lecejeff/RPI_CMx_Carrier/README.md

## SPONSOR
[NextPCB](https://www.nextpcb.com)

This project is proudly sponsored by [NextPCB](https://www.nextpcb.com). They have provided, free of charge, 2x assembled PCBA.

If you’re planning to build your own PCB, [NextPCB](https://www.nextpcb.com) offers reliable PCB fabrication and assembly services with fast turnaround times and competitive pricing, making it easier to bring your electronics projects from idea to reality.
