lecejeff/RPI_CMx_Carrier/hardware/DVT/RPI_CMx_Carrier_2.00-0A - DVT.odt

RPI_CM[x]_Carrier – Rev 2.00-0A – DVT report

BY

Jean-François Bilodeau

203-1690 rue des Quatre-saisons, Sherbrooke, CANADA, J1E 0N2

jeanfrancois.bilodeau@hotmail.fr

418-999-8845

APPLICABLE TO

RPI_CM[x]_Carrier – Rev 2.00-0A

Project release date: 2026-03

Setup date for qualification report: 9th of March 2026

Report release date: WIP

Table of Figures

Figure 1: 1V8_CB schematic implementation 4

Figure 2: 1V8_CB - Vout 6

Figure 3: 1V8_CB - Ripple 6

Figure 4: 1V8_CB - Soft start (10-90% output voltage) 6

Figure 5: 1V8_CB - Operating frequency 6

Figure 6: 1V8_CB EN input voltage threshold 8

Figure 7: 1V8_CB EN enable to output ramp-up delay 8

Figure 8: 3V3_CB schematic implementation 11

Figure 9: 3V3_CB - Vout 13

Figure 10: 3V3_CB - Ripple 13

Figure 11: 3V3_CB - Soft start (10-90% output voltage) 13

Figure 12: 3V3_CB - Operating frequency 13

Figure 13: 3V3_CB EN input voltage threshold 15

Figure 14: 3V3_CB EN enable to output ramp-up delay 15

Figure 15: 5V0_CB schematic implementation 18

Figure 16: 5V0_CB - Vout 19

Figure 17: 5V0_CB - Ripple 19

Figure 18: 5V0_CB - Soft start (10-90% output voltage) 20

Figure 19: 5V0_CB - Operating frequency 20

Figure 20: 5V0_CB EN input voltage threshold 22

Figure 21: 5V0_CB EN enable to output ramp-up delay 22

Figure 22: Power Supply sequencing schematic implementation 25

Figure 23: Reset sequence schematic implementation 25

Figure 24: Power-up sequence timing diagram 26

Figure 25: RPI Compute Module power-up requirements 27

Figure 26: 12V0_CB ↑ to 5V0_CB ↑ 29

Figure 27: 5V0_CB ↑ to RPI_PWGn ↓ 29

Figure 28: RPI_PWGn ↓ to CB_LOG_EN ↑ 29

Figure 29: CB_LOG_EN ↑ to 3V3_CB & 1V8_CB ↑ 29

Figure 30: 1V8_CB ↑ to 1V05_CB ↑ 29

Figure 31: 1V05_CB ↑ to PWG ↑ 29

Figure 32: CB_LOG_EN ↑ to EXT_RSTn ↑ 30

Figure 33: Power kill schematic implementation 33

# Power supplies

## 1V8_CB

### Buck qualification TPS54527DDAR

Figure 1: 1V8_CB schematic implementation

#### Reference

HW qualification | Reference | RPI_CM[x]_Carrier design notes
| Applicable for | RPI_CM[x]_Carrier Rev 2.00-0A
Description | | Detailed qualification of TPS54527 buck regulator for 1V8_CB rail
Test type | | Internal | External | Site : Sherbrooke
Test status | | DONE
Final test result | | PASS

General Info
Date begin Date end | 2026-03-09 2026-04-19 | Temperature Humidity | 25°C 50%RH
Realized by | Jean-François Bilodeau, P. Eng #6022173

#### System Information

Hardware | Serial Number | # Version | Mod (#WI) | Comments
Carrier Board | RPI_CM[x]_01 CM4 build variant | 0A | | All applicable work items applied prior to test
SOM | CM4 4GB RAM 8GB eMMC WIFI
Accessory #1 | RVT70HSLFWCA0
Accessory #2 | None

#### Assumptions

Based on design notes for a typical use-case:

- Typical Vout ~= 1.8V ±5%
- Typical Iout <= 0.8A
- Typical ripple ~= 20mVpp
- Typical soft start ~= 1.4025ms ±15%
- Typical transient response ~= 300us ± 20%
- Typical switching frequency ~= 712.5kHz

#### Measurement point

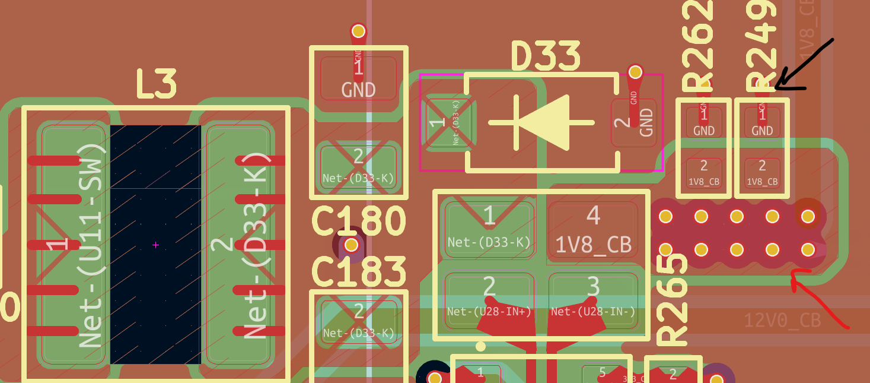
[picture p1: figure]

Measurement location for 1V8_CB Vout / Transient response qualification | Measurement location for 1V8_CB ripple qualification

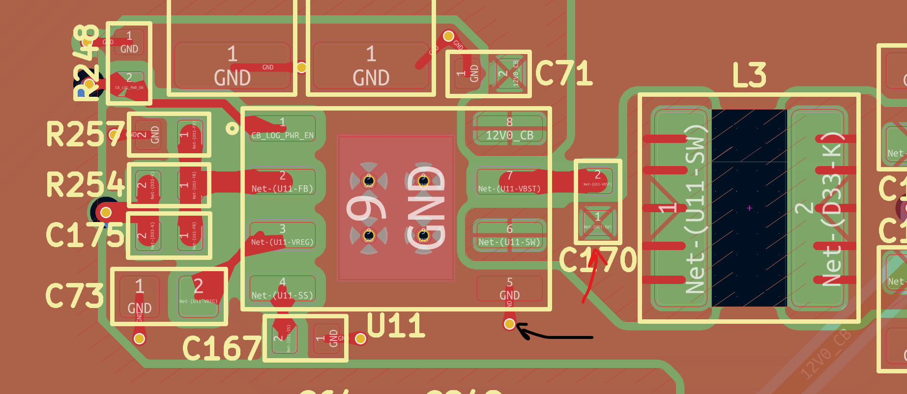
[picture p2: figure]

Measurement location for 1V8_CB soft start qualification | Measurement location for 1V8_CB FSW qualification

#### Test

1V8_CB Buck qualification | Test parameters
| Target | Measurement | Result | Comments
Vout | 1.71V <= 1.8V <= 1.89V | Min 1.767V Nominal 1.802V Max 1.833V | PASS
Ripple | <= 20mVpp | 21mVpp | PASS | Test realized with BW <= 20MHz
Soft start | 1.192 <= 1.4025 <= 1.612ms | 1.321ms | PASS
Operating frequency | ~ 712.5kHz | ~717.96kHz | PASS | Test realized with BW <= 20MHz
Temperature increase vs ambient | <= 35DegC | TO DO | TO DO

1V8_CB buck qualification

#### Figures

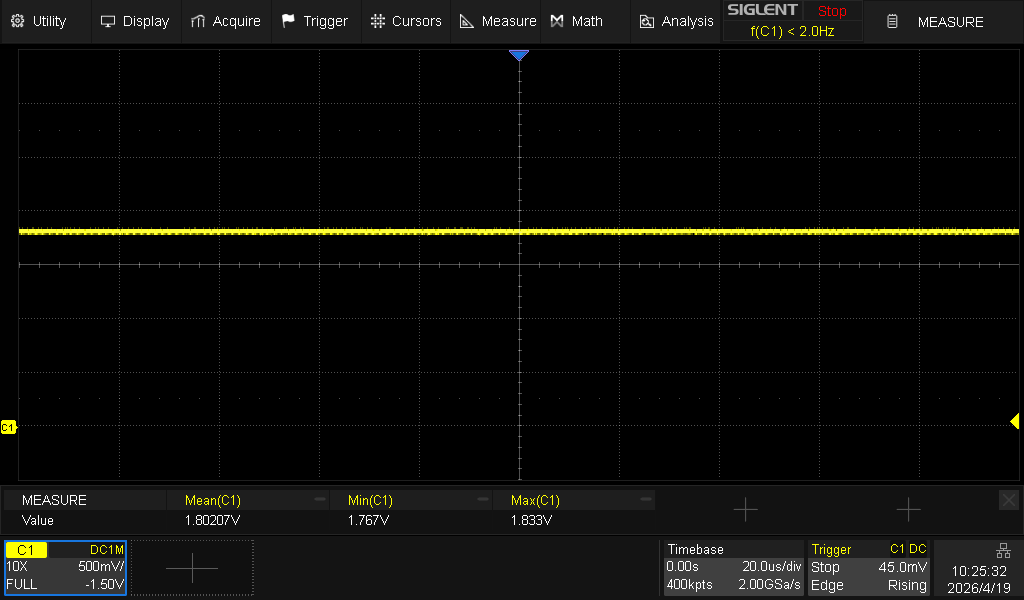
[picture p3: figure]
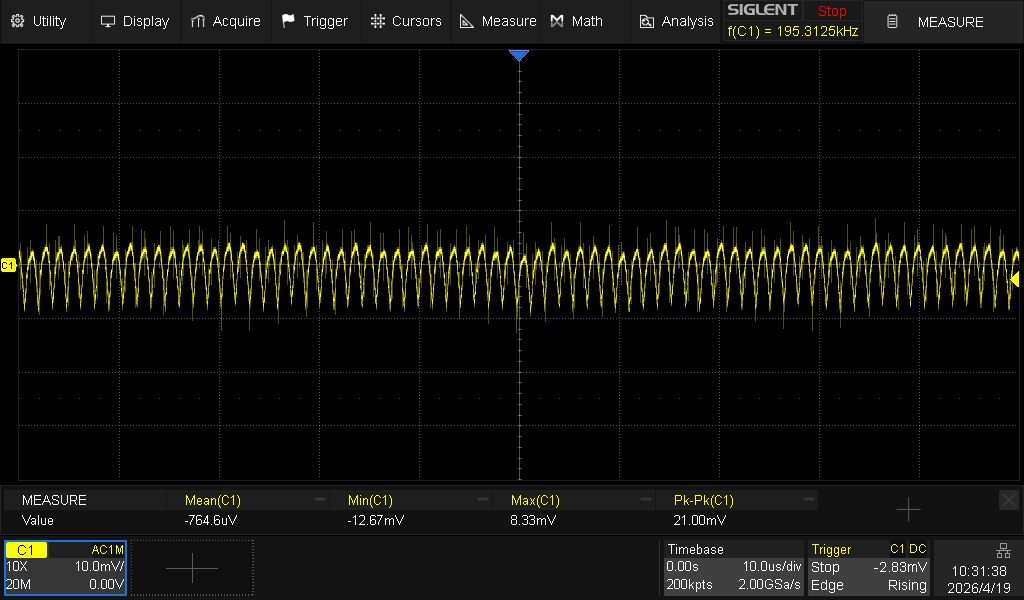
[picture p4: figure]

Figure 2: 1V8_CB - Vout | Figure 3: 1V8_CB - Ripple

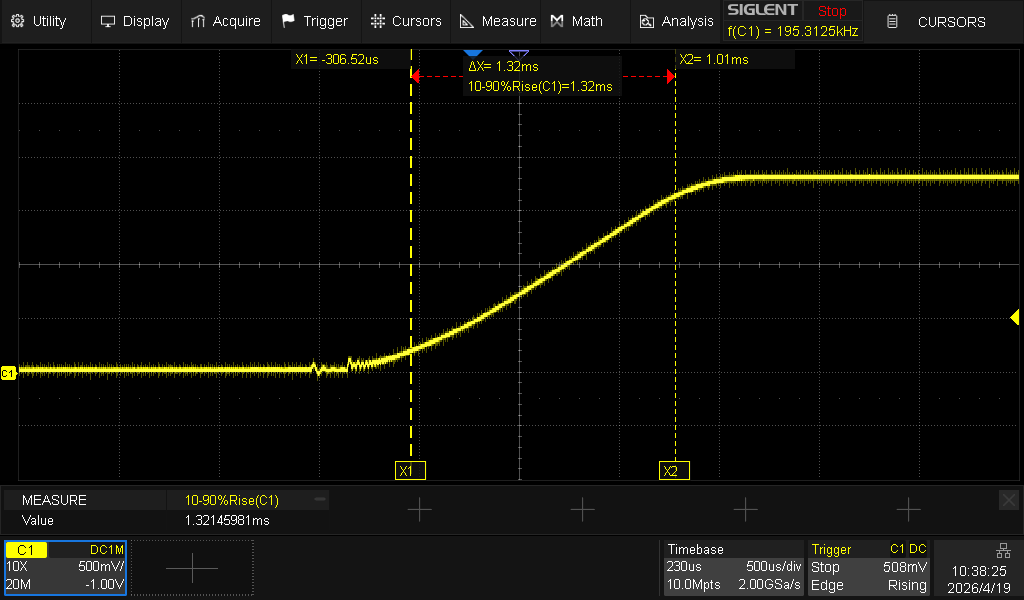
[picture p5: figure]
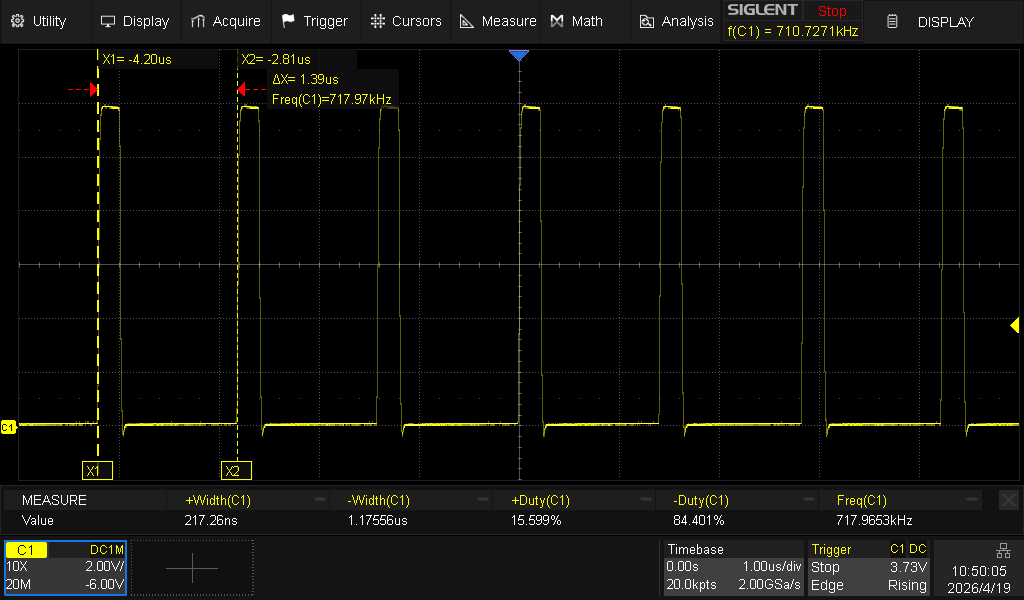
[picture p6: figure]

Figure 4: 1V8_CB - Soft start (10-90% output voltage) | Figure 5: 1V8_CB - Operating frequency
1V8_CB – Temperature increase

#### Conclusion

### Brown-out

#### Reference

HW qualification | Reference | RPI_CM[x]_Carrier design notes
| Applicable for | RPI_CM[x]_Carrier Rev 2.00-0A
Description | | Detailed qualification of TPS54527 brown-out behavior for 1V8_CB rail
Test type | | Internal | External | Site : Sherbrooke
Test status | | In progress
Final test result | | In progress

General Info
Date | 2026-06-14 | Temperature Humidity | 25°C 50%RH
Realized by | Jean-François Bilodeau, P. Eng #6022173

#### System Information

Hardware | Serial Number | # Version | Mod (#WI) | Comments
Carrier Board | RPI_CM[x]_01 CM4 build variant | 0A | | All applicable work items applied prior to test
SOM | CM4 4GB RAM 8GB eMMC WIFI
Accessory #1 | RVT70HSLFWCA0
Accessory #2 | None

#### Assumptions

Must measure minimum input voltage, output voltage ramp-up (Soft start) and inrush current

#### Measurement point

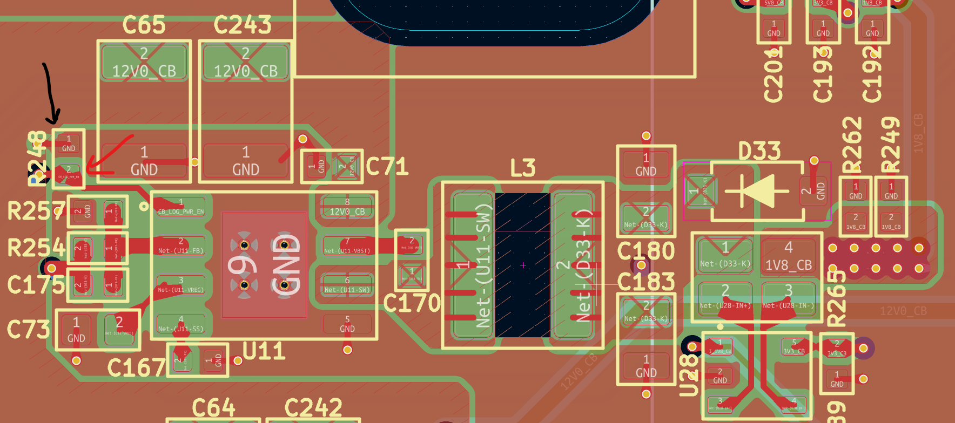
[picture p7: figure]
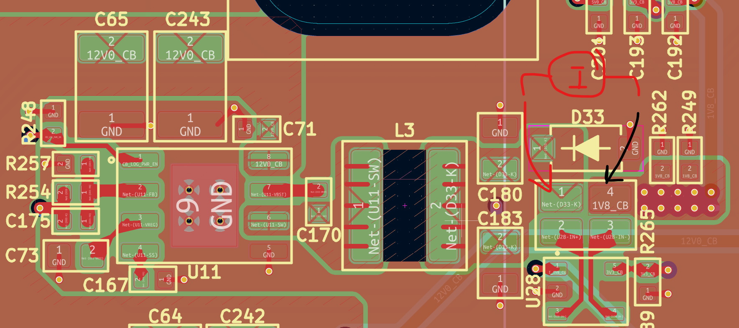
[picture p8: figure]

Measurement location for 1V8_CB EN input validation | Measurement location for 1V8_CB inrush current

#### Test

1V8_CB Brown-out behavior | Test parameters
| Target | Measurement | Result | Comments
EN input voltage “on” threshold | >= 1.6V | 1.77V | PASS
EN input to output ramp-up delay | < 1ms | 0.27ms | PASS
Inrush current | INFO

1V8_CB brown-out behavior

#### Figures

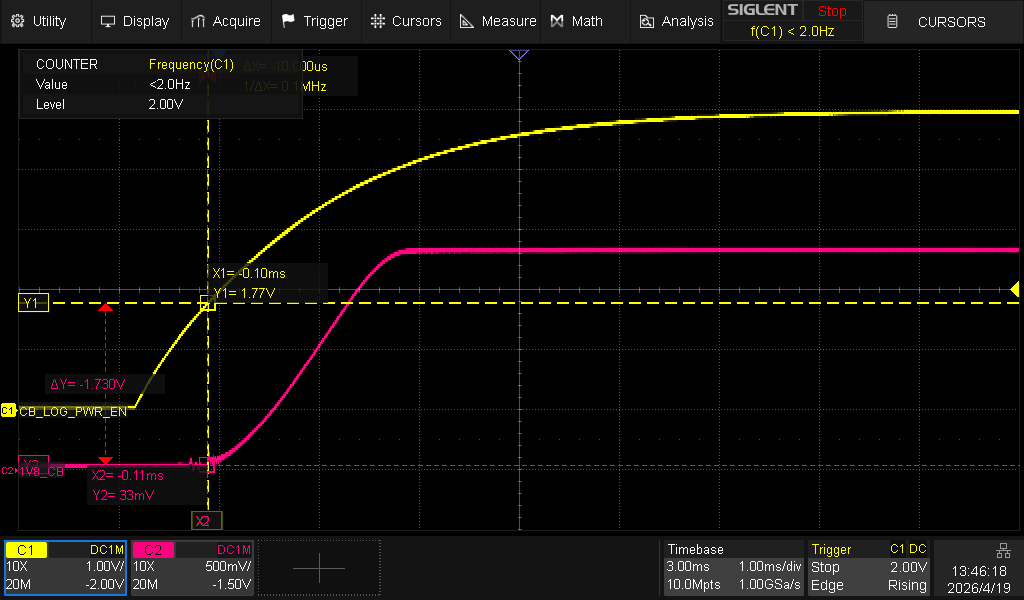
[picture p9: figure]
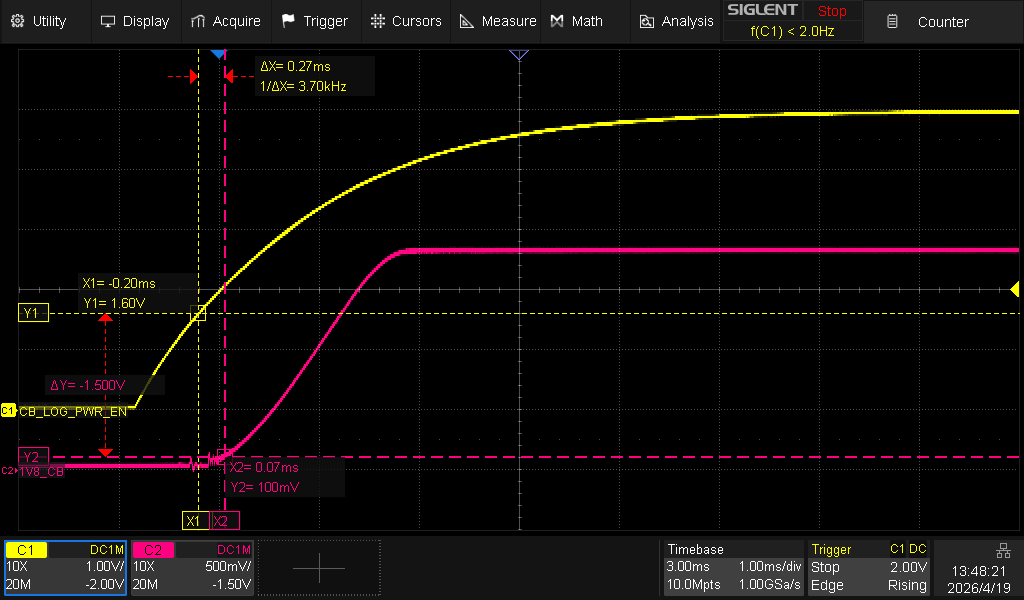
[picture p10: figure]

Figure 6: 1V8_CB EN input voltage threshold | Figure 7: 1V8_CB EN enable to output ramp-up delay
1V8_CB Inrush current

#### Conclusion

### Brown-in

#### Reference

HW qualification | Reference | RPI_CM[x]_Carrier design notes
| Applicable for | RPI_CM[x]_Carrier Rev 2.00-0A
Description | | Detailed qualification of TPS54527 brown-in behavior for 1V8_CB rail
Test type | | Internal | External | Site : Sherbrooke
Test status | | To Do
Final test result | | To Do

General Info
Date | 2026-03-09 | Temperature Humidity | 25°C 50%RH
Realized by | Jean-François Bilodeau, P. Eng #6022173

#### System Information

Hardware | Serial Number | # Version | Mod (#WI) | Comments
Carrier Board | RPI_CM[x]_01 CM4 build variant | 0A | | All applicable work items applied prior to test
SOM | CM4 4GB RAM 8GB eMMC WIFI
Accessory #1 | RVT70HSLFWCA0
Accessory #2 | None

#### Assumption

Must measure input voltage ramp-down, output voltage ramp-down and power good assert

#### Measurement point

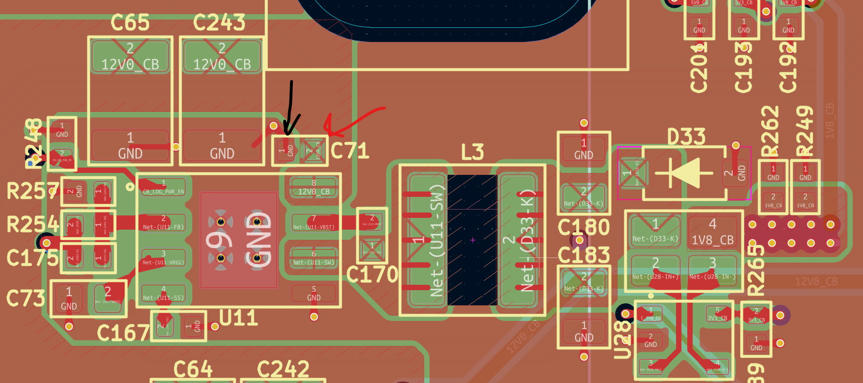
[picture p11: figure]
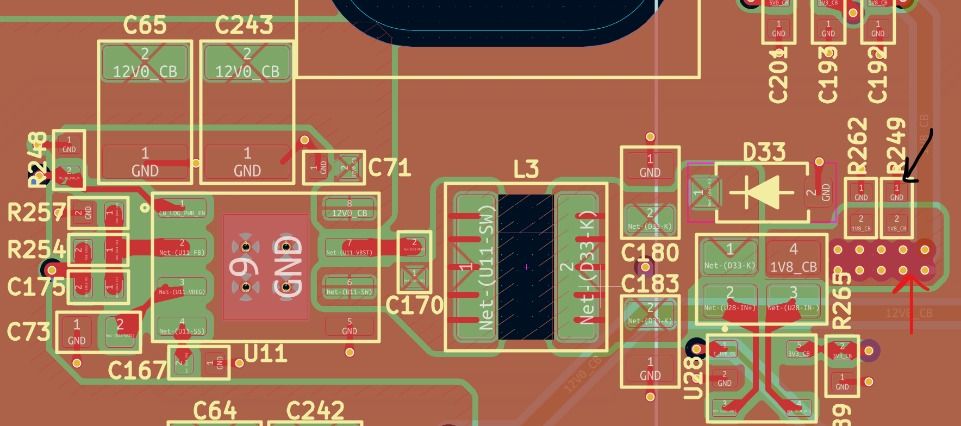
[picture p12: figure]

Measurement location for input voltage ramp-down | Measurement location for output voltage ramp-down

#### Test

1V8_CB Brown-in behavior | Test parameters
| Target | Measurement | Result | Comments
Input voltage brown-in | < 4.5V
Output voltage brown-in discharge | < 10ms

1V8_CB brown-in behavior

#### Figures

1V8_CB Input voltage brown-in threshold | 1V8_CB Output voltage brown-in discharge (100-10%)

#### Conclusion

## 3V3_CB

### Buck qualification TPS54527DDAR

Figure 8: 3V3_CB schematic implementation

#### Reference

HW qualification | Reference | RPI_CM[x]_Carrier design notes
| Applicable for | RPI_CM[x]_Carrier Rev 2.00-0A
Description | | Detailed qualification of TPS54527 buck regulator for 3V3_CB rail
Test type | | Internal | External | Site : Sherbrooke
Test status | | DONE
Final test result | | PASS

General Info
Date | 2026-06-14 | Temperature Humidity | 25°C 50%RH
Realized by | Jean-François Bilodeau, P. Eng #6022173

#### System Information

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

#### Assumptions

Based on design notes for a typical use-case:

- Typical Vout ~= 3.3V ±5%
- Typical Iout <= 3.3A
- Typical ripple ~= 20mVpp
- Typical soft start ~= 1.4025ms ±15%
- Typical switching frequency ~= 740kHz

#### Measurement point

Measurement location for 3V3_CB Vout / Transient response qualification | Measurement location for 3V3_CB ripple qualification

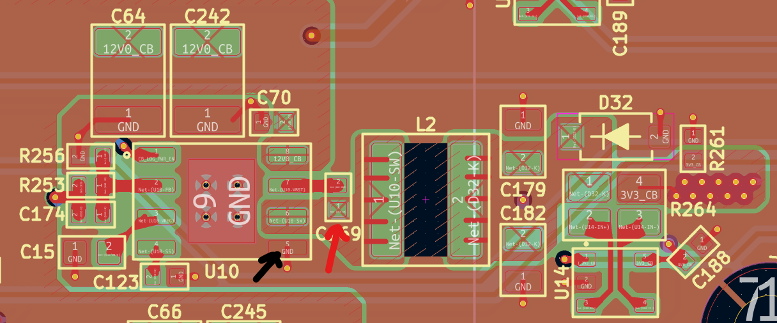
[picture p13: figure]

Measurement location for 3V3_CB soft start qualification | Measurement location for 3V3_CB FSW qualification

#### Test

3V3_CB Buck qualification | Test parameters
| Target | Measurement | Result | Comments
Vout | 3.135V <= 3.3V <= 3.465V | Min 3.250V Nominal 3.290V Max 3.317V | PASS
Ripple | <= 20mVpp | 26.67mVpp | PASS
Soft start | 1.192ms <= 1.4025ms <= 1.612ms | 1.252ms | PASS
Operating frequency | ~ 740kHz | 721.2kHz | PASS
Temperature increase vs ambient | <= 35DegC | TO DO | TO DO

3V3_CB buck qualification

#### Figures

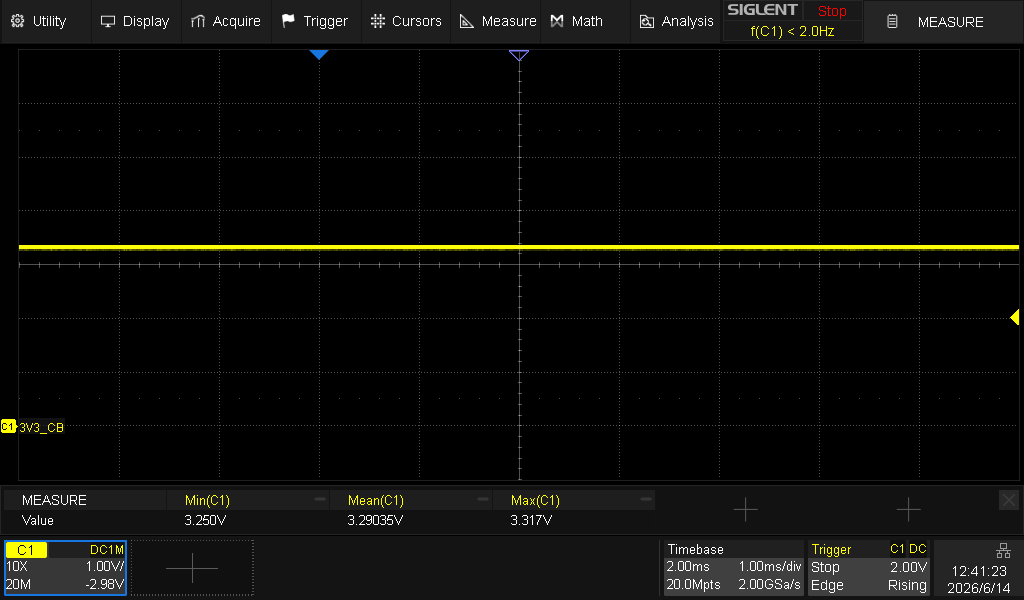
[picture p14: figure]
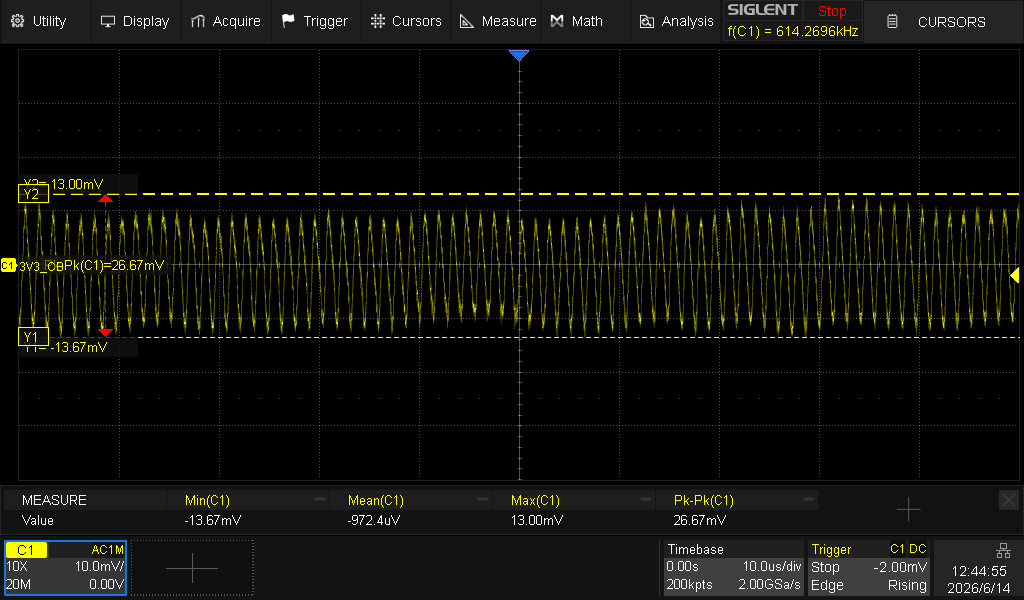
[picture p15: figure]

Figure 9: 3V3_CB - Vout | Figure 10: 3V3_CB - Ripple

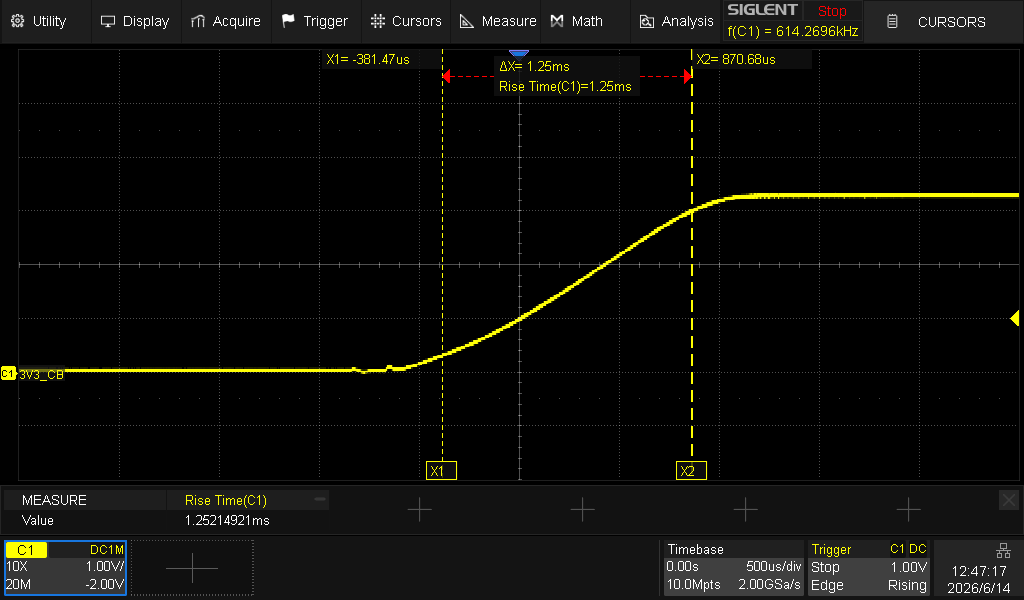
[picture p16: figure]
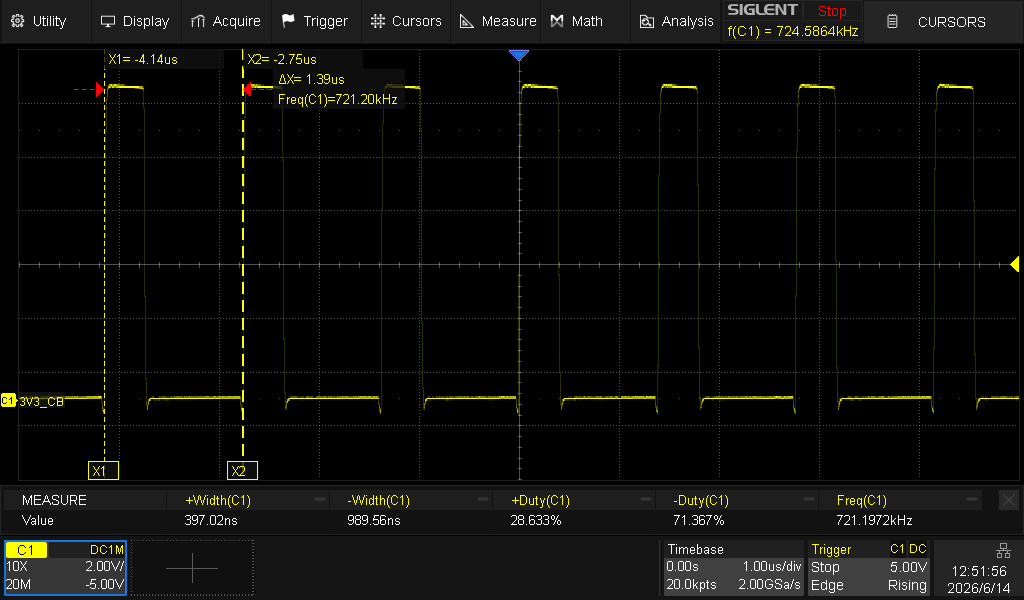
[picture p17: figure]

Figure 11: 3V3_CB - Soft start (10-90% output voltage) | Figure 12: 3V3_CB - Operating frequency
3V3_CB – Temperature increase

#### Conclusion

### Brown-out

#### Reference

HW qualification | Reference | RPI_CM[x]_Carrier design notes
| Applicable for | RPI_CM[x]_Carrier Rev 2.00-0A
Description | | Detailed qualification of TPS54527 brown-out behavior for 3V3_CB rail
Test type | | Internal | External | Site : Sherbrooke
Test status | | To Do
Final test result | | To Do

General Info
Date | 2026-06-14 | Temperature Humidity | 25°C 50%RH
Realized by | Jean-François Bilodeau, P. Eng #6022173

#### System Information

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

#### Assumptions

Must measure minimum input voltage, output voltage ramp-up (Soft start) and inrush current

#### Measurement point

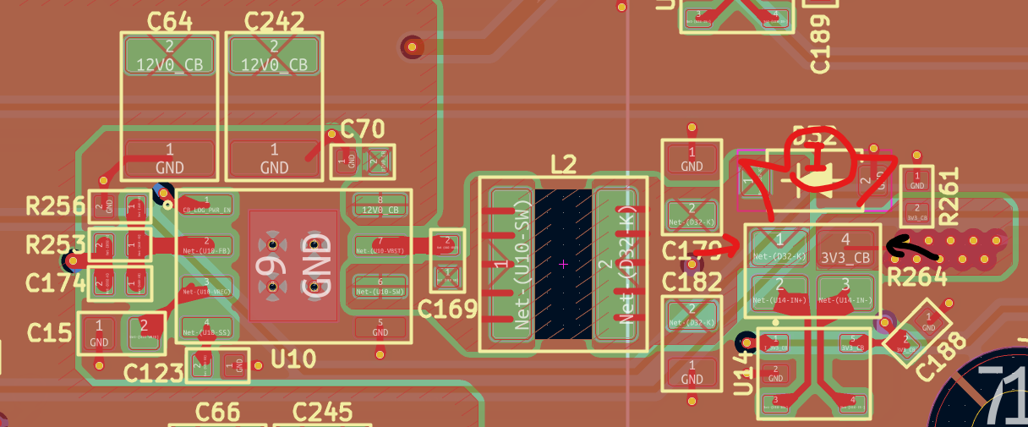
[picture p18: figure]

Measurement location for 3V3_CB EN input voltage threshold | Measurement location for 3V3_CB inrush current

#### Test

3V3_CB Brown-out behavior | Test parameters
| Target | Measurement | Result | Comments
EN input voltage “on” threshold | >= 1.6V | 1.830V | PASS
EN input to output ramp-up delay | < 1ms | 0.13ms | PASS
Inrush current | INFO

3V3_CB brown-out behavior

#### Figures

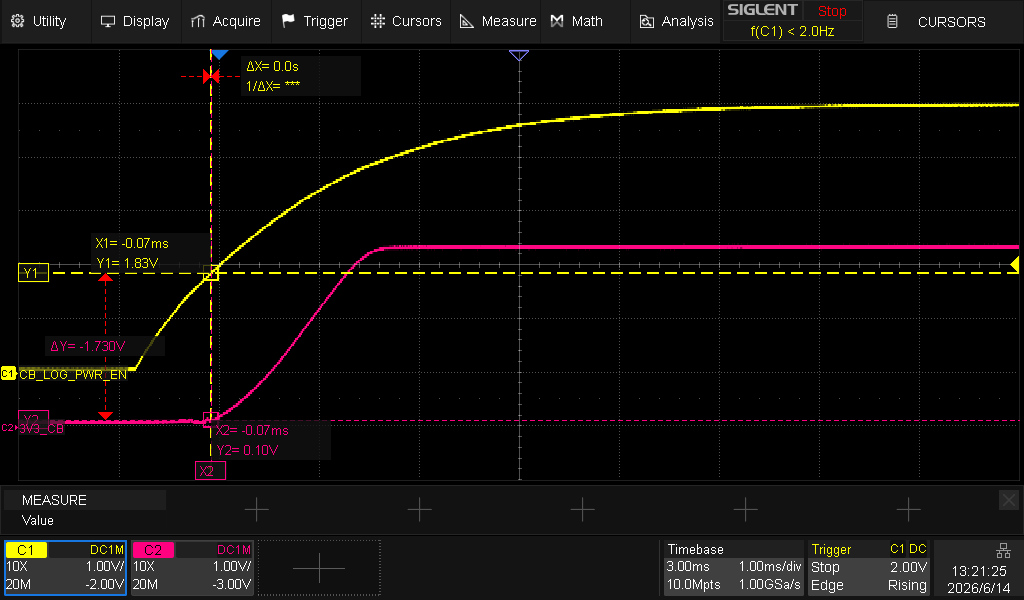
[picture p19: figure]
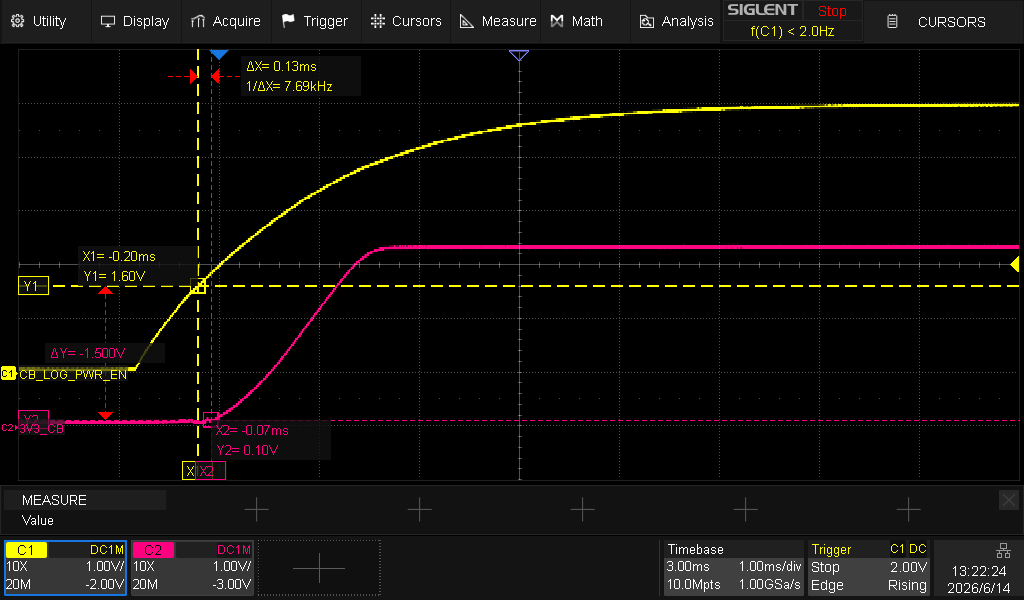
[picture p20: figure]

Figure 13: 3V3_CB EN input voltage threshold | Figure 14: 3V3_CB EN enable to output ramp-up delay
3V3_CB Inrush current

#### Conclusion

### Brown-in

#### Reference

HW qualification | Reference | RPI_CM[x]_Carrier design notes
| Applicable for | RPI_CM[x]_Carrier Rev 2.00-0A
Description | | Detailed qualification of TPS54527 brown-in behavior for 3V3_CB rail
Test type | | Internal | External | Site : Sherbrooke
Test status | | To Do
Final test result | | To Do

General Info
Date | 2026-03-09 | Temperature Humidity | 25°C 50%RH
Realized by | Jean-François Bilodeau, P. Eng #6022173

#### System Information

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

#### Assumption

Must measure input voltage ramp-down, output voltage ramp-down and power good assert

#### Measurement point

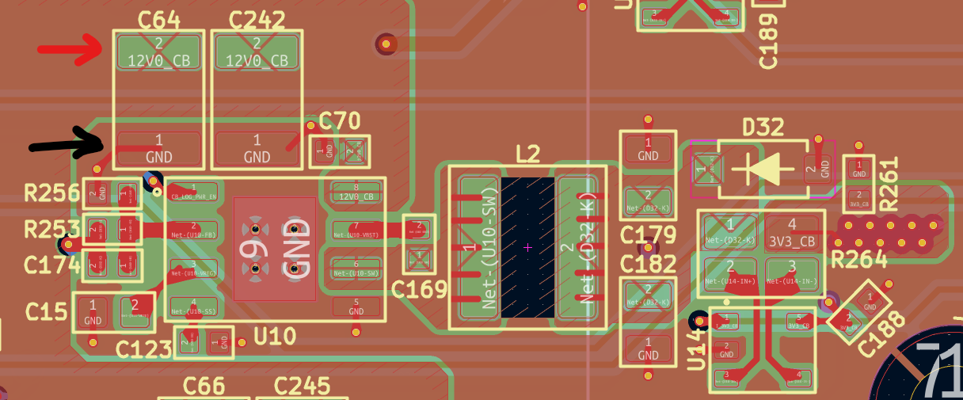
[picture p21: figure]

Measurement location for 3V3_CB input voltage ramp-down | Measurement location for 3V3_CB output voltage ramp-down

#### Test

3V3_CB Brown-in behavior | Test parameters
| Target | Measurement | Result | Comments
Input voltage brown-in | < 4.5V
Output voltage brown-in discharge | < 10ms

3V3_CB brown-in behavior

#### Figures

3V3_CB Input voltage brown-in threshold | 3V3_CB Output voltage brown-in discharge (100-10%)

#### Conclusion

## 5V0_CB

### Buck qualification TPS54527DDAR

Figure 15: 5V0_CB schematic implementation

#### Reference

HW qualification | Reference | RPI_CM[x]_Carrier design notes
| Applicable for | RPI_CM[x]_Carrier Rev 2.00-0A
Description | | Detailed qualification of TPS54527 buck regulator for 5V0_CB rail
Test type | | Internal | External | Site : Sherbrooke
Test status | | DONE
Final test result | | PASS

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

#### System Information

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

#### Assumptions

Based on design notes for a typical use-case:

- Typical Vout ~= 5.0V ±5%
- Typical Iout <= 3.0A
- Typical ripple ~= 20mVpp
- Typical soft start ~= 1.4025ms ±15%
- Typical switching frequency ~= 740kHz

#### Measurement point

Measurement location for 5V0_CB Vout / Transient response qualification | Measurement location for 5V0_CB ripple qualification
Measurement location for 5V0_CB soft start qualification | Measurement location for 5V0_CB FSW qualification

#### Test

5V0_CB Buck qualification | Test parameters
| Target | Measurement | Result | Comments
Vout | 4.75V <= 5.0V <= 5.25V | Min 4.967V Nominal 5.031V Max 5.100V | PASS
Ripple | <= 30mVpp | 29.67mVpp | PASS
Soft start | 1.192ms <= 1.4025ms <= 1.612ms | 1.28ms | PASS
Operating frequency | ~ 740kHz | 727.2kHz | PASS
Temperature increase vs ambient | <= 35DegC

5V0_CB buck qualification

#### Figures

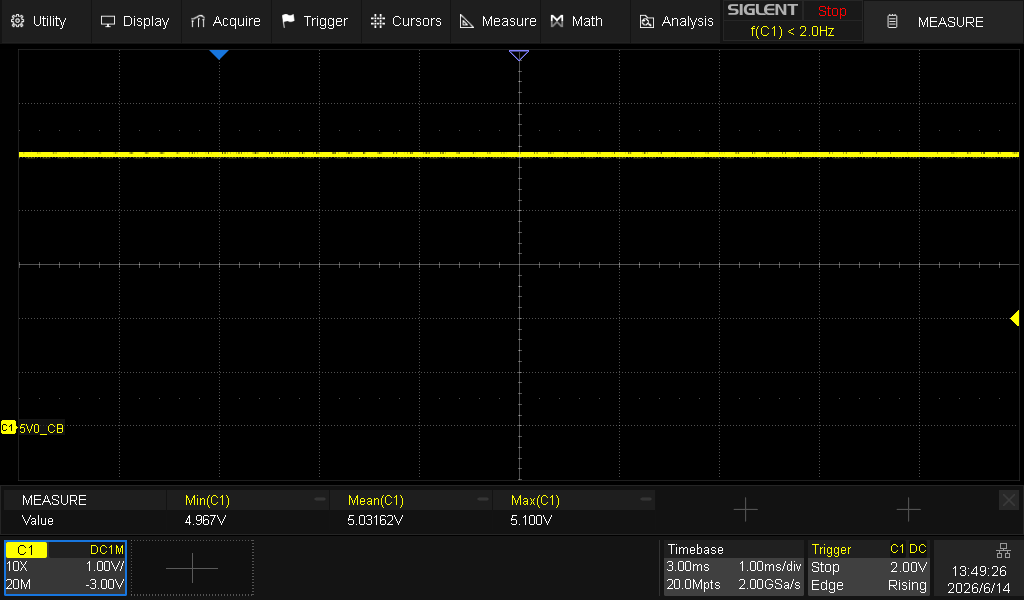
[picture p22: figure]
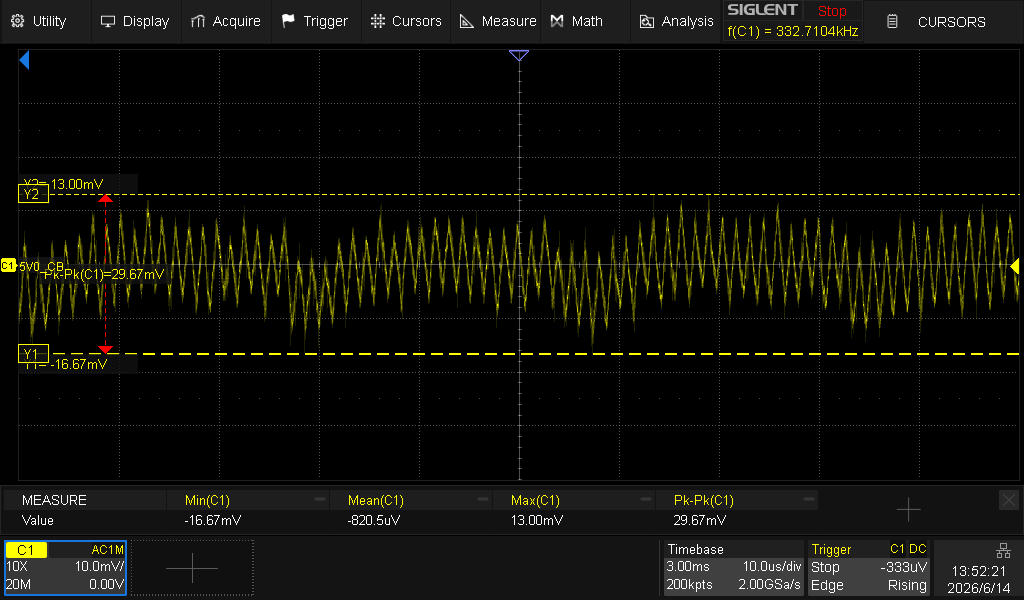
[picture p23: figure]

Figure 16: 5V0_CB - Vout | Figure 17: 5V0_CB - Ripple

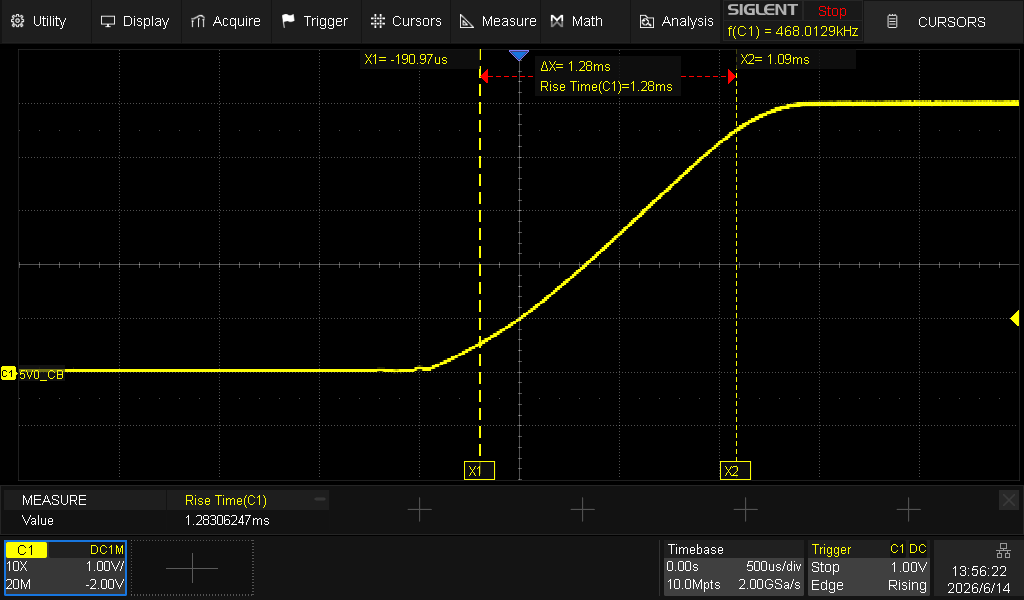
[picture p24: figure]
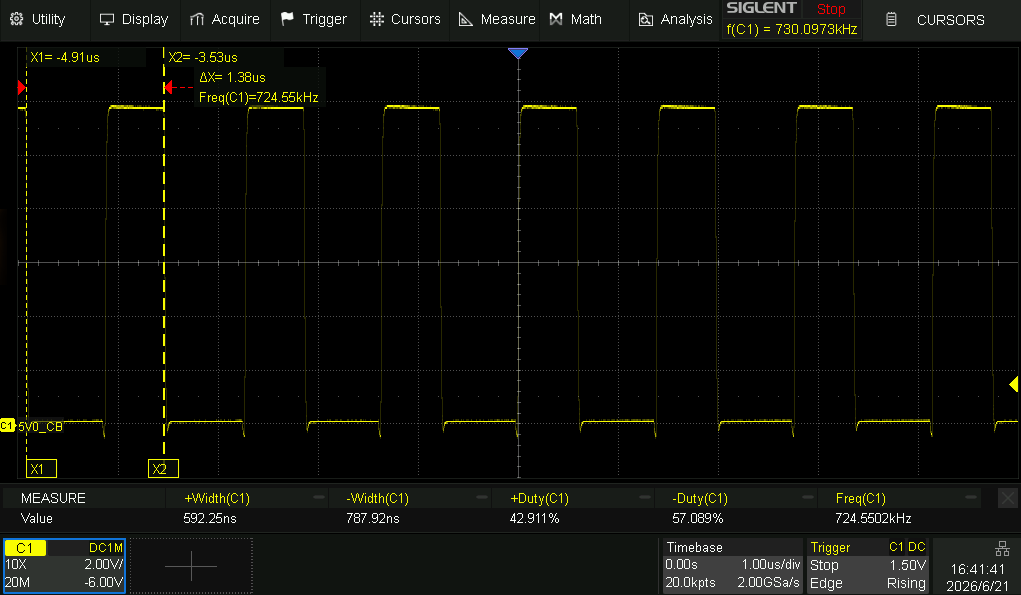
[picture p25: figure]

Figure 18: 5V0_CB - Soft start (10-90% output voltage) | Figure 19: 5V0_CB - Operating frequency
5V0_CB – Temperature increase

#### Conclusion

### Brown-out

#### Reference

HW qualification | Reference | RPI_CM[x]_Carrier design notes
| Applicable for | RPI_CM[x]_Carrier Rev 2.00-0A
Description | | Detailed qualification of TPS54527 brown-out behavior for 5V0_CB rail
Test type | | Internal | External | Site : Sherbrooke
Test status | | To Do
Final test result | | To Do

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

#### System Information

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

#### Assumptions

Must measure minimum input voltage, output voltage ramp-up (Soft start) and inrush current

#### Measurement point

Measurement location for 5V0_CB minimum input voltage | Measurement location for 5V0_CB soft-start validation
Measurement location for 5V0_CB EN input validation | Measurement location for 5V0_CB inrush current

#### Test

5V0_CB Brown-out behavior | Test parameters
| Target | Measurement | Result | Comments
EN input voltage “on” threshold | >= 1.6V | 11.13V | PASS
EN input to output ramp-up delay | < 1ms | 0.38ms | PASS
Inrush current | INFO

5V0_CB brown-out behavior

#### Figures

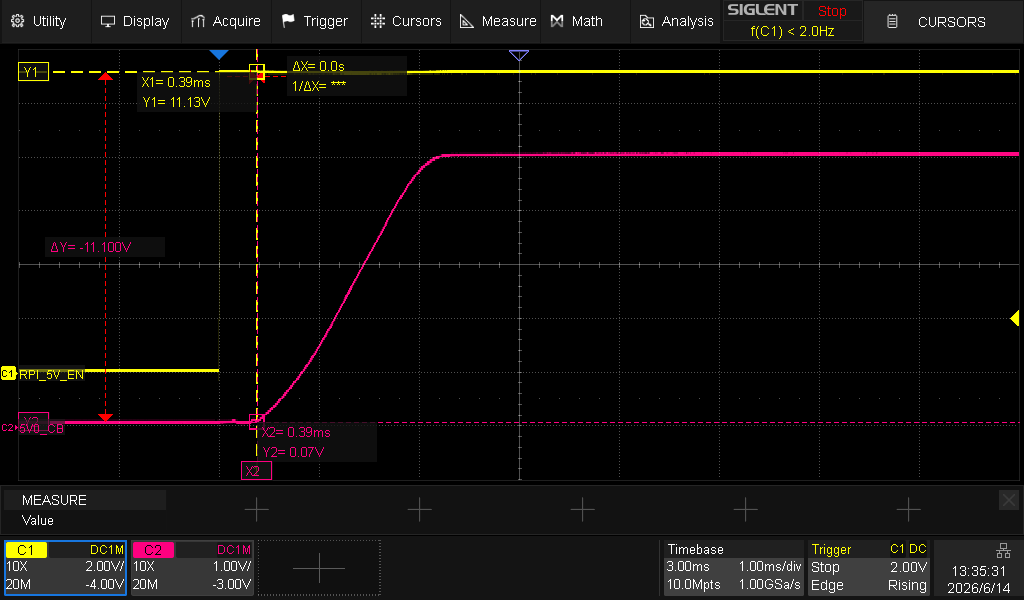
[picture p26: figure]
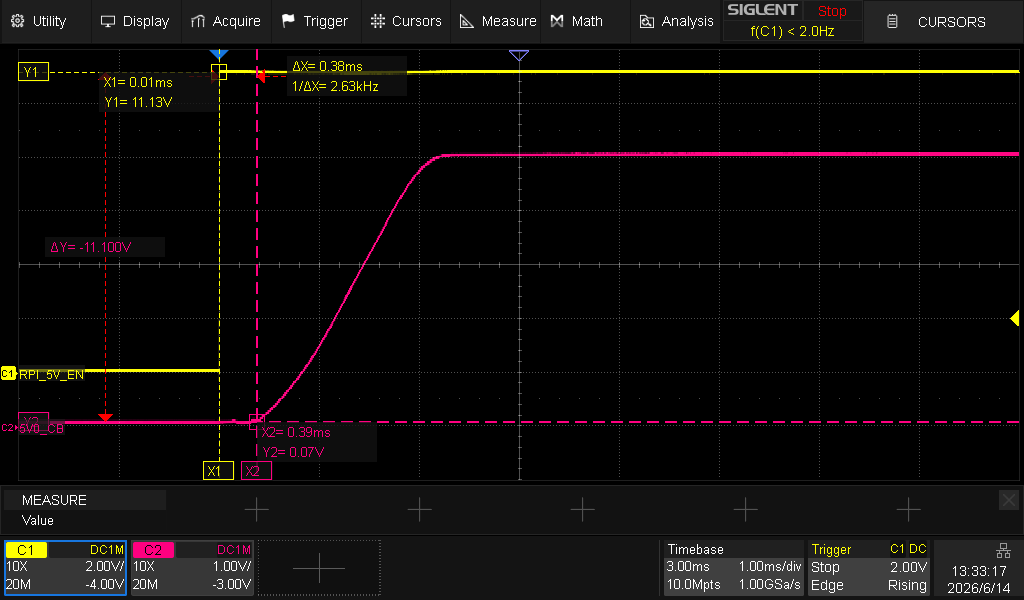
[picture p27: figure]

Figure 20: 5V0_CB EN input voltage threshold | Figure 21: 5V0_CB EN enable to output ramp-up delay
5V0_CB Inrush current

#### Conclusion

### Brown-in

#### Reference

HW qualification | Reference | RPI_CM[x]_Carrier design notes
| Applicable for | RPI_CM[x]_Carrier Rev 2.00-0A
Description | | Detailed qualification of TPS54527 brown-in behavior for 5V0_CB rail
Test type | | Internal | External | Site : Sherbrooke
Test status | | To Do
Final test result | | To Do

General Info
Date | 2026-03-09 | Temperature Humidity | 25°C 50%RH
Realized by | Jean-François Bilodeau, P. Eng #6022173

#### System Information

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

#### Assumption

Must measure input voltage ramp-down, output voltage ramp-down and power good assert

#### Measurement point

Measurement location for input voltage ramp-down | Measurement location for output voltage ramp-down

#### Test

5V0_CB Brown-in behavior | Test parameters
| Target | Measurement | Result | Comments
Input voltage brown-in | < 4.5V
Output voltage brown-in discharge | < 10ms

5V0_CB brown-in behavior

#### Figures

5V0_CB Input voltage brown-in threshold | 5V0_CB Output voltage brown-in discharge (100-10%)

#### Conclusion

# RESET

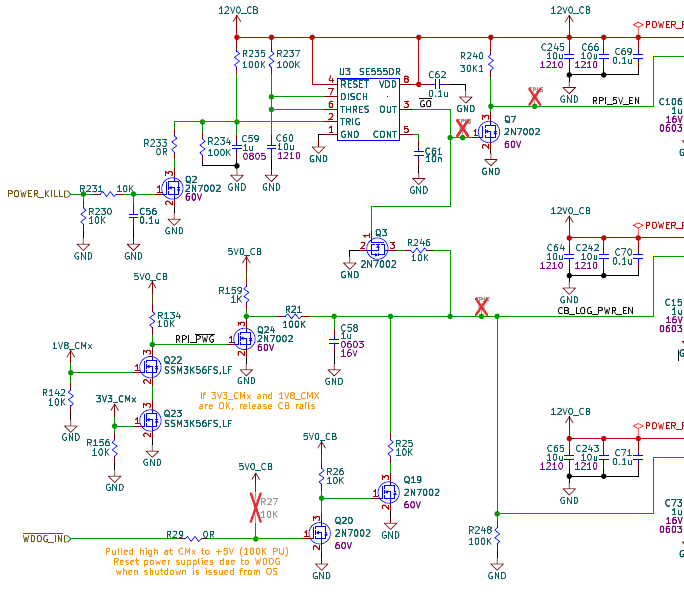
[picture p28: figure]

Figure 22: Power Supply sequencing schematic implementation

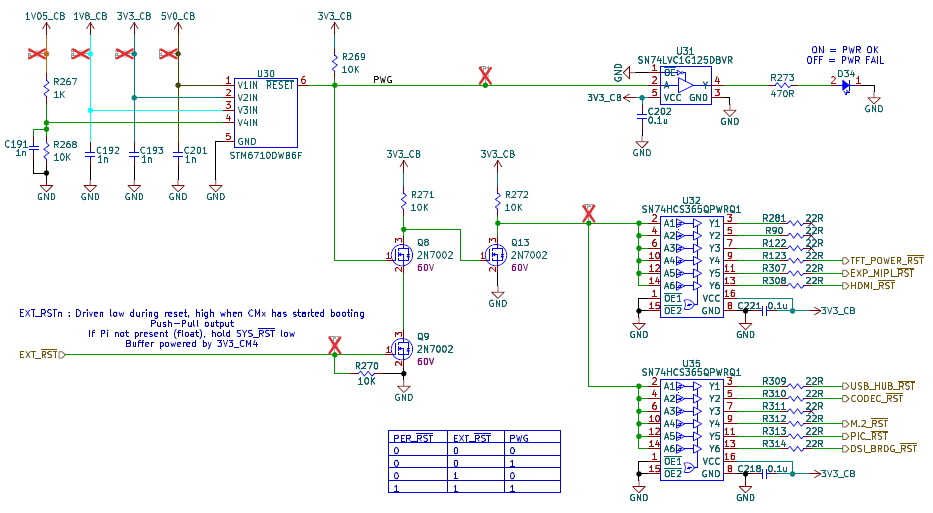
[picture p29: figure]

Figure 23: Reset sequence schematic implementation

## POWER-UP SEQUENCE

### Reference

HW qualification | Reference | RPI_CM[x]_Carrier design notes
| Applicable for | RPI_CM[x]_Carrier Rev 2.00-0A
Description | | Detailed qualification of Power-up reset sequence
Test type | | Internal | External | Site : Sherbrooke
Test status | | DONE
Final test result | | PASS

General Info
Date | 2026-06-21 | Temperature Humidity | 25°C 50%RH
Realized by | Jean-François Bilodeau, P. Eng #6022173

### System Information

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

### Assumption

The power-up sequence is designed to meet the timings shown below:

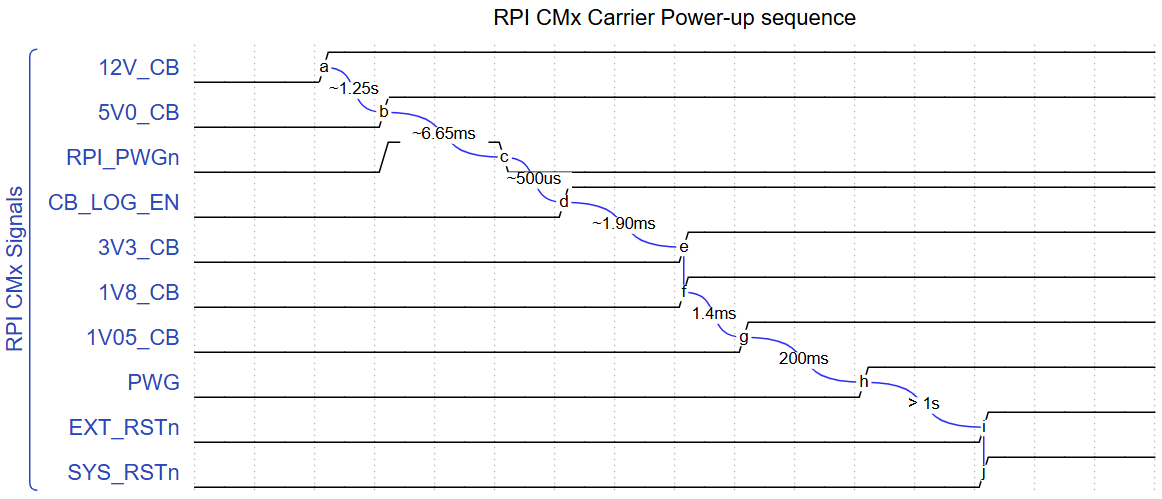
[picture p30: figure]

Figure 24: Power-up sequence timing diagram

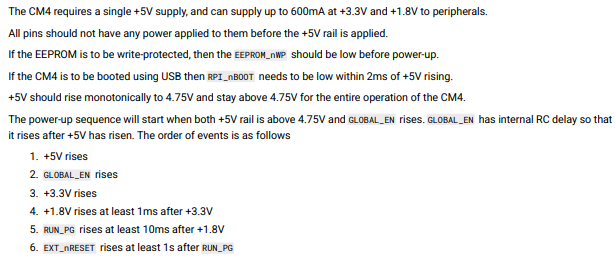
[picture p31: figure]

Figure 25: RPI Compute Module power-up requirements

### Measurement point

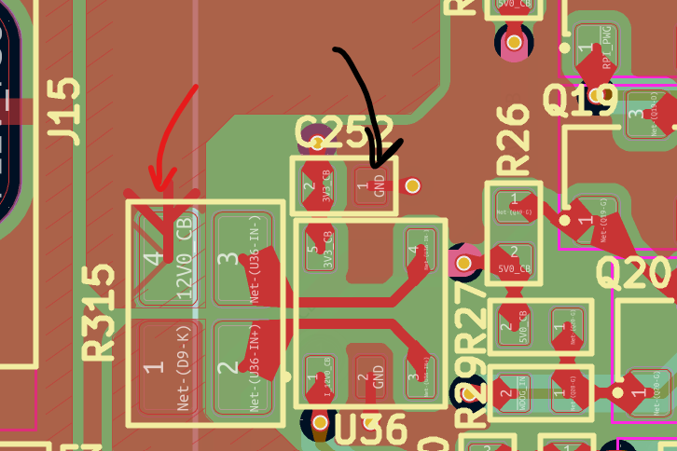
[picture p32: figure]
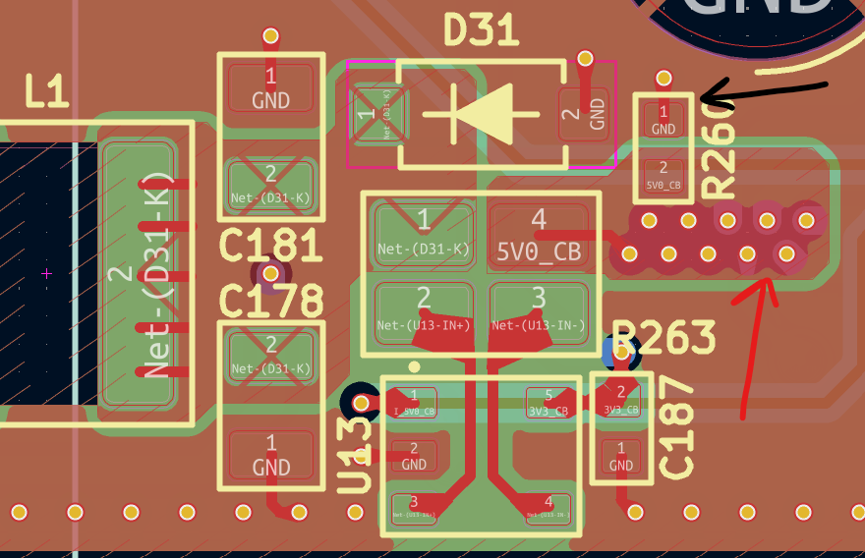
[picture p33: figure]

Measurement location for 12V0_CB | Measurement location for 5V0_CB

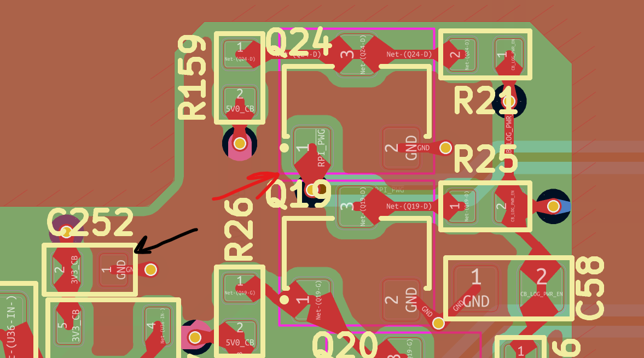
[picture p34: figure]
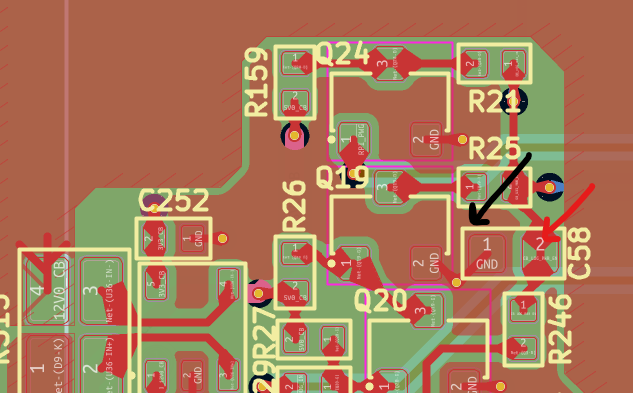
[picture p35: figure]

Measurement location for RPI_PWGn | Measurement location for CB_LOG_EN

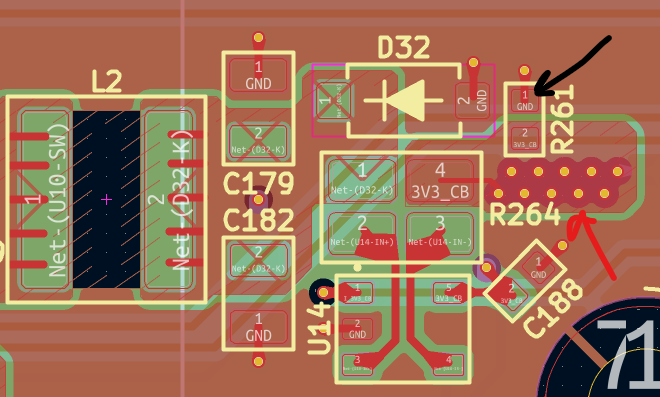
[picture p36: figure]
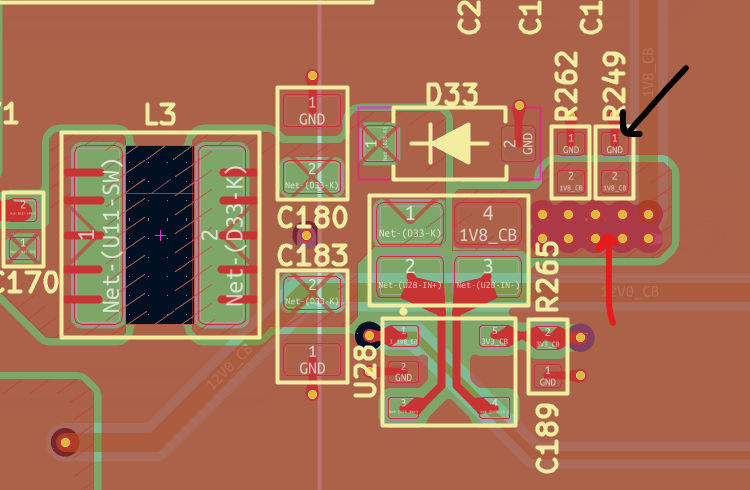
[picture p37: figure]

Measurement location for 3V3_CB | Measurement location for 1V8_CB

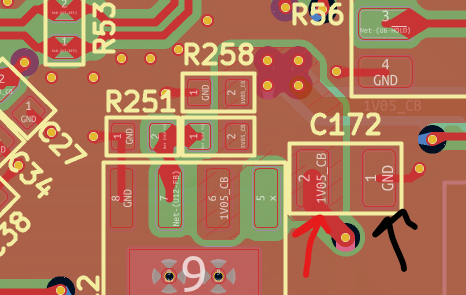
[picture p38: figure]
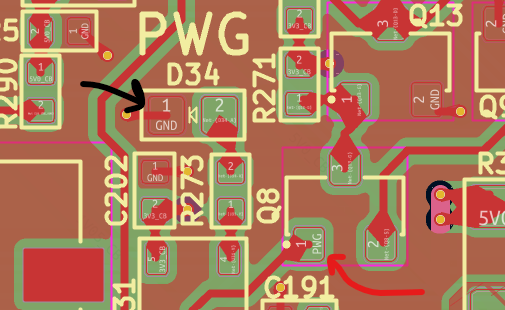
[picture p39: figure]

Measurement location for 1V05_CB | Measurement location for PWG

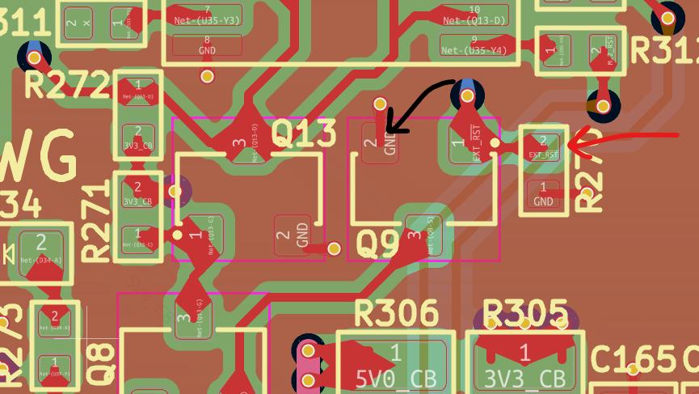
[picture p40: figure]
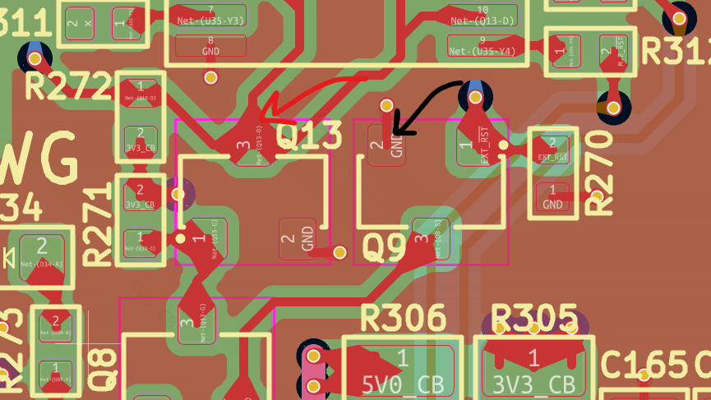
[picture p41: figure]

Measurement location for EXT_RSTn | Measurement location for SYS_RSTn

### Test

Power-on reset sequence | Test parameters
| Target | Measurement | Result | Comments
12V0_CB ↑ to 5V0_CB ↑ | 1.25sec ± 10% | 1.253s | PASS | 1.125s <= 1.25s <= 1.375s
5V0_CB ↑ to RPI_PWGn ↓ | 6.65ms ± 12% | 6.877ms | PASS | 5.852ms <= 6.65ms <= 7.448ms
RPI_PWGn ↑ to CB_LOG_EN ↑ | ~ 500us | 600us | PASS | Controlled by CM RC filter Using TPS54527 V(ih) threshold for CB_LOG_EN ↑ meas
CB_LOG_EN ↑ to 3V3_CB & 1V8_CB ↑ | 1.9ms ± 12% | 1.900ms | PASS | 1.672ms <= 1.9ms <= 2.128ms Using TPS54527 V(ih) threshold for CB_LOG_EN ↑ meas
1V8_CB ↑ to 1V05_CB ↑ | ~ 1.4ms | 800us | PASS | Using TPS7A7001 EN threshold to 90% of 1V05
1V05_CB ↑ to PWG ↑ | 200ms ± 30% | 215.8ms | PASS | 140ms <= 200ms <= 280ms
CB_LOG_EN ↑ to EXT_RSTn ↑ | > 1s | 1.781s | PASS | Controlled by compute module 1.05s <= 1.5s <= 1.95s

Power-on reset sequence

### Figures

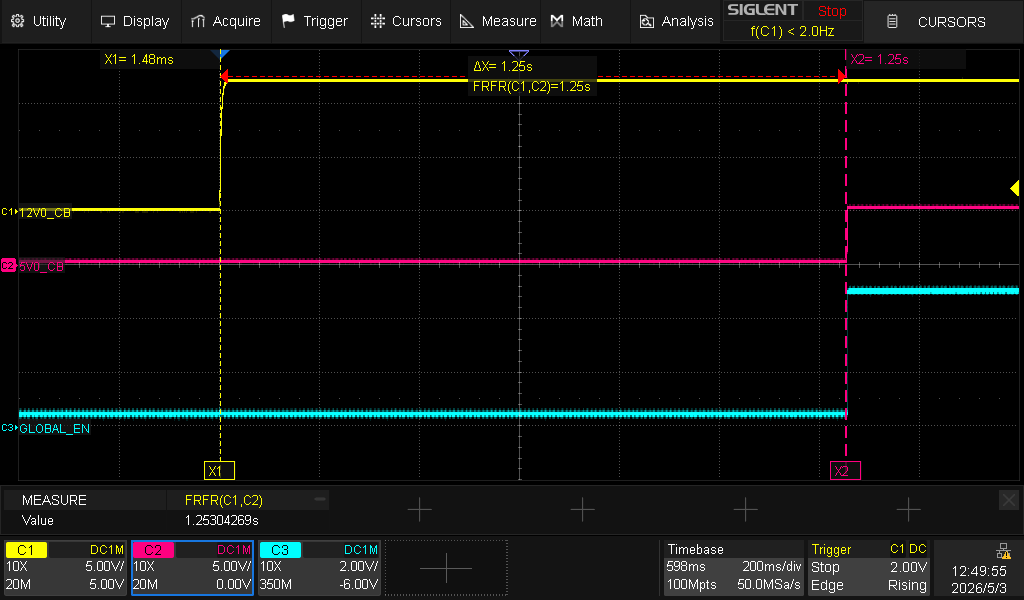
[picture p42: figure]
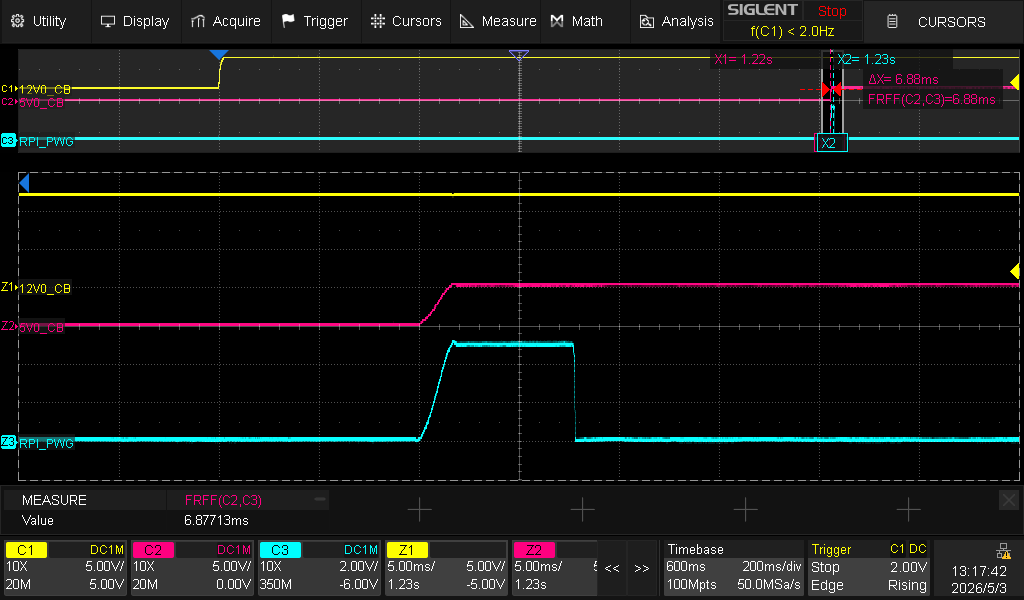
[picture p43: figure]

Figure 26: 12V0_CB ↑ to 5V0_CB ↑ | Figure 27: 5V0_CB ↑ to RPI_PWGn ↓

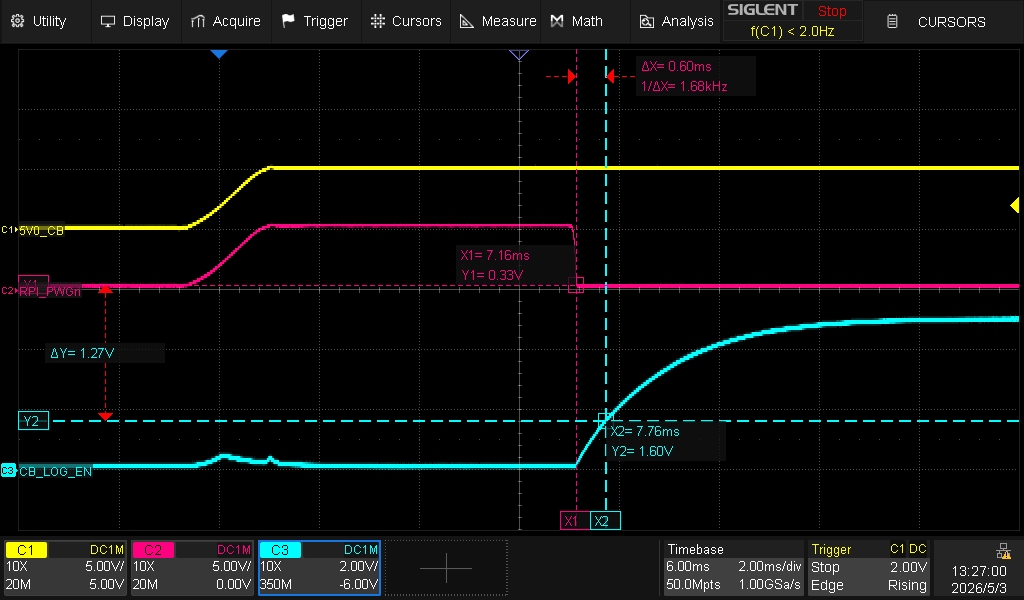
[picture p44: figure]
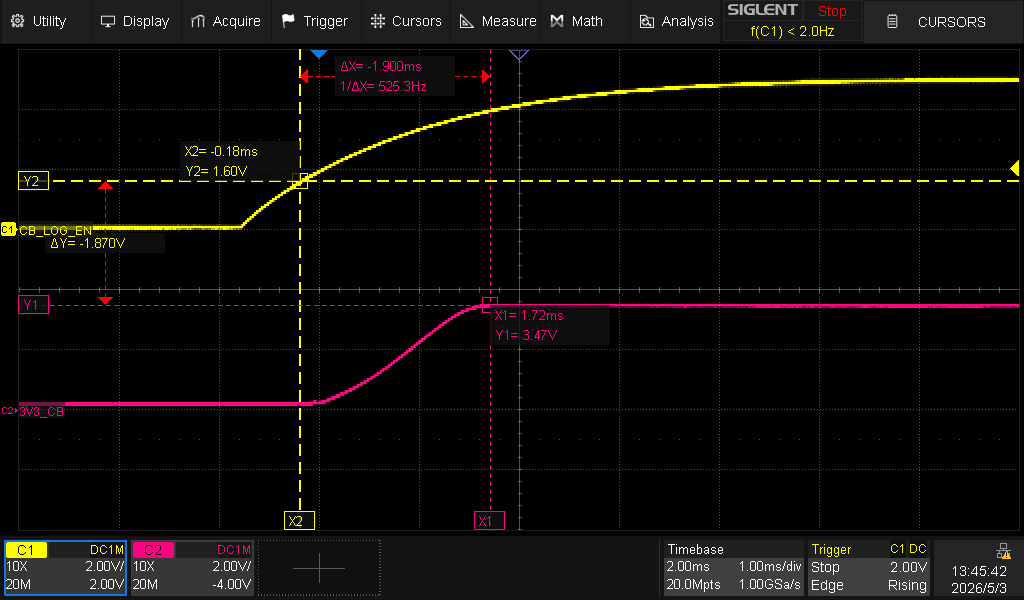
[picture p45: figure]

Figure 28: RPI_PWGn ↓ to CB_LOG_EN ↑ | Figure 29: CB_LOG_EN ↑ to 3V3_CB & 1V8_CB ↑

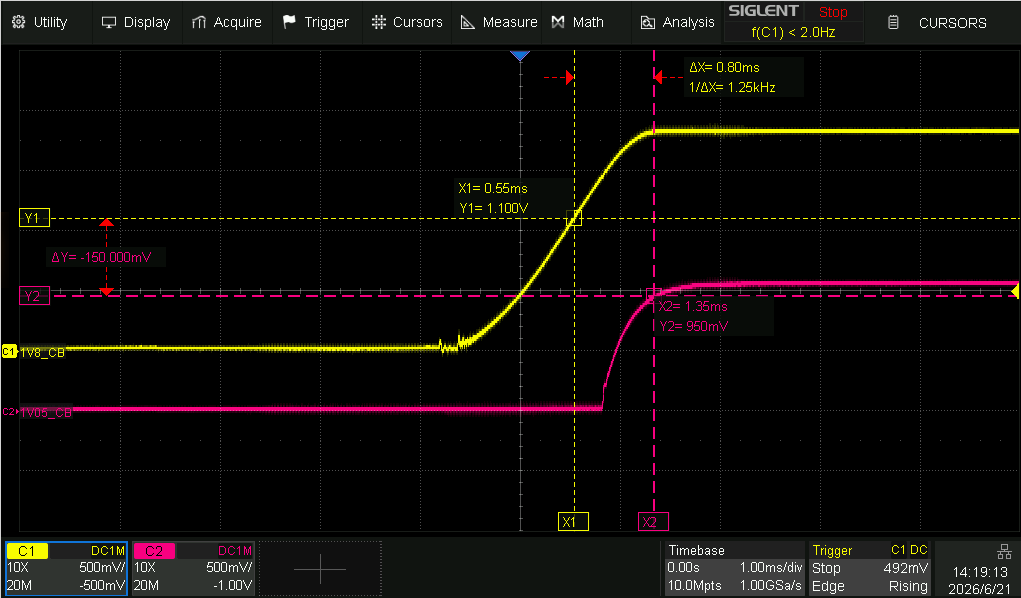
[picture p46: figure]
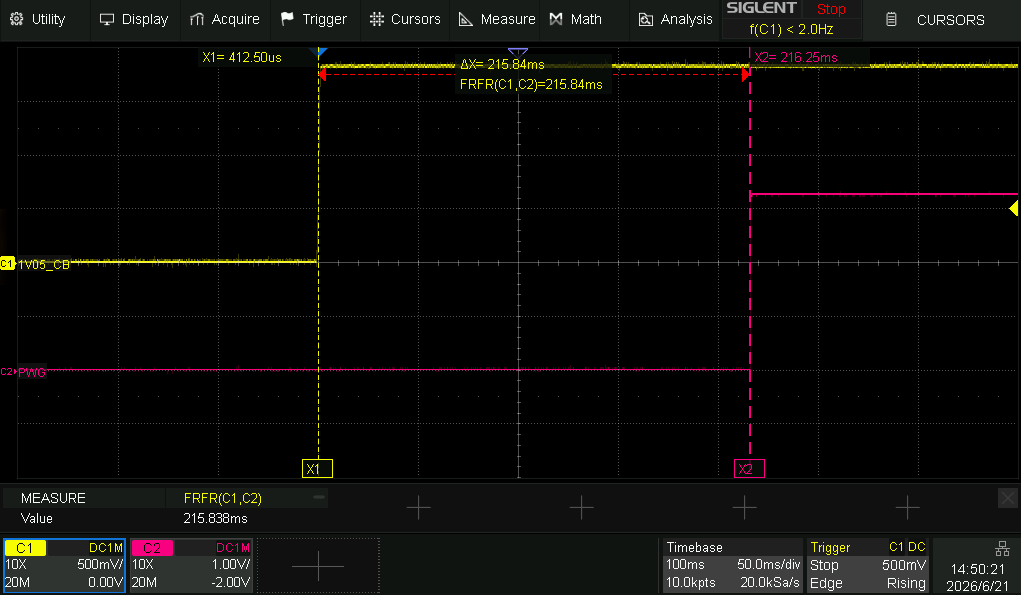
[picture p47: figure]

Figure 30: 1V8_CB ↑ to 1V05_CB ↑ | Figure 31: 1V05_CB ↑ to PWG ↑

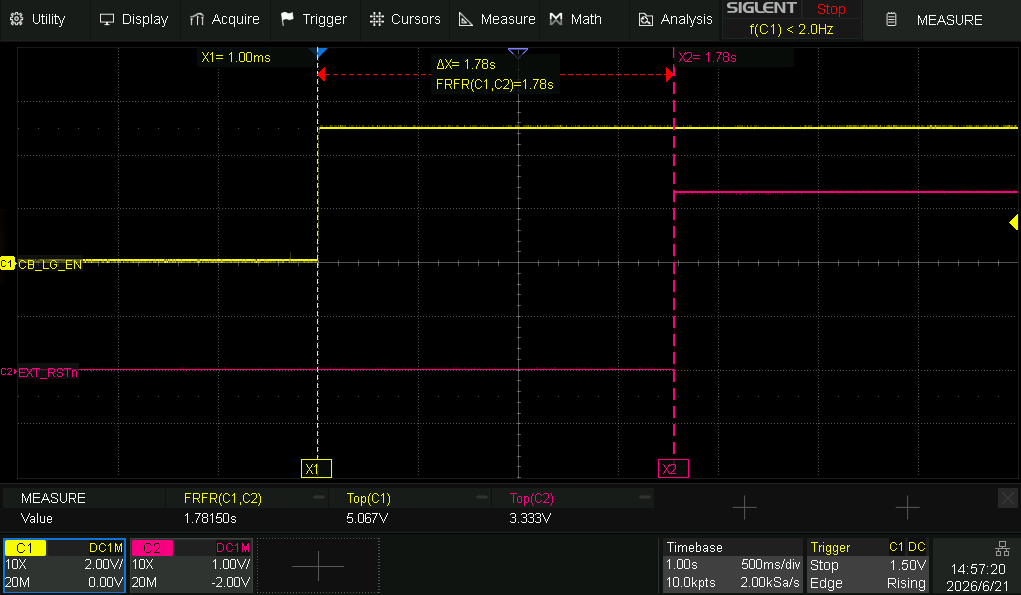
[picture p48: figure]

Figure 32: CB_LOG_EN ↑ to EXT_RSTn ↑

### Conclusion

## WARM RESET

## HARDWARE WATCHDOG

## POWER KILL

### Reference

HW qualification | Reference | RPI_CM[x]_Carrier design notes
| Applicable for | RPI_CM[x]_Carrier Rev 2.00-0A
Description | | Detailed qualification of power kill sequence
Test type | | Internal | External | Site : Sherbrooke
Test status | | In Progress
Final test result | | In Progress

General Info
Date | 2026-06-22 | Temperature Humidity | 25°C 50%RH
Realized by | Jean-François Bilodeau, P. Eng #6022173

### System Information

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

### Assumption

The power kill sequence is designed to meet the timings shown below:

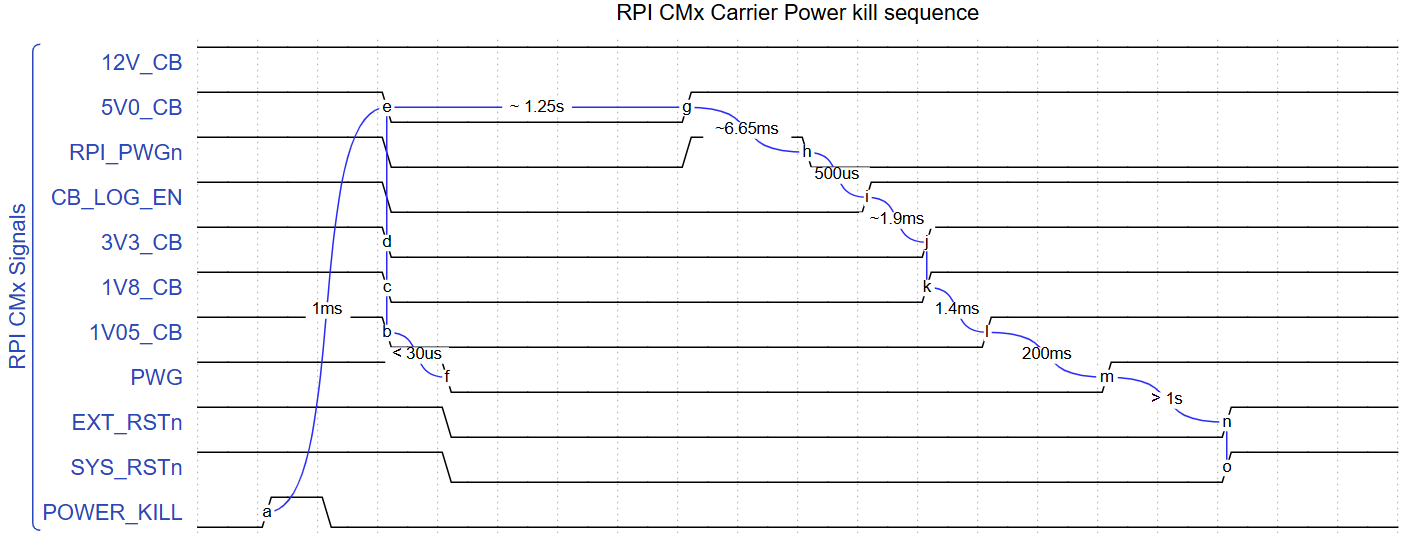
[picture p49: figure]

Figure 33: Power kill schematic implementation

### Measurement point

Measurement location for 12V0_CB | Measurement location for 5V0_CB
Measurement location for RPI_PWG | Measurement location for CB_LOG_EN
Measurement location for 3V3_CB | Measurement location for 1V8_CB
Measurement location for 1V05_CB | Measurement location for PWG
Measurement location for EXT_RSTn | Measurement location for SYS_RSTn

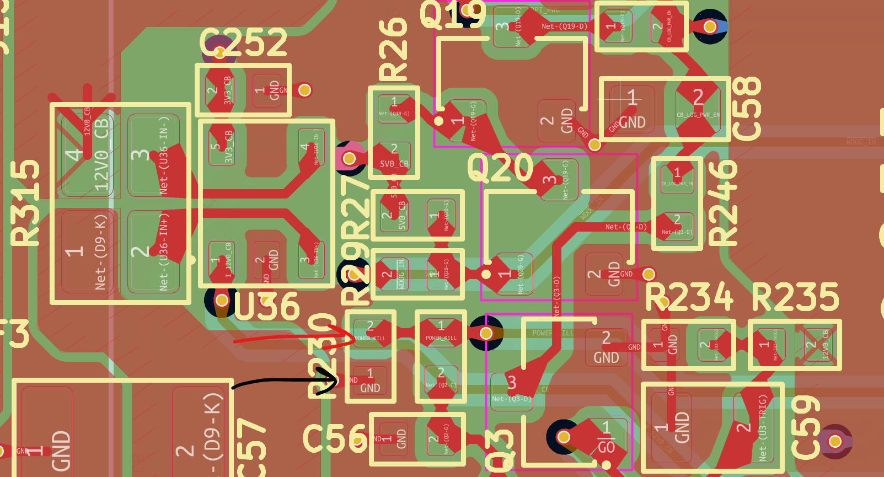
[picture p50: figure]

Measurement location for POWER_KILL

### Test

Power kill sequence | Test parameters
| Target | Measurement | Result | Comments
POWER_KILL ↑ to 5V0_CB ↓ | ~ 1ms | 1.305ms | PASS | Controlled by RC filter and Vgs(th)
5V0_CB ↓ to PWG ↓ | ~30us typ | 50us | PASS | Controlled by power supervisor T(rpd)
5V0_CB ↓ to 5V0_CB ↑ | ~ 1.25s | 1.212s | PARTIAL | Controlled by 555 power-up timer
5V0_CB ↑ to RPI_PWGn ↓ | 6.65ms ± 12% | 131.69ms | PARTIAL | 6.795ms <= 7.65ms <= 8.503ms
RPI_PWGn ↓ to CB_LOG_EN ↑ | ~ 500us | | | Controlled by RC filter
CB_LOG_EN ↑ to 3V3_CB & 1V8_CB ↑ | 1.9ms ± 12% | | | 6.795ms <= 7.65ms <= 8.503ms
1V8_CB ↑ to 1V05_CB ↑ | ~ 1.4ms
1V05_CB ↑ to PWG ↑ | 200ms ± 30% | | | 140ms <= 200ms <= 280ms
CB_LOG_EN ↑ to EXT_RSTn ↑ | > 1sec | | | Controlled by compute module

Power kill sequence

### Figures

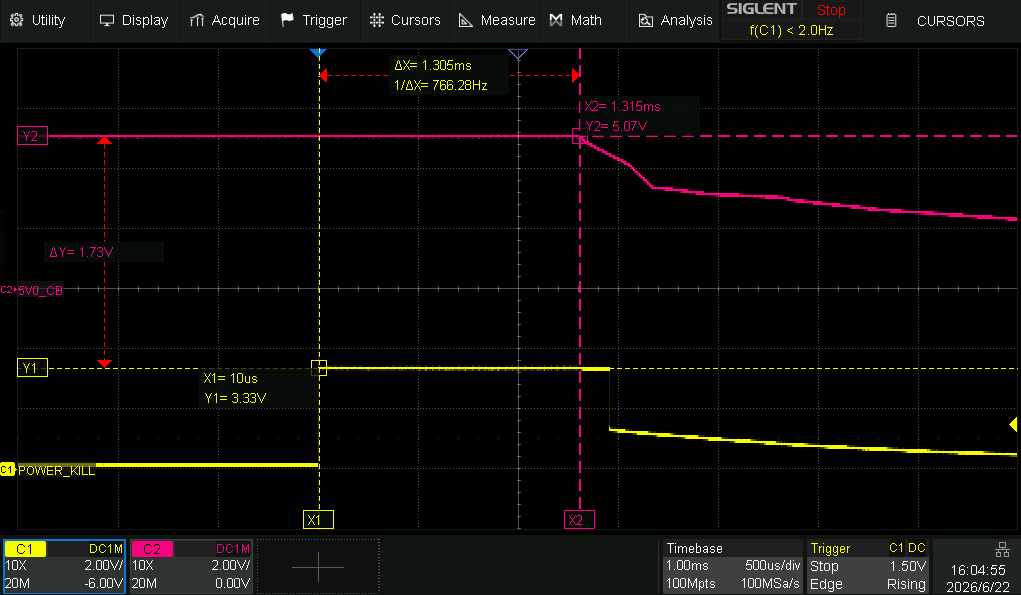
[picture p51: figure]
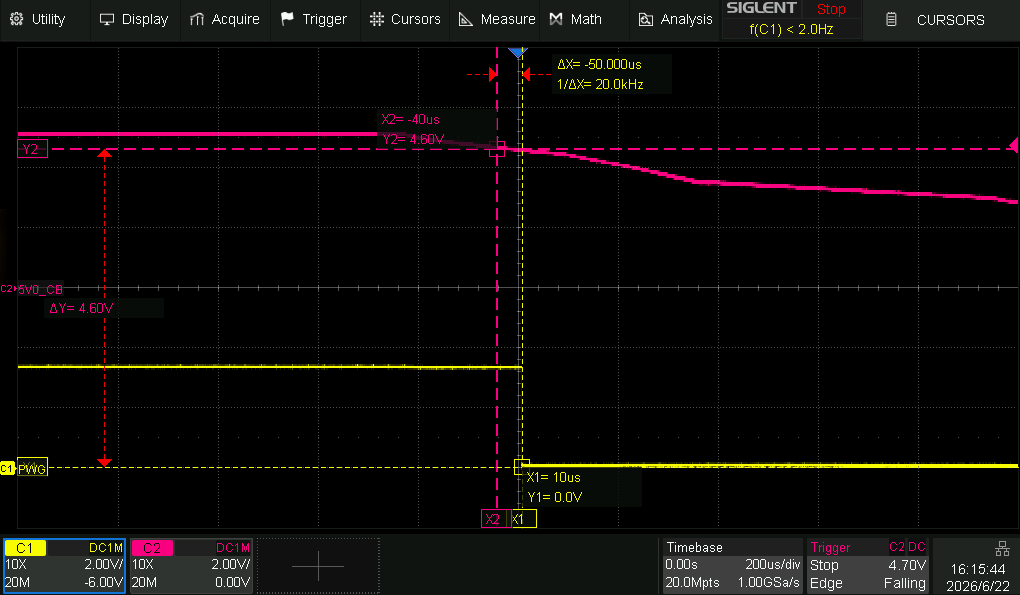
[picture p52: figure]

Figure 34: POWER_KILL ↑ to 5V0_CB ↓ | Figure 35: 5V0_CB ↓ to PWG ↓

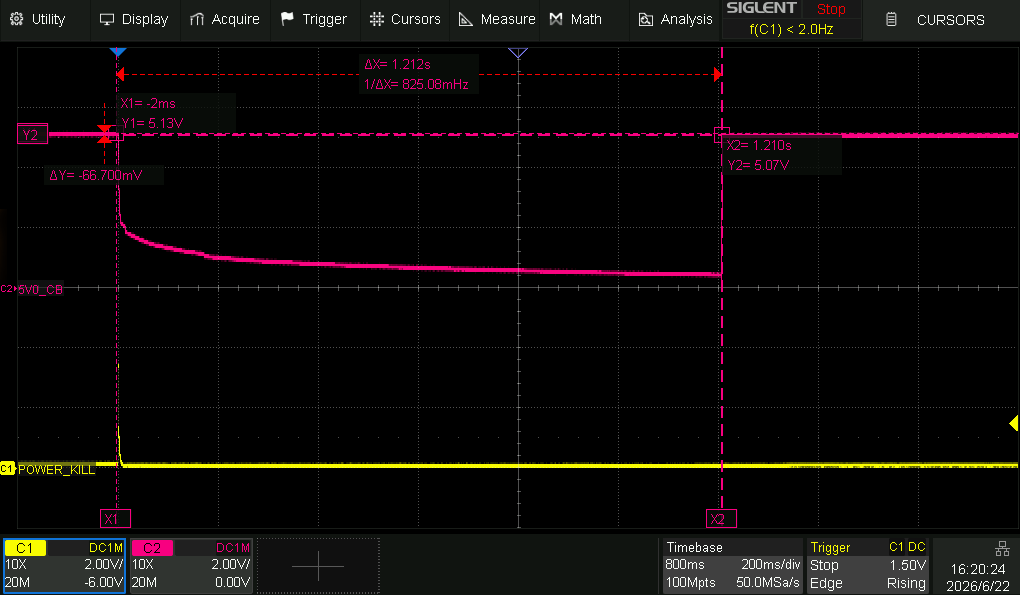
[picture p53: figure]
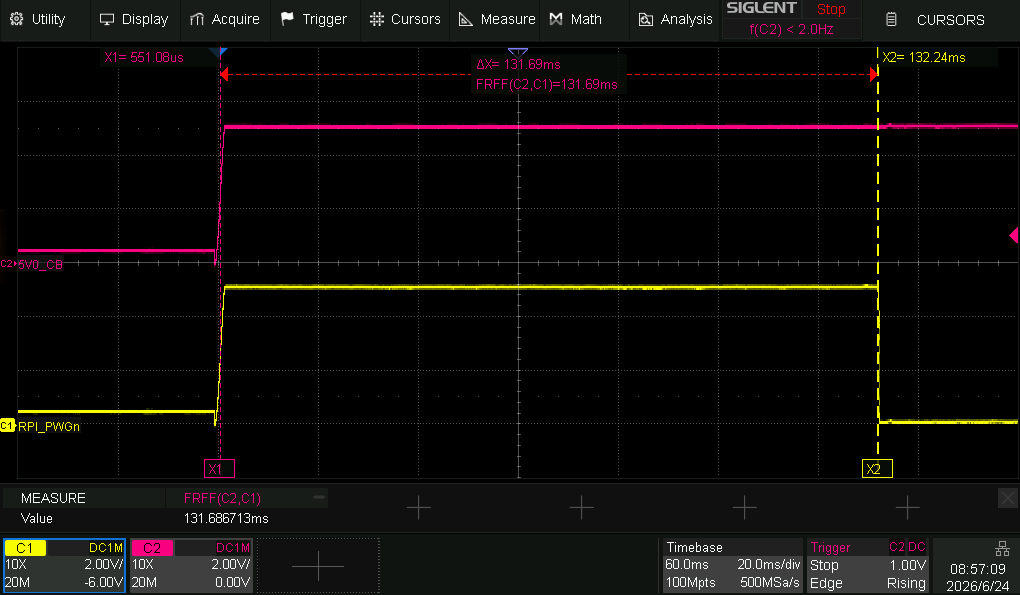
[picture p54: figure]

Figure 36: 5V0_CB ↓ to 5V0_CB ↑ | Figure 37: 5V0_CB ↑ to RPI_PWGn ↓
RPI_PWGn ↓ to CB_LOG_EN ↑ | CB_LOG_EN ↑ to 3V3_CB & 1V8_CB ↑
1V8_CB ↑ to 1V05_CB ↑ | 1V05_CB ↑ to PWG ↑
CB_LOG_EN ↑ to EXT_RSTn ↑

### Conclusion

# DSI to LVDS

## Power rails

## Brown-out

## I2C setup

# PCIe USB HUB

## Power rails

## Brown-out

## Crystal oscillator

## Power switch

# HDMI0

## Power rails

## I2C setup

## Hot plug detect

# Ethernet

## 10Base-T

## 100Base-T

## 1000Base-T

## LED behavior

# Test equipment

Description | List of available test equipment
Date | Equipment available as of 2026-03-09
Owner | Jean-François Bilodeau, P.Eng, #6022173
Equipment type | Serial Number | Description
Oscilloscope | SDS2PDDX5R1312 | Siglent SDS2154X Plus 500MHz 4ch
Multi-meter | SDM35GBX5R0999 | Siglent SDM3055
Power supply | SPD1305 | Siglent single 30V 5A PSU
Logic analyzer | Saleae logic pro 8 | A / D logic analyzer
Current probe | CP-05+ | Current probe 0-400A range

RPI_CM[x]_Carrier – Rev 2.00-0A – DVT report
