lecejeff/RPI_CMx_Carrier/hardware/Rev1_00-0a/output files/WORKING GERBERS/37666-3475236_17761374_RPI_CMx_Carrier_2.00-0A_GERBERS/zk/zk.pdf

## 叠层阻抗信息 HQDFM dfm.elecfans.com

# 叠层阻抗报表

层数:8

# 叠构设计图:

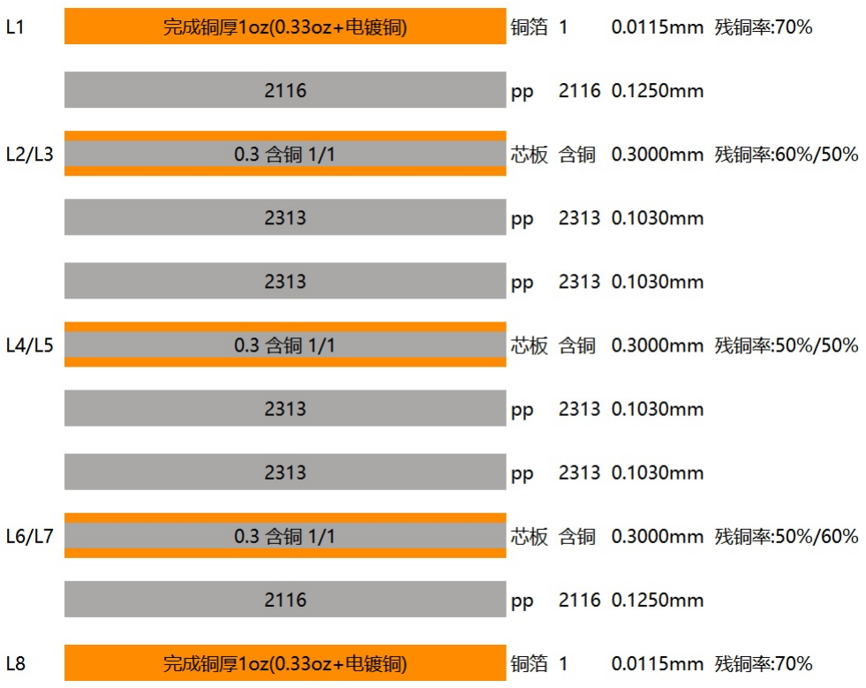
[picture p55: figure]

# 板厚信息表

原始完成板厚: | 1.6000mm +/-10%
压合厚度： | 1.4954 mm

阻抗列表(线宽,线距,到铜距离单位:mil)

序号 | 阻抗模式 | 阻抗层 | 原始线宽 | 原始线距 | 原到铜距 离 | 上参考层 | 下参考层 | 线宽 | 线距 | 到铜距离 | 需求阻抗 (ohm) | 公差 | 计算结果
1 | 外层差分 | L1 | 5.44 | 5.00 | / | / | L2 | 5.80 | 4.64 | / | 90.00 | (+/-10%) | 89.60
2 | 内层差分 | L3 | 6.69 | 6.30 | / | L2 | L4 | 5.80 | 7.19 | / | 90.00 | (+/-10%) | 90.02
3 | 内层差分 | L6 | 6.69 | 6.30 | / | L5 | L7 | 5.80 | 7.19 | / | 90.00 | (+/-10%) | 90.02
4 | 外层差分 | L1 | 5.01 | 7.09 | / | / | L2 | 5.30 | 6.80 | / | 100.00 | (+/-10%) | 100.45
5 | 外层差分 | L8 | 5.01 | 7.09 | / | L7 | / | 5.30 | 6.80 | / | 100.00 | (+/-10%) | 100.45
6 | 内层差分 | L3 | 5.00 | 10.24 | / | L2 | L4 | 5.20 | 10.04 | / | 100.00 | (+/-10%) | 99.68
7 | 内层差分 | L6 | 5.00 | 10.24 | / | L5 | L7 | 5.20 | 10.04 | / | 100.00 | (+/-10%) | 99.68
8 | 外层差分 | L8 | 5.44 | 5.00 | / | L7 | / | 5.80 | 4.64 | / | 90.00 | (+/-10%) | 89.60

阻抗设计示意图
计算模型 | 计算参数 | 计算信息
| W1 : 5.80 W2 : 5.00 S1 : 4.64 H1 : 4.4173 Er1 : 4.2000 T1 : 1.3780 C1 : 1.1969 C2 : 0.5000 C3 : 1.1969 CEr : 3.5000 | 外层差分 控制层: L1 参考层: &L2 设计线宽:5.80mil 走线间距:4.64mil 需求阻抗: 90.00 (+/-10%) ohm 计算阻抗: 89.60 ohm

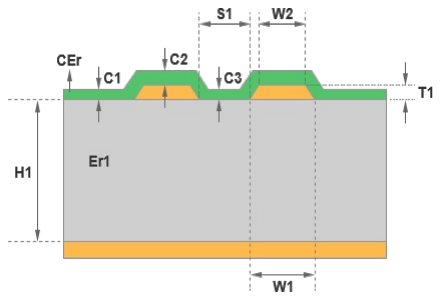
[picture p56: figure]

阻抗设计示意图
计算模型 | 计算参数 | 计算信息

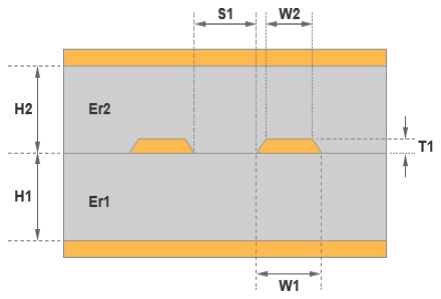
[picture p57: figure]

| W1 : 5.80 W2 : 5.11 S1 : 7.19 H1 : 9.2913 H2 : 8.1102 Er1 : 4.2000 Er2 : 4.2000 T1 : 1.2598 | 内层差分 控制层: L3 参考层: L2&L4 设计线宽:5.80mil 走线间距:7.19mil 需求阻抗: 90.00 (+/-10%) ohm 计算阻抗: 90.02 ohm
| W1 : 5.80 W2 : 5.11 S1 : 7.19 H1 : 9.2913 H2 : 8.1102 Er1 : 4.2000 Er2 : 4.2000 T1 : 1.2598 | 内层差分 控制层: L6 参考层: L5&L7 设计线宽:5.80mil 走线间距:7.19mil 需求阻抗: 90.00 (+/-10%) ohm 计算阻抗: 90.02 ohm
| W1 : 5.30 W2 : 4.50 S1 : 6.80 H1 : 4.4173 Er1 : 4.2000 T1 : 1.3780 C1 : 1.1969 C2 : 0.5000 C3 : 1.1969 CEr : 3.5000 | 外层差分 控制层: L1 参考层: &L2 设计线宽:5.30mil 走线间距:6.80mil 需求阻抗: 100.00 (+/-10%) ohm 计算阻抗: 100.45 ohm
| W1 : 5.30 W2 : 4.50 S1 : 6.80 H1 : 4.4173 Er1 : 4.2000 T1 : 1.3780 C1 : 1.1969 C2 : 0.5000 C3 : 1.1969 CEr : 3.5000 | 外层差分 控制层: L8 参考层: L7& 设计线宽:5.30mil 走线间距:6.80mil 需求阻抗: 100.00 (+/-10%) ohm 计算阻抗: 100.45 ohm

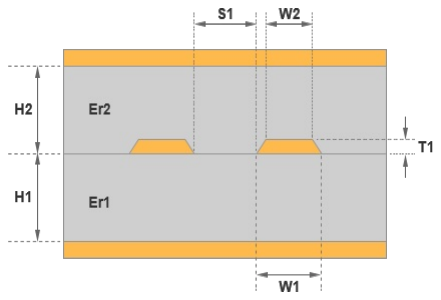
[picture p58: figure]

| W1 : 5.20 W2 : 4.51 S1 : 10.04 H1 : 9.2913 H2 : 8.1102 Er1 : 4.2000 Er2 : 4.2000 T1 : 1.2598 | 内层差分 控制层: L3 参考层: L2&L4 设计线宽:5.20mil 走线间距:10.04mil 需求阻抗: 100.00 (+/-10%) ohm 计算阻抗: 99.68 ohm

阻抗设计示意图
计算模型 | 计算参数 | 计算信息
| W1 : 5.20 W2 : 4.51 S1 : 10.04 H1 : 9.2913 H2 : 8.1102 Er1 : 4.2000 Er2 : 4.2000 T1 : 1.2598 | 内层差分 控制层: L6 参考层: L5&L7 设计线宽:5.20mil 走线间距:10.04mil 需求阻抗: 100.00 (+/-10%) ohm 计算阻抗: 99.68 ohm
| W1 : 5.80 W2 : 5.00 S1 : 4.64 H1 : 4.4173 Er1 : 4.2000 T1 : 1.3780 C1 : 1.1969 C2 : 0.5000 C3 : 1.1969 CEr : 3.5000 | 外层差分 控制层: L8 参考层: L7& 设计线宽:5.80mil 走线间距:4.64mil 需求阻抗: 90.00 (+/-10%) ohm 计算阻抗: 89.60 ohm
