lecejeff/RPI_CMx_Carrier/hardware/design notes/RPI_CMx_Carrier - Design Notes - Power Table.ods

Sheet: Purpose
Purpose | Engineering documentation to assess power supplies voltage compliance, current draw, power draw, efficiency and estimate margin for RPI CM[x] Carrier
Revision | Initial revision 2025-12-13 Author: Jean-Francois Bilodeau, P.Eng #6022173
Project | RPI CM[x] Carrier

Sheet: Dependencies
RPI CM[x] Carrier | Supply name : 12V0_CB |  |  | RPI CM[x] Carrier | Supply name : 5V0_CB
12V0_CB | Min | Nom | Max | 5V0_CB | Min | Nom | Max
Input voltage (V) | 11.6 | 12 | 12.4 | Input voltage (V) | 11.600 | 12.000 | 12.400
Input current (mA) |  |  |  | Input current (mA) | 49.928 | 311.180 | 1440.760
Quiescent current (mA) |  |  |  | Quiescent current (mA) | 0.8 | 0.9 | 1.4
Input power (W) |  |  |  | Input power (W) | 0.579 | 3.734 | 17.865
Efficiency |  |  |  | Efficiency | 92.00% | 90.00% | 88.00%
Output voltage (V) | 11.600 | 12.000 | 12.400 | Output voltage (V) | 4.750 | 5.000 | 5.250
Output current (mA) | 189.53 | 884.31 | 2616.64 | Output current (mA) | 110.378 | 670.205 | 2991.675
Output power (W) | 2.199 | 10.612 | 32.446 | Output power (W) | 0.524 | 3.351 | 15.706
Available current (mA) |  |  |  | Available current (mA) | 5000 | 5000 | 5000
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
