lecejeff/RPI_CMx_Carrier/hardware/design notes/RPI_CM4_CM5_CarrierBoard_PinMux.ods

Sheet: CM4 - CM5 MUX
Compute module 4
PIN | Pull? | ALT0 | ALT1 | ALT2 | ALT3 | ALT4 | ALT5 | NA | NA | NA | SELECTED | Generic info | Implemented?
GPIO0 | HIGH | SDA0 | SA5 | DPI_PCLK | SPI3_CSn_0 | TXD2 | SDA6 |  |  |  | SDA0 | Normally used for HAT and CSI0 / DSI0. | Yes
GPIO1 | HIGH | SCL0 | SA4 | DPI_DE | SPI3_MISO | RXD2 | SCL6 |  |  |  | SCL0 | Normally used for HAT and CSI0 / DSI0. | Yes
GPIO2 | HIGH | SDA1 | SA3 | DPI_VSYNC | SPI3_MOSI | CTS2 | SDA3 |  |  |  | GPIO2 | 1.8V internal pull-up resistors to GPIO_VREF | Yes
GPIO3 | HIGH | SCL1 | SA2 | DPI_HSYNC | SPI3_CLK | RTS2 | SCL3 |  |  |  | GPIO3 | 1.8V internal pull-up resistors to GPIO_VREF | Yes
GPIO4 | HIGH | GPCLK0 | SA1 | DPI_D0 | SPI4_CSn_0 | TXD3 | SDA3 |  |  |  | SDA3 | System I2C bus | Yes
GPIO5 | HIGH | GPCLK1 | SA0 | DPI_D1 | SPI4_MISO | RXD3 | SCL3 |  |  |  | SCL3 | System I2C bus | Yes
GPIO6 | HIGH | GPCLK2 | SOEn / SE | DPI_D2 | SPI4_MOSI | CTS3 | SDA4 |  |  |  | GPIO6 | CMx interrupt output to PIC | Yes
GPIO7 | HIGH | SPI0_CSn_1 | SWEn / SRWn | DPI_D3 | SPI4_CLK | RTS3 | SCL4 |  |  |  | GPIO7 | PIC interrupt input to CMx | Yes
GPIO8 | HIGH | SPI0_CSn_0 | SD0 | DPI_D4 | BSCSL / CEn | TXD4 | SDA4 |  |  |  | SPI0_CSn_0 | PIC spi communication bus, output from CMx | Yes
GPIO9 | LOW | SPI0_MISO | SD1 | DPI_D5 | BSCSL / MISO | RXD4 | SCL4 |  |  |  | SPI0_MISO | PIC spi communication bus, input to CMx | Yes
GPIO10 | LOW | SPI0_MOSI | SD2 | DPI_D6 | BSCSL SDA / MOSI | CTS4 | SDA5 |  |  |  | SPI0_MOSI | PIC spi communication bus, output from CMx | Yes
GPIO11 | LOW | SPI0_CLK | SD3 | DPI_D7 | BSCSL SCL / SCLK | RTS4 | SCL5 |  |  |  | SPI0_CLK | PIC spi communication bus, output from CMx | Yes
GPIO12 | LOW | PWM0_0 | SD4 | DPI_D8 | SPI5_CSn_0 | TXD5 | SDA5 |  |  |  | PWM0_0 | MIPI-DSI PWM backlight | Yes
GPIO13 | LOW | PWM0_1 | SD5 | DPI_D9 | SPI5_MISO | RXD5 | SCL5 |  |  |  | GPIO13 | Unused | Yes
GPIO14 | LOW | TXD0 | SD6 | DPI_D10 | SPI5_MOSI | CTS5 | TXD1 |  |  |  | TXD0 | UART debug console (native in linux) | Yes
GPIO15 | LOW | RXD0 | SD7 | DPI_D11 | SPI5_CLK | RTS5 | RXD1 |  |  |  | RXD0 | UART debug console (native in linux) | Yes
GPIO16 | LOW | RSVD | SD8 | DPI_D12 | CTS0 | SPI1_CSn_2 | CTS1 |  |  |  | GPIO16 | Distinguish between CM4 and CM5 Carrier | Yes
GPIO17 | LOW | RSVD | SD9 | DPI_D13 | RTS0 | SPI1_CSn_1 | RTS1 |  |  |  | GPIO17 | RTC PPS OUT to CM | Yes
GPIO18 | LOW | PCM_CLK | SD10 | DPI_D14 | SPI6_CSn_0 | SPI1_CSn_0 | PWM0_0 |  |  |  | PCM_CLK | I2S | Yes
GPIO19 | LOW | PCM_FS | SD11 | DPI_D15 | SPI6_MISO | SPI1_MISO | PWM0_1 |  |  |  | PCM_FS | I2S | Yes
GPIO20 | LOW | PCM_DIN | SD12 | DPI_D16 | SPI6_MOSI | SPI1_MOSI | GPCLK0 |  |  |  | PCM_DIN | I2S | Yes
GPIO21 | LOW | PCM_DOUT | SD13 | DPI_D17 | SPI6_CLK | SPI1_CLK | GPCLK1 |  |  |  | PCM_DOUT | I2S | Yes
GPIO22 | LOW | SD0_CLK | SD14 | DPI_D18 | SD1_CLK | ARM_TRST | SDA6 |  |  |  | SDA6 | QWIIC I2C bus or Cmx I2C slave | Yes
GPIO23 | LOW | SD0_CMD | SD15 | DPI_D19 | SD1_CMD | ARM_RTCK | SCL6 |  |  |  | SCL6 | QWIIC I2C bus or Cmx I2C slave | Yes
GPIO24 | LOW | SD0_DAT0 | SD16 | DPI_D20 | SD1_DAT0 | ARM_TDO | SPI3_CSn_1 |  |  |  | GPIO24 | Unused | Yes
GPIO25 | LOW | SD0_DAT1 | SD17 | DPI_D21 | SD1_DAT1 | ARM_TCK | SPI4_CSn_1 |  |  |  | GPIO25 | Unused | Yes
GPIO26 | LOW | SD0_DAT2 | RSVD | DPI_D22 | SD1_DAT2 | ARM_TDI | SPI5_CSn_1 |  |  |  | GPIO26 | Unused | Yes
GPIO27 | LOW | SD0_DAT3 | RSVD | DPI_D23 | SD1_DAT3 | ARM_TMS | SPI6_CSn_1 |  |  |  | GPIO27 | Unused | Yes
Compute module 5
PIN | Pull? | ALT0 | ALT1 | ALT2 | ALT3 | ALT4 | ALT5 | ALT6 | ALT7 | ALT8
GPIO0 | HIGH | SPI0_SIO[3] | DPI_PCLK | UART1_TX | I2C0_SDA |  | SYS_RIO[0] | PROC_RIO[0] | PIO[0] | SPI2_CSn[0] | SDA0 | Normally used for HAT and CSI0 / DSI0. | Yes
GPIO1 | HIGH | SPI0_SIO[2] | DPI_DE | UART1_RX | I2C0_SCL |  | SYS_RIO[1] | PROC_RIO[1] | PIO[1] | SPI2_SIO[1] | SCL0 | Normally used for HAT and CSI0 / DSI0. | Yes
GPIO2 | HIGH | SPI0_CSn[3] | DPI_VSYNC | UART1_CTS | I2C1_SDA | UART0_IR_RX | SYS_RIO[2] | PROC_RIO[2] | PIO[2] | SPI2_SIO[0] | GPIO2 | 1.8V internal pull-up resistors to GPIO_VREF | Yes
GPIO3 | HIGH | SPI0_CSn[2] | DPI_HSYNC | UART1_RTS | I2C1_SCL | UART0_IR_TX | SYS_RIO[3] | PROC_RIO[3] | PIO[3] | SPI2_SCLK | GPIO3 | 1.8V internal pull-up resistors to GPIO_VREF | Yes
GPIO4 | HIGH | GPCLK[0] | DPI_D0 | UART2_TX | I2C2_SDA | UART0_RI | SYS_RIO[4] | PROC_RIO[4] | PIO[4] | SPI3_CSn[0 | SDA3 | System I2C bus | Yes
GPIO5 | HIGH | GPCLK[1] | DPI_D1 | UART2_RX | I2C2_SCL | UART0_DTR | SYS_RIO[5] | PROC_RIO[5] | PIO[5] | SPI3_SIO[1] | SCL3 | System I2C bus | Yes
GPIO6 | HIGH | GPCLK[2] | DPI_D2 | UART2_CTS | I2C3_SDA | UART0_DCD | SYS_RIO[6] | PROC_RIO[6] | PIO[6] | SPI3_SIO[0] | GPIO6 | CMx interrupt output to PIC | Yes
GPIO7 | HIGH | SPI0_CSn[1] | DPI_D3 | UART2_RTS | I2C3_SCL | UART0_DSR | SYS_RIO[7] | PROC_RIO[7] | PIO[7] | SPI3_SCLK | GPIO7 | PIC interrupt input to CMx | Yes
GPIO8 | HIGH | SPI0_CSn[0] | DPI_D4 | UART3_TX | I2C0_SDA |  | SYS_RIO[8] | PROC_RIO[8] | PIO[8] | SPI4_CSn[0] | SPI0_CSn_0 | PIC spi communication bus, output from CMx | Yes
GPIO9 | LOW | SPI0_SIO[1] | DPI_D5 | UART3_RX | I2C0_SCL |  | SYS_RIO[9] | PROC_RIO[9] | PIO[9] | SPI4_MISO | SPI0_MISO | PIC spi communication bus, input to CMx | Yes
GPIO10 | LOW | SPI0_SIO[0] | DPI_D6 | UART3_CTS | I2C1_SDA |  | SYS_RIO[10] | PROC_RIO[10] | PIO[10] | SPI4_MOSI | SPI0_MOSI | PIC spi communication bus, output from CMx | Yes
GPIO11 | LOW | SPI0_SCLK | DPI_D7 | UART3_RTS | I2C1_SCL |  | SYS_RIO[11] | PROC_RIO[11] | PIO[11] | SPI4_SCLK | SPI0_CLK | PIC spi communication bus, output from CMx | Yes
GPIO12 | LOW | PMW0[0] | DPI_D8 | UART4_TX | I2C2_SDA | AUDIO_OUT_L | SYS_RIO[12] | PROC_RIO[12] | PIO[12] | SPI5_CSn[0] | PWM0_0 | MIPI-DSI PWM backlight | Yes
GPIO13 | LOW | PMW0[1] | DPI_D9 | UART4_RX | I2C2_SCL | AUDIO_OUT_R | SYS_RIO[13] | PROC_RIO[13] | PIO[13] | SPI5_SIO[1] | GPIO13 | Unused | Yes
GPIO14 | LOW | PMW0[2] | DPI_D10 | UART4_CTS | I2C3_SDA | UART0_TX | SYS_RIO[14] | PROC_RIO[14] | PIO[14] | SPI5_SIO[0] | TXD0 | UART debug console (native in linux) | Yes
GPIO15 | LOW | PMW0[3] | DPI_D11 | UART4_RTS | I2C3_SCL | UART0_RX | SYS_RIO[15] | PROC_RIO[15] | PIO[15] | SPI5_SCLK | RXD0 | UART debug console (native in linux) | Yes
GPIO16 | LOW | SPI1_CSn[2] | DPI_D12 |  |  | UART0_CTS | SYS_RIO[16] | PROC_RIO[16] | PIO[16] |  | GPIO16 | Distinguish between CM4 and CM5 Carrier | Yes
GPIO17 | LOW | SPI1_CSn[1] | DPI_D13 |  |  | UART0_RTS | SYS_RIO[17] | PROC_RIO[17] | PIO[17] |  | GPIO17 | RTC PPS OUT to CM | Yes
GPIO18 | LOW | SPI1_CSn[0] | DPI_D14 | I2S0_SCLK | PWM0[2] | I2S1_SCLK | SYS_RIO[18] | PROC_RIO[18] | PIO[18] | GPCLK[1] | PCM_CLK | I2S | Yes
GPIO19 | LOW | SPI1_SIO[1] | DPI_D15 | I2S0_WS | PWM0[3] | I2S1_WS | SYS_RIO[19] | PROC_RIO[19] | PIO[19] |  | PCM_FS | I2S | Yes
GPIO20 | LOW | SPI1_SIO[0] | DPI_D16 | I2S0_SDI[0] | GPCLK[0] | I2S1_SDI[0] | SYS_RIO[20] | PROC_RIO[20] | PIO[20] |  | PCM_DIN | I2S | Yes
GPIO21 | LOW | SPI1_SCLK | DPI_D17 | I2S0_SDO[0] | GPCLK[1] | I2S1_SDO[0] | SYS_RIO[21] | PROC_RIO[21] | PIO[21] |  | PCM_DOUT | I2S | Yes
GPIO22 | LOW | SDIO0_CLK | DPI_D18 | I2S0_SDI[1] | I2C3_SDA | I2S1_SDI[1] | SYS_RIO[22] | PROC_RIO[22] | PIO[22] |  | SDA3 | QWIIC I2C bus or Cmx I2C slave | Yes
GPIO23 | LOW | SDIO0_CMD | DPI_D19 | I2S0_SDO[1] | I2C3_SCL | I2S1_SDO[1] | SYS_RIO[23] | PROC_RIO[23] | PIO[23] |  | SCL3 | QWIIC I2C bus or Cmx I2C slave | Yes
GPIO24 | LOW | SDIO0_DAT0 | DPI_D20 | I2S0_SDI[2] |  | I2S1_SDI[2] | SYS_RIO[24] | PROC_RIO[24] | PIO[24] | SPI2_CSn[1] | GPIO24 | Unused | Yes
GPIO25 | LOW | SDIO0_DAT1 | DPI_D21 | I2S0_SDO[2] | AUDIO_IN_CLK | I2S1_SDO[2] | SYS_RIO[25] | PROC_RIO[25] | PIO[25] | SPI3_CSn[1] | GPIO25 | Unused | Yes
GPIO26 | LOW | SDIO0_DAT2 | DPI_D22 | I2S0_SDI[3] | AUDIO_IN_DAT0 | I2S1_SDI[3] | SYS_RIO[26] | PROC_RIO[26] | PIO[26] | SPI5_CSn[1] | GPIO26 | Unused | Yes
GPIO27 | LOW | SDIO0_DAT3 | DPI_D23 | I2S0_SDO[3] | AUDIO_IN_DAT1 | I2S1_SDO[3] | SYS_RIO[27] | PROC_RIO[27] | PIO[27] | SPI1_CSn[1] | GPIO27 | Unused | Yes

Sheet: PIC32AK 64p
PIN # | PIC32AK1216GC41064 | RP IN/OUT | 5V TOL | Used | POWER / OSC | Volt mon (5x) | Curr mon (5x) | ICSP | SPI Cmx | POWER KILL | WDOG | INTn <-> CM4 | UART (Debug) | MikroBus (1) | IO expand | DEBUG LED
1 | PGD2/AD2AN6/CMP3C/ISRC2/IBIAS2/RP1/SDA2/ IOMF2/RA0 | IN/OUT | NO | YES |  |  |  |  |  |  |  |  |  |  |  | LED2
2 | AD1AN6/RP8/IOMF1/RA7 | IN/OUT | NO | YES |  | 12V0_CB
3 | PGC2/DACOUT1/AD1AN7/AD2AN3/CMP1D/CMP2D/ CMP3D/RP2/SCL2/RA1 | IN/OUT | NO | YES |  |  | I_5V0_CB
4 | VSS | NO | NO | YES | VSS
5 | VDD | NO | NO | YES | VDD
6 | AD1AN10/RP12/RA11 | IN/OUT | NO | YES |  |  |  |  |  |  |  |  |  | MKB1_AN
7 | AD2AN9/ISRC3/IBIAS3/RP9/RA8 | IN/OUT | NO | YES |  |  |  |  |  |  |  |  |  |  | Spare
8 | AD1ANN3/AD1AN9/RP10/RA9 | IN/OUT | NO | YES |  |  |  |  |  |  |  |  |  |  | Spare
9 | AD2ANN3/AD2AN7/RP11/RA10 | IN/OUT | NO | YES |  |  |  |  |  |  |  |  |  |  | KILL
10 | AVSS | NO | NO | YES | AVSS
11 | AVDD | NO | NO | YES | AVDD
12 | OA1OUT/AD1AN0/CMP1A/RP3/RA2 | IN/OUT | NO | YES |  | 1V05_CB
13 | OA1IN-/AD1ANN1/AD2AN0/RP4/RA3 | IN/OUT | NO | YES |  |  |  |  |  |  |  |  |  |  | Spare
14 | OA1IN+/AD1AN1/CMP1B/RP5/RA4 | IN/OUT | NO | YES |  | 1V8_CB
15 | OA3OUT/AD1AN3/CMP3A/RP6/RA5 | IN/OUT | NO | YES |  | 5V0_CB
16 | OA3IN-/AD1AN2/RP7/RA6 | IN/OUT | NO | YES |  | 3V3_CB
17 | OA3IN+/AD2AN2/CMP3B/RP22/RB5 | IN/OUT | NO | YES |  |  | I_3V3_CB
18 | VSS | NO | NO | YES | VSS
19 | VDD | NO | NO | YES | VDD
20 | OA2OUT/AD2AN1/CMP2A/RP17/INT0/RB0 | IN/OUT | NO | YES |  |  | I_1V8_CB
21 | TMS/OA2IN-/AD1AN4/AD2ANN1/RP18/RB1(4) | IN/OUT | NO | YES |  |  |  |  |  |  |  |  |  |  | Spare
22 | OA2IN+/AD2AN4/CMP2B/RP19/RB2 | IN/OUT | NO | YES |  |  |  |  |  |  |  |  |  |  |  | BTN1
23 | AD1AN11/RP25/RB8 | IN/OUT | NO | YES |  |  |  |  |  |  | WDOG_OUT
24 | AD2AN10/RP26/RB9 | IN/OUT | NO | YES |  |  | I_12V0_CB
25 | VSS | NO | NO | YES | VSS
26 | VDD | NO | NO | YES | VDD
27 | PGD1/AD1AN5/CMP1C/ISRC0/IBIAS0/RP20/SDA1/RB3 | IN/OUT | NO | YES |  |  |  | ICSPDAT
28 | PGC1/AD2AN5/CMP2C/ISRC1/IBIAS1/RP21/SCL1/RB4 | IN/OUT | NO | YES |  |  |  | ICSPCLK
29 | AD1ANN2/AD1AN8/RP23/RB6 | IN/OUT | NO | YES |  |  |  |  |  |  |  |  |  | MKB1_RST
30 | AD2ANN2/AD2AN8/RP24/IOMF0/RB7 | IN/OUT | NO | YES |  |  |  |  |  |  |  |  |  |  |  | LED1
31 | RP27/SCK2/RB10(2) | IN/OUT | YES | YES |  |  |  |  | SCLK2
32 | RP28/SDI2/RB11 | IN/OUT | YES | YES |  |  |  |  | SDI2
33 | RP41/IOMD11/IOMF11/PCI20/RC8(2) | IN/OUT | YES | YES |  |  |  |  | CS2
34 | RP42/IOMD10/SDO2/IOMF10/PCI19/RC9(2) | IN/OUT | YES | YES |  |  |  |  | SDO2
35 | RP39/RC6 | IN/OUT | YES | YES |  |  |  |  |  |  |  |  |  | MKB_MOSI
36 | RP40/RC7 | IN/OUT | YES | YES |  |  |  |  |  |  |  |  |  | MKB_MISO
37 | OSCO/CLKO/RP33/IOMF5/RC0(2) | IN/OUT | YES | YES | OSCO
38 | OSCI/CLKI/RP34/IOMF6/RC1 | IN/OUT | YES | YES | OSCI
39 | VSS | NO | NO | YES | VSS
40 | VDD | NO | NO | YES | VDD
41 | PGC3/RP35/PWM4H/RC2 | IN/OUT | YES | YES |  |  |  |  |  |  |  |  |  | MKB_SCK
42 | RP38/PWM4L/RC5 | IN/OUT | YES | YES |  |  |  |  |  |  |  |  |  | MKB1_Csn
43 | PGD3/RP36/PWM3H/IOMD0/RC3 | IN/OUT | YES | YES |  |  |  |  |  |  |  |  |  | MKB1_TX
44 | RP37/PWM3L/IOMD1/RC4 | IN/OUT | YES | YES |  |  |  |  |  |  |  |  |  | MKB1_RX
45 | RP43/IOMD9/IOMF9/RC10 | IN/OUT | YES | YES |  |  |  |  |  |  |  |  | RXD0
46 | RP44/IOMD8/IOMF8/RC11 | IN/OUT | YES | YES |  |  |  |  |  |  |  |  | TXD0
47 | VSS | NO | NO | YES | VSS
48 | VDD | NO | NO | YES | VDD
49 | RP58/IOMF7/RD9 | IN/OUT | YES | YES |  |  |  |  |  |  |  |  |  |  | PPS IN
50 | RP59/RD10 | IN/OUT | YES | YES | CMx -> PIC32 INT
51 | RP49/PWM2H/IOMD2/RD0 | IN/OUT | YES | YES |  |  |  |  |  |  |  |  |  | MKB1_INT
52 | TCK/RP50/PWM2L/IOMD3/RD1 | IN/OUT | YES | YES |  |  |  |  |  |  |  | CM4/CM5n
53 | TDO/RP51/PWM1H/IOMD4/RD2 | IN/OUT | YES | YES |  |  |  |  |  |  |  | PIC32 -> CMx INT
54 | TDI/RP52/PWM1L/IOMD5/RD3 | IN/OUT | YES | YES |  |  |  |  |  |  |  |  |  | MKB1_PWM
55 | RP54/ASCL1/RD5 | IN/OUT | YES | YES |  |  |  |  |  |  |  |  |  | MKB1_SCL
56 | RP55/ASDA1/RD6 | IN/OUT | YES | YES |  |  |  |  |  |  |  |  |  | MKB1_SDA
57 | RP56/ASCL2/IOMD7/IOMF4/RD7 | IN/OUT | YES | YES |  |  |  |  |  |  |  |  |  |  | RPI I2C SLAVE
58 | RP57/ASDA2/IOMD6/IOMF3/RD8 | IN/OUT | YES | YES |  |  |  |  |  |  |  |  |  |  | RPI I2C SLAVE
59 | VSS | NO | NO | YES | VSS
60 | VDD | NO | NO | YES | VDD
61 | RP53/PCI22/RD4 | IN/OUT | YES | YES |  |  |  |  |  |  |  |  |  |  | Spare
62 | P60/RD11 | IN/OUT | YES | YES |  |  |  |  |  |  |  |  |  |  | Spare
63 | RP61/PCI21/RD12 | IN/OUT | YES | YES |  |  |  |  |  |  |  |  |  |  | Spare
64 | MCLRn | NO | YES | YES |  |  |  | MCLRn
 |  |  |  | 0 |  |  |  |  |  |  |  |  |  |  | 11
