lecejeff/RPI_CMx_Carrier/hardware/Rev1_00-0a/output files/WORKING GERBERS/37666-3475236_17761374_RPI_CMx_Carrier_2.00-0A_GERBERS/QQ截图20260305171754.png

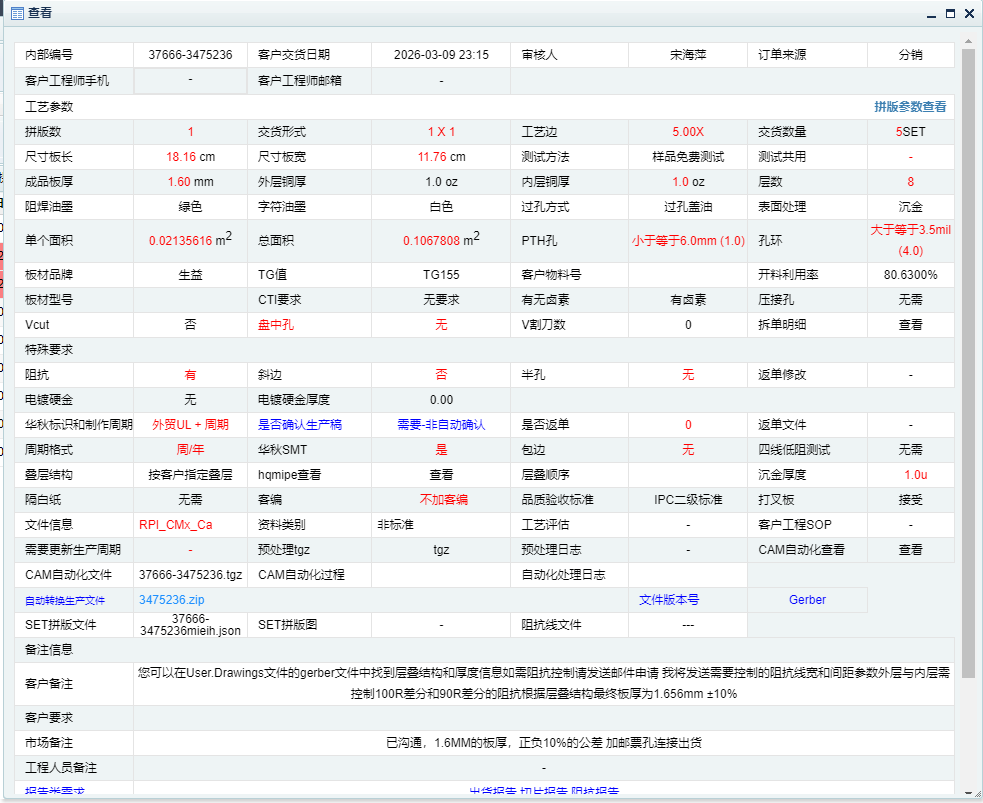
hardware/Rev1_00-0a/output files/WORKING GERBERS/37666-3475236_17761374_RPI_CMx_Carrier_2.00-0A_GERBERS/QQ截图20260305171754.png
