lecejeff/RPI_CMx_Carrier/hardware/DVT/Prototype Tracker.ods

Sheet: Tracker
Work item number | WI-00001 | WI-00002 | WI-00003 | WI-00004 | WI-00005 | WI-00006 | WI-00007 | WI-00008 | WI-00009 | WI-00010 | WI-00011
Work item description | CB_LOG_PWR_EN release threshold voltage | WATCHDOG timer enabling at first boot | PIC32 WATCHDOG output park to GND | 0R 0402 fuckup in component database + BOM | Schematic comment adjustments | PCIe reserved signals CM4 | Wrong SD card switch signal on footprint | Current and Voltage sense on 12V0_CB and 5V0_CB causing backfeed on 3V3_CB | Blip on SYS_RSTn | SPI FLASH uPD720202 can be depopulated | 5V0_CB discharge time on power_kill event
Date of work item addition to tracker | 2026-04-05 | 2026-04-05 | 2026-04-05 | 2026-04-05 | 2026-04-05 | 2026-04-05 | 2026-04-10 | 2026-04-10 | 2026-04-10 | 2026-05-10 | 2026-06-22
NX2604010001 (CM4 variant) | DONE 2026-04-02 |  |  | DONE 2026-04-10 | NOT REQUIRED | DONE 2026-04-10 | DONE 2026-04-10 | DONE 2026-04-10 |  | DONE 2026-05-10
NX2604010002 (CM5 variant) | DONE 2026-04-02 |  |  | DONE 2026-04-10 | NOT REQUIRED | NOT REQUIRED | DONE 2026-04-10 | DONE 2026-04-10 |  | NOT REQUIRED

Sheet: Backlog
Work Item # | Work Item name | Description | Screenshot | Correction (current) | Correction (next revision)
WI-00001 | CB_LOG_PWR_EN release threshold voltage | Dual 100K resistors used (one for RC delay to enable CB_LOG_PWR_EN, one for weak pulling down when not ready). If CB_LOG_PWR_EN is not ready to be deasserted, Q24 will keep the line held to GND until both 3V3_Cmx and 1V8_Cmx are ready. Furthermore, TPS54527 EN input draws ~ 15uA of current, which restrains the EN voltage amplitude. |  | Depopulate R248 Change R21 to 1K | Set R248 as DNP in all production variants Change BOM value of R21 to 1K 1% 1/16W 0402
WI-00002 | WATCHDOG timer enabling at first boot | At first boot, the delay prior to enabling STWD100NYWY3F is set through the 1Meg resistor and 1uF capacitor ~= 450ms which is insufficient to 1st program the PIC32 to assert the WD |  | Adjust R30 to 47Meg Adjust C103 to 22uF | Add another series resistor between R30 and Q21 gate Add another parallel capacitor next to C103
WI-00003 | PIC32 WATCHDOG output park to GND | There are no PD keeping the signal held at a fixed voltage until the part is programmed. Next revision should include this pull-down for immunity |  | Add 10K PD between Q25 G and S (PIC32 WDOG output signal and GND) | Add 10K PD to GND on PIC32 WDOG output signal
WI-00004 | 0R 0402 fuckup in component database + BOM | All 0R 0402 on-board (target assembly) are in reality 1K (actual assembly) due to BOM mixup |  | Change all 0R 0402 RefDes (52x per board according to BOM) to actual 0R resistor R13,R24,R29,R32,R33,R34,R35,R36,R37,R38,R39,R40,R41,R42,R43,R44,R45,R67,R70,R88,R117,R120,R135,R136,R144,R145,R150,R152,R157,R160,R161,R162,R163,R164,R165,R166,R167,R168,R169,R170,R171,R172,R173,R174,R175,R176,R180,R183,R191,R211,R233,R290 | Correct component database RES_SMT_00001 (manufacturer part number) and update component from library in KiCad
WI-00005 | Schematic comment adjustments | Adjust notes on schematic for clarity |  | Not applicable | Swap notes on USB 2.0 MUX related to HOST vs OTG port
WI-00006 | PCIe reserved signals | Ensure DNP on PCIe signals on CM4 (reserved) that have been implemented for CM5 |  | Depopulate R161 (USB_HUB.WAKEn) | Depopulate R161 (USB_HUB.WAKEn)
WI-00007 | Wrong SD card switch signal on footprint | Move SD card switch CD_A connector to +3.3Vcc (not using the appropriate pad on the footprint) |  | Solder wire wrap between both pads | Correct footprint in database
WI-00008 | Current and Voltage sense on 12V0_CB and 5V0_CB causing backfeed on 3V3_CB | 12V0_CB and 5V0_CB are up and alive for > 500ms prior to 3V3_CB ramp-up. The Current sense amplifier, and voltage sense resistive divider, both backfeed in 3V3_CB, causing spurious latchup and preventing CM4 from booting reliably on occurence of > 40%. |  | Remove 12V0_CB Vsense PU resistor (R7) Remove 5V0_CB Vsense PU resistor (R65) Remove 12V0_CB current sense amplifier (U36) Remove 5V0_CB current sense amplifier (U13) | Add gating to those circuits bases on SYS_RSTn net status, which is released when RPI is cleared to boot (EXT_RSTn high) and all power rails are good (PWG high)
WI-00009 | Blip on SYS_RSTn | The MOSFET is “floating” until 3V3_CB rises. As long as VGS(th) of Q8 isn’t met, the drain of Q13 follows 3V3_CB. |  | Change MOSFET to low VGS(th) to minimize voltage blip Candidate DMN2005K-7 (https://www.digikey.ca/en/products/detail/diodes-incorporated/DMN2005K-7/1778818) | Change MOSFET to low VGS(th) to minimize voltage blip Candidate DMN2005K-7 (https://www.digikey.ca/en/products/detail/diodes-incorporated/DMN2005K-7/1778818)
WI-00010 | SPI FLASH uPD720202 can be depopulated | Recent linux kernels now uploads the firmware to uPD720202 automatically; The SPI FLASH is thus not needed anymore, but PU / PD may still be required for proper operations of uPD720202 |  | Leave as-is on current hardware | Depopulate U6, C23, R52 Confirm with Renesas application notes what to do with R54, R55, R56, R57 for memory-less operation
WI-00011 | 5V0_CB discharge time on power_kill event | The 555 timer “OFF” duration is not sufficiently long to fully discharge the 5V0 rail to 0V during a power kill event. |  | Decrease bleed resistor (R260) to 5k Ohm (2x 10K in //) Double 555 OFF time by replacing R237 from 100K to 200K | OFF time must be >= 3.1sec to fully discharge 5V0_CB rail Adjust bleed resistor and 555 OFF time accordingly

Sheet: Configurator
Name | RPCM | 1 | 2 | 3 | 4
Raspberry PI Compute Module Carrier
Basic | RPCMB
Lite | RPCML
Compute Module
Compute Module 4 |  | 4
Compute Module 5 |  | 5
WiFi + BT
 | No Wifi / BT |  | 0
 | With Wifi / BT |  | 1
eMMC
No eMMC |  |  |  | 0
8GB eMMC |  |  |  | 1
16GB eMMC |  |  |  | 2
32GB eMMC |  |  |  | 3
64GB eMMC (Compute Module 5 only) |  |  |  | 4
128GB eMMC (Compute Module 5 only) |  |  |  | 5
RAM
1GB RAM LPDDR4 |  |  |  |  | 1
2GB RAM LPDDR4 |  |  |  |  | 2
4GB RAM LPDDR4 |  |  |  |  | 3
8GB RAM LPDDR4 |  |  |  |  | 4
16GB RAM LPDDR4 (Compute Module 5 only) |  |  |  |  | 5
 |  |  |  |  |  | RPCMB5124
 |  |  |  |  |  | RPCMB4112
 |  |  |  |  |  | RPCMB4002
