lecejeff/RPI_CMx_Carrier/hardware/Rev1_00-0a/rpi_cm4_cm5_CarrierBoard/RPI_CMx_outline.dxf

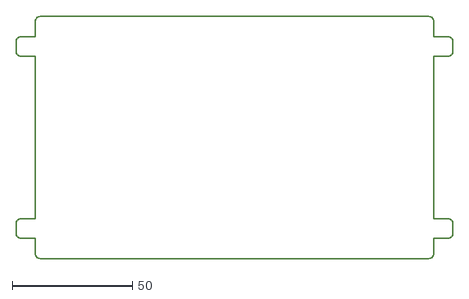
[picture p61: CAD file, 2026-01-01]
hardware/Rev1_00-0a/rpi_cm4_cm5_CarrierBoard/RPI_CMx_outline.dxf
181.6 x 100.6
