lecejeff/RPI_CMx_Carrier/hardware/Rev1_00-0a/output files/PCB_PDF/RPI_CMx_Carrier_2.00-0A_PCB_PDF.pdf

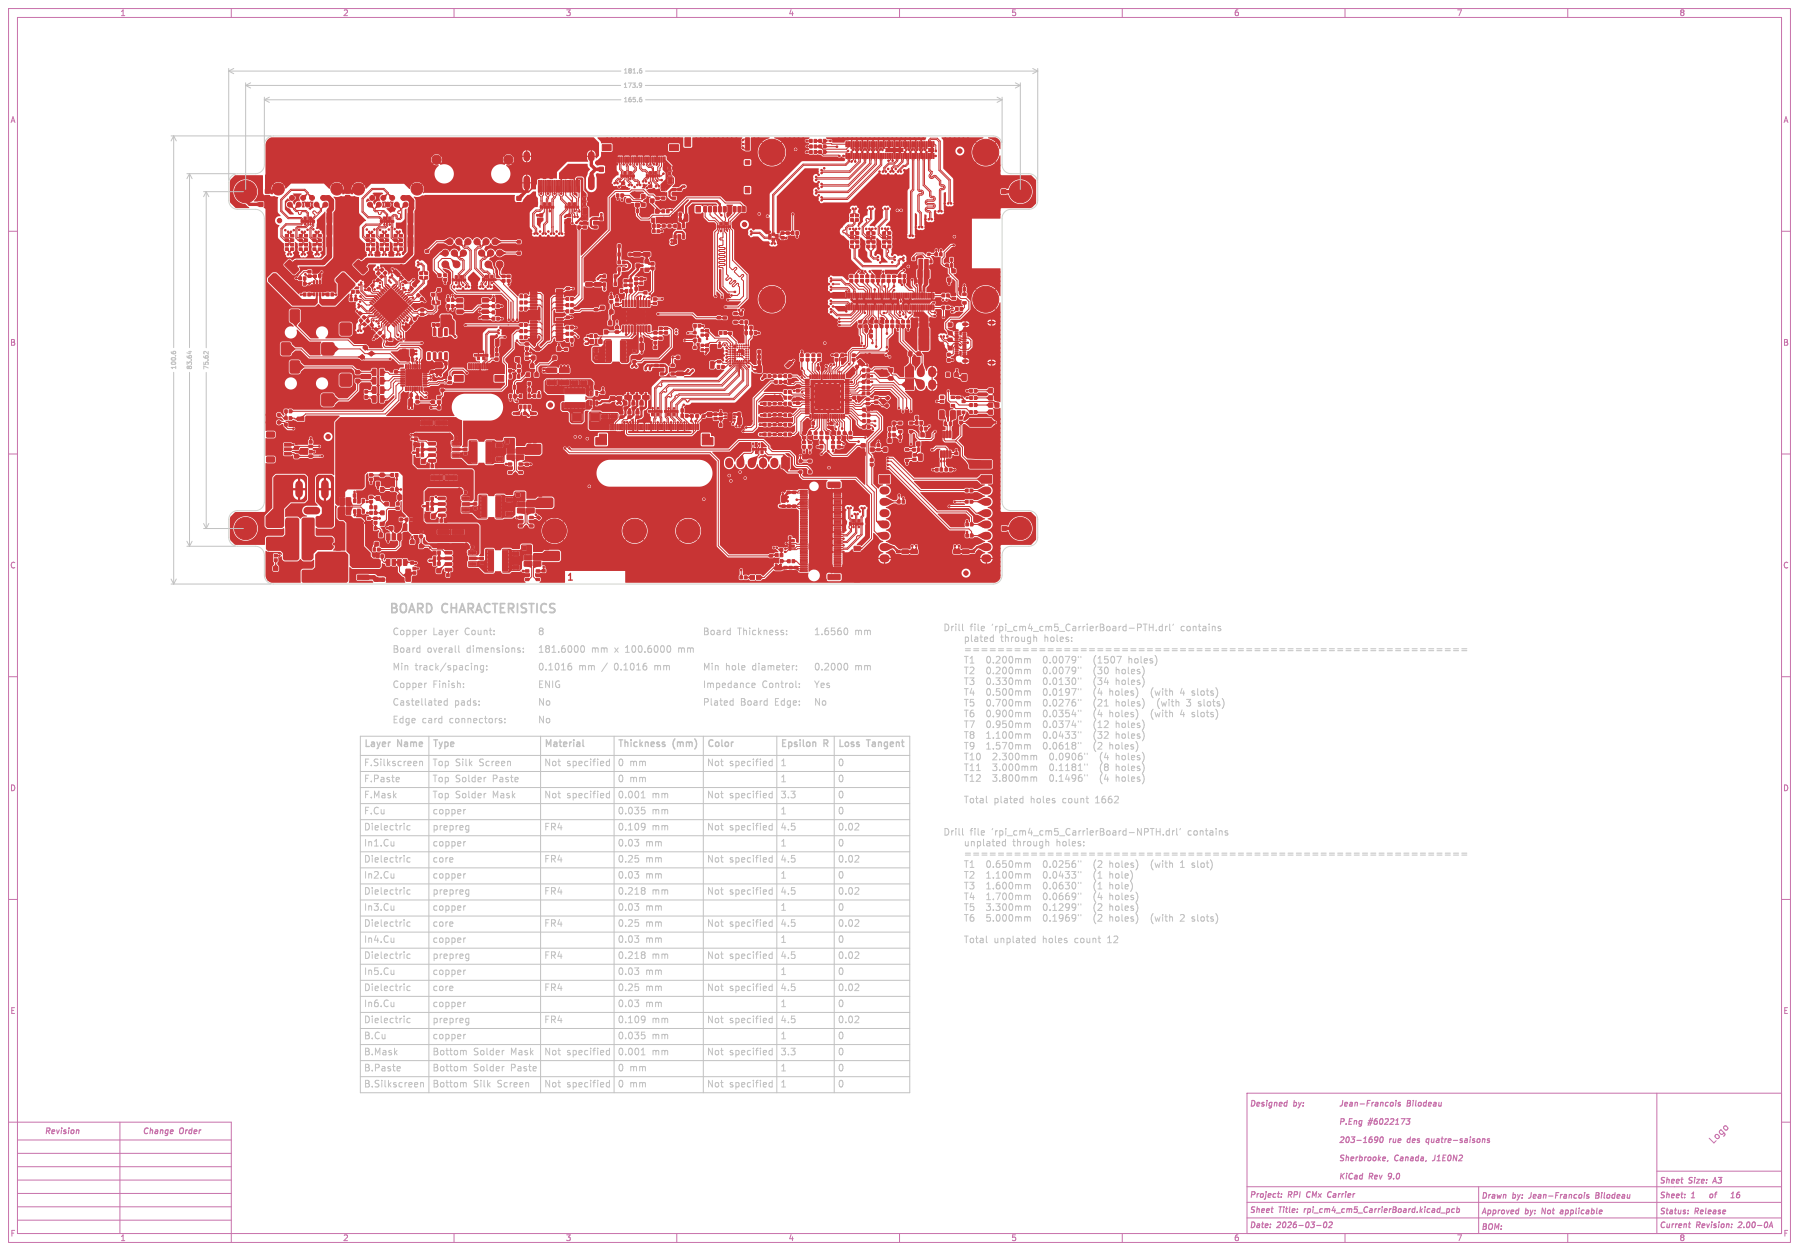
[picture p62: page 1]

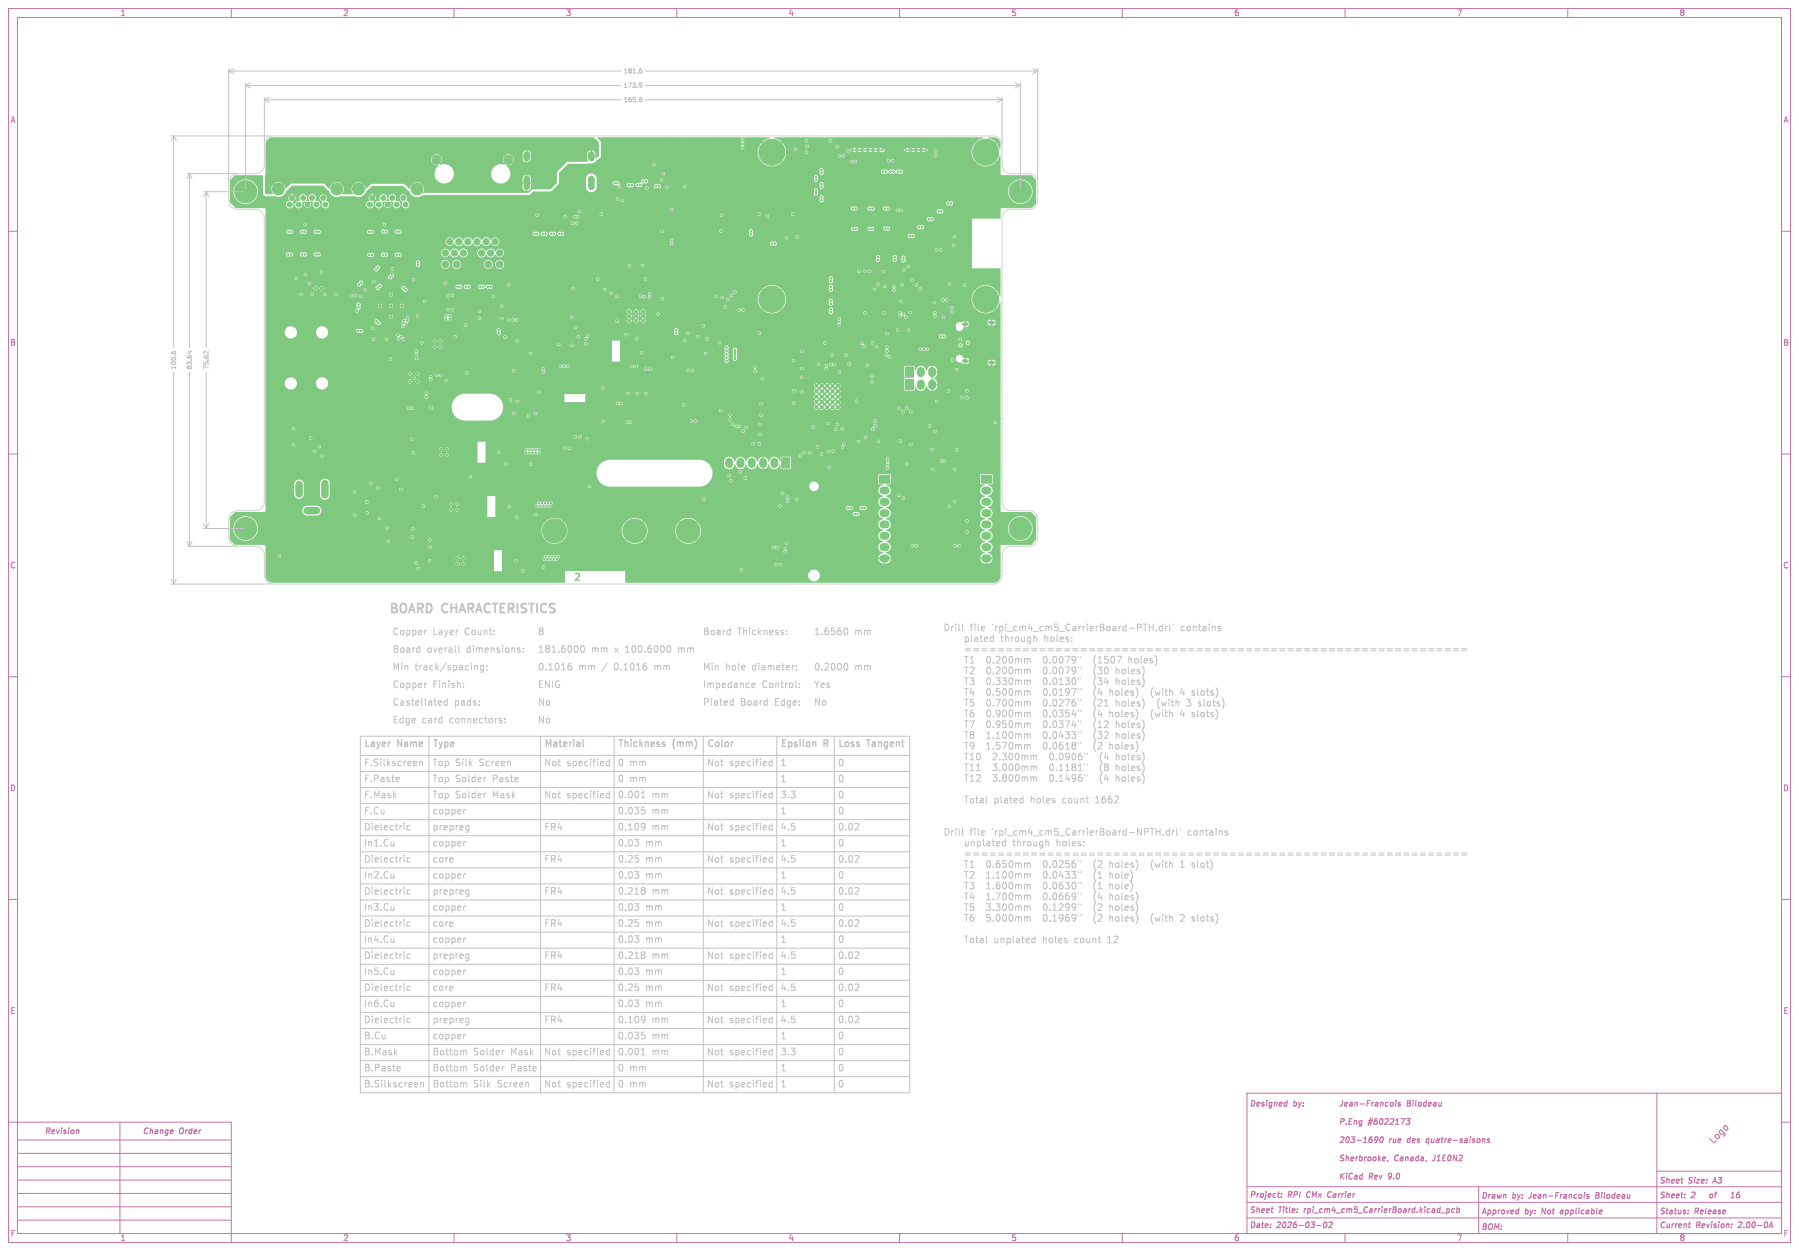
[picture p63: page 2]

Copper Layer Count: F.Paste | copper dimensions: core 0.1016 mm / 0.1016 mm prepreg No | Material copper | (mm) 0 mm | Plated Board Edge: B.Paste Board Thickness: Not specified Not specified Color B.Mask Dielectric Min hole diameter: Top Solder Mask Not specified | 4.5 B.Silkscreen 1 FR4 4.5 Board overall 3.3 Thickness 1 | 0.02 Not specified 0

Not specified | | Impedance Control: 3.3 ENIG | Yes 0.218 mm 1

copper Castellated pads: | | 0.001 mm | Not specified
Edge card Layer Name | connectors: | | | | Epsilon R | 0.02

prepreg | | 0.109 mm | | | Loss Tangent 1
Top Silk Screen | | 0 mm | | 1 | 0

Type | FR4 | 0.03 mm | Not specified FR4 | 1 | 0 Not specified

In2.Cu | | | copper prepreg copper | FR4 | 0.03 mm | Not specified Dielectric F.Cu | 1 Not specified 4.5 1 | 0 0

In1.Cu | | | prepreg Bottom Silk Screen | Not specified FR4 | 0.218 mm | | 4.5 | 0.02

copper core | | 0.25 mm | | 4.5 | 0 0.02

In3.Cu | | | | | 0.03 mm | | | 0 Dielectric Dielectric 0

In4.Cu | | | copper | | 0.03 mm | Not specified | 4.5 Not specified 1

Dielectric | | | | | 0.25 mm | | | 0.02

In5.Cu Dielectric | | | | | | 4.5 | 0.02
core | | | 0.25 mm | | 1 Dielectric | 0 FR4
In6.Cu | copper | | | 0.03 mm | Not specified

0.109 mm | | | 0 Bottom Solder Mask 0.02

0.035 mm | | | 0
0.001 mm | | | 0

Bottom Solder Paste | | | 0 mm | | 1 | 0

P.Eng #6022173

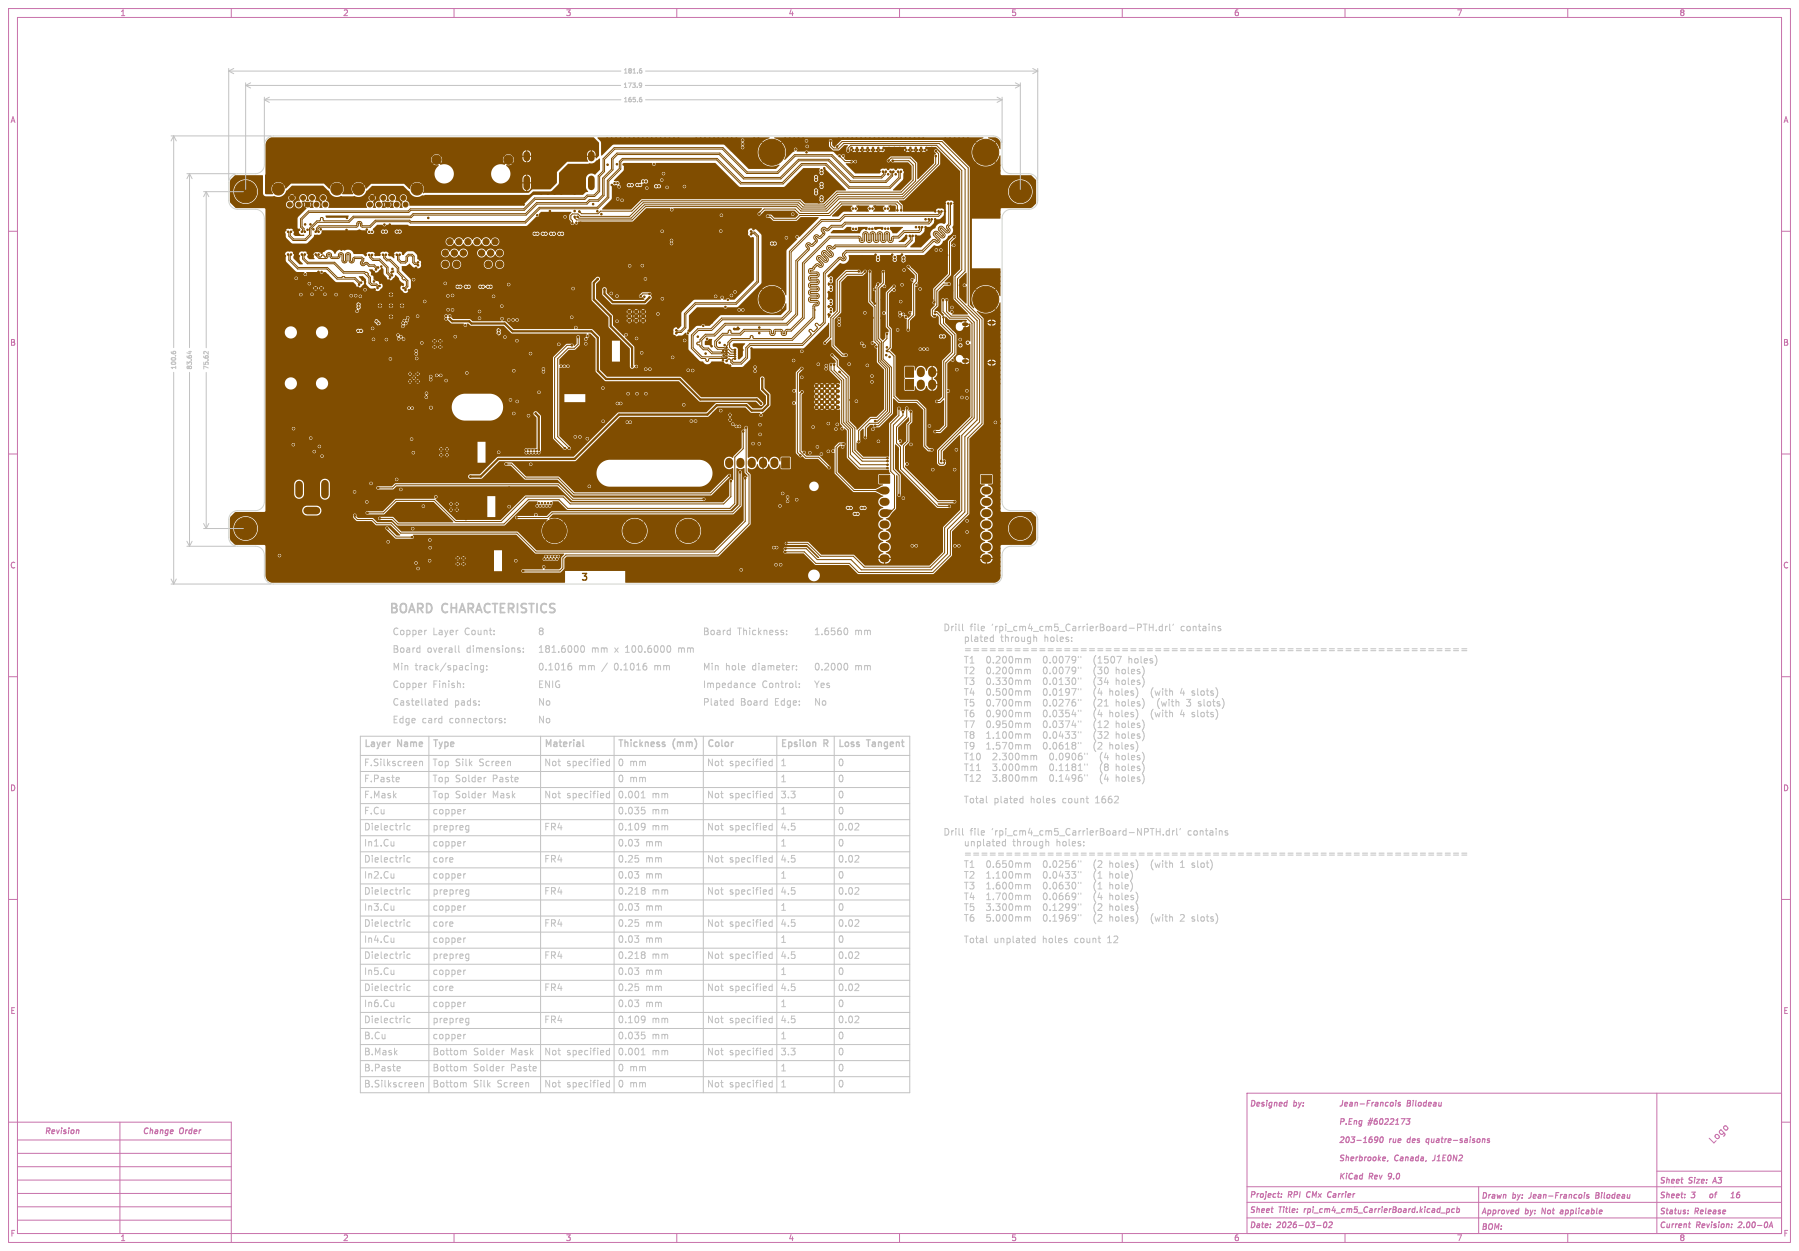
[picture p64: page 3]

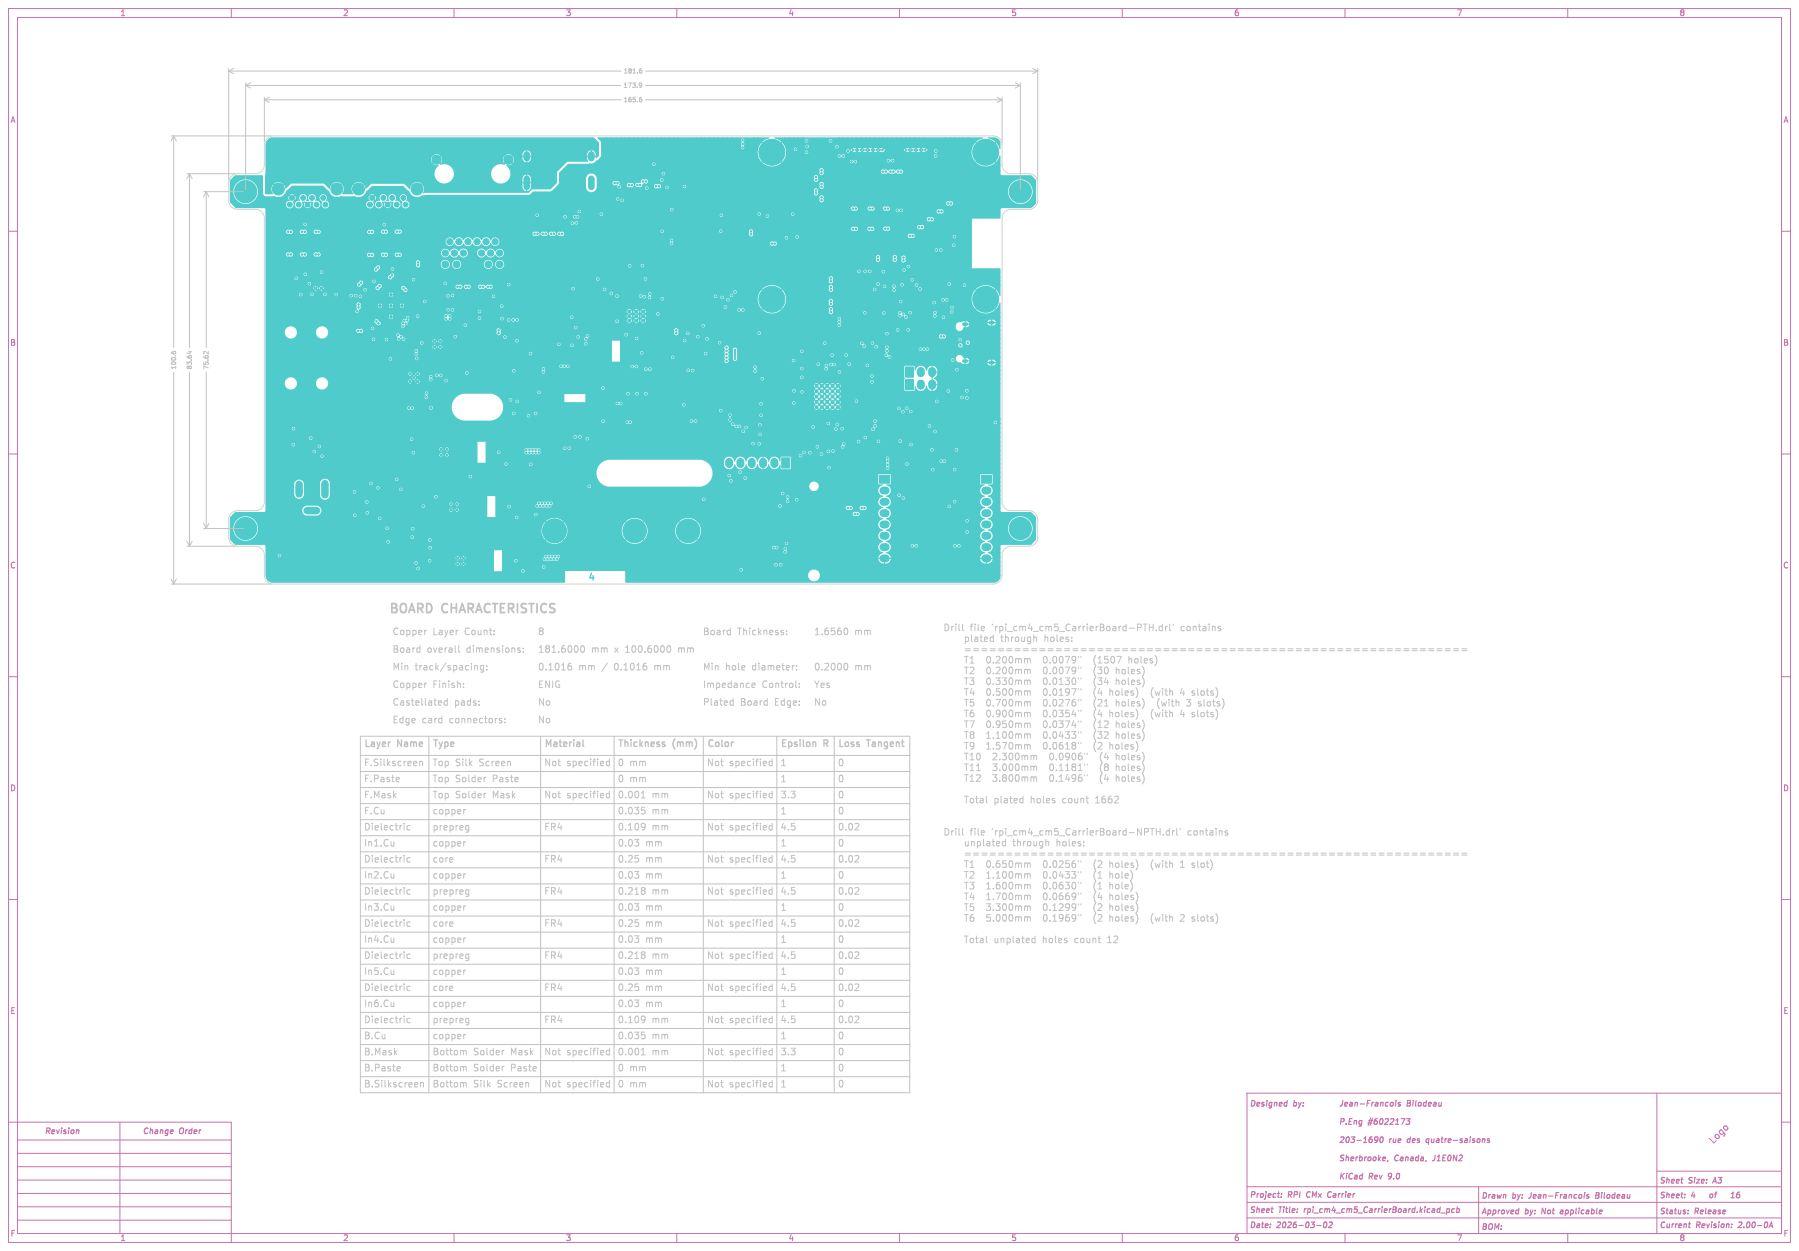
[picture p65: page 4]
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

Not specified | | Impedance Control: 3.3 ENIG | Yes 0.218 mm 1

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

prepreg | | 0.109 mm | | | Loss Tangent 1
Top Silk Screen | | 0 mm | | 1 | 0

Type | FR4 | 0.03 mm | Not specified FR4 | 1 | 0 Not specified

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

In1.Cu | | | prepreg Bottom Silk Screen | Not specified FR4 | 0.218 mm | | 4.5 | 0.02

copper core | | 0.25 mm | | 4.5 | 0 0.02

In3.Cu | | | | | 0.03 mm | | | 0 Dielectric Dielectric 0

In4.Cu | | | copper | | 0.03 mm | Not specified | 4.5 Not specified 1

Dielectric | | | | | 0.25 mm | | | 0.02

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

0.109 mm | | | 0 Bottom Solder Mask 0.02

0.035 mm | | | 0
0.001 mm | | | 0

Bottom Solder Paste | | | 0 mm | | 1 | 0

P.Eng #6022173

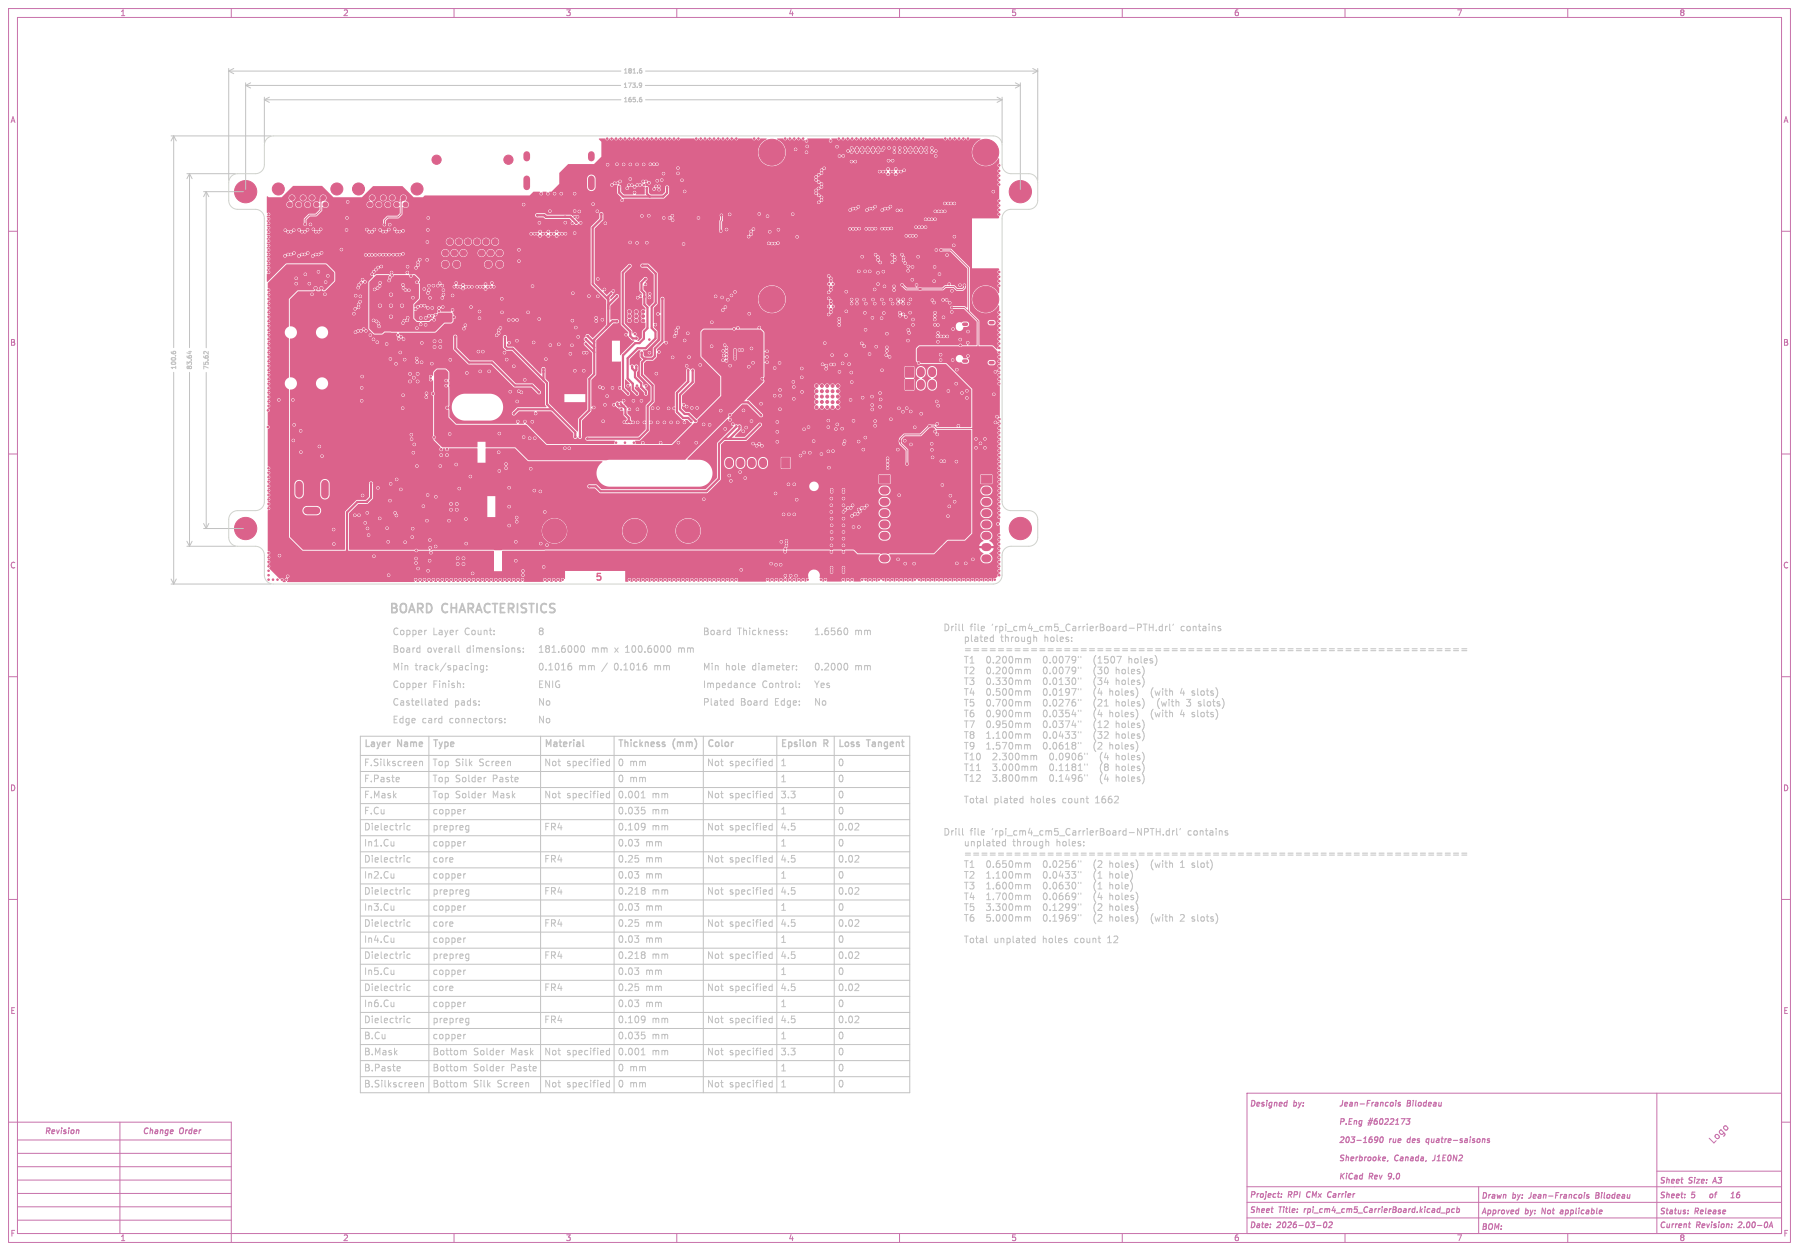
[picture p66: page 5]
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

Not specified | | Impedance Control: 3.3 ENIG | Yes 0.218 mm 1

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

prepreg | | 0.109 mm | | | Loss Tangent 1
Top Silk Screen | | 0 mm | | 1 | 0

Type | FR4 | 0.03 mm | Not specified FR4 | 1 | 0 Not specified

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

In1.Cu | | | prepreg Bottom Silk Screen | Not specified FR4 | 0.218 mm | | 4.5 | 0.02

copper core | | 0.25 mm | | 4.5 | 0 0.02

In3.Cu | | | | | 0.03 mm | | | 0 Dielectric Dielectric 0

In4.Cu | | | copper | | 0.03 mm | Not specified | 4.5 Not specified 1

Dielectric | | | | | 0.25 mm | | | 0.02

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

0.109 mm | | | 0 Bottom Solder Mask 0.02

0.035 mm | | | 0
0.001 mm | | | 0

Bottom Solder Paste | | 0 mm | | 1 | 0

P.Eng #6022173

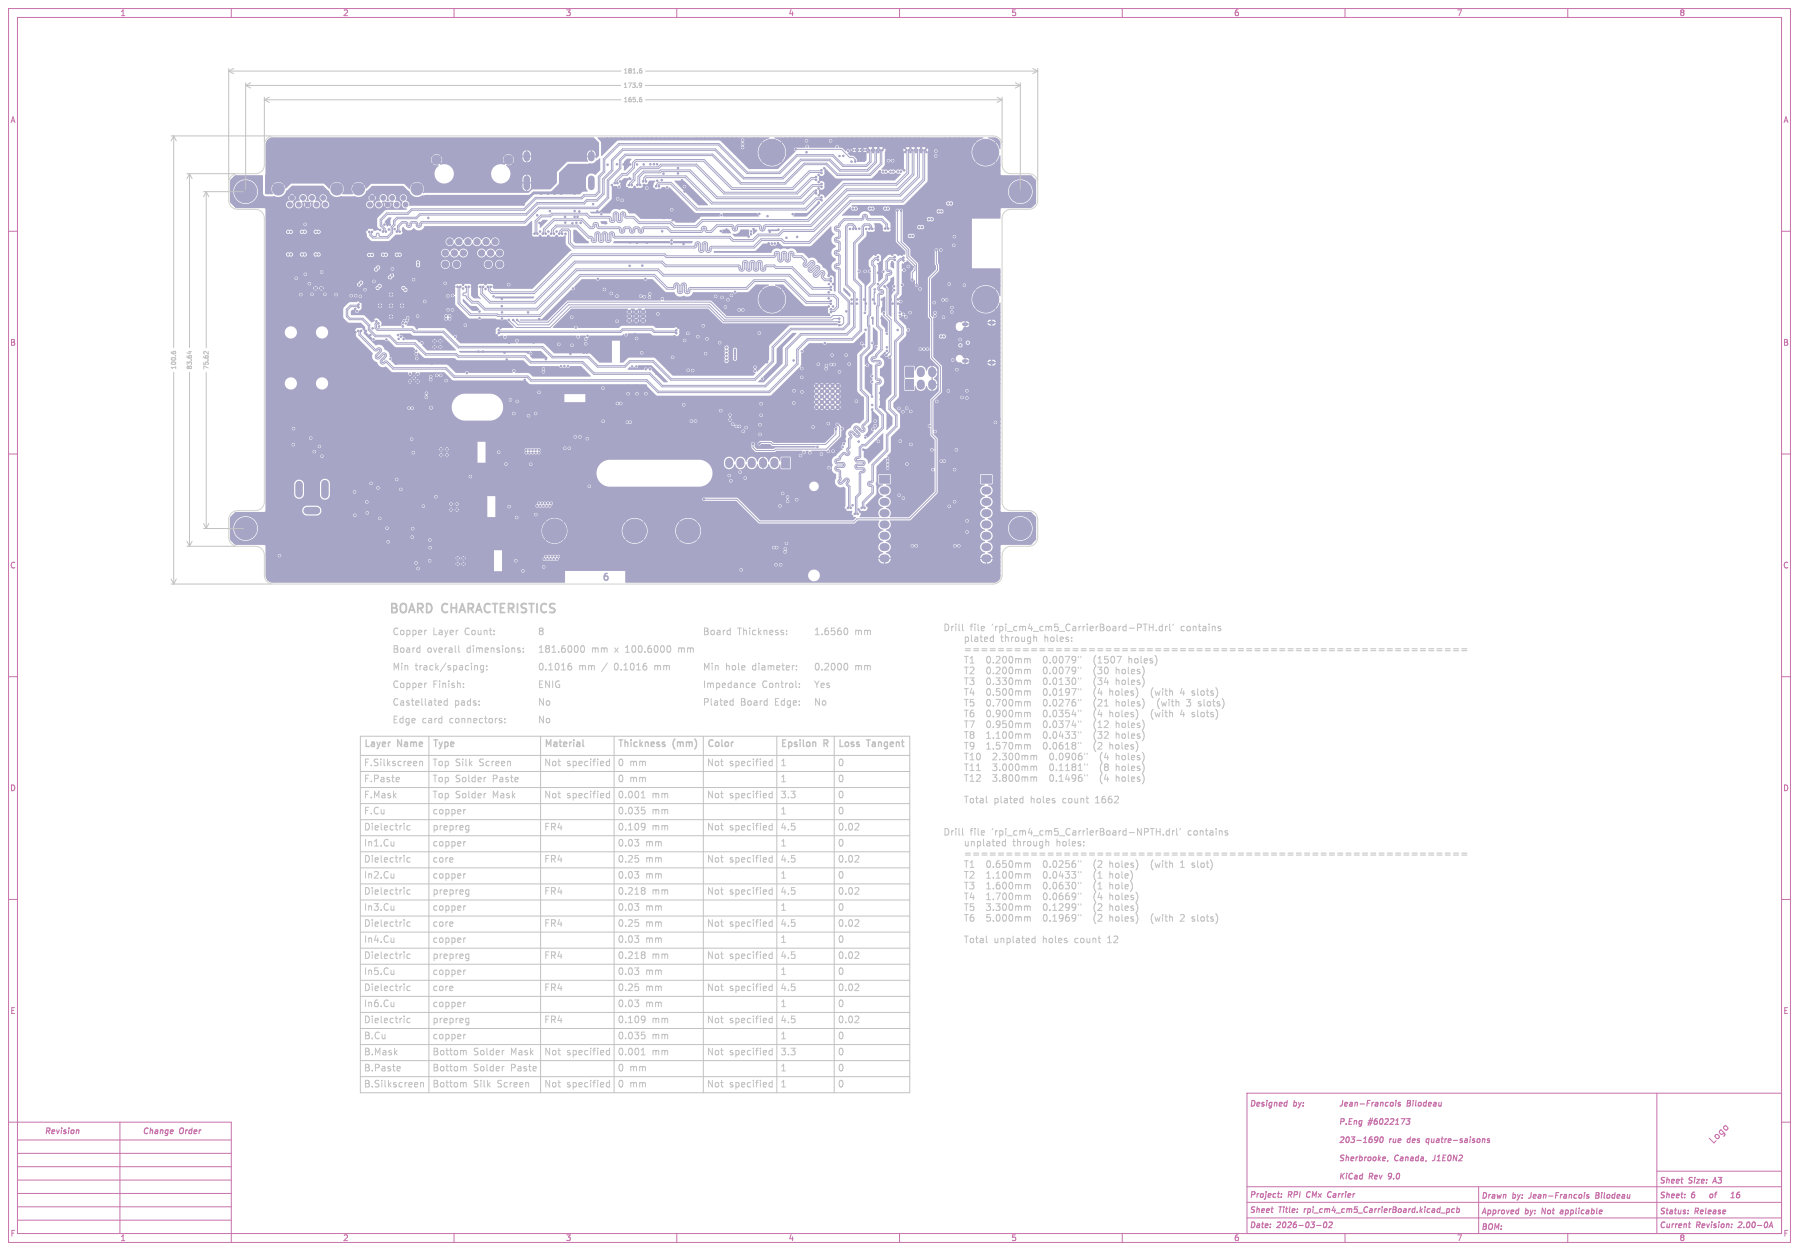
[picture p67: page 6]

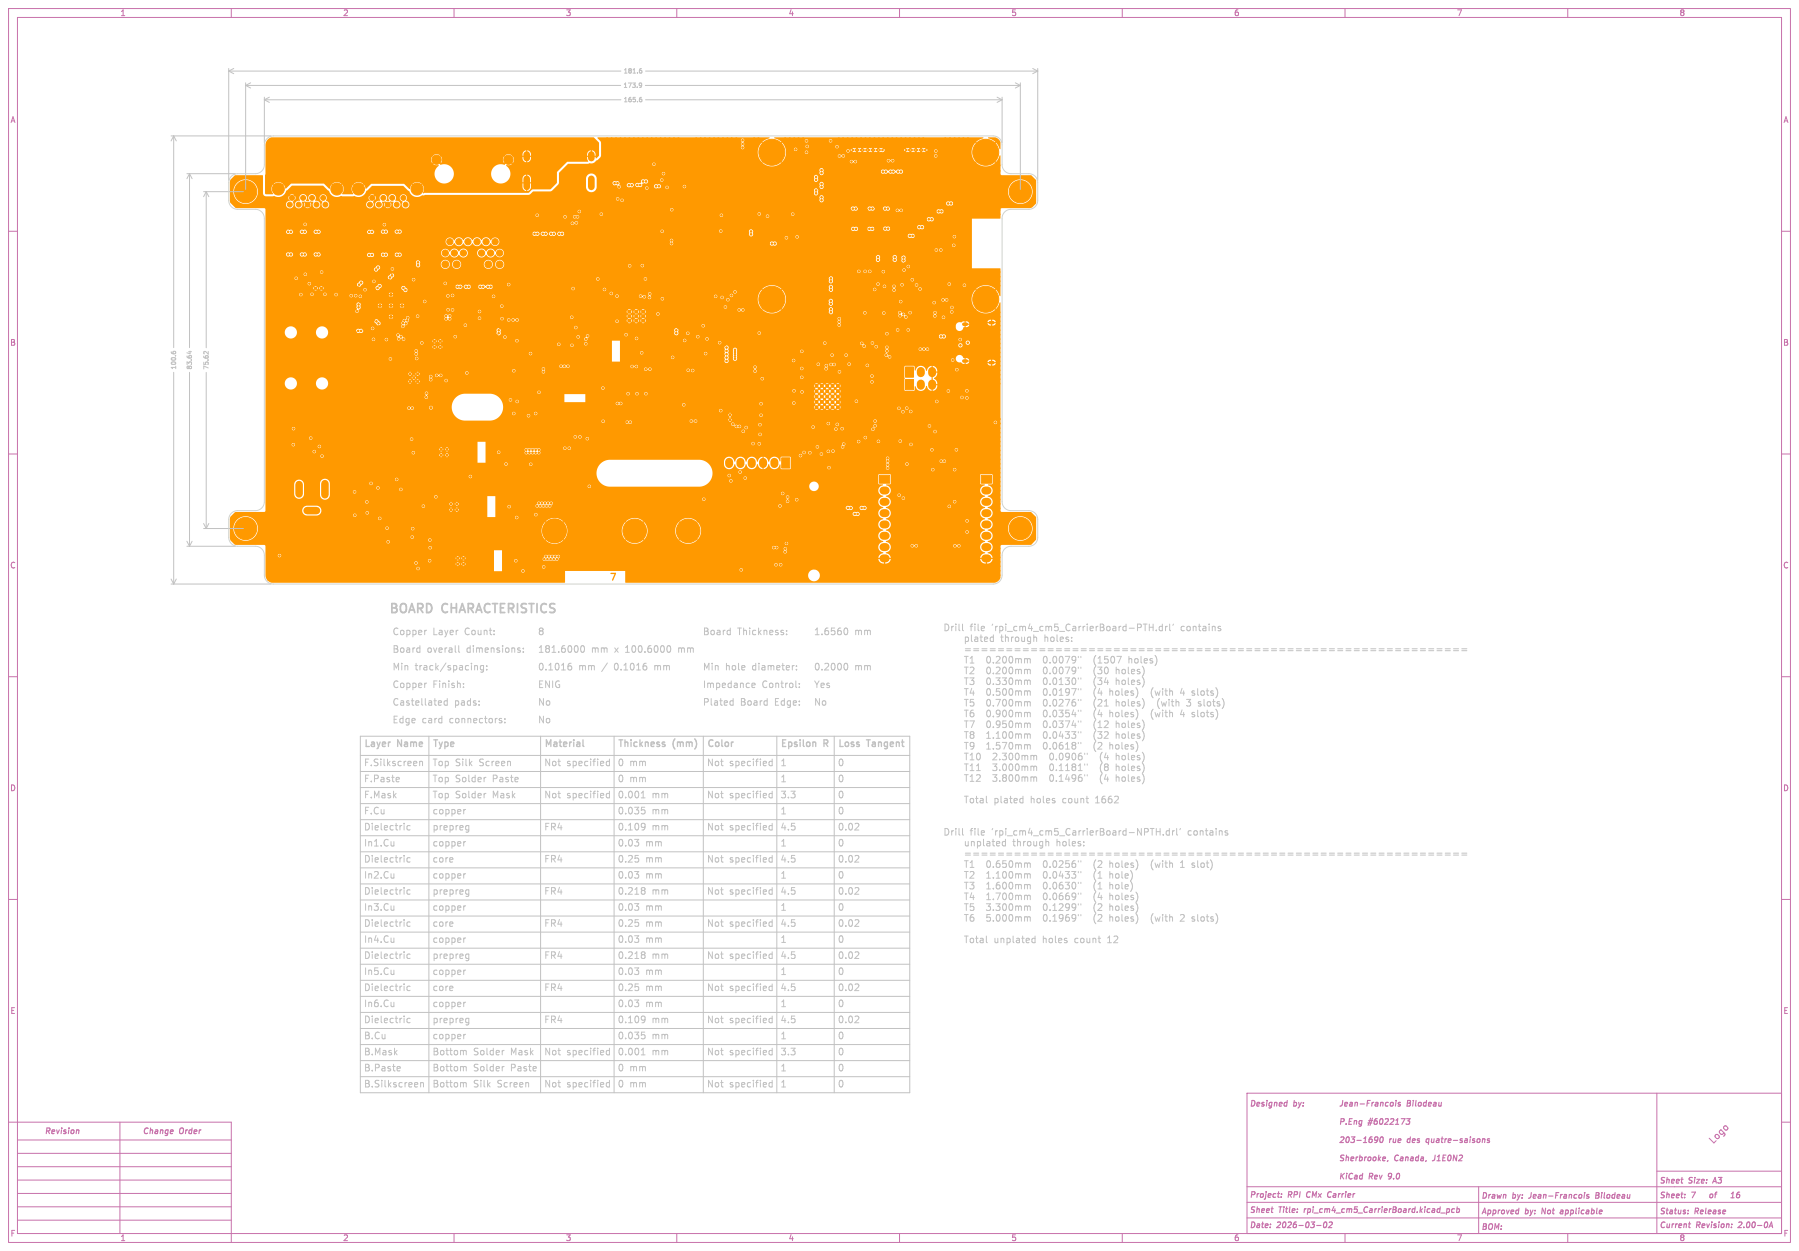
[picture p68: page 7]
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

Not specified | | Impedance Control: 3.3 ENIG | Yes 0.218 mm 1

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

prepreg | | 0.109 mm | | | Loss Tangent 1
Top Silk Screen | | 0 mm | | 1 | 0

Type | FR4 | 0.03 mm | Not specified FR4 | 1 | 0 Not specified

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

In1.Cu | | | prepreg Bottom Silk Screen | Not specified FR4 | 0.218 mm | | 4.5 | 0.02

copper core | | 0.25 mm | | 4.5 | 0 0.02

In3.Cu | | | | | 0.03 mm | | | 0 Dielectric Dielectric 0

In4.Cu | | | copper | | 0.03 mm | Not specified | 4.5 Not specified 1

Dielectric | | | | | 0.25 mm | | | 0.02

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

0.109 mm | | | 0 Bottom Solder Mask 0.02

0.035 mm | | | 0
0.001 mm | | | 0

Bottom Solder Paste | | | 0 mm | | 1 | 0

P.Eng #6022173

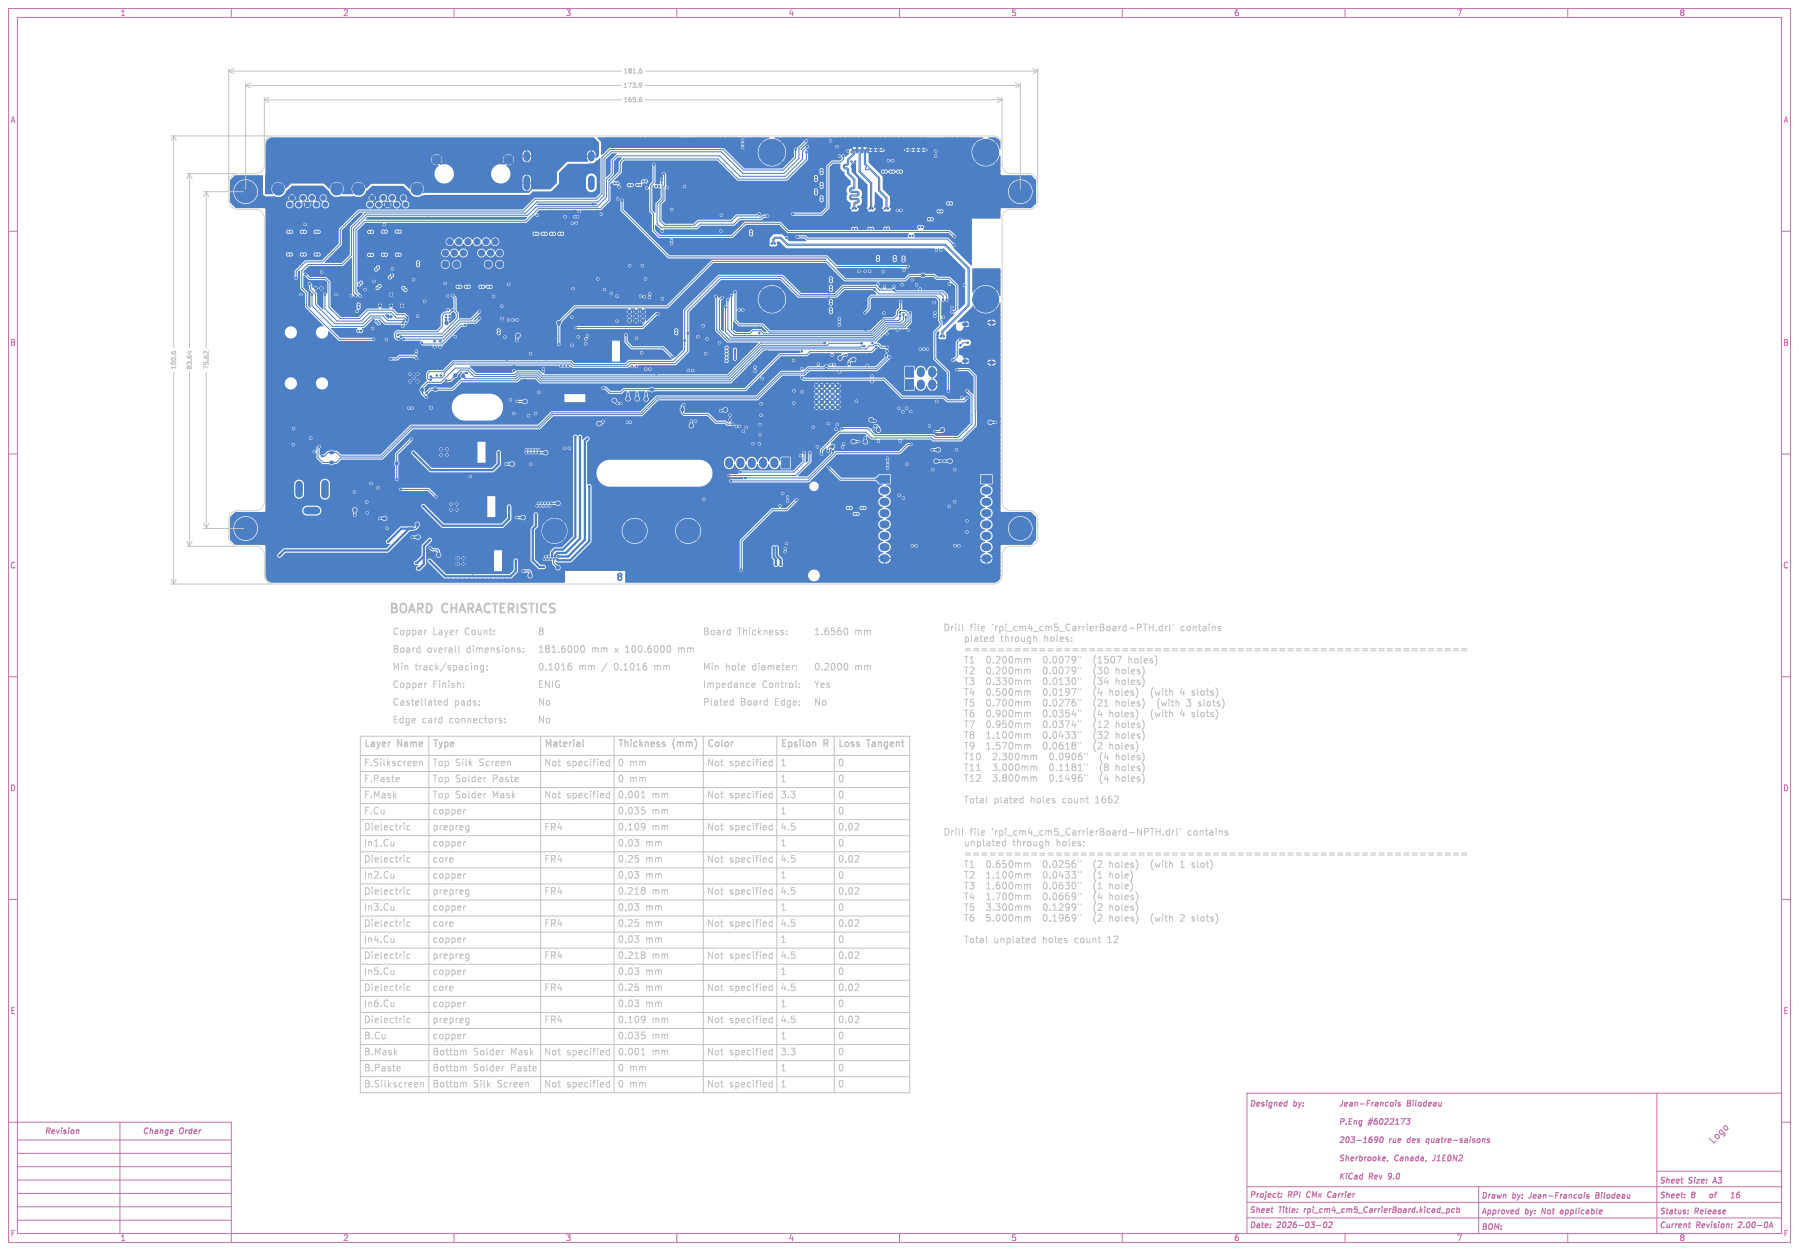
[picture p69: page 8]

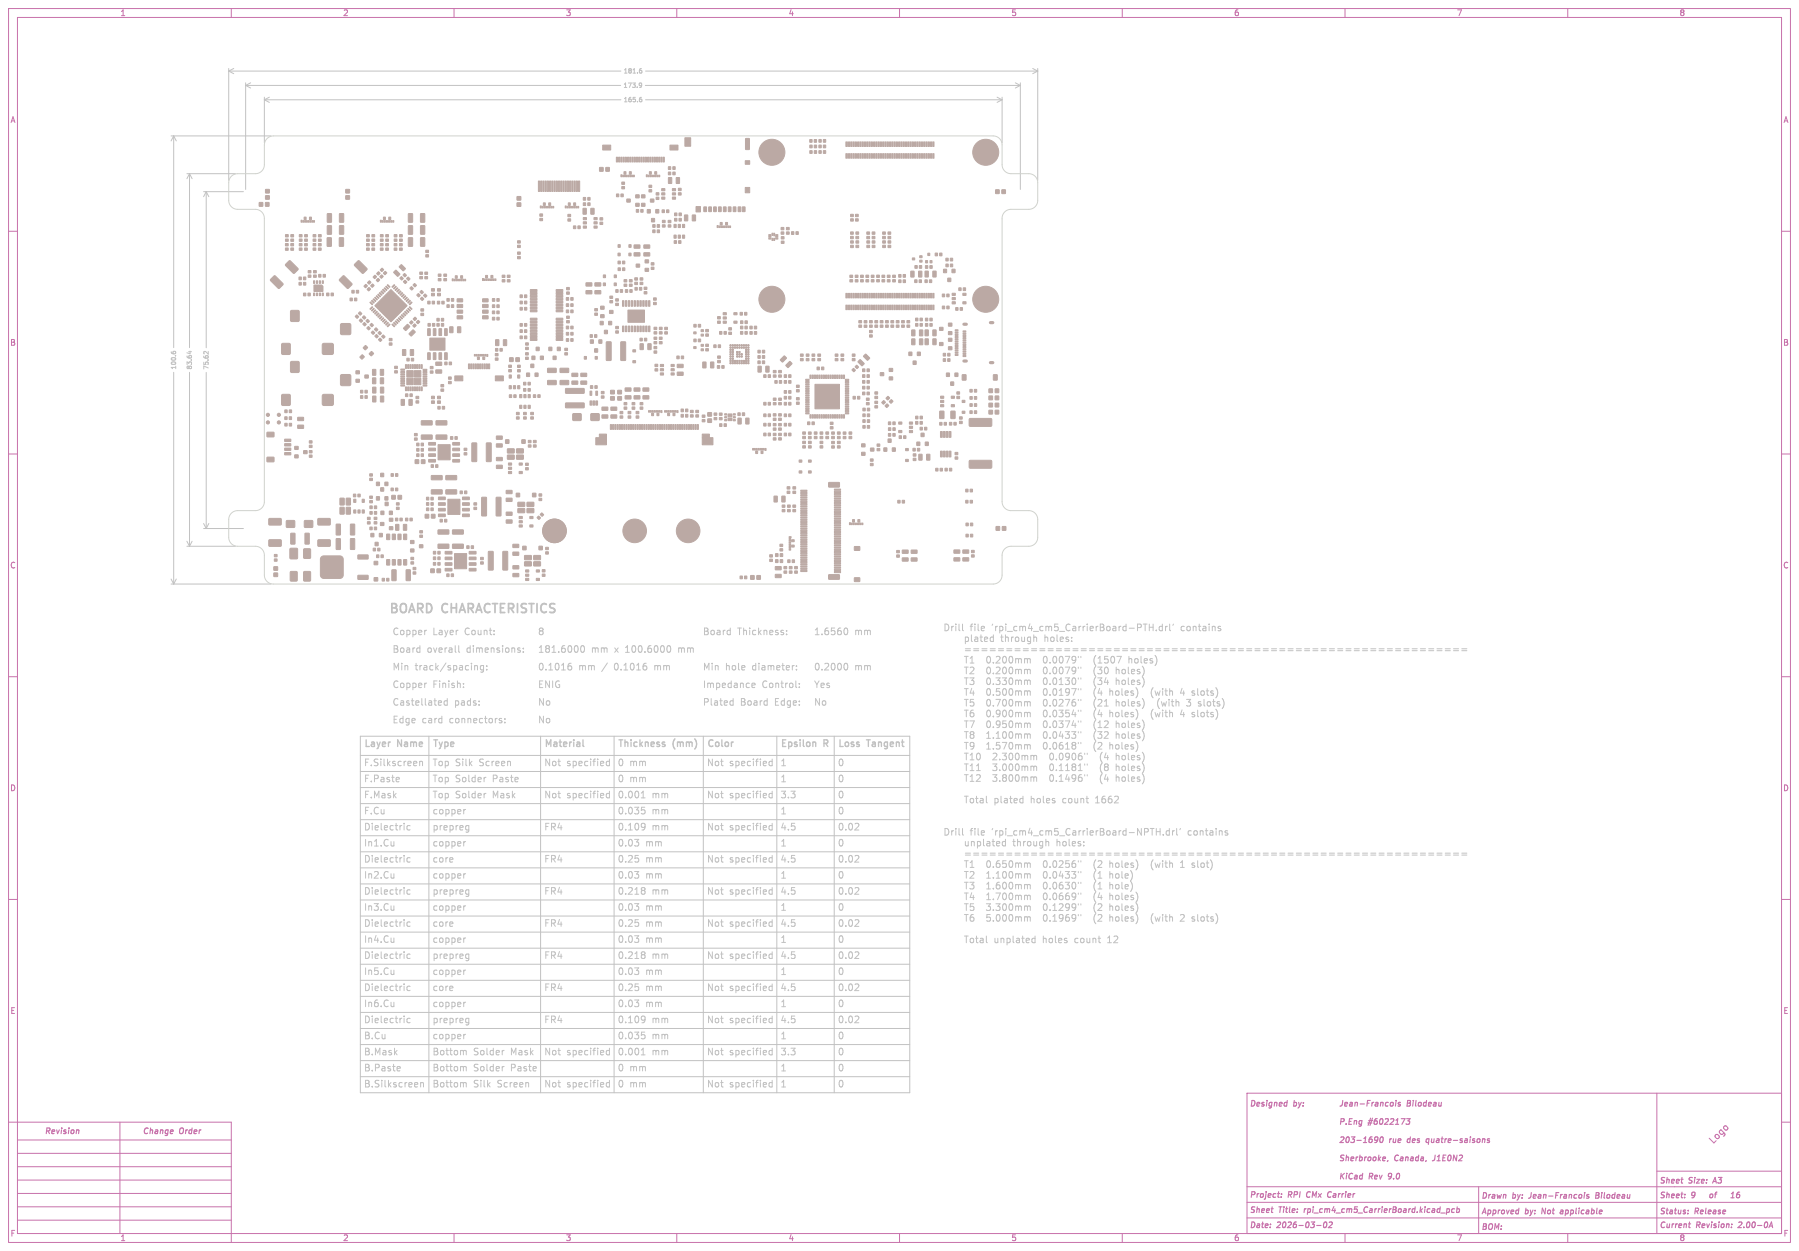
[picture p70: page 9]
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

F.MaskCopper Finish: Edge card connectors: Layer Name | | FR4 | | | Epsilon R | 0.02
copper Castellated pads: | | 0.001 mm | Not specified

Not specified | | Impedance Control: 3.3 ENIG | Yes 0.218 mm 1

prepreg | | 0.109 mm | | | Loss Tangent 1
Top Silk Screen | | 0 mm | | 1 | 0

Type | FR4 | 0.03 mm | Not specified FR4 | 1 | 0 Not specified

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

In1.Cu | prepreg Bottom Silk Screen | Not specified FR4 | 0.218 mm | | 4.5 | 0.02

copper core | | 0.25 mm | | 4.5 | 0 0.02

In3.Cu | | | 0.03 mm | | | 0 Dielectric Dielectric 0

In4.Cu | copper | | 0.03 mm | Not specified | 4.5 Not specified 1

Dielectric | | | 0.25 mm | | | 0.02

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

0.109 mm | | | 0 Bottom Solder Mask 0.02

0.035 mm | | | 0
0.001 mm | | | 0

Bottom Solder Paste | | 0 mm | | 1 | 0

P.Eng #6022173

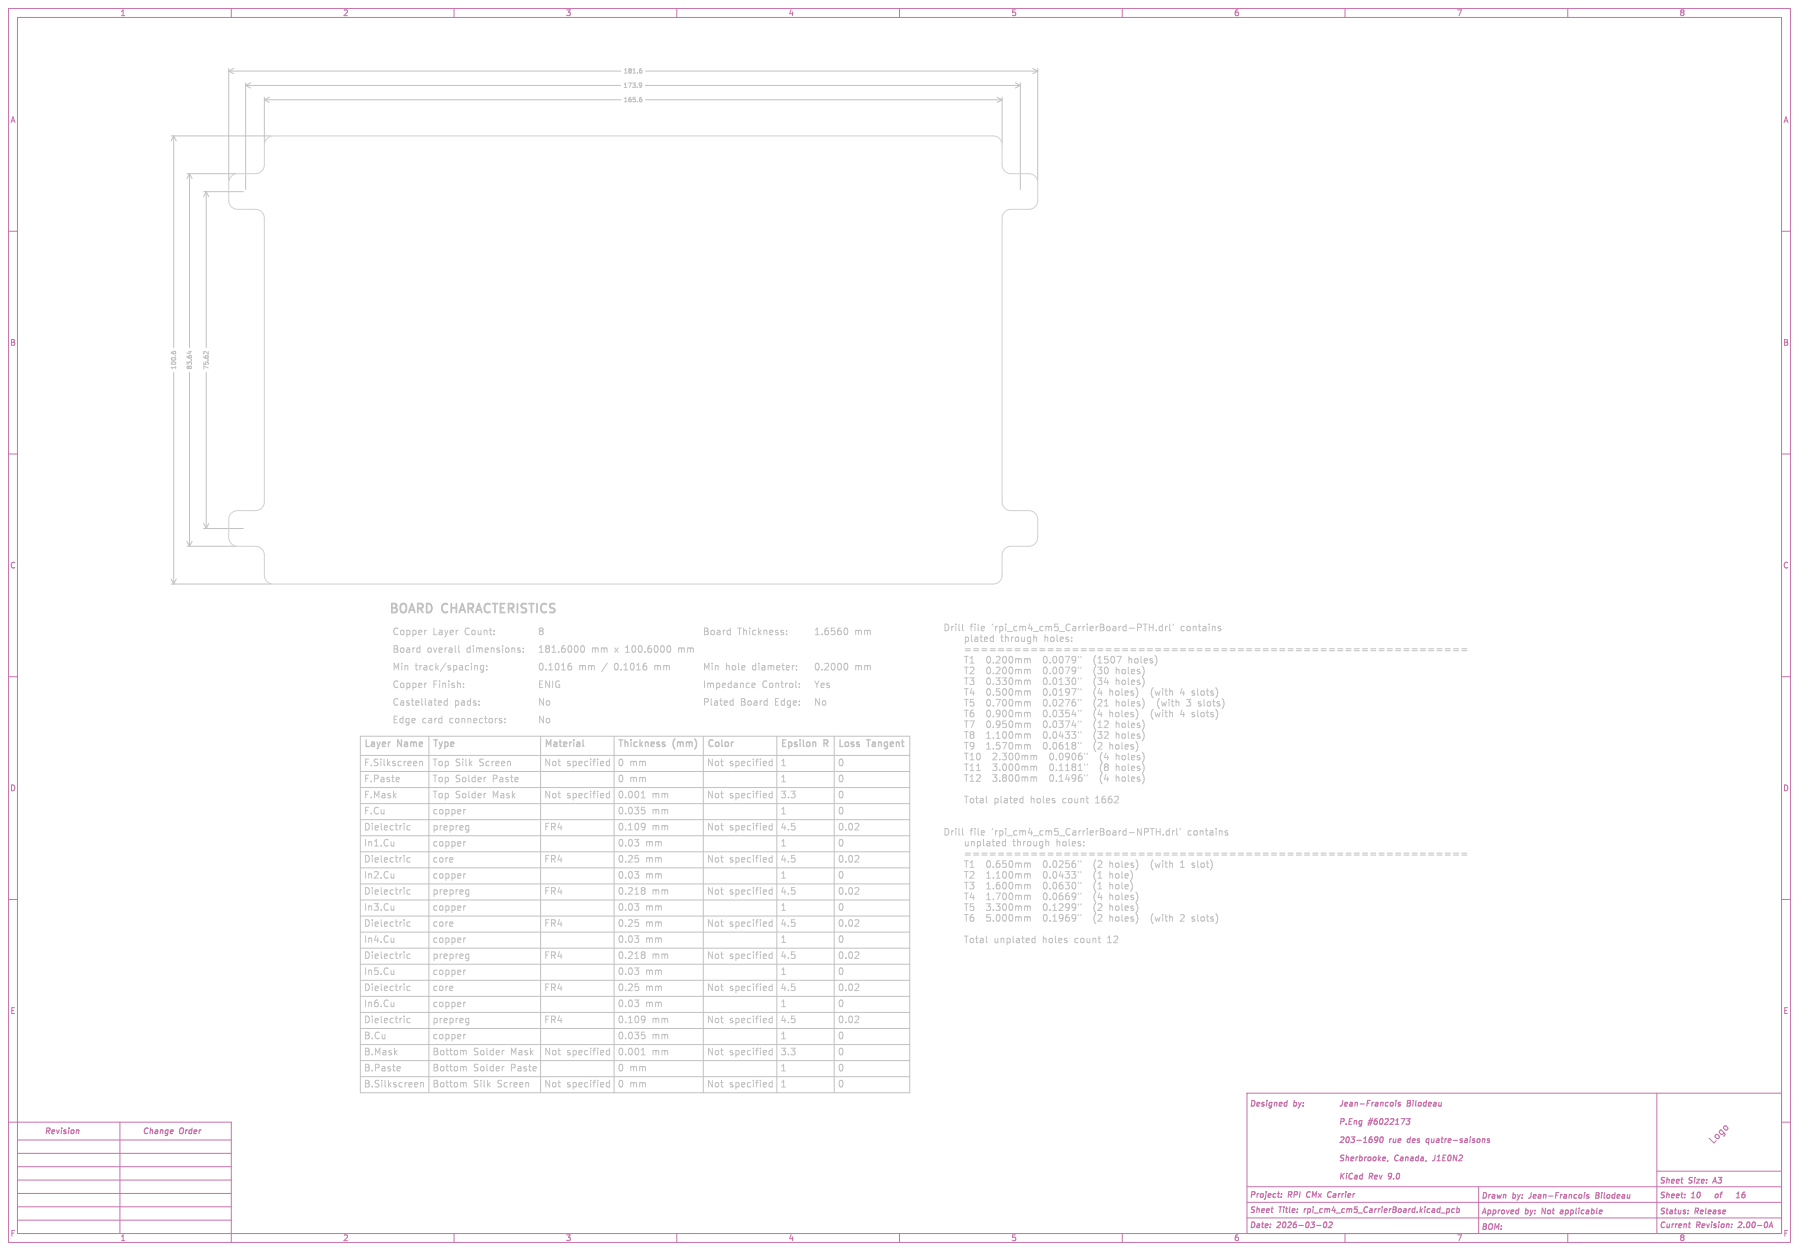
[picture p71: page 10]
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

F.MaskCopper Edge card Layer Name | Finish: connectors: | FR4 | | | Epsilon R | 0.02
copper Castellated pads: | | | 0.001 mm | Not specified

Not specified | | Impedance Control: 3.3 ENIG | Yes 0.218 mm 1

prepreg | | 0.109 mm | | | Loss Tangent 1
Top Silk Screen | | 0 mm | | 1 | 0

Type | FR4 | 0.03 mm | Not specified FR4 | 1 | 0 Not specified

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

In1.Cu | prepreg Bottom Silk Screen | Not specified FR4 | 0.218 mm | | 4.5 | 0.02

copper core | | 0.25 mm | | 4.5 | 0 0.02

In3.Cu | | | 0.03 mm | | | | 0 Dielectric Dielectric 0

In4.Cu | copper | | 0.03 mm | Not specified | 4.5 Not specified 1

Dielectric | | | 0.25 mm | | | | 0.02

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

0.109 mm | | | 0 Bottom Solder Mask 0.02

0.035 mm | | | 0
0.001 mm | | | 0

Bottom Solder Paste | | | 0 mm | | 1 | 0

P.Eng #6022173

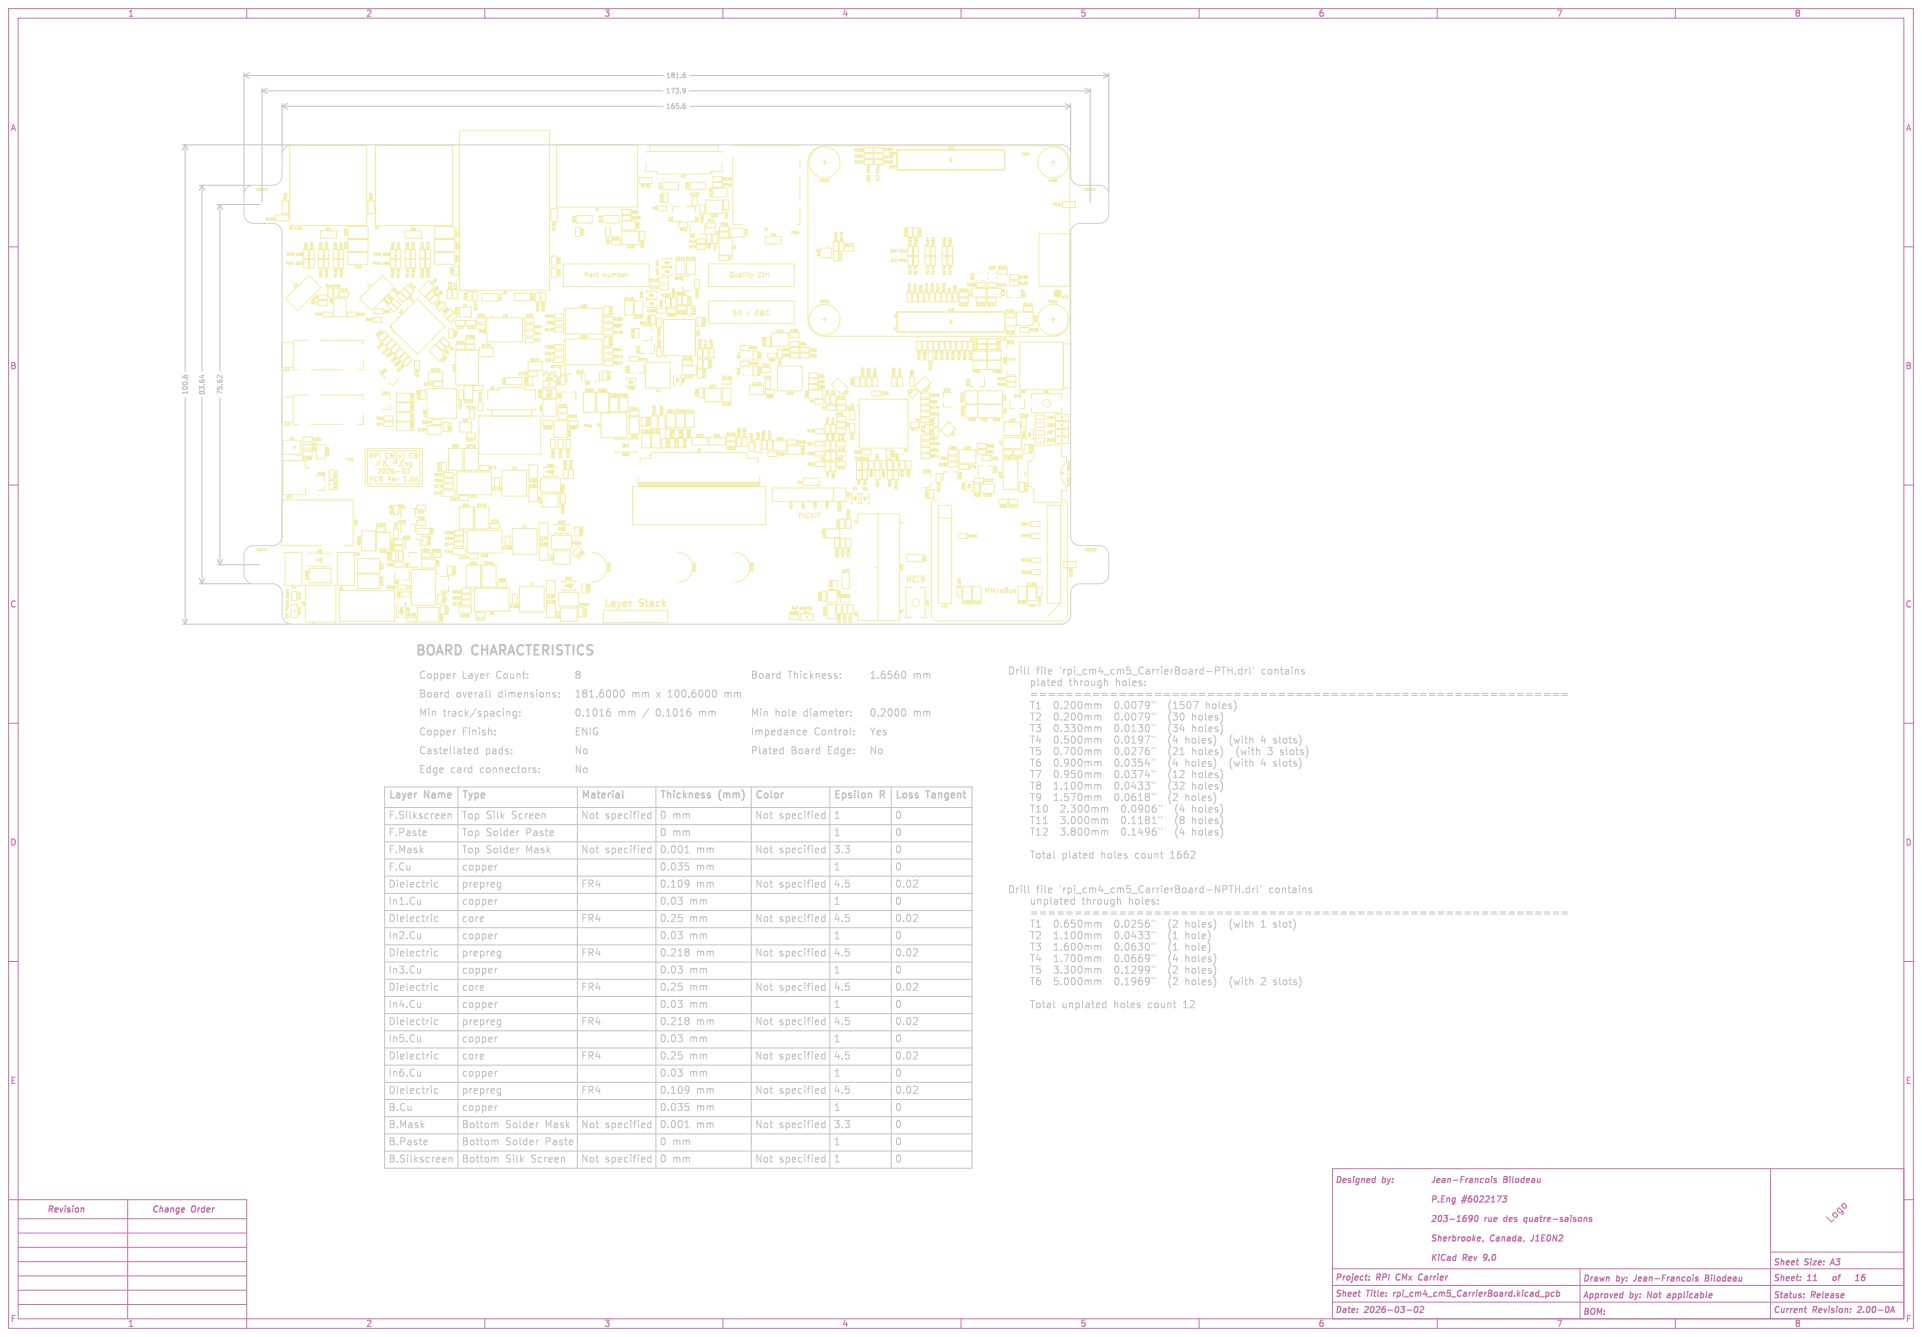
[picture p72: page 11]

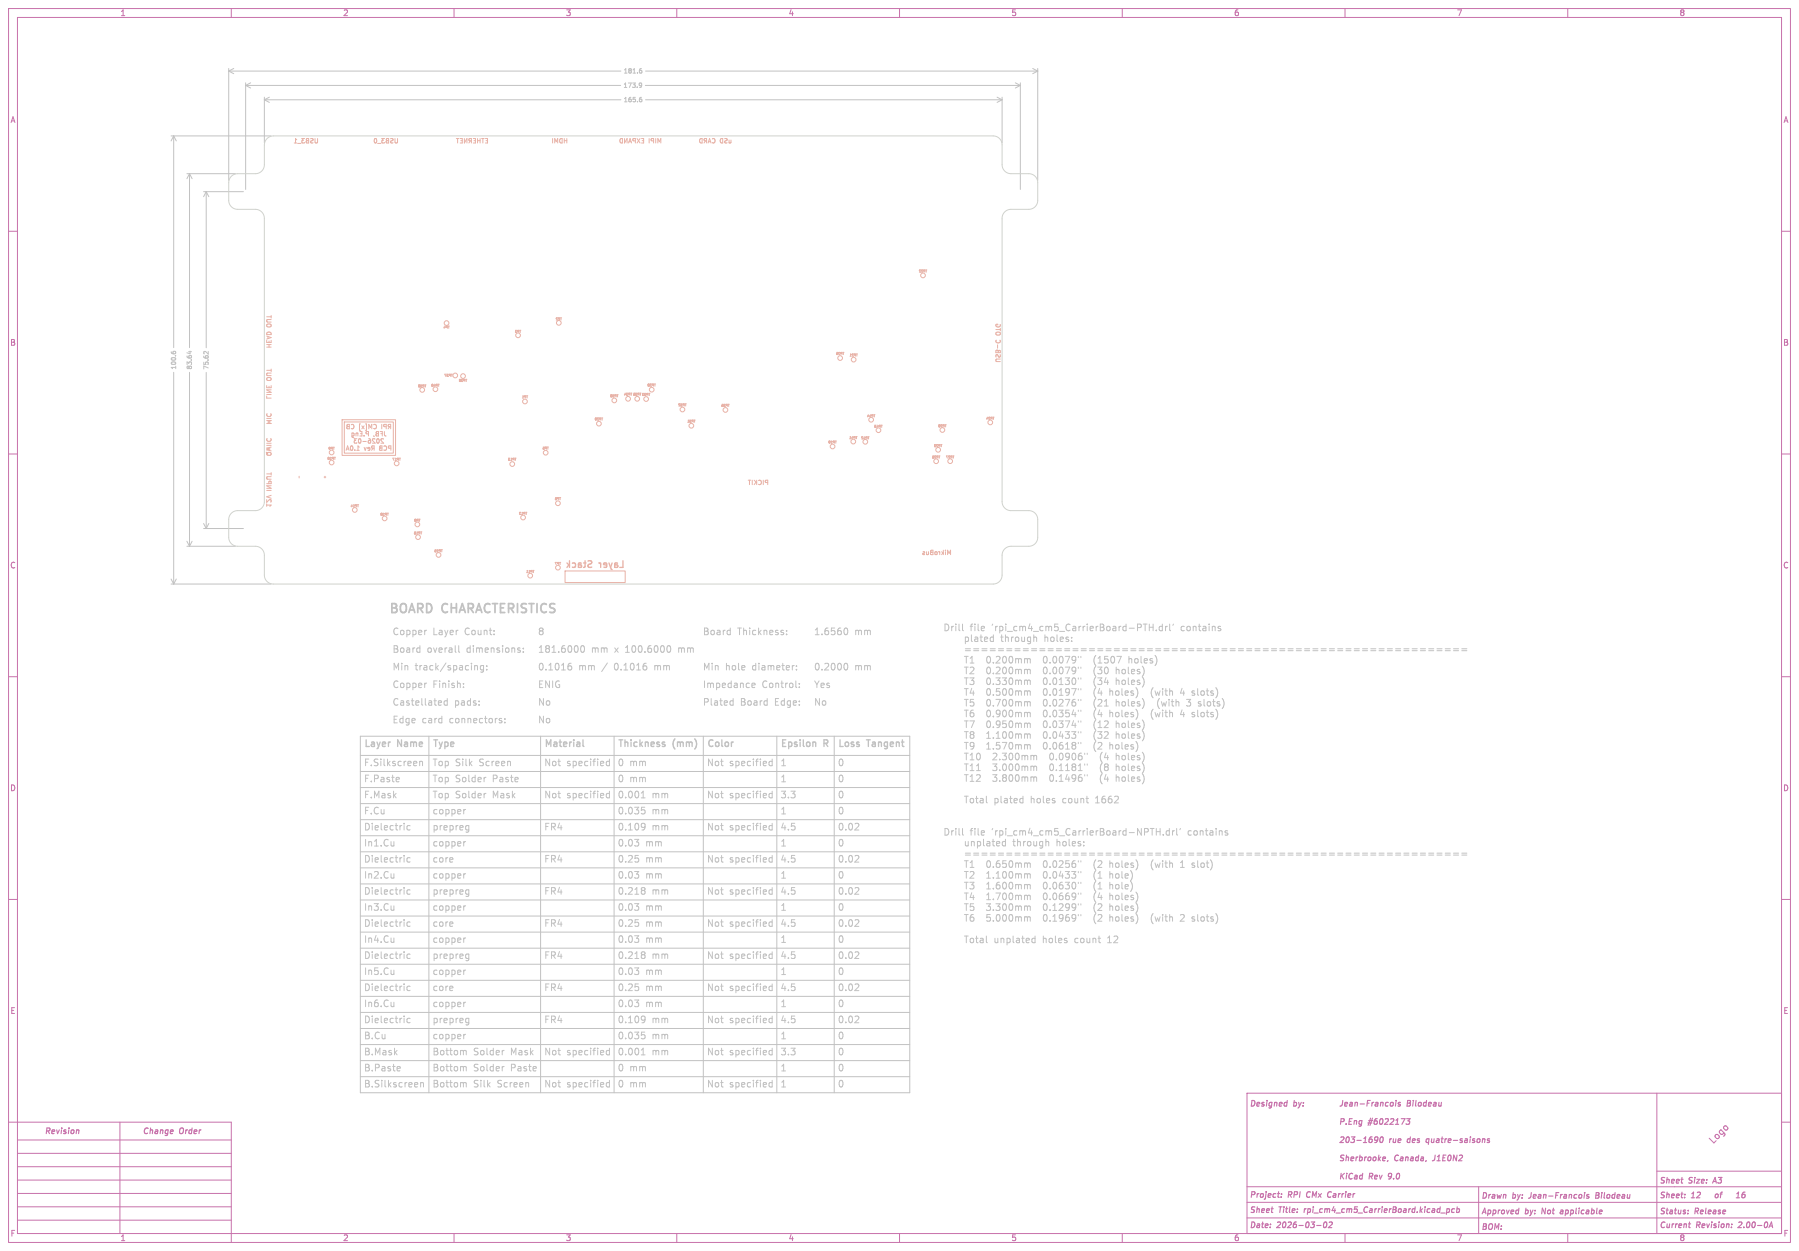
[picture p73: page 12]

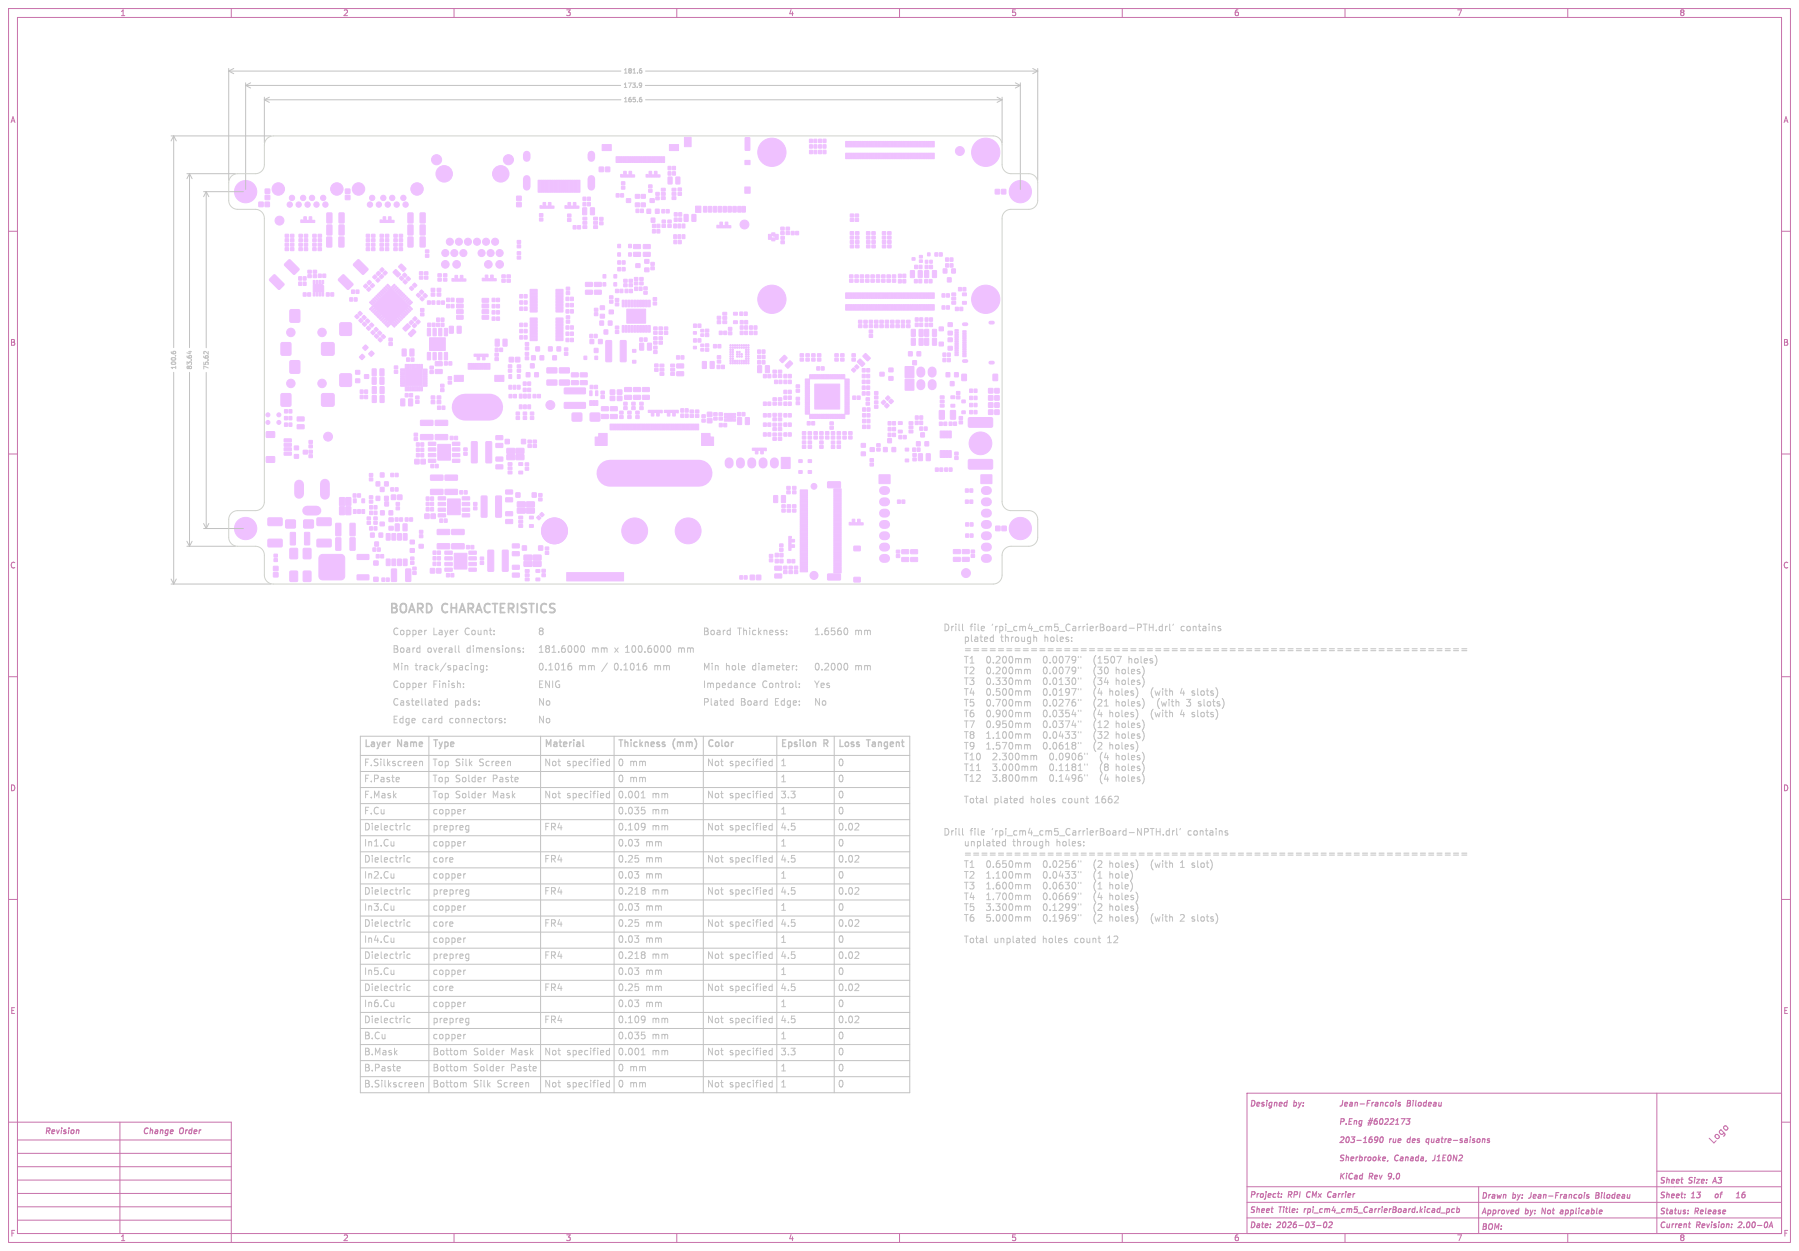
[picture p74: page 13]

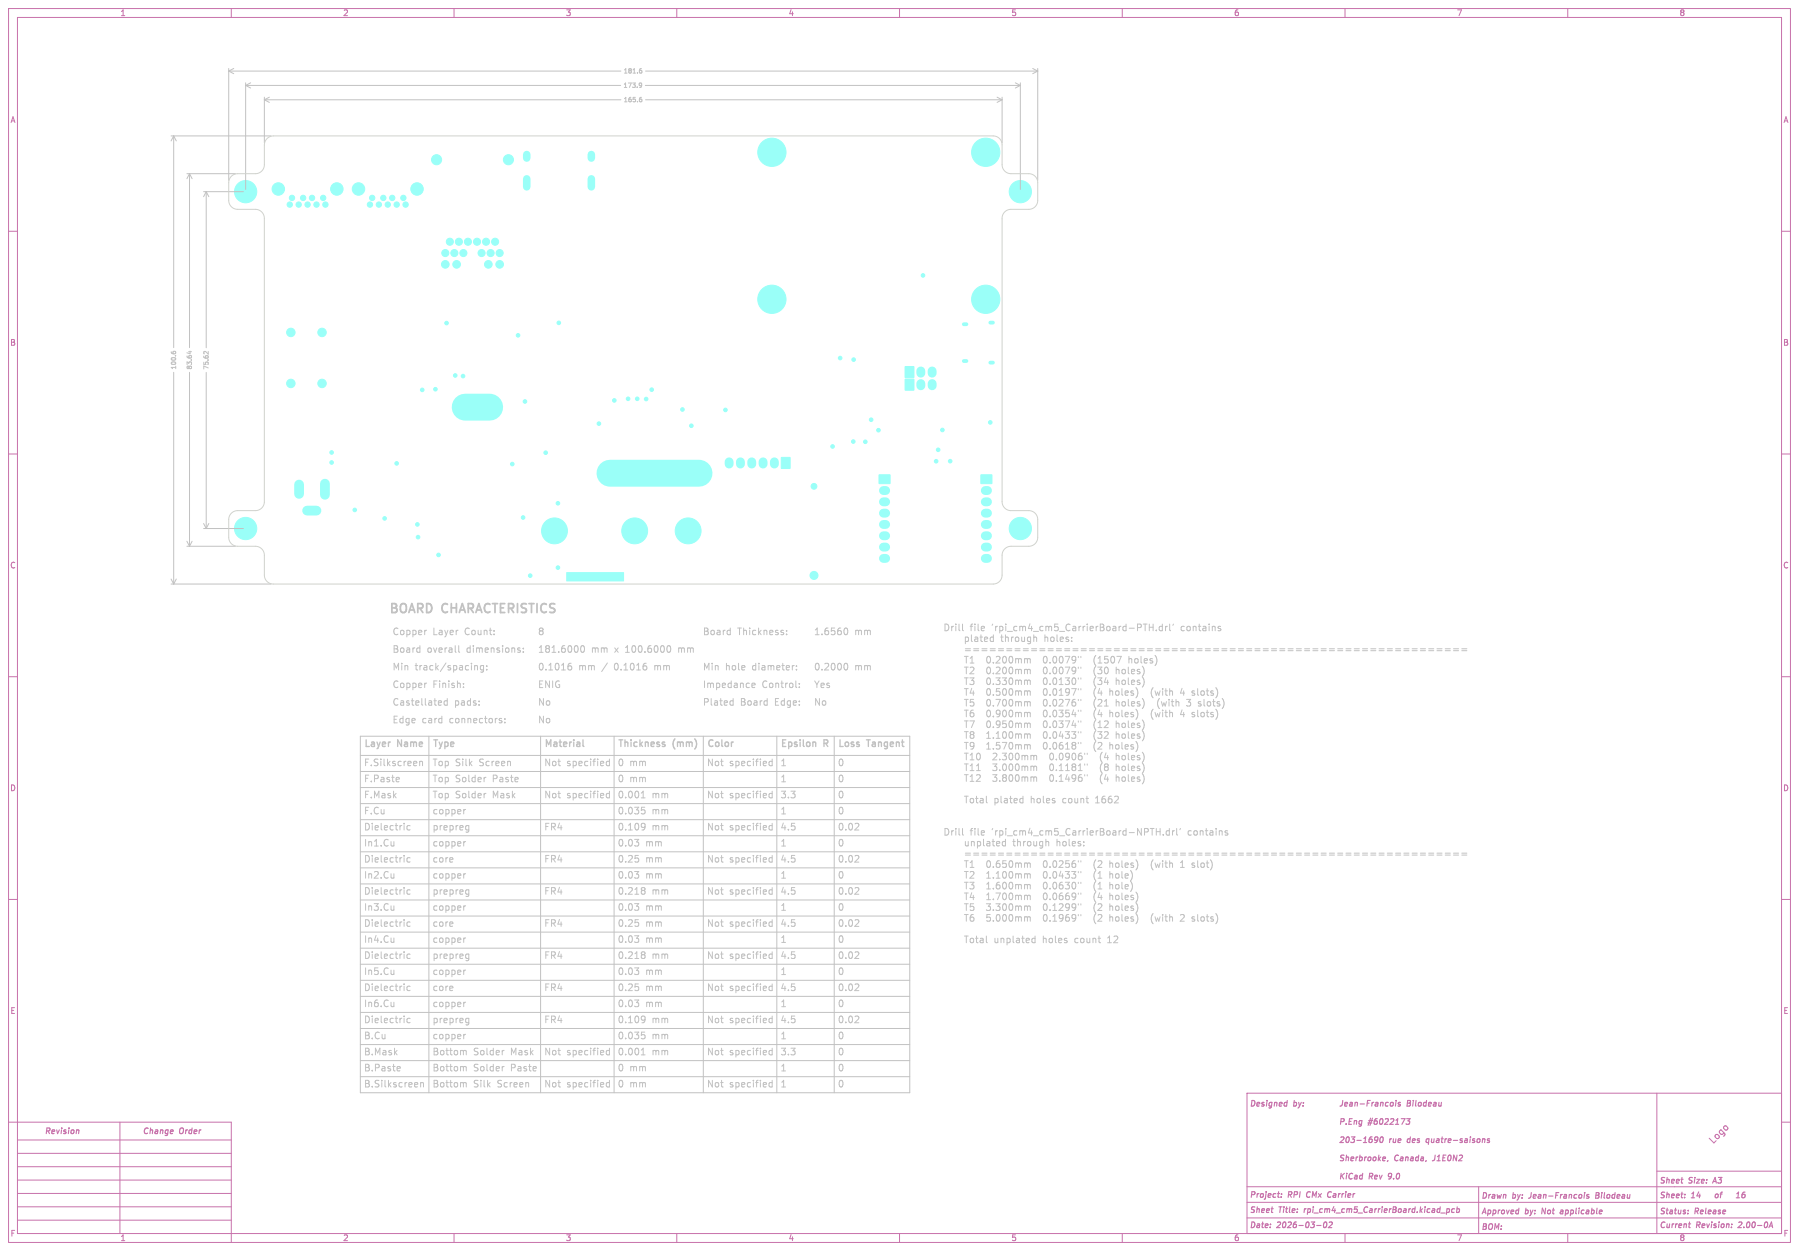
[picture p75: page 14]
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

Not specified | | Impedance Control: 3.3 ENIG | Yes 0.218 mm 1

prepreg | | 0.109 mm | | | Loss Tangent 1
Top Silk Screen | | 0 mm | | 1 | 0

Type | FR4 | 0.03 mm | Not specified FR4 | 1 | 0 Not specified

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

In1.Cu | prepreg Bottom Silk Screen | Not specified FR4 | 0.218 mm | | 4.5 | 0.02

copper core | | 0.25 mm | | 4.5 | 0 0.02

In3.Cu | | | 0.03 mm | | | | 0 Dielectric Dielectric 0

In4.Cu | copper | | 0.03 mm | Not specified | 4.5 Not specified 1

Dielectric | | | 0.25 mm | | | | 0.02

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

0.109 mm | | | 0 Bottom Solder Mask 0.02

0.035 mm | | | 0
0.001 mm | | | 0

Bottom Solder Paste | | | 0 mm | | 1 | 0

P.Eng #6022173

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

Not specified | | Impedance Control: 3.3 ENIG | Yes 0.218 mm 1

prepreg | | 0.109 mm | | | Loss Tangent 1
Top Silk Screen | | 0 mm | | 1 | 0

Type | FR4 | 0.03 mm | Not specified FR4 | 1 | 0 Not specified

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

In1.Cu | prepreg Bottom Silk Screen | Not specified FR4 | 0.218 mm | | 4.5 | 0.02

copper core | | 0.25 mm | | 4.5 | 0 0.02

In3.Cu | | | 0.03 mm | | | | 0 Dielectric Dielectric 0

In4.Cu | copper | | 0.03 mm | Not specified | 4.5 Not specified 1

Dielectric | | | 0.25 mm | | | | 0.02

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

0.109 mm | | | 0 Bottom Solder Mask 0.02

0.035 mm | | | 0
0.001 mm | | | 0

Bottom Solder Paste | | | 0 mm | | 1 | 0

P.Eng #6022173

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

Not specified | | Impedance Control: 3.3 ENIG | Yes 0.218 mm 1

prepreg | | 0.109 mm | | | Loss Tangent 1
Top Silk Screen | | 0 mm | | 1 | 0

Type | FR4 | 0.03 mm | Not specified FR4 | 1 | 0 Not specified

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

In1.Cu | prepreg Bottom Silk Screen | Not specified FR4 | 0.218 mm | | 4.5 | 0.02

copper core | | 0.25 mm | | 4.5 | 0 0.02

In3.Cu | | | 0.03 mm | | | | 0 Dielectric Dielectric 0

In4.Cu | copper | | 0.03 mm | Not specified | 4.5 Not specified 1

Dielectric | | | 0.25 mm | | | | 0.02

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

0.109 mm | | | 0 Bottom Solder Mask 0.02

0.035 mm | | | 0
0.001 mm | | | 0

Bottom Solder Paste | | | 0 mm | | 1 | 0

P.Eng #6022173
