lecejeff/RPI_CMx_Carrier/hardware/Rev1_00-0a/output files/SCH_PDF/RPI_CMx_Carrier_2.00-0A_SCH_PDF.pdf

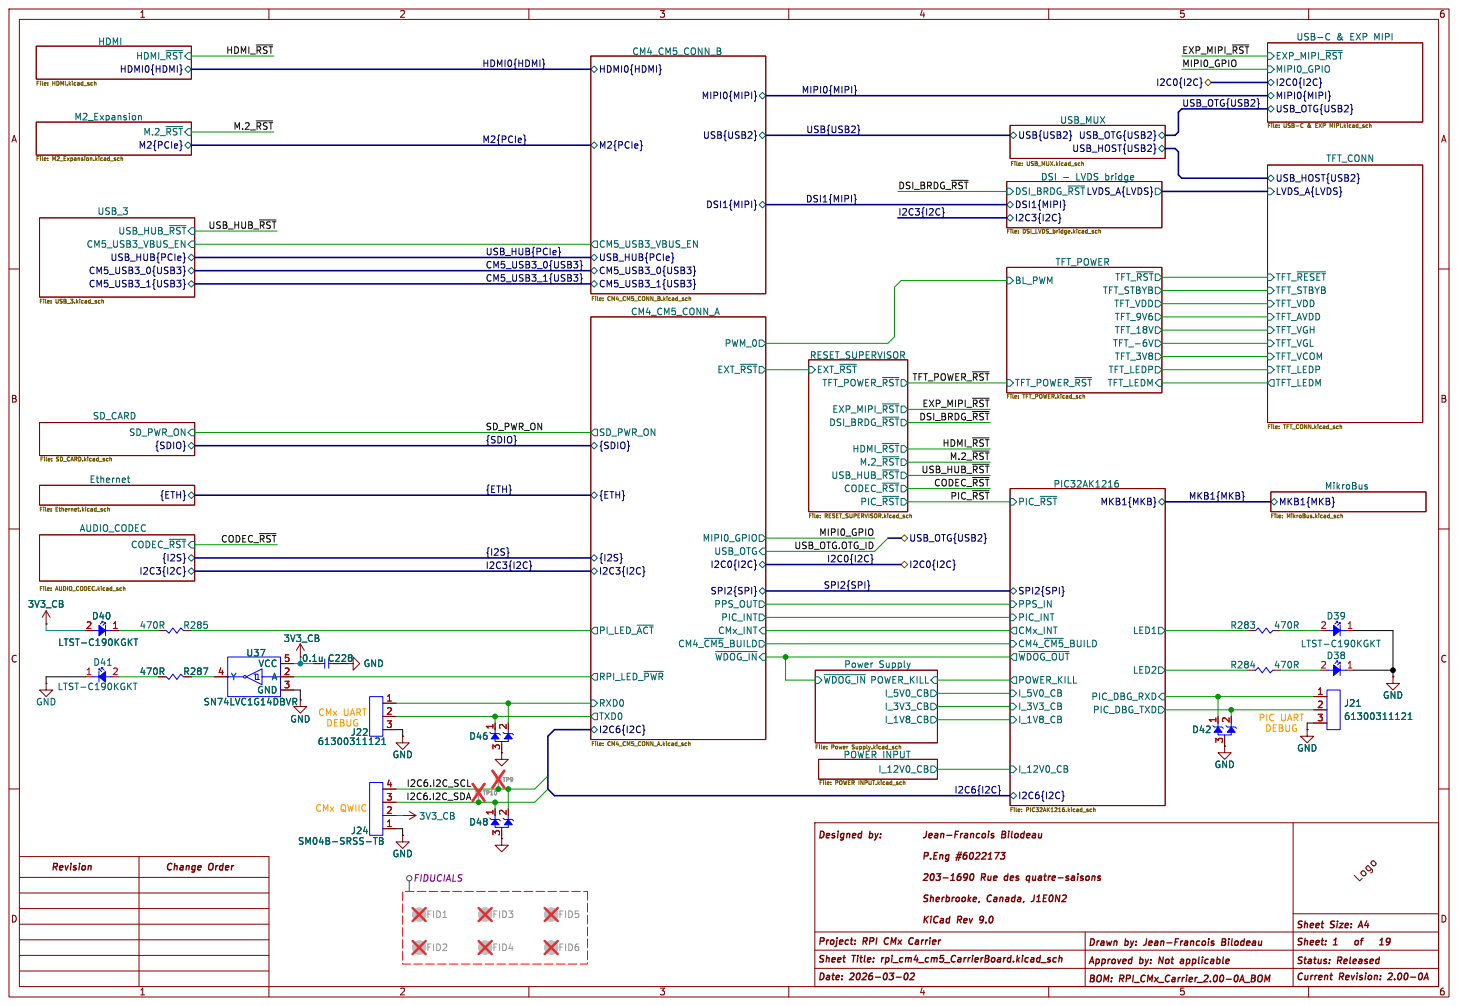
[picture p76: page 1]

DSI1{MIPI} DSI - LVDS bridge
DSI_BRDG_~{RST} LVDS_A{LVDS}

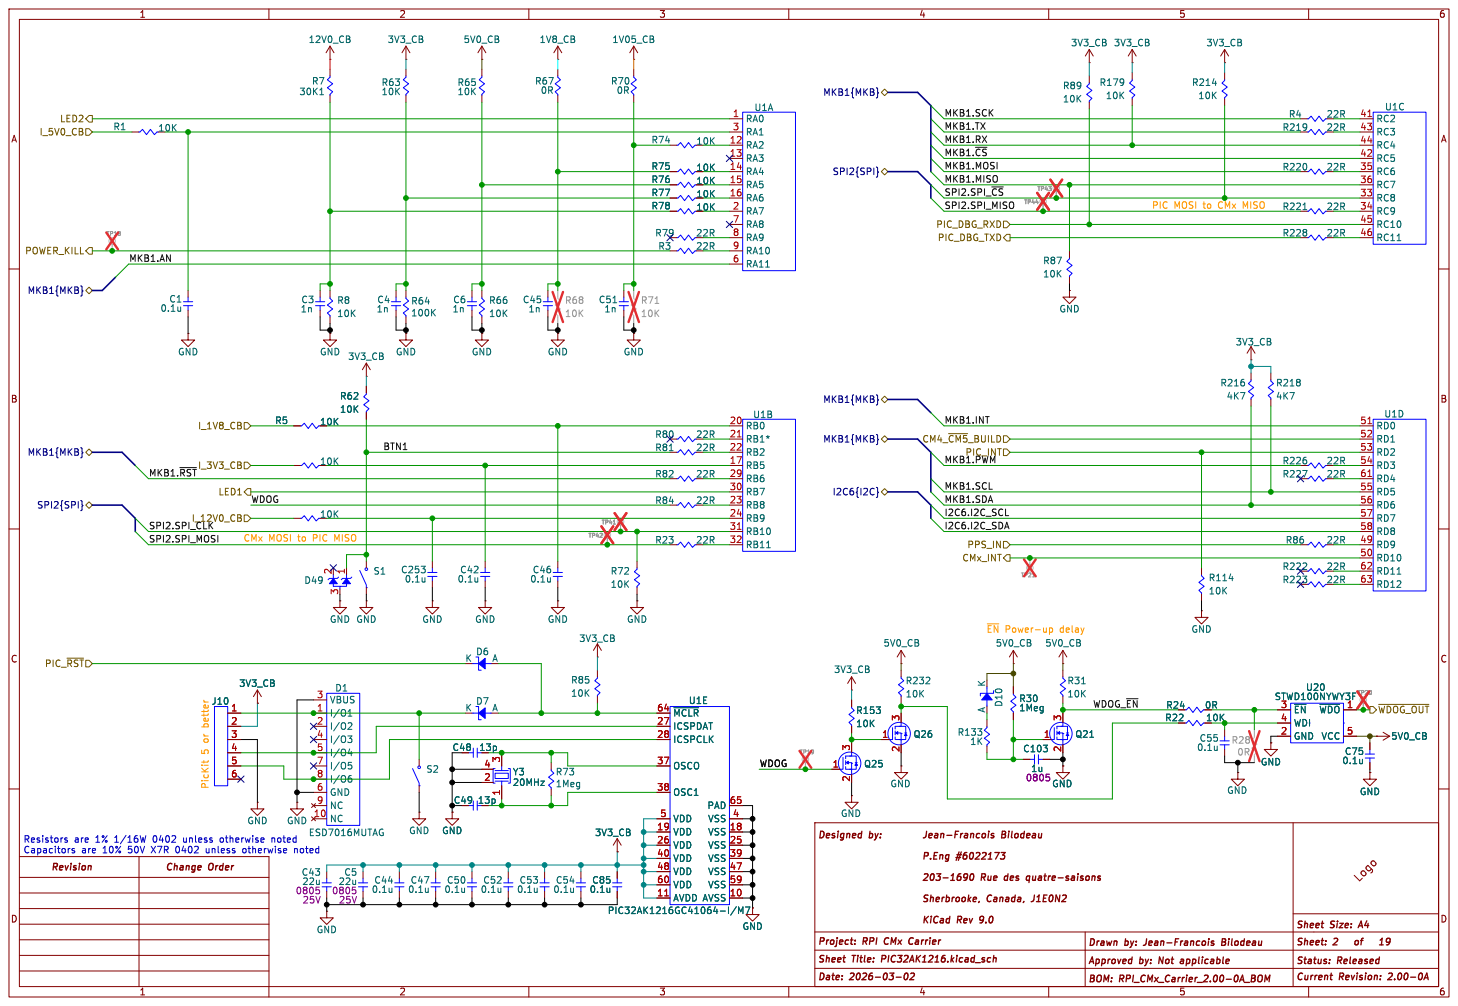
[picture p77: page 2]

PIC MOSI to CMx MISO

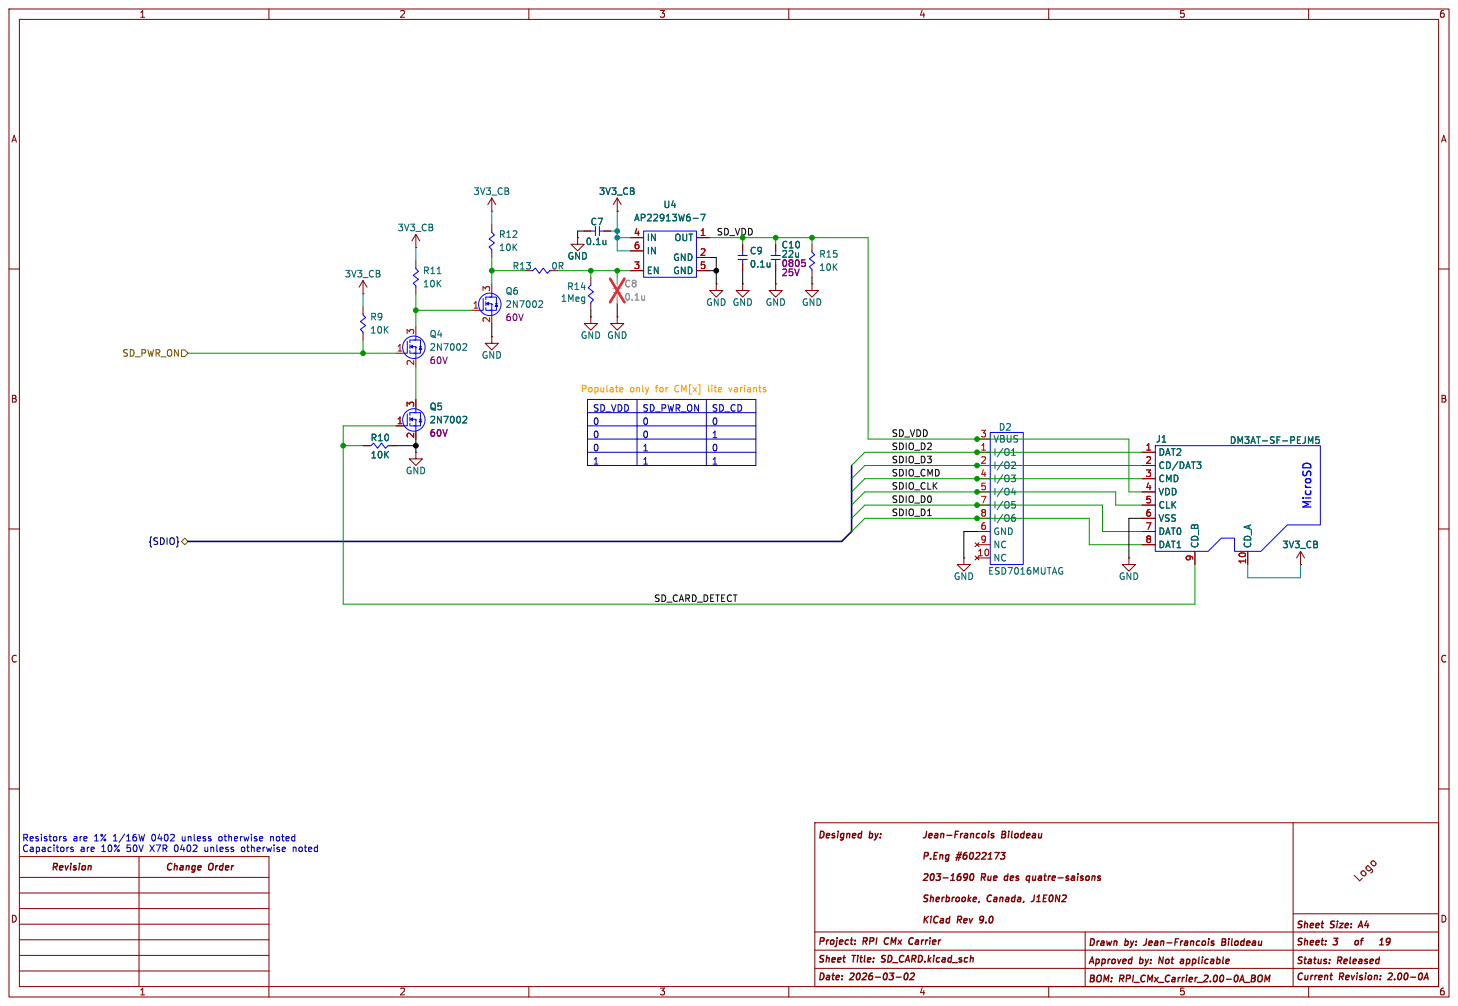
[picture p78: page 3]

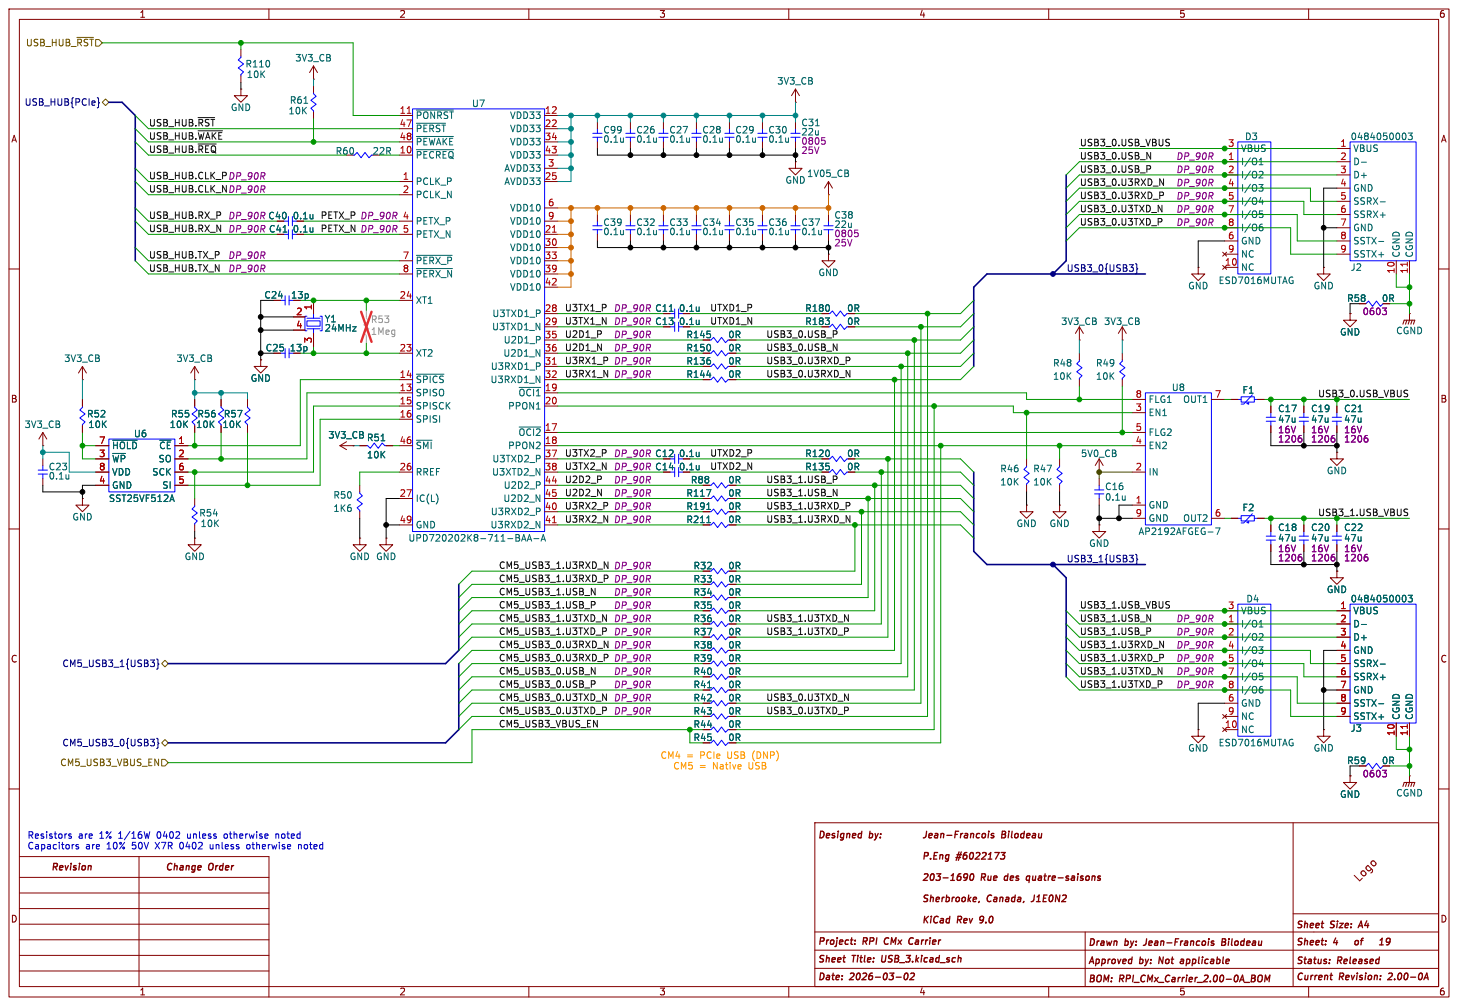
[picture p79: page 4]

10K GND
~{PONRST} 11 ~{PERST} 47 ~{PEWAKE} 48 ~{PECREQ} 10 PCLK_P 1 PCLK_N 2 PETX_P 4 PETX_N 5 ~{PERX_P} 7 ~{PERX_N} 8 XT1 24 XT2 23 ~{SPICS} 14 SPISO 13 SPISCK 15 SPISI 16 ~{SMI} 46 RREF 26

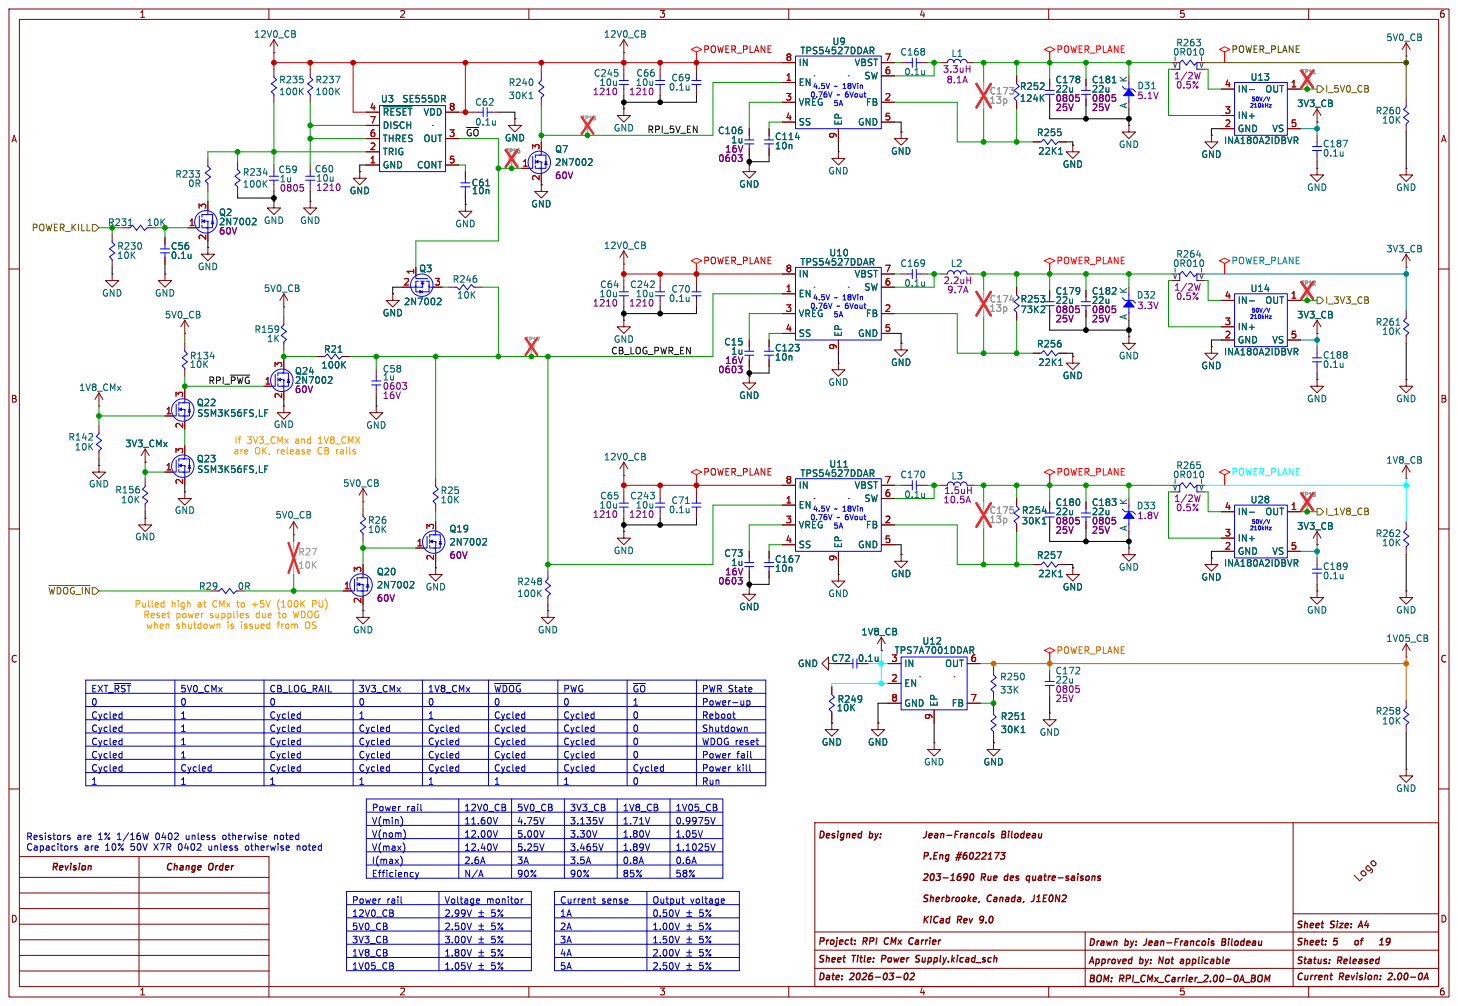
[picture p80: page 5]

9 VBST 7 SW 6 FB 2 GND 5 U9 TPS54527DDAR

9 VBST 7 SW 6 FB 2 GND 5 GND GND

9 VBST 7 SW 6 FB 2 GND 5 R252

9 VBST 7 SW 6 FB 2 GND 5 U10 TPS54527DDAR

9 VBST 7 SW 6 FB 2 GND 5 U11 TPS54527DDAR GND

9 VBST 7 SW 6 FB 2 GND 5 R257

when shutdown is issued from OS

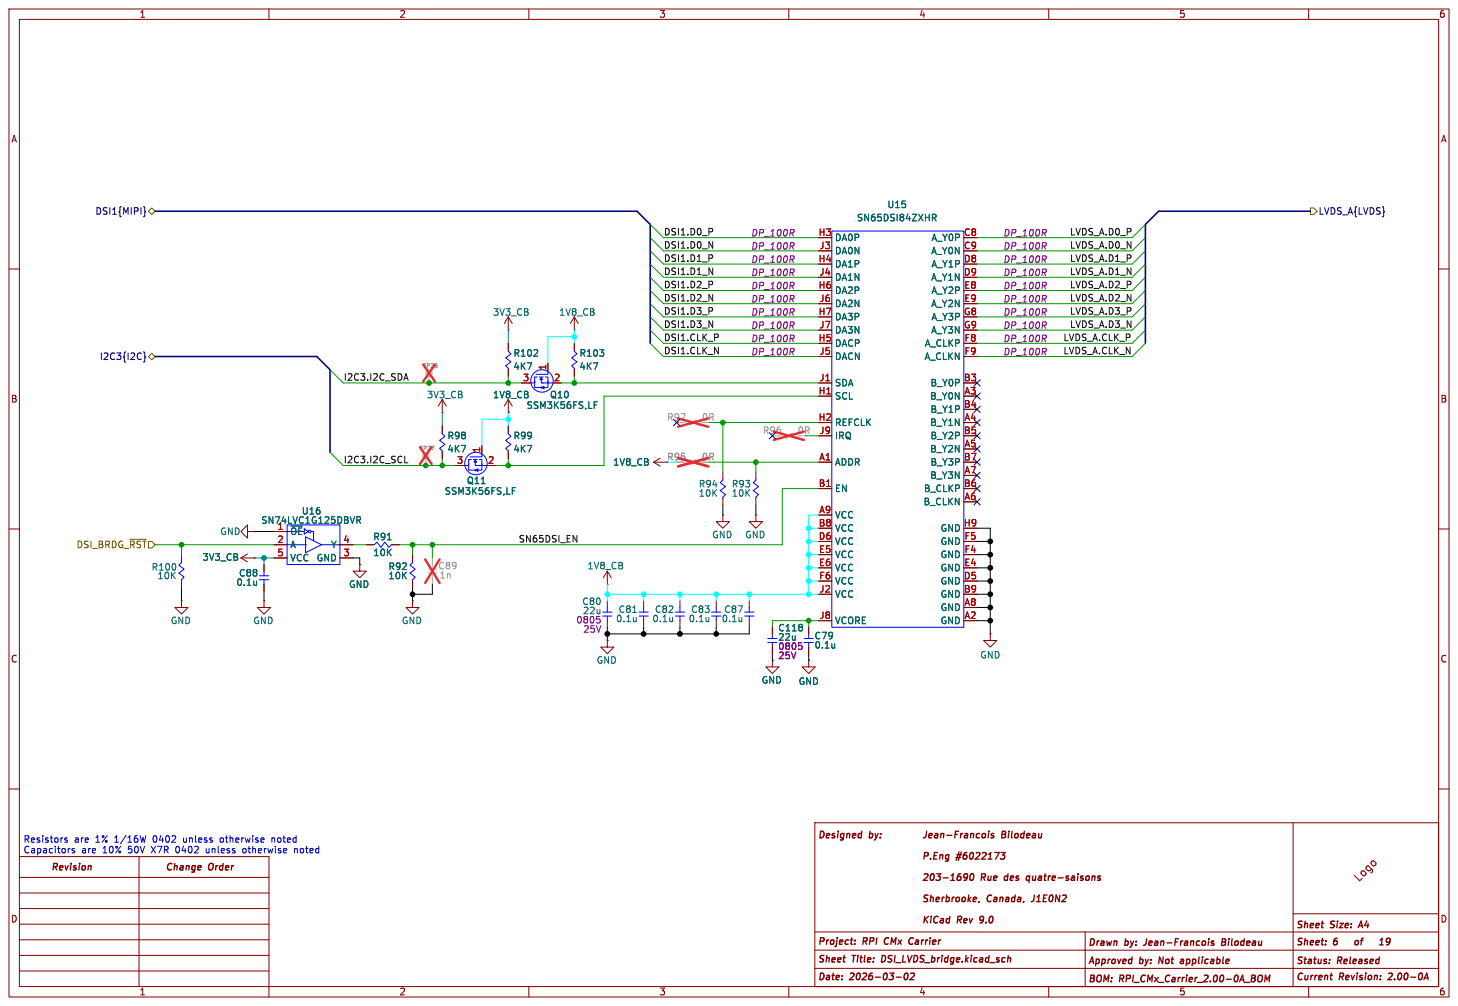
[picture p81: page 6]

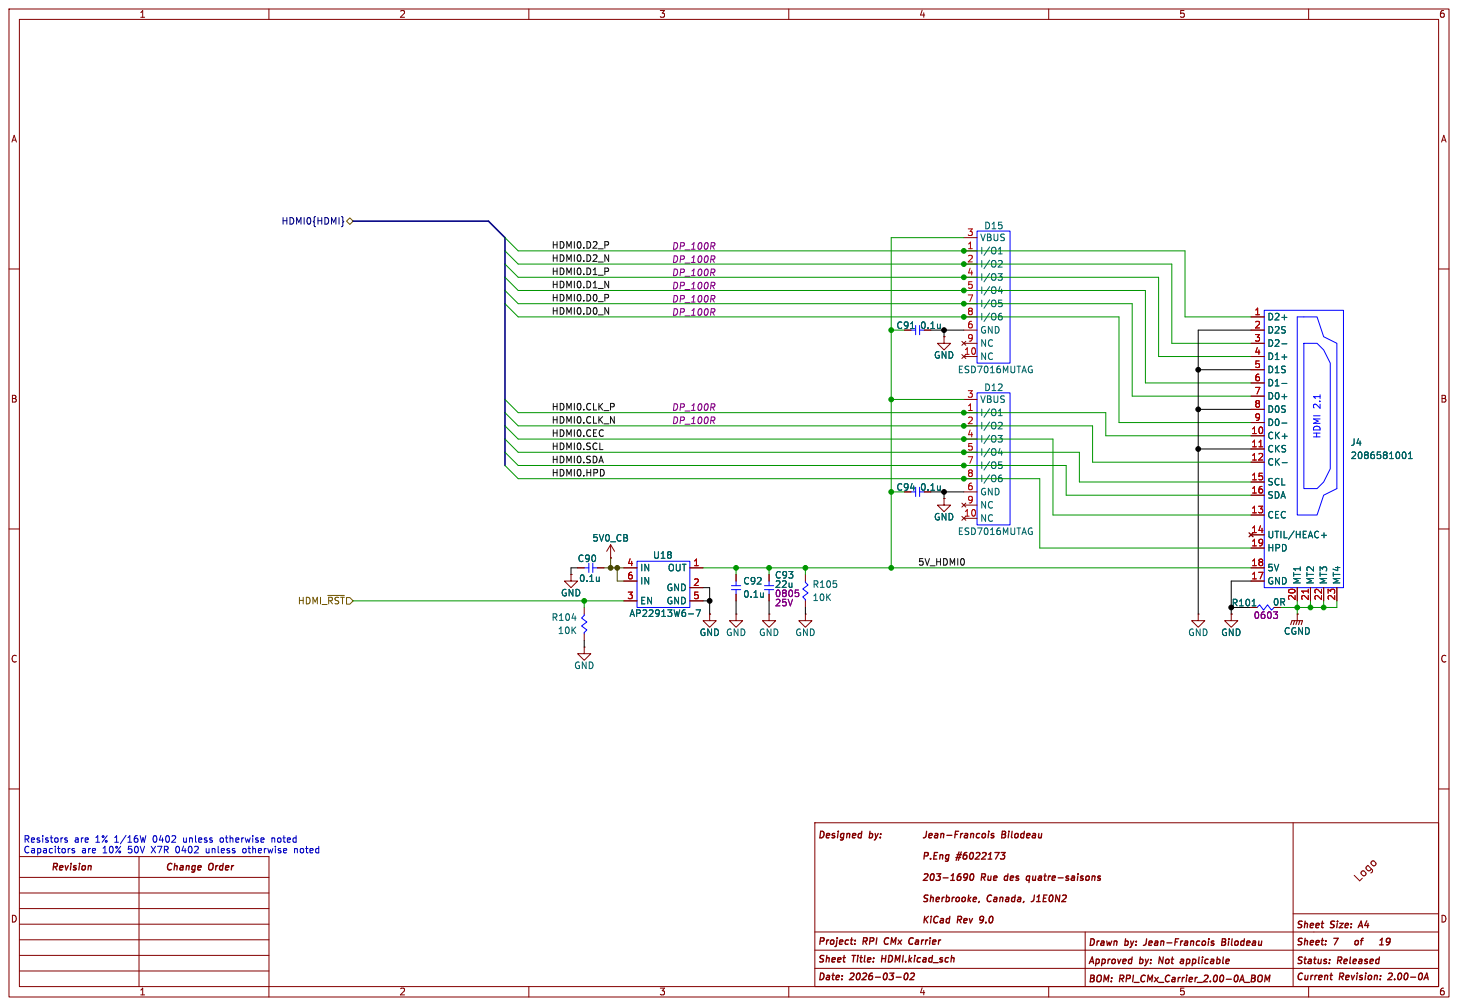
[picture p82: page 7]

2086581001 D2+ 1 D2S 2 D2- 3 D1+ 4 D1S 5 D1- 6 D0+ 7 D0S 8 D0- 9 CK+ 10 CKS 11 CK- 12 SCL 15 SDA 16 CEC 13 UTIL/HEAC+ 14 HPD 19

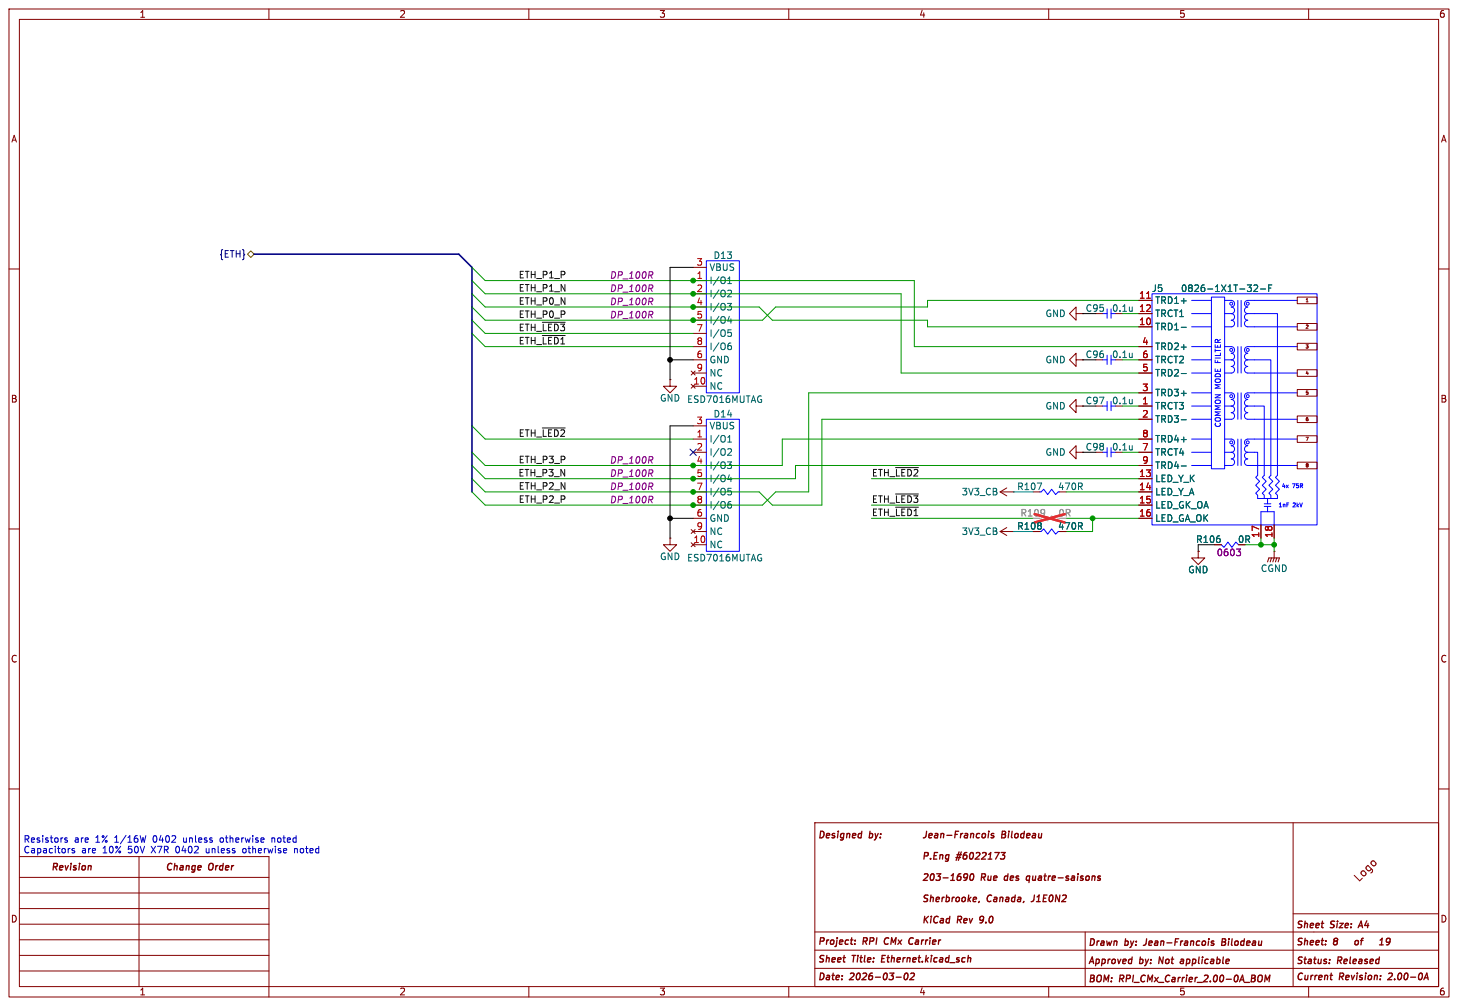
[picture p83: page 8]

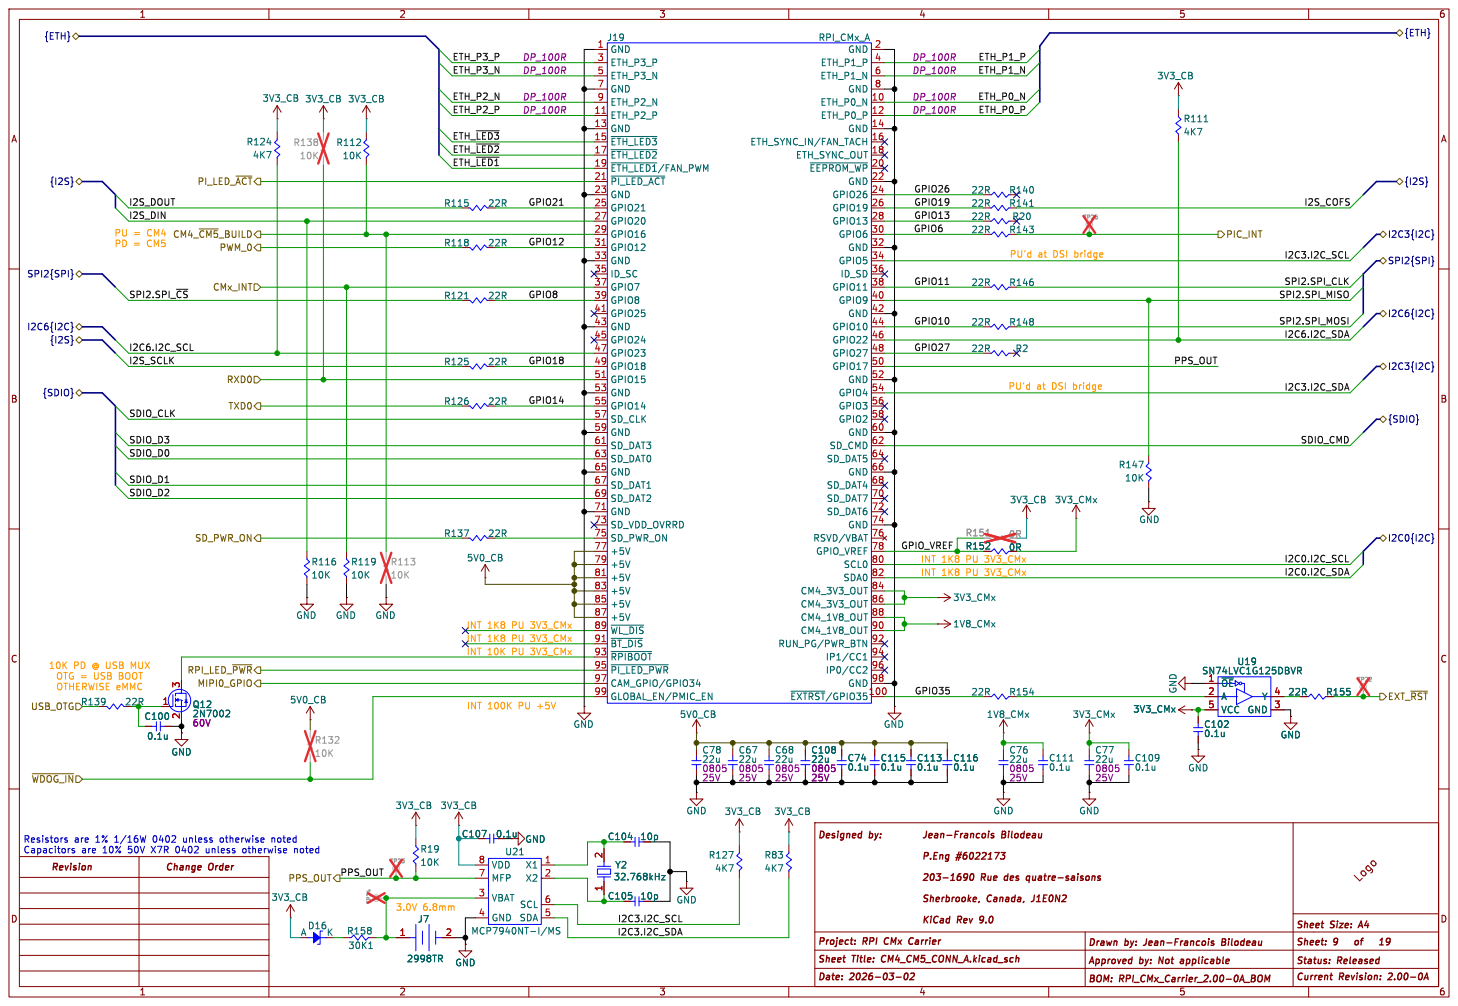
[picture p84: page 9]

GND 1 ETH_P3_P 3 ETH_P3_N 5 GND 7 ETH_P2_N 9 ETH_P2_P 11 GND 13 ~{ETH_LED3} 15 ~{ETH_LED2} 17 ~{ETH_LED1}/FAN_PWM 19 ~{PI_LED_ACT} 21 GND 23 GPIO21 25 GPIO20 27 GPIO16 29 GPIO12 31 GND 33
ID_SC 35 GPIO7 37 GPIO8 39 GPIO25 41 GND 43 GPIO24 45 GPIO23 47 GPIO18 49 GPIO15 51 GND 53 GPIO14 55 SD_CLK 57 GND 59 SD_DAT3 61 SD_DAT0 63 GND 65 SD_DAT1 67 SD_DAT2 69 GND 71 SD_VDD_OVRRD 73 SD_PWR_ON 75 +5V 77 +5V 79 +5V 81 +5V 83 +5V 85 +5V 87 ~{WL_DIS} 89 ~{BT_DIS} 91 ~{RPIBOOT} 93 ~{PI_LED_PWR} 95 CAM_GPIO/GPIO34 97 GLOBAL_EN/PMIC_EN 99

GND 2 ETH_P1_P 4 ETH_P1_N 6 GND 8 ETH_P0_N 10 ETH_P0_P 12 GND 14 ETH_SYNC_IN/FAN_TACH 16 ETH_SYNC_OUT 18 ~{EEPROM_WP} 20 GND 22 GPIO26 24 GPIO19 26 GPIO13 28 GPIO6 30 GND 32 GPIO5 34
ID_SD 36 GPIO11 38 GPIO9 40 GND 42 GPIO10 44 GPIO22 46 GPIO27 48 GPIO17 50 GND 52 GPIO4 54 GPIO3 56 GPIO2 58 GND 60 SD_CMD 62 SD_DAT5 64 GND 66 SD_DAT4 68 SD_DAT7 70 SD_DAT6 72 GND 74 RSVD/VBAT 76 GPIO_VREF 78 SCL0 80 SDA0 82 CM4_3V3_OUT 84 CM4_3V3_OUT 86 CM4_1V8_OUT 88 CM4_1V8_OUT 90 RUN_PG/PWR_BTN 92

I2S_DOUT
I2S_DIN
INT 1K8 PU 3V3_CMx PU'd at DSI bridge PU = CM4 PD = CM5

PWM_0 RXD0
PU'd at DSI bridge Q12

10K PD @ USB MUX OTG = USB BOOT OTHERWISE eMMC

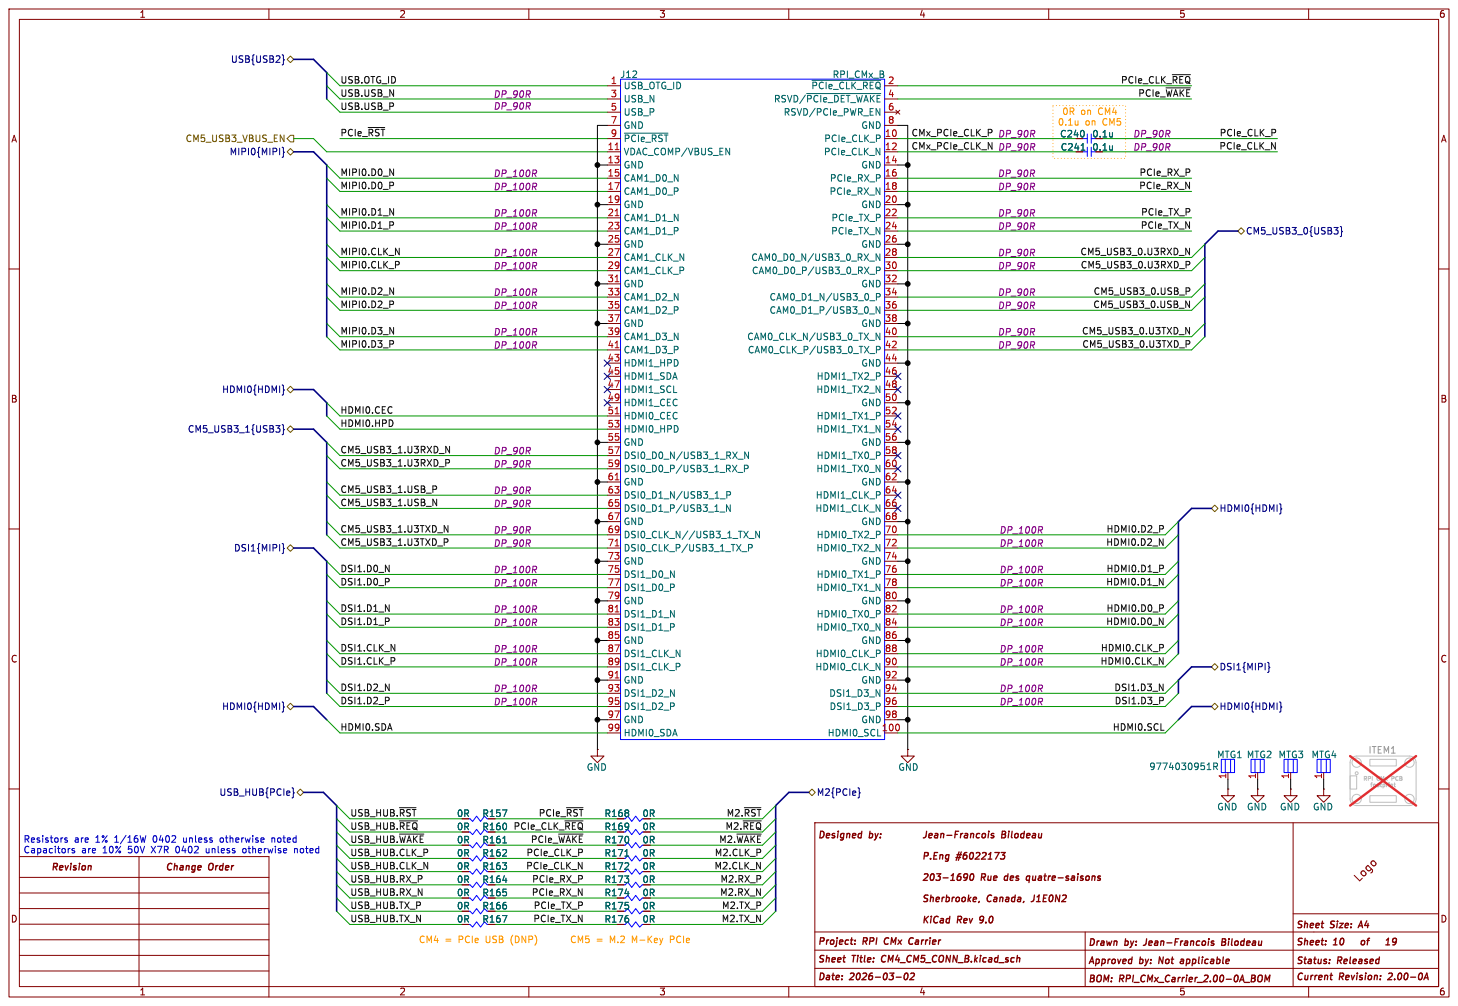
[picture p85: page 10]

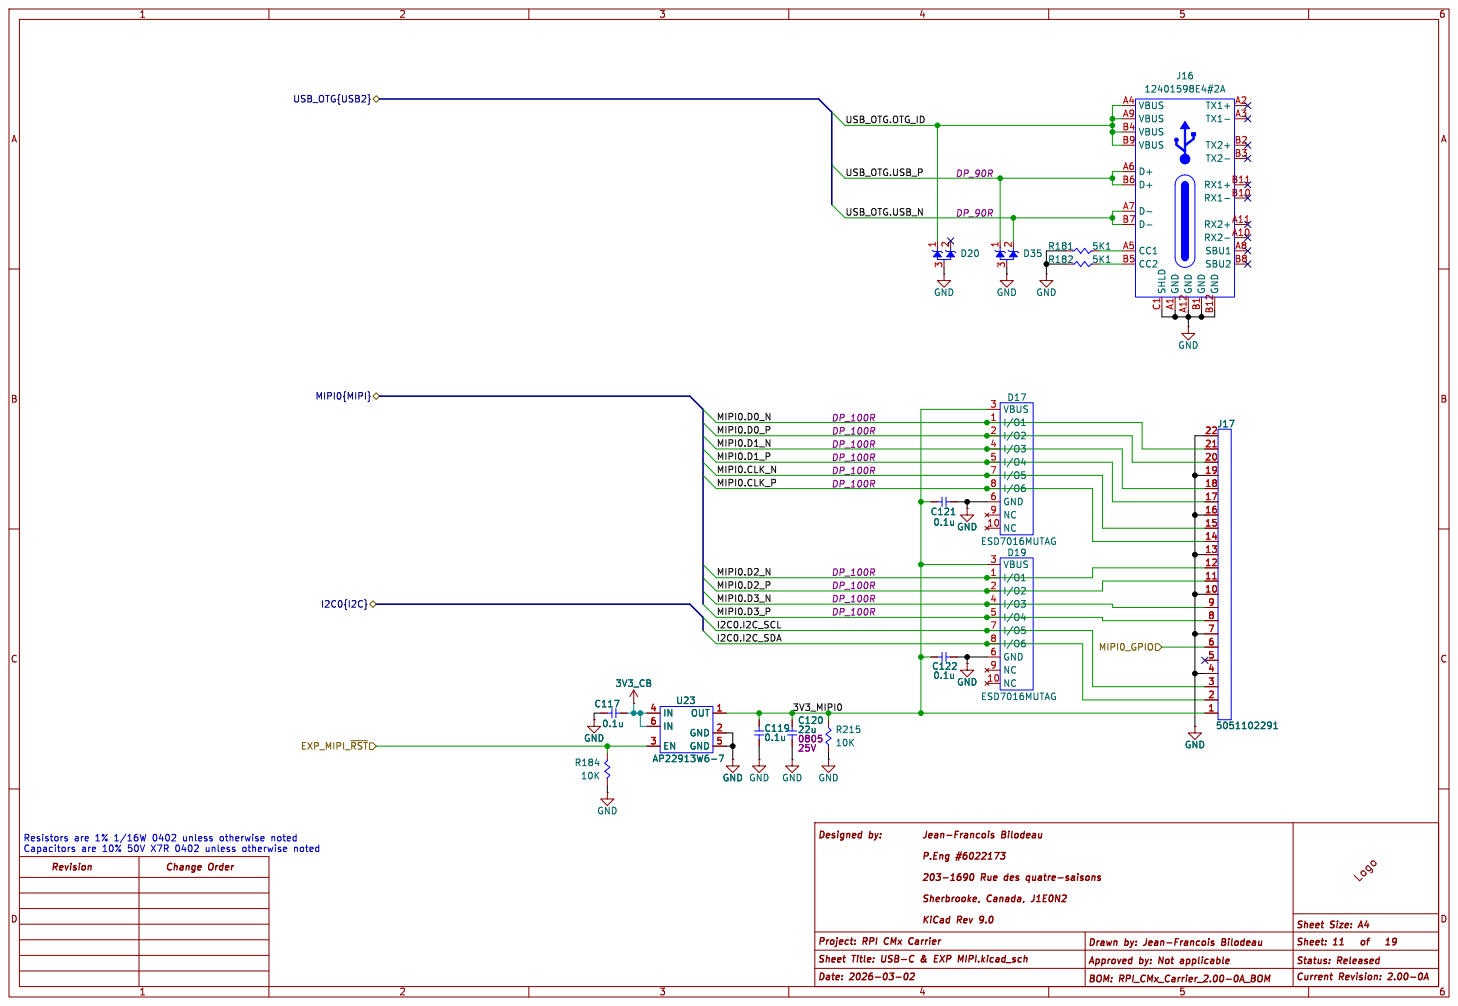
[picture p86: page 11]

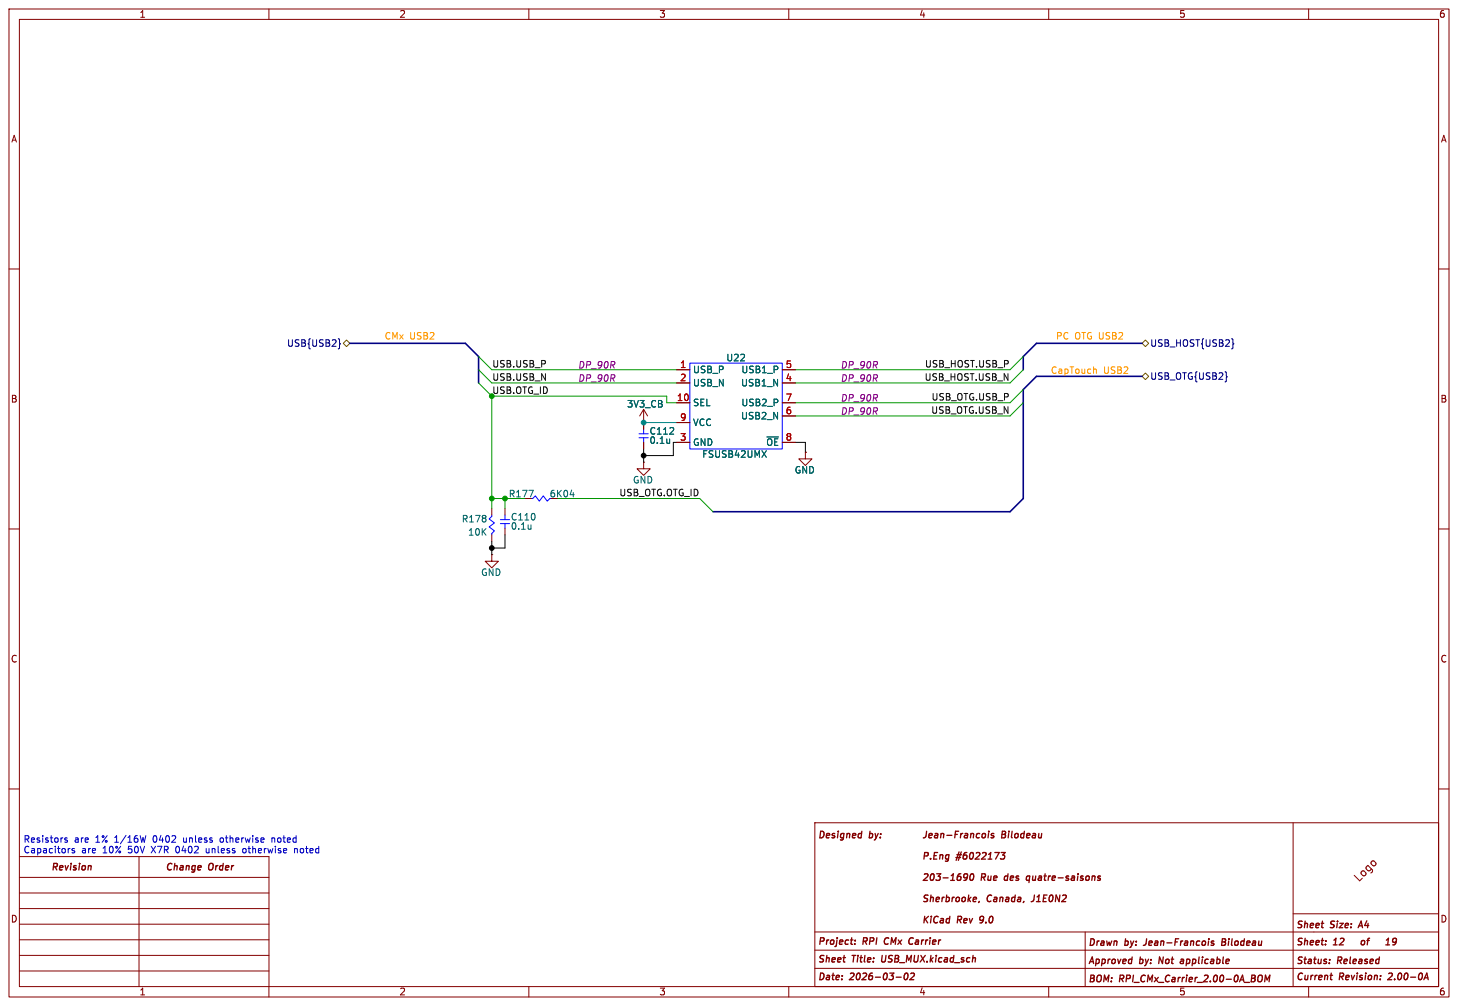
[picture p87: page 12]

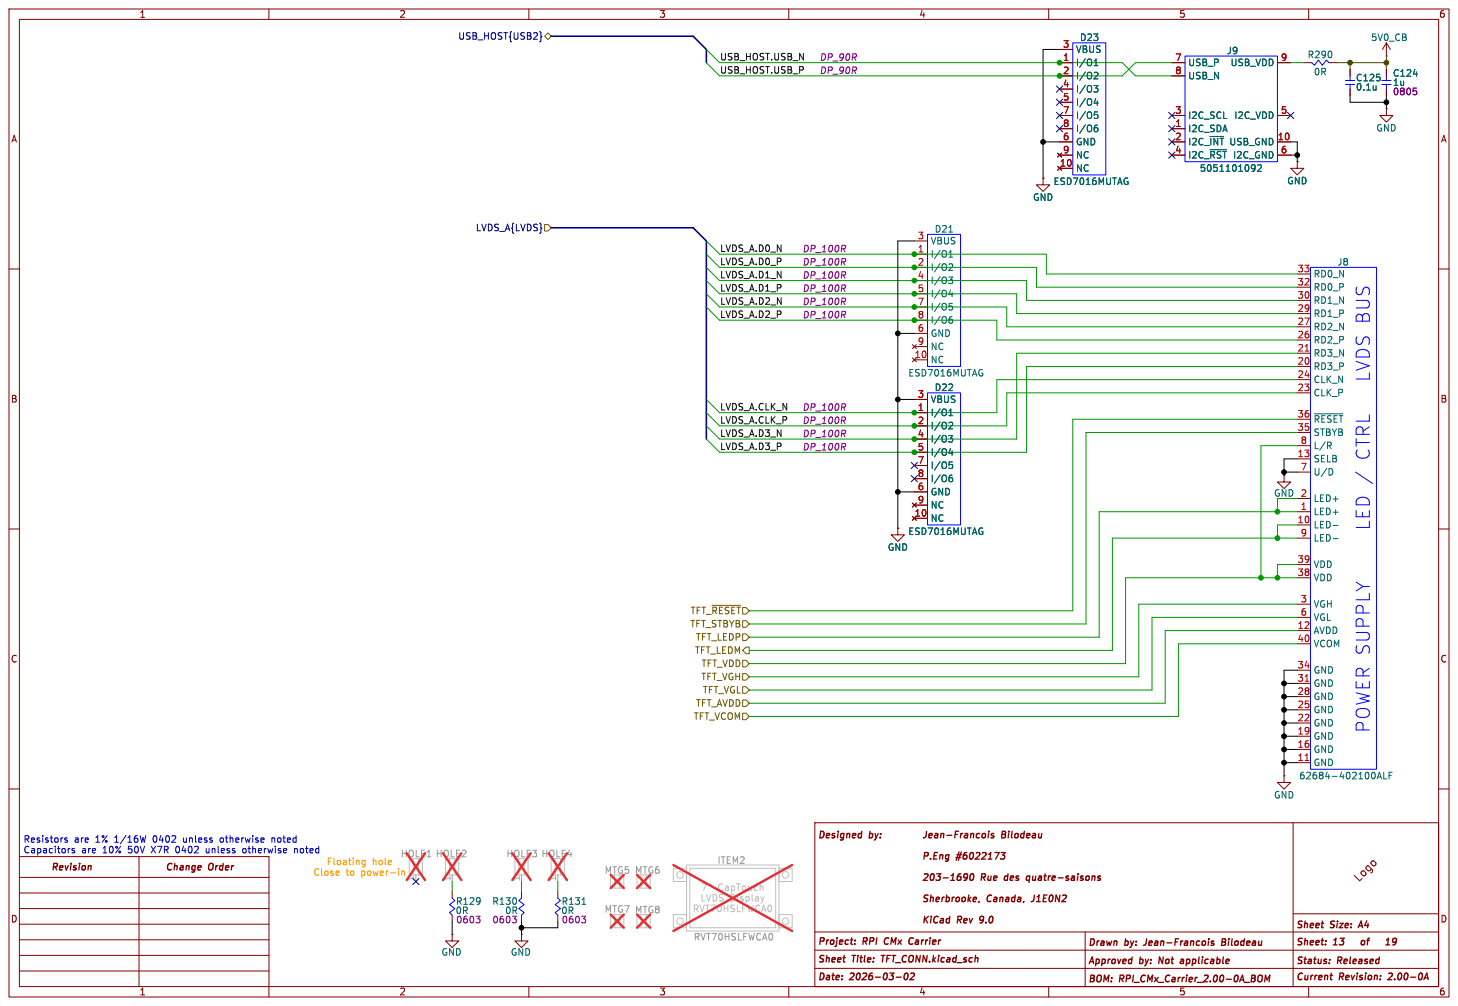
[picture p88: page 13]

LED+ 2
LED+ 1
LED- 10
LED- 9 VDD 39 VDD 38 VGH 3 VGL 6 AVDD 12 VCOM 40 GND 34 GND 31 GND 28 GND 25 GND 22 GND 19 GND 16 GND 11

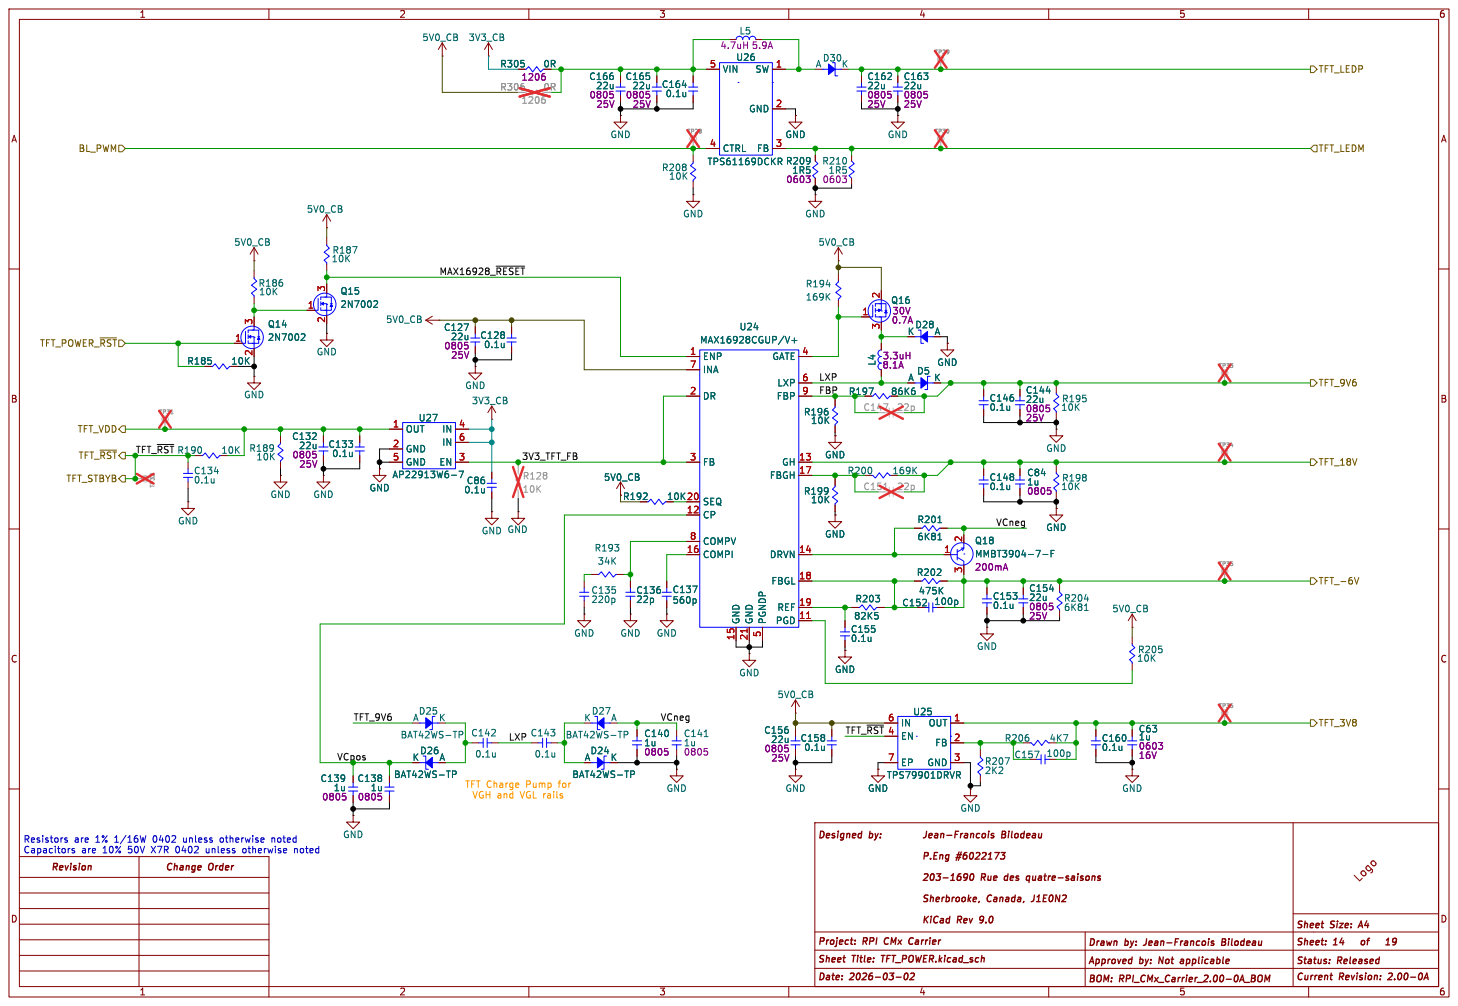
[picture p89: page 14]

IN 6 EN 3 OUT 1 GND 2 GND 5 C138

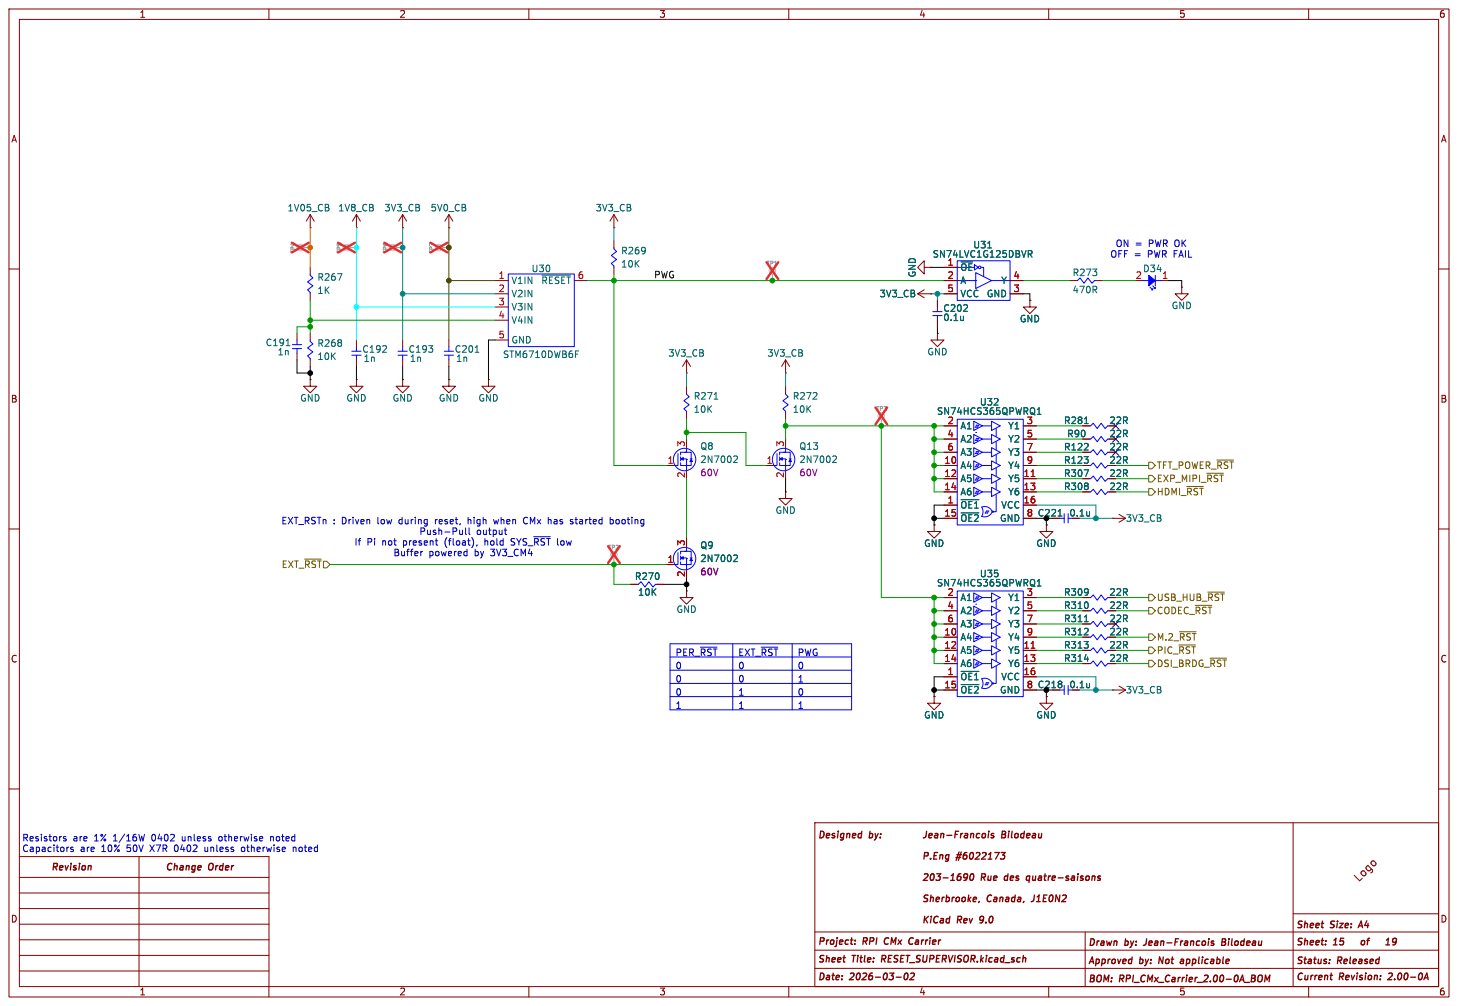
[picture p90: page 15]

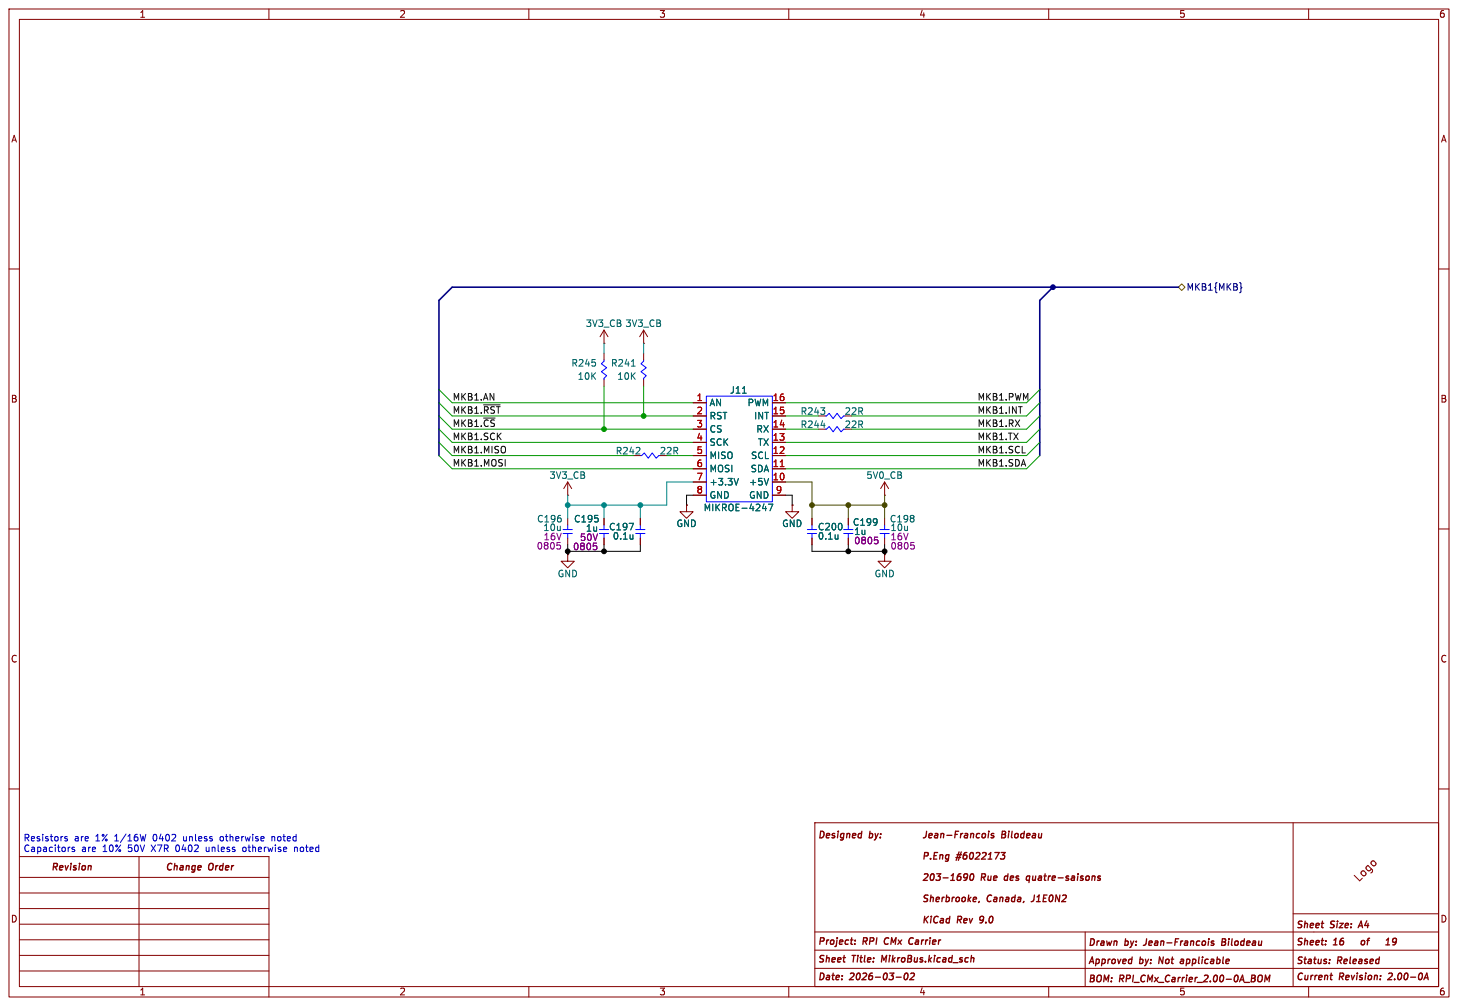
[picture p91: page 16]

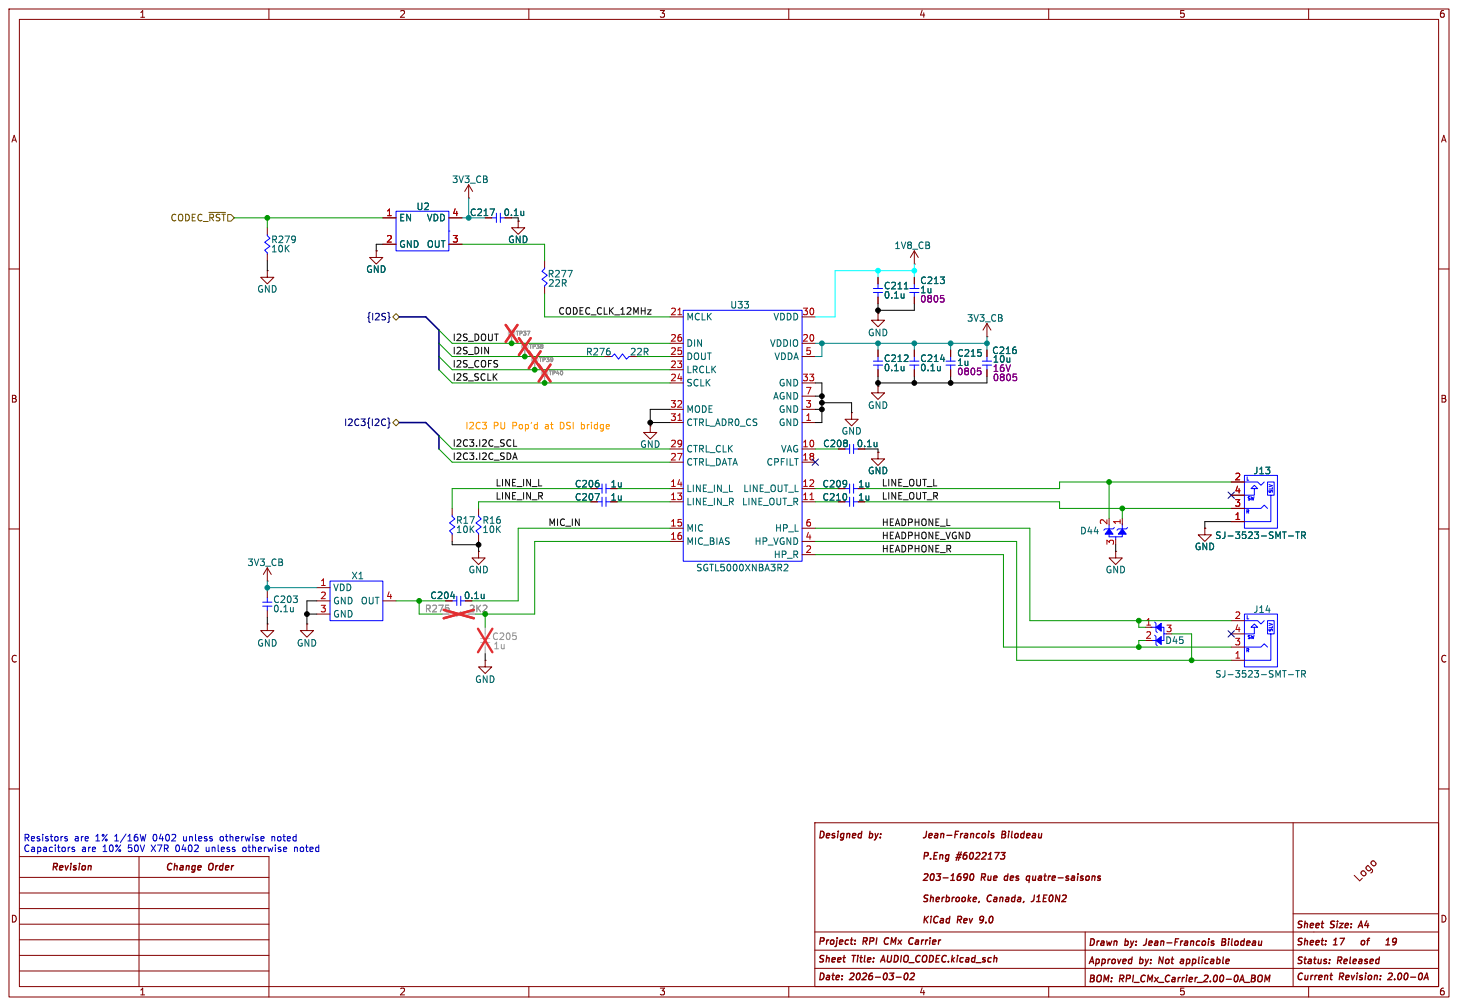
[picture p92: page 17]

mil TP37 GND GND GND

mil TP39 VDD 1 GND 2 GND 3 OUT 4 X1 R276 22R

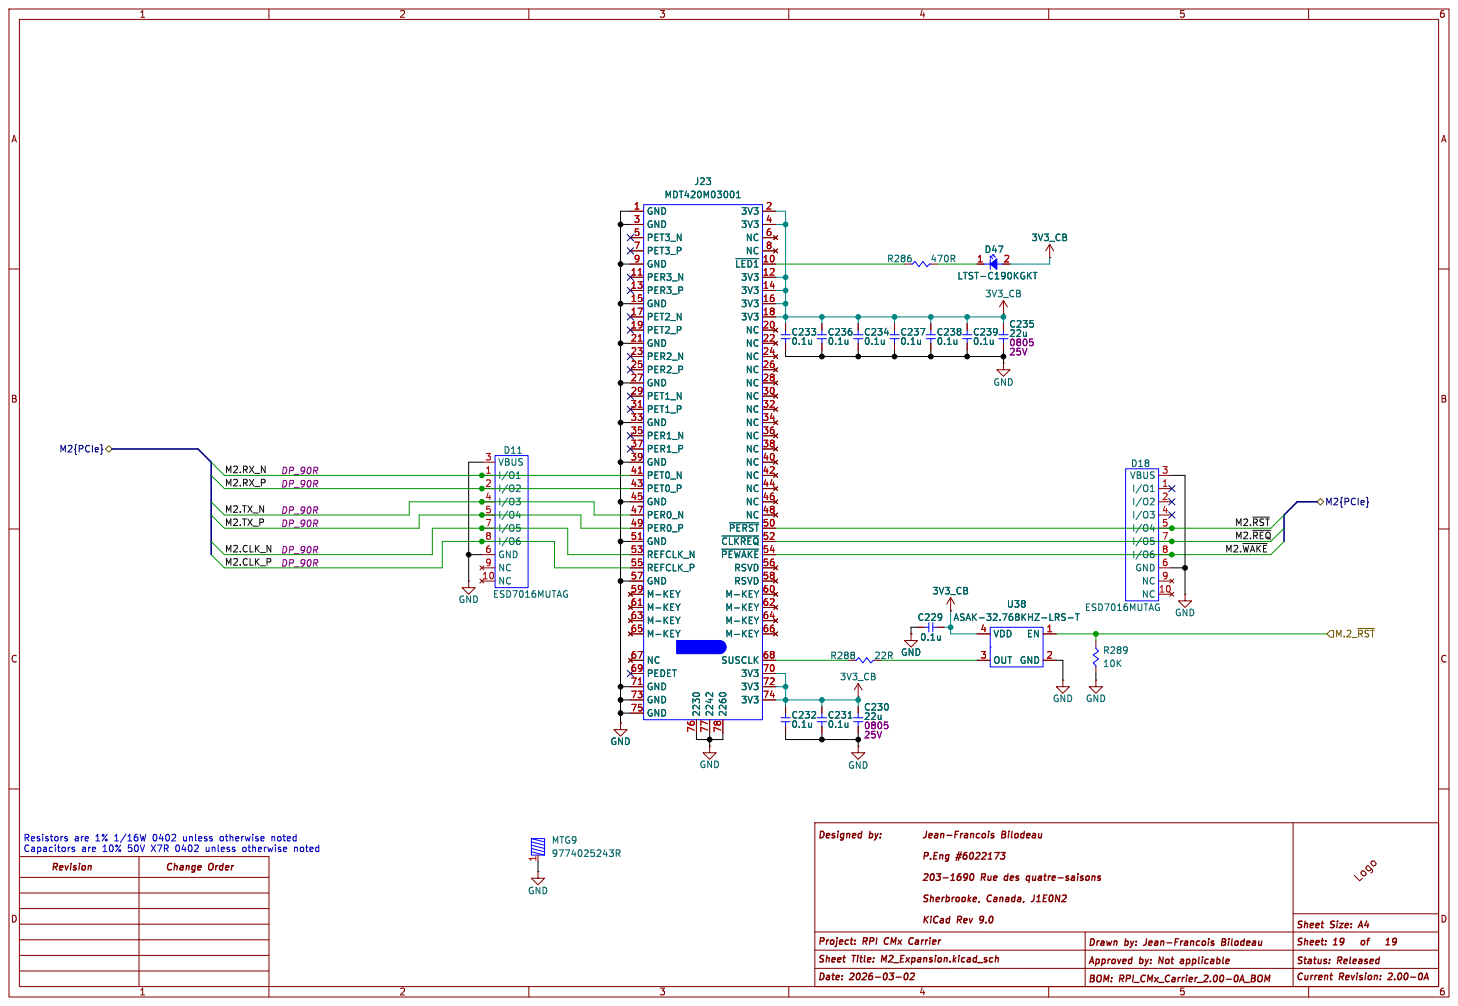
[picture p93: page 18]

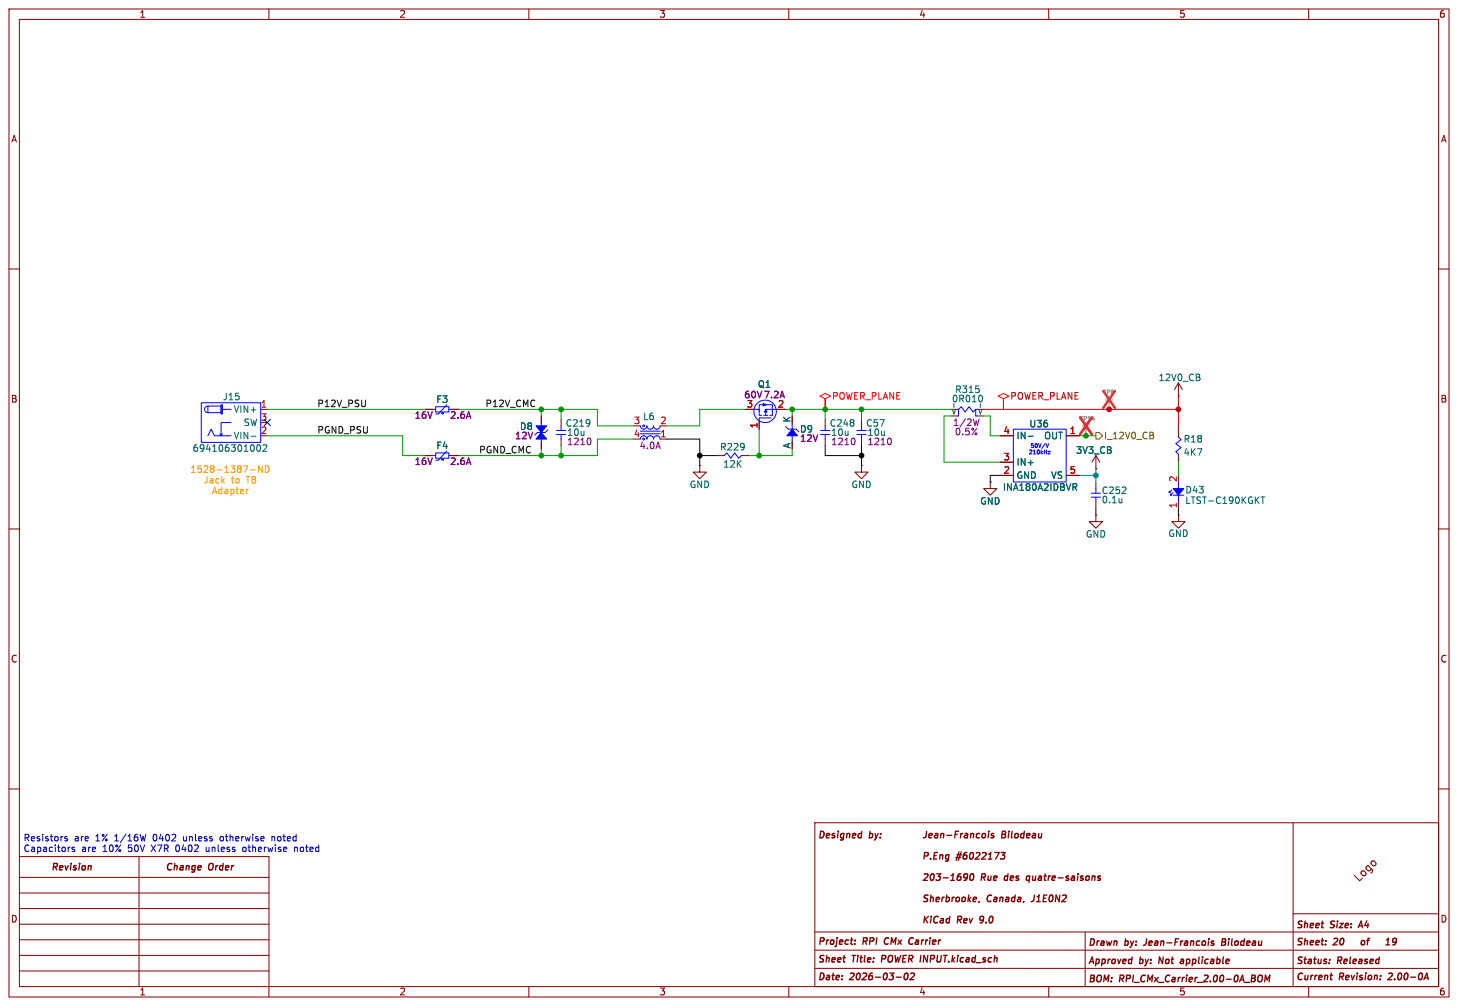
[picture p94: page 19]
