lecejeff/RPI_CMx_Carrier/hardware/design notes/Simulations/WDT fast deassert.asc

C1: cap; 10µ
D1: diode; 1N4148
M1: nmos; 2N7002
R1: res; 100Meg
R2: res; 1k
R3: res; 1k
R4: res; 0
V1: voltage; PULSE(0 5 0 10u 10u 480 960 5)
V2: voltage; 5
Named nets: 0, WDOG_EN, VIN
.tran 960
