lecejeff/RPI_CMx_Carrier/hardware/design notes/Simulations/Power Killer 555.asc

C1: cap; 10n
C2: cap; 22µ
C3: cap; 1µ
C4: cap; 0.1µ
M1: nmos; 2N7002
M2: nmos; 2N7002
R1: res; 100k
R2: res; 100k
R3: res; 100k
R4: res; 10k
R5: res; 10k
R6: res; 10k
U1: NE555
V1: voltage; PULSE(0 3.3 10 1u 1u 10m 10 1)
V2: voltage; PULSE(0 12 0 100m 100m 30 30.1 1)
Named nets: 0, 12V, 5V_EN, POWER_KILL
.tran 30
