lecejeff/RPI_CMx_Carrier/hardware/Rev1_00-0a/rpi_cm4_cm5_CarrierBoard/rpi_cm4_cm5_CarrierBoard.kicad_pcb

## KiCad design hardware/Rev1_00-0a/rpi_cm4_cm5_CarrierBoard/rpi_cm4_cm5_CarrierBoard.kicad_pcb (2026-03-02)

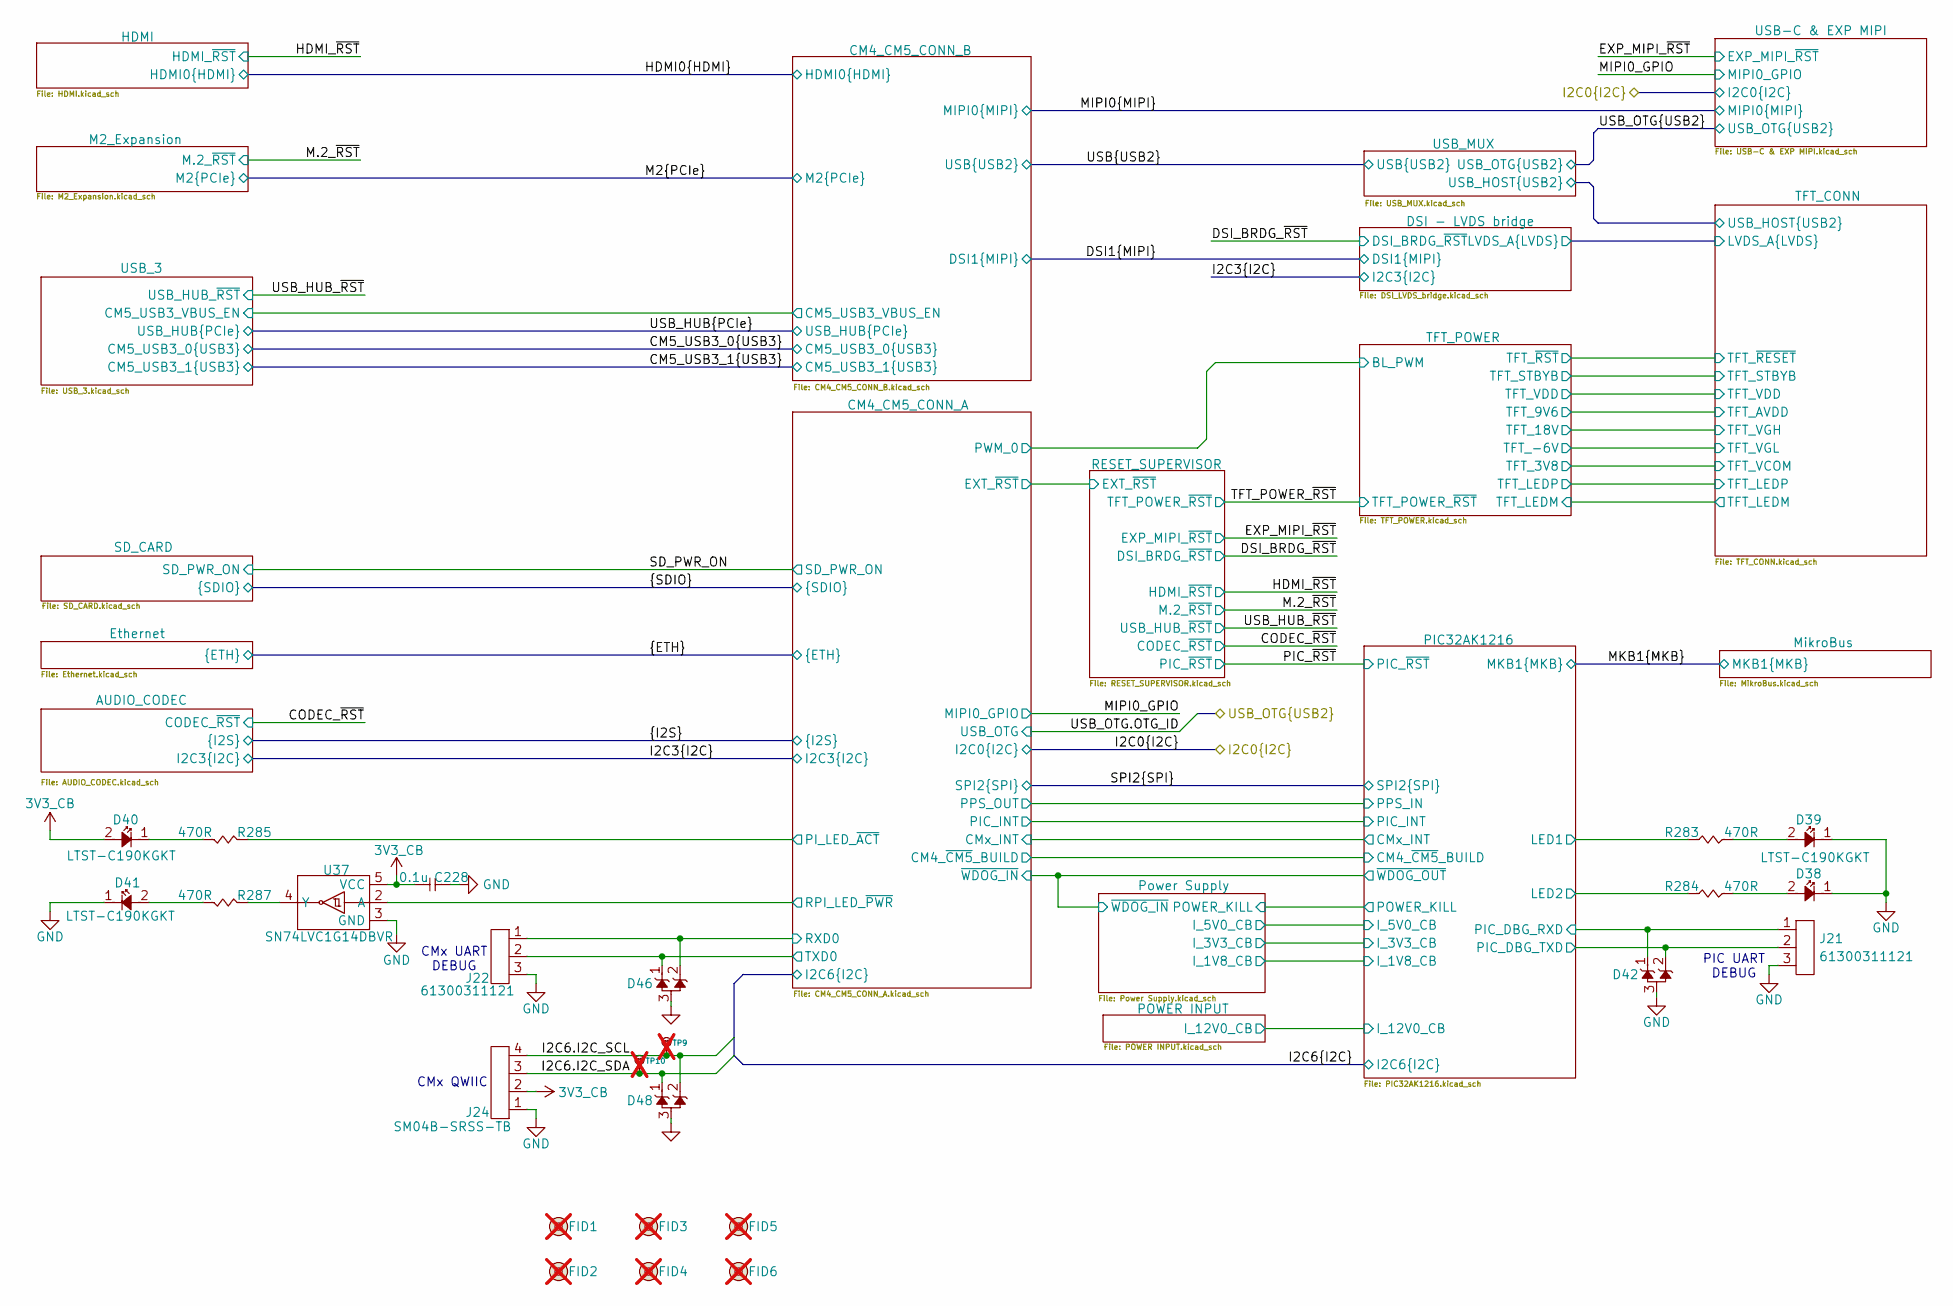
[picture p95: schematic rpi_cm4_cm5_CarrierBoard.kicad_sch, RPI CMx Carrier]

Parts:
C228: 0.1u; CAP_NONPOL_0402; Tolerance ±10%; Voltage Rating 50V; Manufacturer Part Number GRM155R71H104KE14D
D38, D39, D40, D41: LTST-C190KGKT; LED_0603; Tolerance NA; Manufacturer Part Number LTST-C190KGKT
D42, D46, D48: D1213A-02SOL-7; SOT-23-3; Manufacturer Part Number D1213A-02SOL-7
FID1, FID2, FID3, FID4, FID5, FID6: FIDUCIAL; not fitted
J21, J22: 61300311121; HEADER_3P_2_54MM; Current Rating 3A; Voltage Rating 250V; Manufacturer Part Number 61300311121
J24: SM04B-SRSS-TB; Current Rating 1A; Voltage Rating 50V; Manufacturer Part Number SM04B-SRSS-TB
R283, R284, R285, R287: 470R; RES_0402; Tolerance 1%; Manufacturer Part Number RC0402FR-07470RL
TP9, TP10: 28 mils; SMT_TP_28_MILS; Manufacturer Part Number NA; not fitted
U37: SN74LVC1G14DBVR; SOT-23-5; Supply Voltage 1.65V ~ 5.5V; Manufacturer Part Number SN74LVC1G14DBVR

Connections:
3V3_CB: C228.2, D40.2 (A), J24.2, U37.5 (VCC); also elsewhere on the board
/CM4_CM5_CONN_A/PI_LED_~ACT: R285.1; also elsewhere on the board
/CM4_CM5_CONN_A/RPI_LED_~PWR: U37.2 (A); also elsewhere on the board
/CM4_CM5_CONN_A/RXD0: D46.2 (A), J22.1; also elsewhere on the board
/CM4_CM5_CONN_A/TXD0: D46.1, J22.2; also elsewhere on the board
/I2C6.I2C_SCL: D48.2 (A), J24.4, TP9.1; also elsewhere on the board
/I2C6.I2C_SDA: D48.1, J24.3, TP10.1; also elsewhere on the board
/PIC32AK1216/LED1: R283.1; also elsewhere on the board
/PIC32AK1216/LED2: R284.1; also elsewhere on the board
/PIC32AK1216/PIC_DBG_RXD: D42.1, J21.1; also elsewhere on the board
/PIC32AK1216/PIC_DBG_TXD: D42.2 (A), J21.2; also elsewhere on the board
GND: C228.1, D38.1 (K), D39.1 (K), D41.1 (K), D42.3 (GND), D46.3 (GND), D48.3 (GND), J21.3, J22.3, J24.1, U37.3 (GND); also elsewhere on the board
unnamed: D38.2 (A), R284.2
unnamed: D39.2 (A), R283.2
unnamed: D40.1 (K), R285.2
unnamed: D41.2 (A), R287.2
unnamed: R287.1, U37.4 (Y)

Notes on the sheet:
CMx QWIIC
PIC UART DEBUG
CMx UART DEBUG

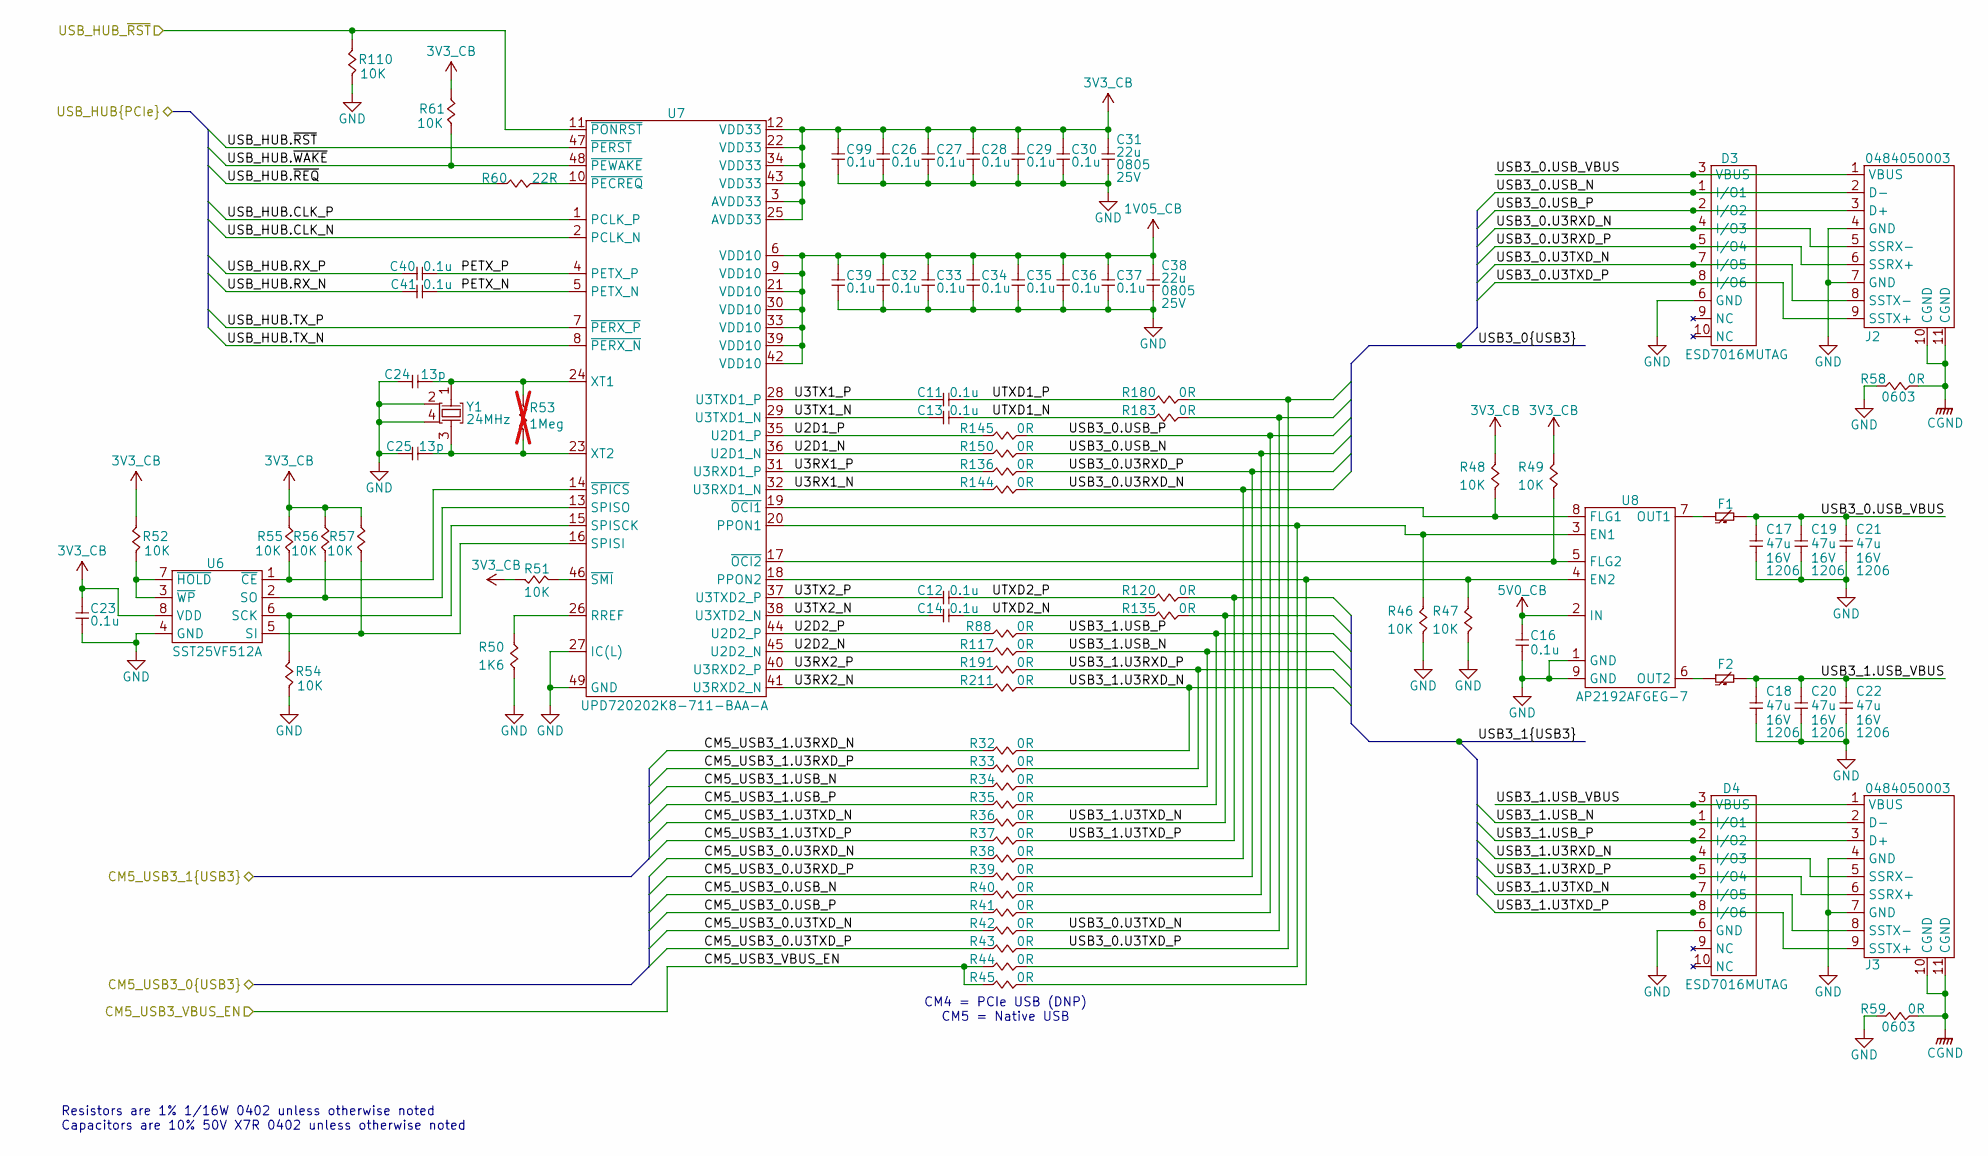
[picture p96: schematic USB_3.kicad_sch, RPI CMx Carrier]

Parts:
C11, C12, C13, C14, C16, C23, C26, C27, C28, C29, C30, C32, C33, C34, C35, C36, C37, C39, C40, C41, C99: 0.1u; CAP_NONPOL_0402; Tolerance ±10%; Voltage Rating 50V; Manufacturer Part Number GRM155R71H104KE14D
C17, C18, C19, C20, C21, C22: 47u; CAP_NONPOL_1206; Tolerance ±20%; Voltage Rating 16V; Manufacturer Part Number C3216X5R1C476M160AB
C24, C25: 13p; CAP_NONPOL_0402; Tolerance ±2%; Voltage Rating 50V; Manufacturer Part Number GJM1555C1H130GB01D
C31, C38: 22u; CAP_NONPOL_0805; Tolerance ±20%; Voltage Rating 25V; Manufacturer Part Number CL21A226MAYNNNE
D3, D4: ESD7016MUTAG; UDFN8; Manufacturer Part Number ESD7016MUTAG
F1, F2: MINISMDC050F-2; PTC_1812; Voltage 24V; Manufacturer Part Number MINISMDC050F-2
J2, J3: 0484050003; Current Rating 1.8A; Voltage Rating 30V; Manufacturer Part Number 0484050003
R32, R33, R34, R35, R36, R37, R38, R39, R40, R41, R42, R43, R44, R45, R88, R117, R120, R135, R136, R144, R145, R150, R180, R183, R191, R211: 0R; RES_0402; Tolerance 1%; Manufacturer Part Number RC0402FR-071KL
R46, R47, R48, R49, R51, R52, R54, R55, R56, R57, R61, R110: 10K; RES_0402; Tolerance 1%; Manufacturer Part Number RC0402FR-0710KL
R50: 1K6; RES_0402; Tolerance 1%; Manufacturer Part Number RC0402FR-131K6L
R53: 1Meg; RES_0402; Tolerance 1%; Manufacturer Part Number RC0402FR-131ML; not fitted
R58, R59: 0R; RES_0603; Tolerance 1%; Manufacturer Part Number RC0603JR-070RL
R60: 22R; RES_0402; Tolerance 1%; Manufacturer Part Number RC0402FR-0722RL
U6: SST25VF512A; SOIC-8-150mil; Supply Voltage 2.7V ~ 3.6V; Manufacturer Part Number SST25VF512A-33-4I-SAE
U7: UPD720202K8-711-BAA-A; 48-VFQFN-EP; Supply Voltage 1.05V ~ 3.3V; Manufacturer Part Number UPD720202K8-711-BAA-A
U8: AP2192AFGEG-7; U-DFN3030-8; Load Voltage 2.7V ~ 5.5V; Manufacturer Part Number AP2192AFGEG-7
Y1: 24MHz; 4-SMD_2mmx1_6mm; Tolerance ±20ppm; Manufacturer Part Number ABM11-24.000MHZ-D2X-T3

Connections:
1V05_CB: C32.2, C33.2, C34.2, C35.2, C36.2, C37.2, C38.2, C39.2, U7.6 (VDD10), U7.9 (VDD10), U7.21 (VDD10), U7.30 (VDD10), U7.33 (VDD10), U7.39 (VDD10), U7.42 (VDD10); also elsewhere on the board
3V3_CB: C23.2, C26.2, C27.2, C28.2, C29.2, C30.2, C31.2, C99.2, R48.2, R49.2, R51.2, R52.1, R55.1, R56.1, R57.1, R61.1, U6.8 (VDD), U7.3 (AVDD33), U7.12 (VDD33), U7.22 (VDD33), U7.25 (AVDD33), U7.34 (VDD33), U7.43 (VDD33); also elsewhere on the board
5V0_CB: C16.2, U8.2 (IN); also elsewhere on the board
/CM5_USB3_0.U3RXD_N: R38.1; also elsewhere on the board
/CM5_USB3_0.U3RXD_P: R39.1; also elsewhere on the board
/CM5_USB3_0.U3TXD_N: R42.1; also elsewhere on the board
/CM5_USB3_0.U3TXD_P: R43.1; also elsewhere on the board
/CM5_USB3_0.USB_N: R40.1; also elsewhere on the board
/CM5_USB3_0.USB_P: R41.1; also elsewhere on the board
/CM5_USB3_1.U3RXD_N: R32.1; also elsewhere on the board
/CM5_USB3_1.U3RXD_P: R33.1; also elsewhere on the board
/CM5_USB3_1.U3TXD_N: R36.1; also elsewhere on the board
/CM5_USB3_1.U3TXD_P: R37.1; also elsewhere on the board
/CM5_USB3_1.USB_N: R34.1; also elsewhere on the board
/CM5_USB3_1.USB_P: R35.1; also elsewhere on the board
/USB_3/CM5_USB3_VBUS_EN: R44.1, R45.1; also elsewhere on the board
/USB_3/PETX_N: C41.2, U7.5 (PETX_N)
/USB_3/PETX_P: C40.2, U7.4 (PETX_P)
/USB_3/U2D1_N: R150.1, U7.36 (U2D1_N)
/USB_3/U2D1_P: R145.1, U7.35 (U2D1_P)
/USB_3/U2D2_N: R117.1, U7.45 (U2D2_N)
/USB_3/U2D2_P: R88.1, U7.44 (U2D2_P)
/USB_3/U3RX1_N: R144.1, U7.32 (U3RXD1_N)
/USB_3/U3RX1_P: R136.1, U7.31 (U3RXD1_P)
/USB_3/U3RX2_N: R211.1, U7.41 (U3RXD2_N)
/USB_3/U3RX2_P: R191.1, U7.40 (U3RXD2_P)
/USB_3/U3TX1_N: C13.1, U7.29 (U3TXD1_N)
/USB_3/U3TX1_P: C11.1, U7.28 (U3TXD1_P)
/USB_3/U3TX2_N: C14.1, U7.38 (U3XTD2_N)
/USB_3/U3TX2_P: C12.1, U7.37 (U3TXD2_P)
/USB_3/USB3_0.U3RXD_N: D3.4 (I/O3), J2.5 (SSRX-), R38.2, R144.2
/USB_3/USB3_0.U3RXD_P: D3.5 (I/O4), J2.6 (SSRX+), R39.2, R136.2
/USB_3/USB3_0.U3TXD_N: D3.7 (I/O5), J2.8 (SSTX-), R42.2, R183.2
/USB_3/USB3_0.U3TXD_P: D3.8 (I/O6), J2.9 (SSTX+), R43.2, R180.2
/USB_3/USB3_0.USB_N: D3.1 (I/O1), J2.2 (D-), R40.2, R150.2
/USB_3/USB3_0.USB_P: D3.2 (I/O2), J2.3 (D+), R41.2, R145.2
/USB_3/USB3_0.USB_VBUS: C17.2, C19.2, C21.2, D3.3 (VBUS), F1.2, J2.1 (VBUS)
/USB_3/USB3_1.U3RXD_N: D4.4 (I/O3), J3.5 (SSRX-), R32.2, R211.2
/USB_3/USB3_1.U3RXD_P: D4.5 (I/O4), J3.6 (SSRX+), R33.2, R191.2
/USB_3/USB3_1.U3TXD_N: D4.7 (I/O5), J3.8 (SSTX-), R36.2, R135.2
/USB_3/USB3_1.U3TXD_P: D4.8 (I/O6), J3.9 (SSTX+), R37.2, R120.2
/USB_3/USB3_1.USB_N: D4.1 (I/O1), J3.2 (D-), R34.2, R117.2
/USB_3/USB3_1.USB_P: D4.2 (I/O2), J3.3 (D+), R35.2, R88.2
/USB_3/USB3_1.USB_VBUS: C18.2, C20.2, C22.2, D4.3 (VBUS), F2.2, J3.1 (VBUS)
/USB_3/UTXD1_N: C13.2, R183.1
/USB_3/UTXD1_P: C11.2, R180.1
/USB_3/UTXD2_N: C14.2, R135.1
/USB_3/UTXD2_P: C12.2, R120.1
/USB_HUB.CLK_N: U7.2 (PCLK_N); also elsewhere on the board
/USB_HUB.CLK_P: U7.1 (PCLK_P); also elsewhere on the board
/USB_HUB.RX_N: C41.1; also elsewhere on the board
/USB_HUB.RX_P: C40.1; also elsewhere on the board
/USB_HUB.TX_N: U7.8 (~PERX_N); also elsewhere on the board
/USB_HUB.TX_P: U7.7 (~PERX_P); also elsewhere on the board
/USB_HUB.~REQ: R60.1; also elsewhere on the board
/USB_HUB.~RST: U7.47 (~PERST); also elsewhere on the board
/USB_HUB.~WAKE: R61.2, U7.48 (~PEWAKE); also elsewhere on the board
/USB_HUB_~RST: R110.1, U7.11 (~PONRST); also elsewhere on the board
CGND: J2.10 (CGND), J2.11 (CGND), J3.10 (CGND), J3.11 (CGND), R58.1, R59.1; also elsewhere on the board
GND: C16.1, C17.1, C18.1, C19.1, C20.1, C21.1, C22.1, C23.1, C24.1, C25.1, C26.1, C27.1, C28.1, C29.1, C30.1, C31.1, C32.1, C33.1, C34.1, C35.1, C36.1, C37.1, C38.1, C39.1, C99.1, D3.6 (GND), D4.6 (GND), J2.4 (GND), J2.7 (GND), J3.4 (GND), J3.7 (GND), R46.1, R47.1, R50.1, R54.2, R58.2, R59.2, R110.2, U6.4 (GND), U7.27 (IC(L)), U7.49 (GND), U8.1 (GND), U8.9 (GND), Y1.2 (GND), Y1.4 (GND); also elsewhere on the board
unnamed: R54.1, U6.6 (SCK), U7.15 (SPISCK)
unnamed: R57.2, U6.5 (SI), U7.16 (SPISI)
unnamed: R56.2, U6.2 (SO), U7.13 (SPISO)
unnamed: R55.2, U6.1 (~CE), U7.14 (~SPICS)
unnamed: R52.2, U6.3 (~WP), U6.7 (~HOLD)
unnamed: R44.2, R46.2, U7.20 (PPON1), U8.3 (EN1)
unnamed: R45.2, R47.2, U7.18 (PPON2), U8.4 (EN2)
unnamed: R50.2, U7.26 (RREF)
unnamed: C24.2, R53.2, U7.24 (XT1), Y1.1 (XI)
unnamed: C25.2, R53.1, U7.23 (XT2), Y1.3 (XO)
unnamed: R48.1, U7.19 (~OCI1), U8.8 (FLG1)
unnamed: R49.1, U7.17 (~OCI2), U8.5 (FLG2)
unnamed: R60.2, U7.10 (~PECREQ)
unnamed: R51.1, U7.46 (~SMI)
unnamed: F1.1, U8.7 (OUT1)
unnamed: F2.1, U8.6 (OUT2)

Notes on the sheet:
CM4 = PCIe USB (DNP) CM5 = Native USB
Resistors are 1% 1/16W 0402 unless otherwise noted Capacitors are 10% 50V X7R 0402 unless otherwise noted

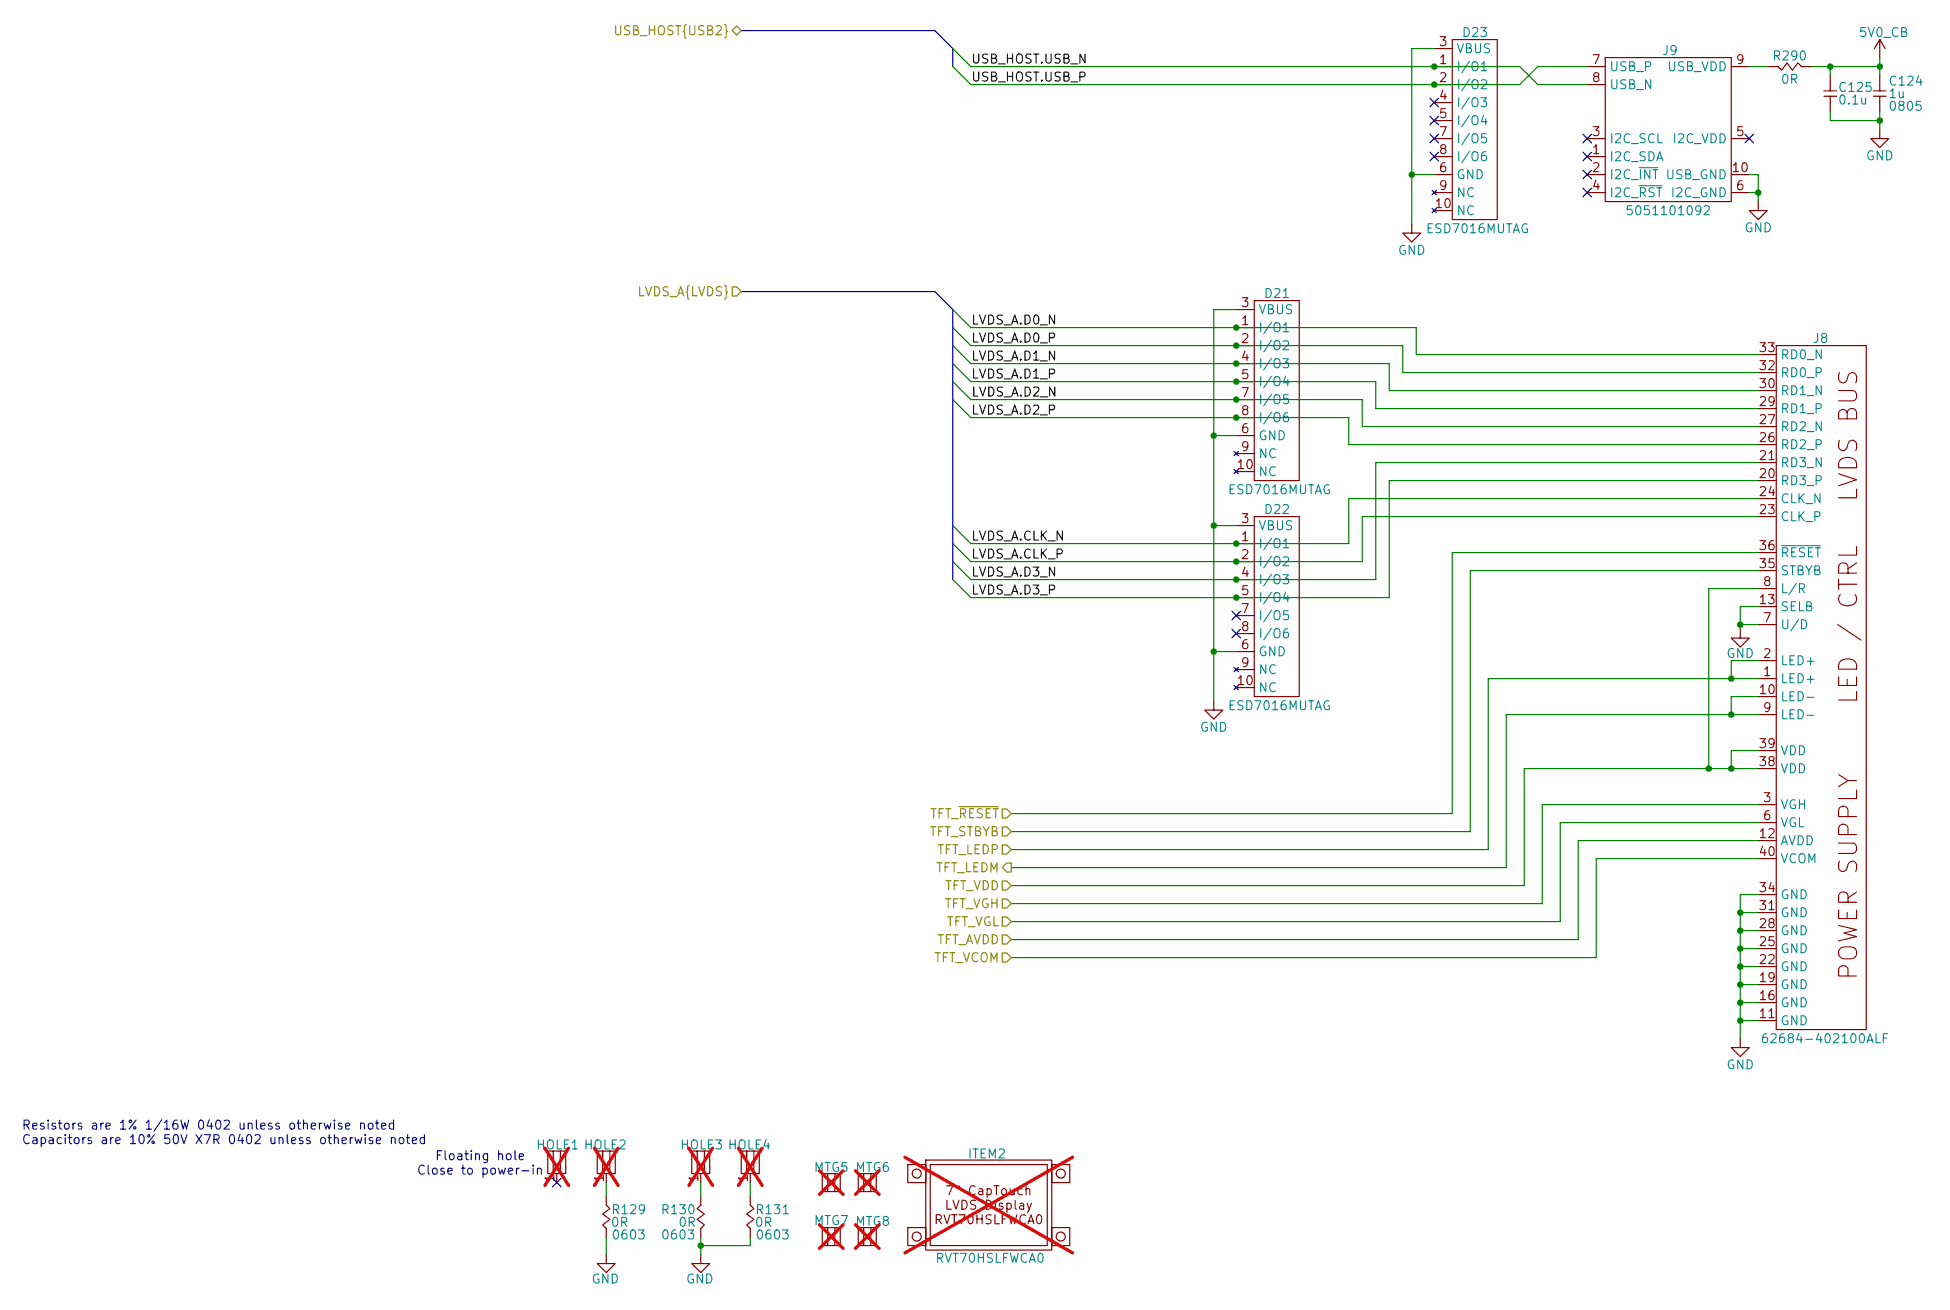
[picture p97: schematic TFT_CONN.kicad_sch, RPI CMx Carrier]

Parts:
C124: 1u; CAP_NONPOL_0805; Tolerance ±10%; Voltage Rating 50V; Manufacturer Part Number CC0805KKX7R9BB105
C125: 0.1u; CAP_NONPOL_0402; Tolerance ±10%; Voltage Rating 50V; Manufacturer Part Number GRM155R71H104KE14D
D21, D22, D23: ESD7016MUTAG; UDFN8; Manufacturer Part Number ESD7016MUTAG
HOLE1, HOLE2, HOLE3, HOLE4: MTG_hole_cir_5mm_pad_3mm_drill; not fitted
ITEM2: RVT70HSLFWCA0; Manufacturer Part Number SM-RVT70HSLFWCA0; not fitted
J8: 62684-402100ALF; Current Rating 0.5A; Voltage Rating 50V; Manufacturer Part Number 62684-402100ALF
J9: 5051101092; Current Rating 0.5A; Voltage Rating 50V; Manufacturer Part Number 5051101092
MTG5, MTG6, MTG7, MTG8: M0504-25-AL-7; Manufacturer Part Number M0504-25-AL-7; not fitted
R129, R130, R131: 0R; RES_0603; Tolerance 1%; Manufacturer Part Number RC0603JR-070RL
R290: 0R; RES_0402; Tolerance 1%; Manufacturer Part Number RC0402FR-071KL

Connections:
5V0_CB: C124.2, C125.2, R290.1; also elsewhere on the board
/DSI - LVDS bridge/LVDS_A.CLK_N: D22.1 (I/O1), J8.24 (CLK_N); also elsewhere on the board
/DSI - LVDS bridge/LVDS_A.CLK_P: D22.2 (I/O2), J8.23 (CLK_P); also elsewhere on the board
/DSI - LVDS bridge/LVDS_A.D0_N: D21.1 (I/O1), J8.33 (RD0_N); also elsewhere on the board
/DSI - LVDS bridge/LVDS_A.D0_P: D21.2 (I/O2), J8.32 (RD0_P); also elsewhere on the board
/DSI - LVDS bridge/LVDS_A.D1_N: D21.4 (I/O3), J8.30 (RD1_N); also elsewhere on the board
/DSI - LVDS bridge/LVDS_A.D1_P: D21.5 (I/O4), J8.29 (RD1_P); also elsewhere on the board
/DSI - LVDS bridge/LVDS_A.D2_N: D21.7 (I/O5), J8.27 (RD2_N); also elsewhere on the board
/DSI - LVDS bridge/LVDS_A.D2_P: D21.8 (I/O6), J8.26 (RD2_P); also elsewhere on the board
/DSI - LVDS bridge/LVDS_A.D3_N: D22.4 (I/O3), J8.21 (RD3_N); also elsewhere on the board
/DSI - LVDS bridge/LVDS_A.D3_P: D22.5 (I/O4), J8.20 (RD3_P); also elsewhere on the board
/TFT_CONN/TFT_LEDM: J8.9 (LED-), J8.10 (LED-); also elsewhere on the board
/TFT_CONN/TFT_LEDP: J8.1 (LED+), J8.2 (LED+); also elsewhere on the board
/TFT_CONN/TFT_VCOM: J8.40 (VCOM); also elsewhere on the board
/TFT_CONN/TFT_VDD: J8.8 (L/R), J8.38 (VDD), J8.39 (VDD); also elsewhere on the board
/TFT_CONN/TFT_VGH: J8.3 (VGH); also elsewhere on the board
/TFT_CONN/TFT_VGL: J8.6 (VGL); also elsewhere on the board
/TFT_CONN/USB_HOST.USB_N: D23.1 (I/O1), J9.8 (USB_N); also elsewhere on the board
/TFT_CONN/USB_HOST.USB_P: D23.2 (I/O2), J9.7 (USB_P); also elsewhere on the board
/TFT_POWER/TFT_9V6: J8.12 (AVDD); also elsewhere on the board
/TFT_POWER/TFT_~RST: J8.35 (STBYB), J8.36 (~RESET); also elsewhere on the board
GND: C124.1, C125.1, D21.3 (VBUS), D21.6 (GND), D22.3 (VBUS), D22.6 (GND), D23.3 (VBUS), D23.6 (GND), J8.7 (U/D), J8.11 (GND), J8.13 (SELB), J8.16 (GND), J8.19 (GND), J8.22 (GND), J8.25 (GND), J8.28 (GND), J8.31 (GND), J8.34 (GND), J9.6 (I2C_GND), J9.10 (USB_GND), R129.2, R130.2, R131.2; also elsewhere on the board
unnamed: HOLE2.1, R129.1
unnamed: HOLE3.1, R130.1
unnamed: HOLE4.1, R131.1
unnamed: J9.9 (USB_VDD), R290.2

Notes on the sheet:
Floating hole Close to power-in
Resistors are 1% 1/16W 0402 unless otherwise noted Capacitors are 10% 50V X7R 0402 unless otherwise noted

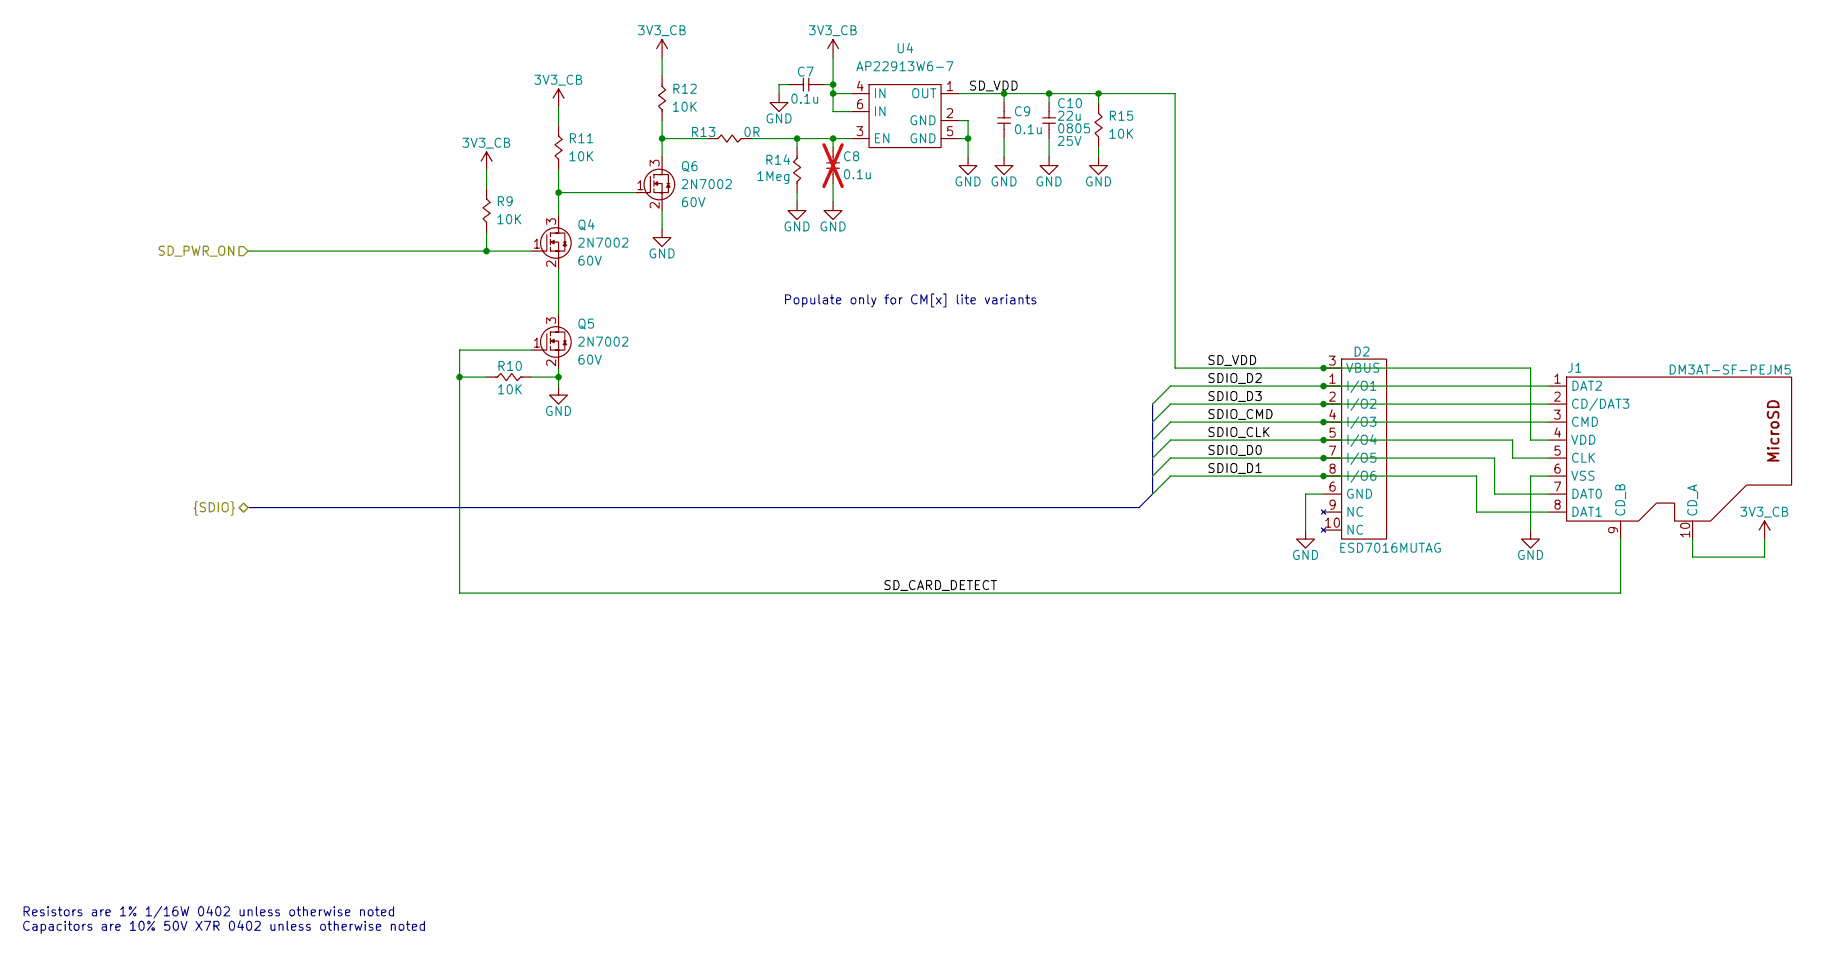
[picture p98: schematic SD_CARD.kicad_sch, RPI CMx Carrier]

Parts:
C7, C9: 0.1u; CAP_NONPOL_0402; Tolerance ±10%; Voltage Rating 50V; Manufacturer Part Number GRM155R71H104KE14D
C8: 0.1u; CAP_NONPOL_0402; Tolerance ±10%; Voltage Rating 50V; Manufacturer Part Number GRM155R71H104KE14D; not fitted
C10: 22u; CAP_NONPOL_0805; Tolerance ±20%; Voltage Rating 25V; Manufacturer Part Number CL21A226MAYNNNE
D2: ESD7016MUTAG; UDFN8; Manufacturer Part Number ESD7016MUTAG
J1: DM3AT-SF-PEJM5; Current Rating 0.5A; Voltage Rating 125V; Manufacturer Part Number DM3AT-SF-PEJM5
Q4, Q5, Q6: 2N7002; SOT-23-3; Manufacturer Part Number 2N7002-7-F
R9, R10, R11, R12, R15: 10K; RES_0402; Tolerance 1%; Manufacturer Part Number RC0402FR-0710KL
R13: 0R; RES_0402; Tolerance 1%; Manufacturer Part Number RC0402FR-071KL
R14: 1Meg; RES_0402; Tolerance 1%; Manufacturer Part Number RC0402FR-131ML
U4: AP22913W6-7; SOT-23-6; Load Voltage 1.5V ~ 5.5V; Manufacturer Part Number AP22913W6-7

Connections:
3V3_CB: C7.2, J1.10 (CD_A), R9.2, R11.2, R12.2, U4.4 (IN), U4.6 (IN); also elsewhere on the board
/SDIO_CLK: D2.5 (I/O4), J1.5 (CLK); also elsewhere on the board
/SDIO_CMD: D2.4 (I/O3), J1.3 (CMD); also elsewhere on the board
/SDIO_D0: D2.7 (I/O5), J1.7 (DAT0); also elsewhere on the board
/SDIO_D1: D2.8 (I/O6), J1.8 (DAT1); also elsewhere on the board
/SDIO_D2: D2.1 (I/O1), J1.1 (DAT2); also elsewhere on the board
/SDIO_D3: D2.2 (I/O2), J1.2 (CD/DAT3); also elsewhere on the board
/SD_CARD/SD_CARD_DETECT: J1.9 (CD_B), Q5.1 (G), R10.2
/SD_CARD/SD_VDD: C9.2, C10.2, D2.3 (VBUS), J1.4 (VDD), R15.2, U4.1 (OUT)
/SD_PWR_ON: Q4.1 (G), R9.1; also elsewhere on the board
GND: C7.1, C8.1, C9.1, C10.1, D2.6 (GND), J1.6 (VSS), Q5.2 (S), Q6.2 (S), R10.1, R14.1, R15.1, U4.2 (GND), U4.5 (GND); also elsewhere on the board
unnamed: Q4.3 (D), Q6.1 (G), R11.1
unnamed: Q4.2 (S), Q5.3 (D)
unnamed: Q6.3 (D), R12.1, R13.1
unnamed: C8.2, R13.2, R14.2, U4.3 (EN)

Notes on the sheet:
Populate only for CM[x] lite variants
Resistors are 1% 1/16W 0402 unless otherwise noted Capacitors are 10% 50V X7R 0402 unless otherwise noted
