lecejeff/RPI_CMx_Carrier/hardware/Rev1_00-0a/rpi_cm4_cm5_CarrierBoard/rpi_cm4_cm5_CarrierBoard.kicad_pcb

## KiCad design hardware/Rev1_00-0a/rpi_cm4_cm5_CarrierBoard/rpi_cm4_cm5_CarrierBoard.kicad_pcb (continued)

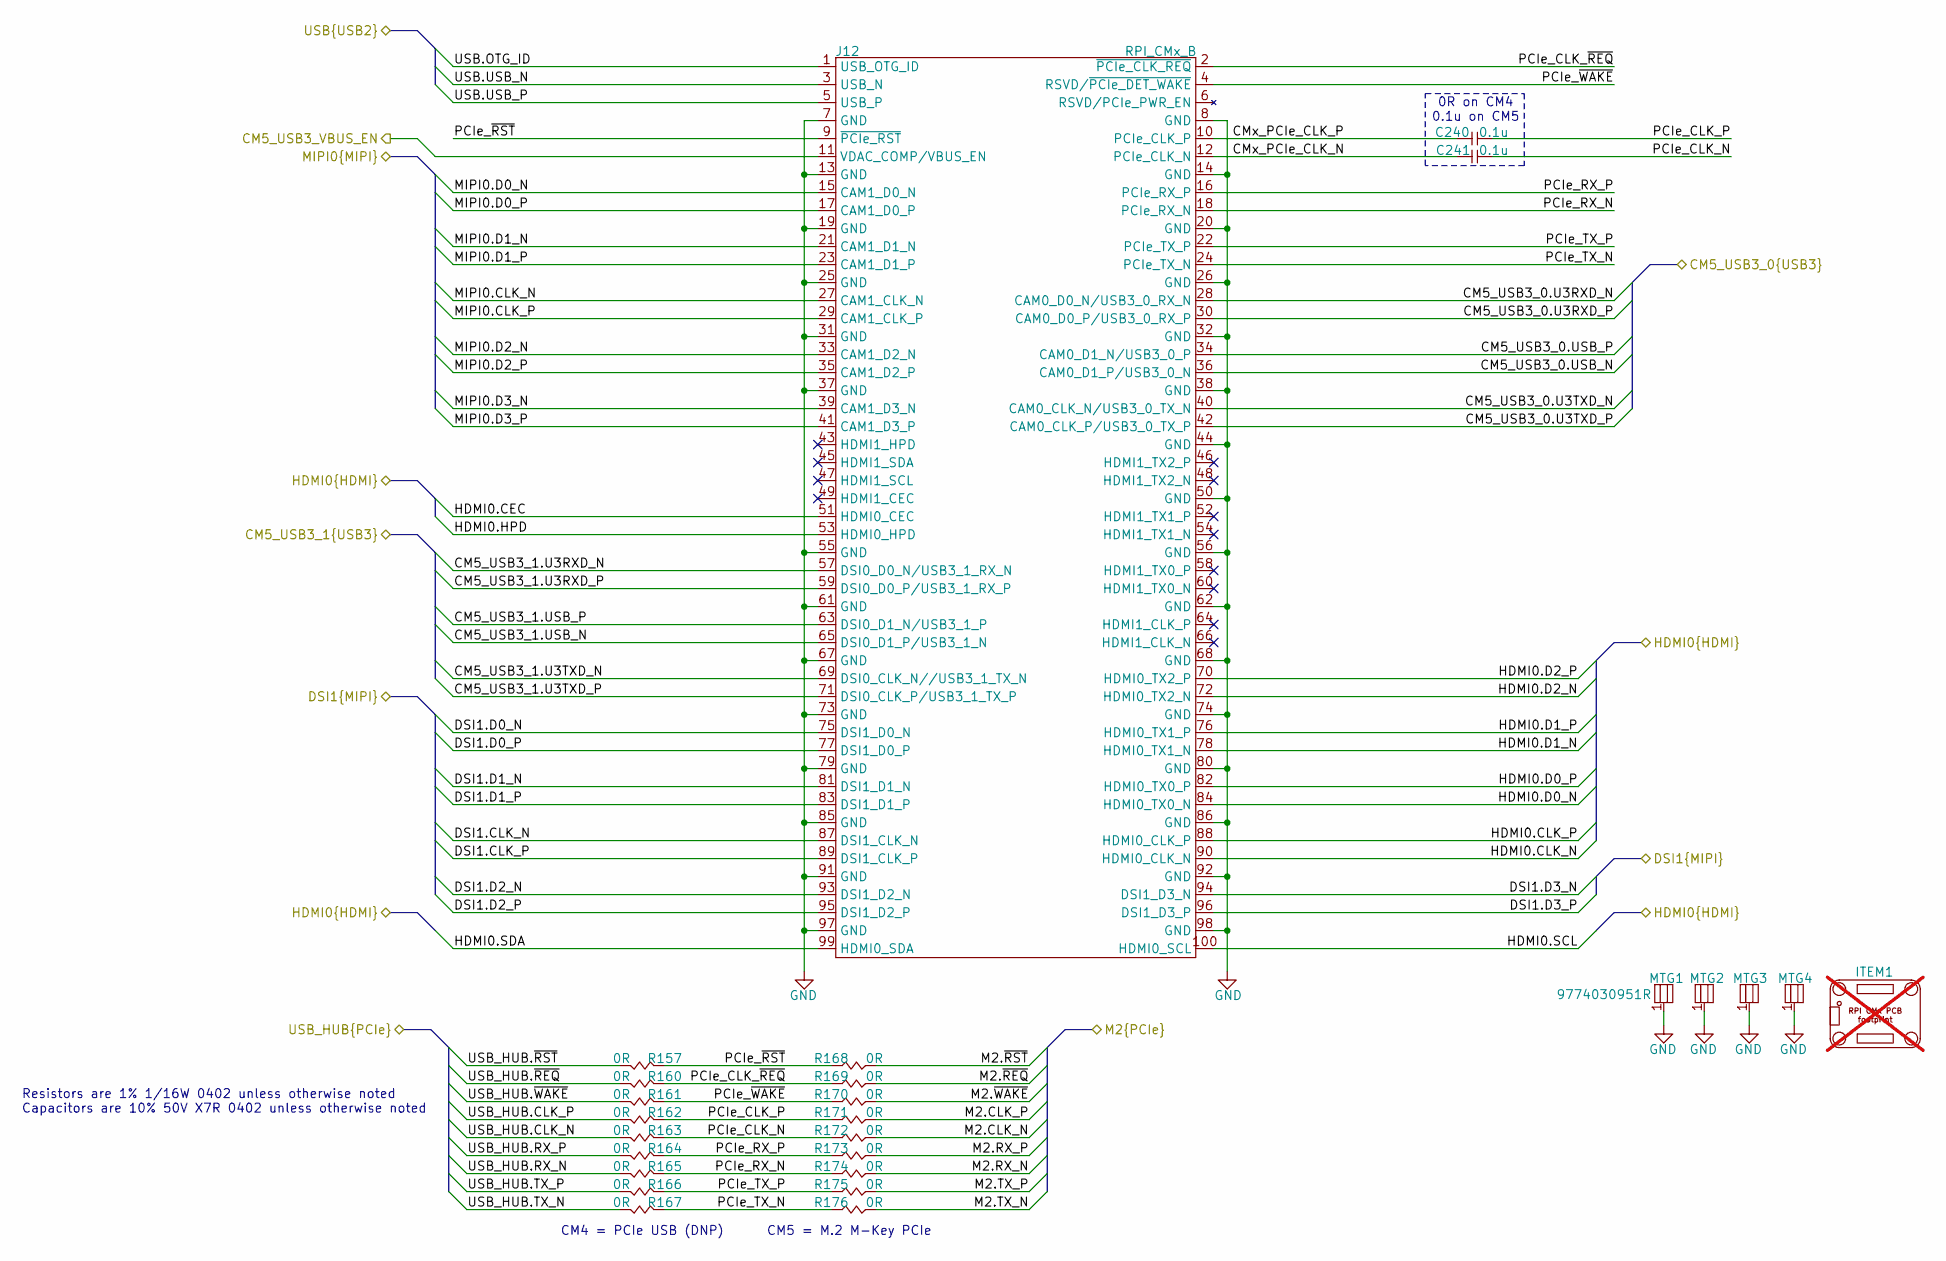
[picture p99: schematic CM4_CM5_CONN_B.kicad_sch, RPI CMx Carrier]

Parts:
C240, C241: 0.1u; CAP_NONPOL_0402; Tolerance ±10%; Voltage Rating 50V; Manufacturer Part Number GRM155R71H104KE14D
ITEM1: Raspberry PI CM4 and CM5 symbol; rPI_CM4_CM5; not fitted
J12: RPI_CMx_B; DF40HC(3.0)-100DS-0.4V; Current Rating 0.5A; Voltage Rating 150V; Manufacturer Part Number DF40HC(3.0)-100DS-0.4V(58)
MTG1, MTG2, MTG3, MTG4: 9774030951R; 9774030151R; Manufacturer Part Number 9774030951R
R157, R160, R161, R162, R163, R164, R165, R166, R167, R168, R169, R170, R171, R172, R173, R174, R175, R176: 0R; RES_0402; Tolerance 1%; Manufacturer Part Number RC0402FR-071KL

Connections:
/CM4_CM5_CONN_B/CMx_PCIe_CLK_N: C241.1, J12.12 (PCIe_CLK_N)
/CM4_CM5_CONN_B/CMx_PCIe_CLK_P: C240.1, J12.10 (PCIe_CLK_P)
/CM4_CM5_CONN_B/PCIe_CLK_N: C241.2, R163.1, R172.1
/CM4_CM5_CONN_B/PCIe_CLK_P: C240.2, R162.1, R171.1
/CM4_CM5_CONN_B/PCIe_CLK_~REQ: J12.2 (~PCIe_CLK_REQ), R160.1, R169.1
/CM4_CM5_CONN_B/PCIe_RX_N: J12.18 (PCIe_RX_N), R165.1, R174.1
/CM4_CM5_CONN_B/PCIe_RX_P: J12.16 (PCIe_RX_P), R164.1, R173.1
/CM4_CM5_CONN_B/PCIe_TX_N: J12.24 (PCIe_TX_N), R167.1, R176.1
/CM4_CM5_CONN_B/PCIe_TX_P: J12.22 (PCIe_TX_P), R166.1, R175.1
/CM4_CM5_CONN_B/PCIe_~RST: J12.9 (~PCIe_RST), R157.1, R168.1
/CM4_CM5_CONN_B/PCIe_~WAKE: J12.4 (RSVD/~PCIe_DET_WAKE), R161.1, R170.1
/CM5_USB3_0.U3RXD_N: J12.28 (CAM0_D0_N/USB3_0_RX_N); also elsewhere on the board
/CM5_USB3_0.U3RXD_P: J12.30 (CAM0_D0_P/USB3_0_RX_P); also elsewhere on the board
/CM5_USB3_0.U3TXD_N: J12.40 (CAM0_CLK_N/USB3_0_TX_N); also elsewhere on the board
/CM5_USB3_0.U3TXD_P: J12.42 (CAM0_CLK_P/USB3_0_TX_P); also elsewhere on the board
/CM5_USB3_0.USB_N: J12.36 (CAM0_D1_P/USB3_0_N); also elsewhere on the board
/CM5_USB3_0.USB_P: J12.34 (CAM0_D1_N/USB3_0_P); also elsewhere on the board
/CM5_USB3_1.U3RXD_N: J12.57 (DSI0_D0_N/USB3_1_RX_N); also elsewhere on the board
/CM5_USB3_1.U3RXD_P: J12.59 (DSI0_D0_P/USB3_1_RX_P); also elsewhere on the board
/CM5_USB3_1.U3TXD_N: J12.69 (DSI0_CLK_N//USB3_1_TX_N); also elsewhere on the board
/CM5_USB3_1.U3TXD_P: J12.71 (DSI0_CLK_P/USB3_1_TX_P); also elsewhere on the board
/CM5_USB3_1.USB_N: J12.65 (DSI0_D1_P/USB3_1_N); also elsewhere on the board
/CM5_USB3_1.USB_P: J12.63 (DSI0_D1_N/USB3_1_P); also elsewhere on the board
/DSI1.CLK_N: J12.87 (DSI1_CLK_N); also elsewhere on the board
/DSI1.CLK_P: J12.89 (DSI1_CLK_P); also elsewhere on the board
/DSI1.D0_N: J12.75 (DSI1_D0_N); also elsewhere on the board
/DSI1.D0_P: J12.77 (DSI1_D0_P); also elsewhere on the board
/DSI1.D1_N: J12.81 (DSI1_D1_N); also elsewhere on the board
/DSI1.D1_P: J12.83 (DSI1_D1_P); also elsewhere on the board
/DSI1.D2_N: J12.93 (DSI1_D2_N); also elsewhere on the board
/DSI1.D2_P: J12.95 (DSI1_D2_P); also elsewhere on the board
/DSI1.D3_N: J12.94 (DSI1_D3_N); also elsewhere on the board
/DSI1.D3_P: J12.96 (DSI1_D3_P); also elsewhere on the board
/HDMI0.CEC: J12.51 (HDMI0_CEC); also elsewhere on the board
/HDMI0.CLK_N: J12.90 (HDMI0_CLK_N); also elsewhere on the board
/HDMI0.CLK_P: J12.88 (HDMI0_CLK_P); also elsewhere on the board
/HDMI0.D0_N: J12.84 (HDMI0_TX0_N); also elsewhere on the board
/HDMI0.D0_P: J12.82 (HDMI0_TX0_P); also elsewhere on the board
/HDMI0.D1_N: J12.78 (HDMI0_TX1_N); also elsewhere on the board
/HDMI0.D1_P: J12.76 (HDMI0_TX1_P); also elsewhere on the board
/HDMI0.D2_N: J12.72 (HDMI0_TX2_N); also elsewhere on the board
/HDMI0.D2_P: J12.70 (HDMI0_TX2_P); also elsewhere on the board
/HDMI0.HPD: J12.53 (HDMI0_HPD); also elsewhere on the board
/HDMI0.SCL: J12.100 (HDMI0_SCL); also elsewhere on the board
/HDMI0.SDA: J12.99 (HDMI0_SDA); also elsewhere on the board
/M2.CLK_N: R172.2; also elsewhere on the board
/M2.CLK_P: R171.2; also elsewhere on the board
/M2.RX_N: R174.2; also elsewhere on the board
/M2.RX_P: R173.2; also elsewhere on the board
/M2.TX_N: R176.2; also elsewhere on the board
/M2.TX_P: R175.2; also elsewhere on the board
/M2.~REQ: R169.2; also elsewhere on the board
/M2.~RST: R168.2; also elsewhere on the board
/M2.~WAKE: R170.2; also elsewhere on the board
/MIPI0.CLK_N: J12.27 (CAM1_CLK_N); also elsewhere on the board
/MIPI0.CLK_P: J12.29 (CAM1_CLK_P); also elsewhere on the board
/MIPI0.D0_N: J12.15 (CAM1_D0_N); also elsewhere on the board
/MIPI0.D0_P: J12.17 (CAM1_D0_P); also elsewhere on the board
/MIPI0.D1_N: J12.21 (CAM1_D1_N); also elsewhere on the board
/MIPI0.D1_P: J12.23 (CAM1_D1_P); also elsewhere on the board
/MIPI0.D2_N: J12.33 (CAM1_D2_N); also elsewhere on the board
/MIPI0.D2_P: J12.35 (CAM1_D2_P); also elsewhere on the board
/MIPI0.D3_N: J12.39 (CAM1_D3_N); also elsewhere on the board
/MIPI0.D3_P: J12.41 (CAM1_D3_P); also elsewhere on the board
/USB.OTG_ID: J12.1 (USB_OTG_ID); also elsewhere on the board
/USB.USB_N: J12.3 (USB_N); also elsewhere on the board
/USB.USB_P: J12.5 (USB_P); also elsewhere on the board
/USB_3/CM5_USB3_VBUS_EN: J12.11 (VDAC_COMP/VBUS_EN); also elsewhere on the board
/USB_HUB.CLK_N: R163.2; also elsewhere on the board
/USB_HUB.CLK_P: R162.2; also elsewhere on the board
/USB_HUB.RX_N: R165.2; also elsewhere on the board
/USB_HUB.RX_P: R164.2; also elsewhere on the board
/USB_HUB.TX_N: R167.2; also elsewhere on the board
/USB_HUB.TX_P: R166.2; also elsewhere on the board
/USB_HUB.~REQ: R160.2; also elsewhere on the board
/USB_HUB.~RST: R157.2; also elsewhere on the board
/USB_HUB.~WAKE: R161.2; also elsewhere on the board
GND: J12.7 (GND), J12.8 (GND), J12.13 (GND), J12.14 (GND), J12.19 (GND), J12.20 (GND), J12.25 (GND), J12.26 (GND), J12.31 (GND), J12.32 (GND), J12.37 (GND), J12.38 (GND), J12.44 (GND), J12.50 (GND), J12.55 (GND), J12.56 (GND), J12.61 (GND), J12.62 (GND), J12.67 (GND), J12.68 (GND), J12.73 (GND), J12.74 (GND), J12.79 (GND), J12.80 (GND), J12.85 (GND), J12.86 (GND), J12.91 (GND), J12.92 (GND), J12.97 (GND), J12.98 (GND), MTG1.1, MTG2.1, MTG3.1, MTG4.1; also elsewhere on the board

Notes on the sheet:
Resistors are 1% 1/16W 0402 unless otherwise noted Capacitors are 10% 50V X7R 0402 unless otherwise noted
0R on CM4 0.1u on CM5
CM4 = PCIe USB (DNP)
CM5 = M.2 M-Key PCIe

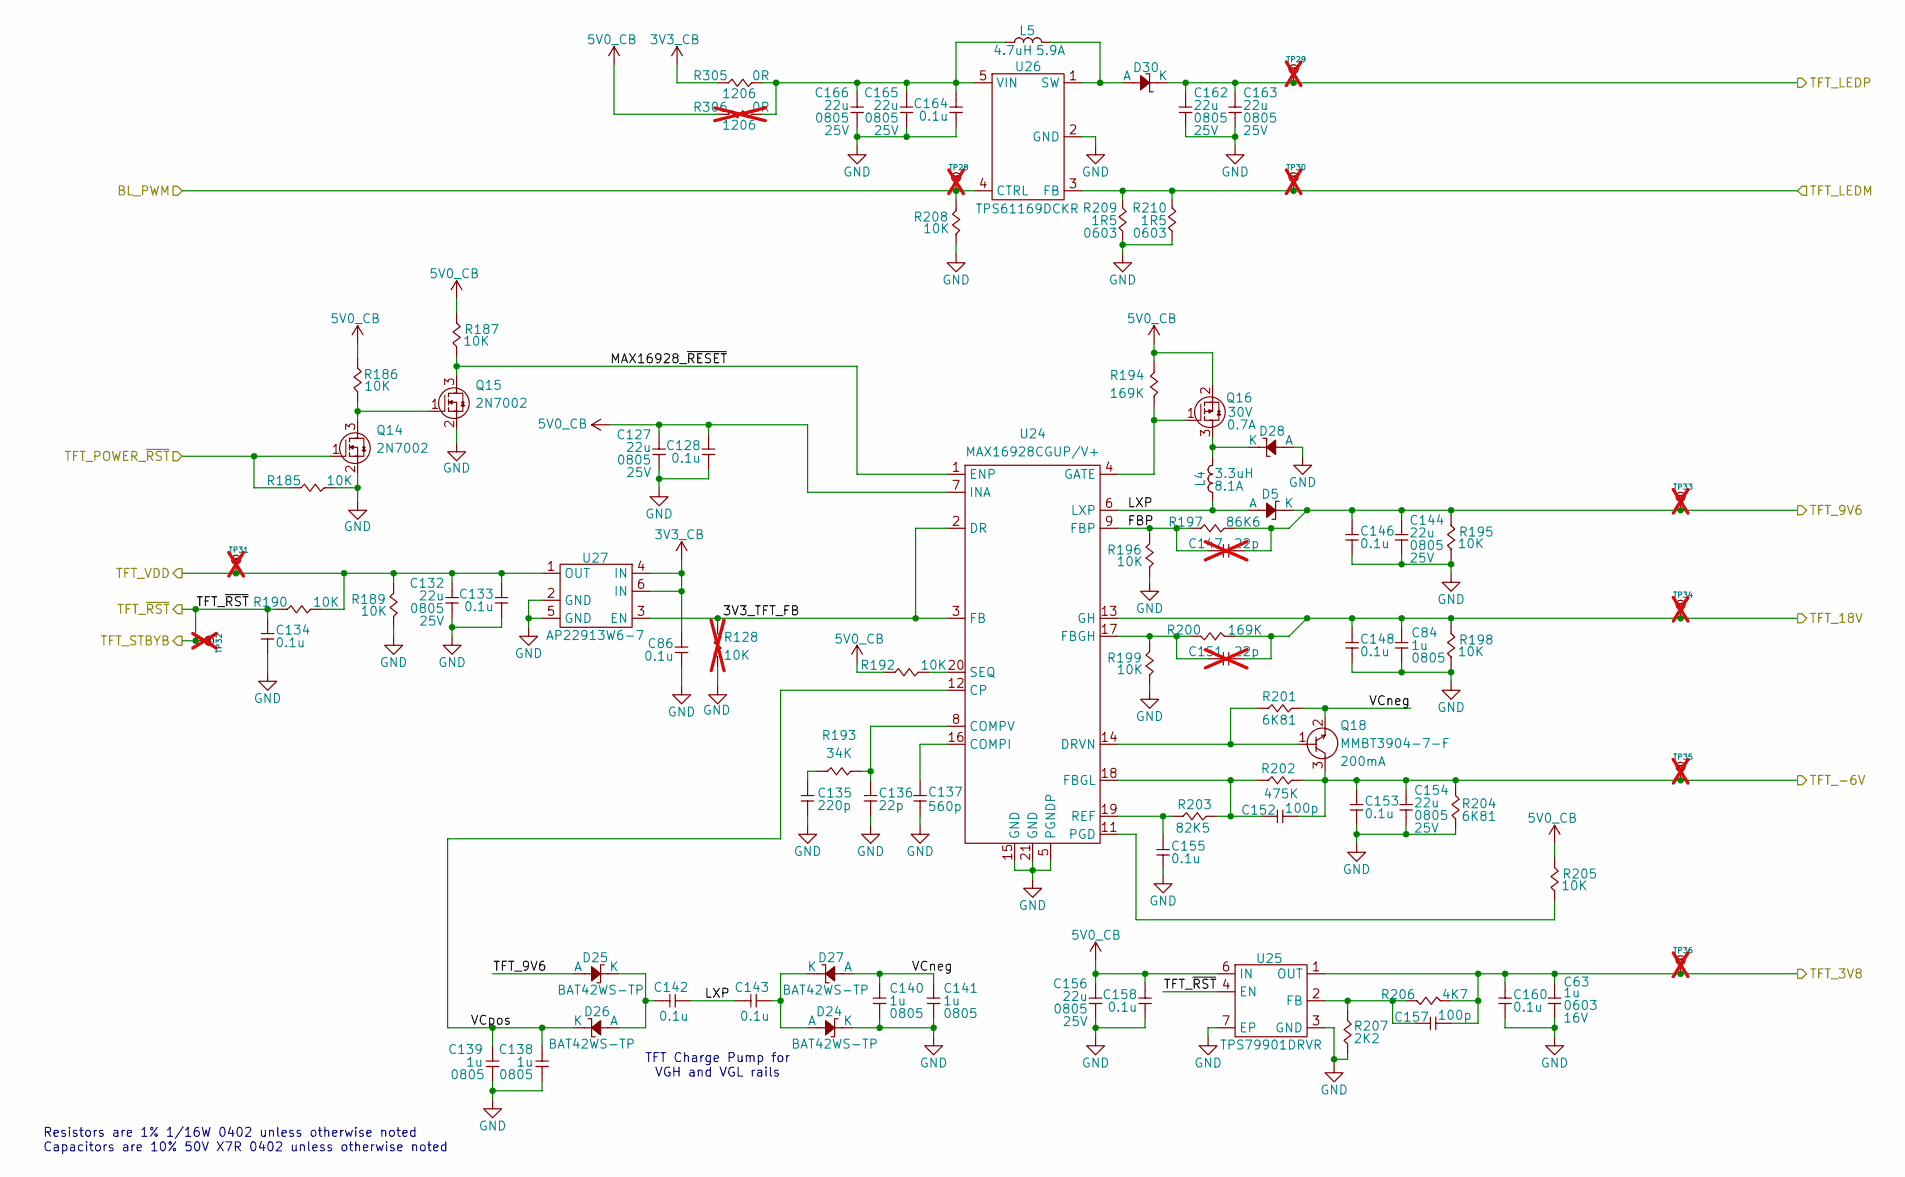
[picture p100: schematic TFT_POWER.kicad_sch, RPI CMx Carrier]

Parts:
C63: 1u; CAP_NONPOL_0603; Tolerance ±10%; Voltage Rating 16V; Manufacturer Part Number CC0603KRX7R7BB105
C84, C138, C139, C140, C141: 1u; CAP_NONPOL_0805; Tolerance ±10%; Voltage Rating 50V; Manufacturer Part Number CC0805KKX7R9BB105
C86, C128, C133, C134, C142, C143, C146, C148, C153, C155, C158, C160, C164: 0.1u; CAP_NONPOL_0402; Tolerance ±10%; Voltage Rating 50V; Manufacturer Part Number GRM155R71H104KE14D
C127, C132, C144, C154, C156, C162, C163, C165, C166: 22u; CAP_NONPOL_0805; Tolerance ±20%; Voltage Rating 25V; Manufacturer Part Number CL21A226MAYNNNE
C135: 220p; CAP_NONPOL_0402; Tolerance ±5%; Voltage Rating 50V; Manufacturer Part Number CL05C221JB5NNNC
C136: 22p; CAP_NONPOL_0402; Tolerance ±10%; Voltage Rating 50V; Manufacturer Part Number C0402C220K5GACTU
C137: 560p; CAP_NONPOL_0402; Tolerance ±5%; Voltage Rating 50V; Manufacturer Part Number GRM1555C1H561JA01D
C147, C151: 22p; CAP_NONPOL_0402; Tolerance ±10%; Voltage Rating 50V; Manufacturer Part Number C0402C220K5GACTU; not fitted
C152, C157: 100p; CAP_NONPOL_0402; Tolerance ±5%; Voltage Rating 50V; Manufacturer Part Number CC0402JRNPO9BN101
D5, D24, D25, D26, D27, D28: BAT42WS-TP; SOD-323; Tolerance NA; Manufacturer Part Number BAT42WS-TP
D30: SK34A-LTP; DO-214AC; Tolerance NA; Manufacturer Part Number SK34A-LTP
L4: PA5003.332NLT; PA5003; Tolerance ±20%; Manufacturer Part Number PA5003.332NLT
L5: PA5003.472NLT; PA5003; Tolerance ±20%; Manufacturer Part Number PA5003.472NLT
Q14, Q15: 2N7002; SOT-23-3; Manufacturer Part Number 2N7002-7-F
Q16: DMP3030SN-7; SOT-23-3; Manufacturer Part Number DMP3030SN-7
Q18: MMBT3904-7-F; SOT-23-3; Manufacturer Part Number MMBT3904-7-F
R128: 10K; RES_0402; Tolerance 1%; Manufacturer Part Number RC0402FR-0710KL; not fitted
R185, R186, R187, R189, R190, R192, R195, R196, R198, R199, R205, R208: 10K; RES_0402; Tolerance 1%; Manufacturer Part Number RC0402FR-0710KL
R193: 34K; RES_0402; Tolerance 1%; Manufacturer Part Number RC0402FR-1334KL
R194, R200: 169K; RES_0402; Tolerance 1%; Manufacturer Part Number RC0402FR-07169KL
R197: 86K6; RES_0402; Tolerance 1%; Manufacturer Part Number AC0402FR-0786K6L
R201, R204: 6K81; RES_0402; Tolerance 1%; Manufacturer Part Number RC0402FR-076K81L
R202: 475K; RES_0402; Tolerance 1%; Manufacturer Part Number RC0402FR-07475KL
R203: 82K5; RES_0402; Tolerance 1%; Manufacturer Part Number RC0402FR-0782K5L
R206: 4K7; RES_0402; Tolerance 1%; Manufacturer Part Number RC0402FR-074K7L
R207: 2K2; RES_0402; Tolerance 1%; Manufacturer Part Number RC0402FR-072K2P
R209, R210: 1R5; RES_0603; Tolerance 1%; Manufacturer Part Number RC0603FR-131R5L
R305: 0R; RES_1206; Tolerance 1%; Manufacturer Part Number RC1206JR-070RL
R306: 0R; RES_1206; Tolerance 1%; Manufacturer Part Number RC1206JR-070RL; not fitted
TP28, TP29, TP30, TP31, TP32, TP33, TP34, TP35, TP36: 28 mils; SMT_TP_28_MILS; Manufacturer Part Number NA; not fitted
U24: MAX16928CGUP/V+; TSSOP-20-EP; Input Voltage (Min) 3V; Input Voltage (Max) 5.5V; Manufacturer Part Number MAX16928CGUP/V+
U25: TPS79901DRVR; WSON-6-EP; Input Voltage (Min) 2.7V; Input Voltage (Max) 6.5V; Manufacturer Part Number TPS79901DRVR
U26: TPS61169DCKR; SC-70-5; Input Voltage (Min) 2.7V; Input Voltage (Max) 5.5V; Manufacturer Part Number TPS61169DCKR
U27: AP22913W6-7; SOT-23-6; Load Voltage 1.5V ~ 5.5V; Manufacturer Part Number AP22913W6-7

Connections:
3V3_CB: C86.2, R305.1, U27.4 (IN), U27.6 (IN); also elsewhere on the board
5V0_CB: C127.2, C128.2, C156.2, C158.2, Q16.2 (S), R186.2, R187.2, R192.2, R194.2, R205.2, R306.1, U24.7 (INA), U25.6 (IN); also elsewhere on the board
/CM4_CM5_CONN_A/PWM_0: R208.2, TP28.1, U26.4 (CTRL); also elsewhere on the board
/TFT_CONN/TFT_LEDM: R209.2, R210.2, TP30.1, U26.3 (FB); also elsewhere on the board
/TFT_CONN/TFT_LEDP: C162.2, C163.2, D30.1 (K), TP29.1; also elsewhere on the board
/TFT_CONN/TFT_VCOM: C63.2, C157.2, C160.2, R206.1, TP36.1, U25.1 (OUT); also elsewhere on the board
/TFT_CONN/TFT_VDD: C132.2, C133.2, R189.2, R190.1, TP31.1, U27.1 (OUT); also elsewhere on the board
/TFT_CONN/TFT_VGH: C84.2, C148.2, C151.1, R198.2, R200.1, TP34.1, U24.13 (GH); also elsewhere on the board
/TFT_CONN/TFT_VGL: C152.2, C153.2, C154.2, Q18.3 (C), R202.2, R204.2, TP35.1; also elsewhere on the board
/TFT_POWER/3V3_TFT_FB: R128.2, U24.2 (DR), U24.3 (FB), U27.3 (EN)
/TFT_POWER/FBP: C147.2, R196.2, R197.1, U24.9 (FBP)
/TFT_POWER/LXP: C142.1, C143.2, D5.2 (A), L4.1, U24.6 (LXP)
/TFT_POWER/MAX16928_~RESET: Q15.3 (D), R187.1, U24.1 (ENP)
/TFT_POWER/TFT_9V6: C144.2, C146.2, C147.1, D5.1 (K), D25.2 (A), R195.2, R197.2, TP33.1; also elsewhere on the board
/TFT_POWER/TFT_~RST: C134.2, R190.2, TP32.1, U25.4 (EN); also elsewhere on the board
/TFT_POWER/VCneg: C140.2, C141.2, D27.2 (A), Q18.2 (E), R201.2
/TFT_POWER/VCpos: C138.2, C139.2, D26.1 (K), U24.12 (CP)
/TFT_POWER_~RST: Q14.1 (G), R185.2; also elsewhere on the board
GND: C63.1, C84.1, C86.1, C127.1, C128.1, C132.1, C133.1, C134.1, C135.1, C136.1, C137.1, C138.1, C139.1, C140.1, C141.1, C144.1, C146.1, C148.1, C153.1, C154.1, C155.1, C156.1, C158.1, C160.1, C162.1, C163.1, C164.1, C165.1, C166.1, D24.1 (K), D28.2 (A), Q14.2 (S), Q15.2 (S), R128.1, R185.1, R189.1, R195.1, R196.1, R198.1, R199.1, R204.1, R207.1, R208.1, R209.1, R210.1, U24.5 (PGNDP), U24.15 (GND), U24.21 (GND), U25.3 (GND), U25.7 (EP), U26.2 (GND), U27.2 (GND), U27.5 (GND); also elsewhere on the board
unnamed: C135.2, R193.1
unnamed: C143.1, D24.2 (A), D27.1 (K)
unnamed: C142.2, D25.1 (K), D26.2 (A)
unnamed: D28.1 (K), L4.2, Q16.3 (D)
unnamed: D30.2 (A), L5.2, U26.1 (SW)
unnamed: Q14.3 (D), Q15.1 (G), R186.1
unnamed: Q16.1 (G), R194.1, U24.4 (GATE)
unnamed: Q18.1 (B), R201.1, U24.14 (DRVN)
unnamed: C137.2, U24.16 (COMPI)
unnamed: C136.2, R193.2, U24.8 (COMPV)
unnamed: C151.2, R199.2, R200.2, U24.17 (FBGH)
unnamed: C152.1, R202.1, R203.2, U24.18 (FBGL)
unnamed: R205.1, U24.11 (PGD)
unnamed: C155.2, R203.1, U24.19 (REF)
unnamed: R192.1, U24.20 (SEQ)
unnamed: C157.1, R206.2, R207.2, U25.2 (FB)
unnamed: C164.2, C165.2, C166.2, L5.1, R305.2, R306.2, U26.5 (VIN)

Notes on the sheet:
Resistors are 1% 1/16W 0402 unless otherwise noted Capacitors are 10% 50V X7R 0402 unless otherwise noted
TFT Charge Pump for VGH and VGL rails

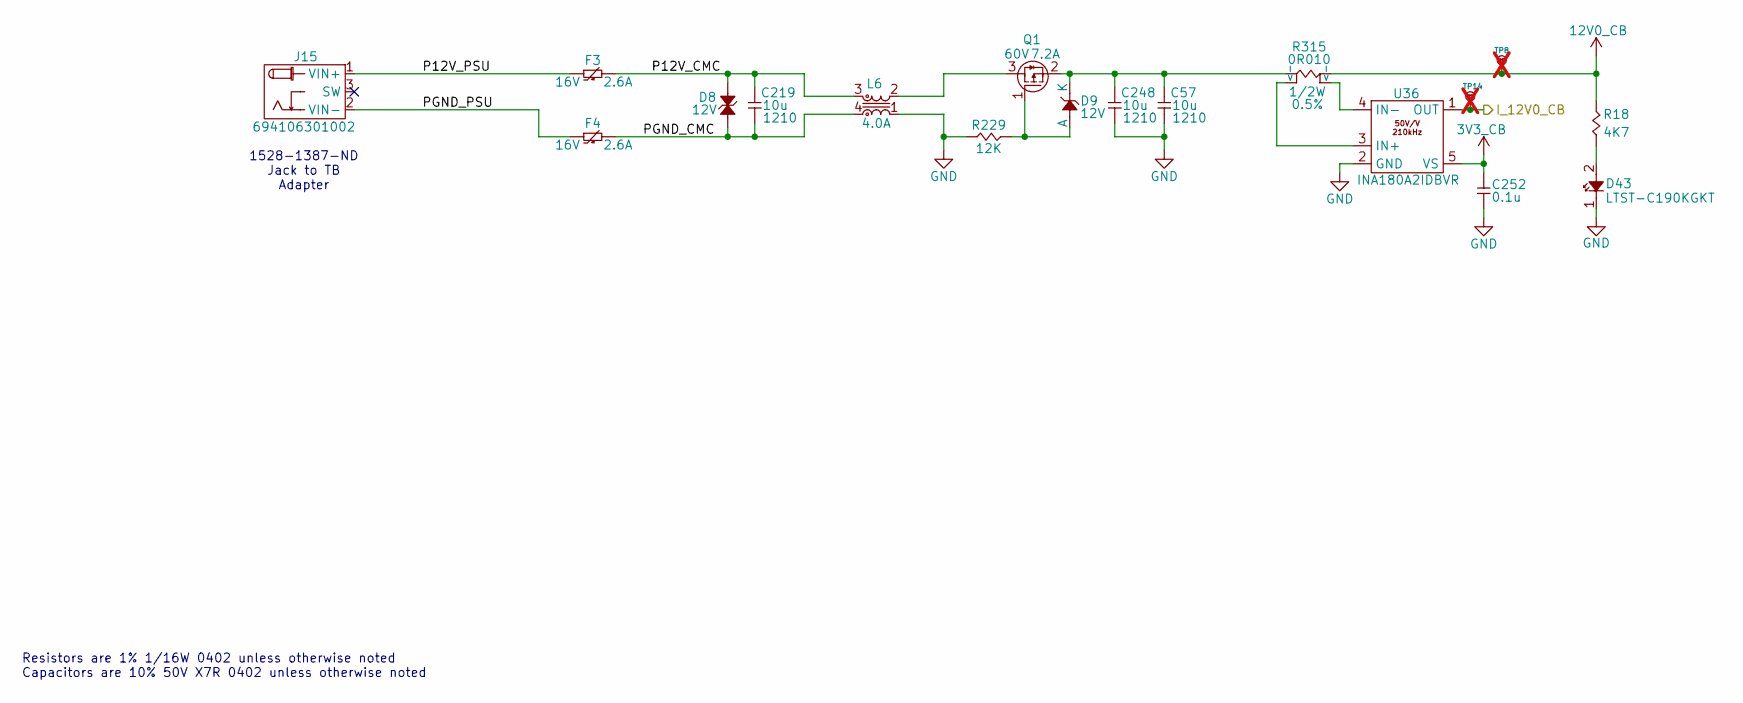
[picture p101: schematic POWER INPUT.kicad_sch, RPI CMx Carrier]

Parts:
C57, C219, C248: 10u; CAP_NONPOL_1210; Tolerance ±10%; Voltage Rating 50V; Manufacturer Part Number C3225X7R1H106K250AC
C252: 0.1u; CAP_NONPOL_0402; Tolerance ±10%; Voltage Rating 50V; Manufacturer Part Number GRM155R71H104KE14D
D8: SMAJ12CA; DO-214AC; Manufacturer Part Number SMAJ12CA
D9: MMSZ5242B-TP; SOD-123; Tolerance ±5%; Manufacturer Part Number MMSZ5242B-TP
D43: LTST-C190KGKT; LED_0603; Tolerance NA; Manufacturer Part Number LTST-C190KGKT
F3, F4: MINISMDC260F/16-2; PTC_1812; Voltage 16V; Manufacturer Part Number MINISMDC260F/16-2
J15: 694106301002; Current Rating 5A; Voltage Rating 24V; Manufacturer Part Number 694106301002
L6: CM7060P701R-10; CM7060; Tolerance NA; Manufacturer Part Number CM7060P701R-10
Q1: DMPH6050SK3-13; TO-252-3; Manufacturer Part Number DMPH6050SK3-13
R18: 4K7; RES_0402; Tolerance 1%; Manufacturer Part Number RC0402FR-074K7L
R229: 12K; RES_0402; Tolerance 1%; Manufacturer Part Number RC0402FR-1312KL
R315: 0R010; RES_SENSE_1206; Tolerance 0.5%; Manufacturer Part Number LVK12R010DER
TP8, TP14: 28 mils; SMT_TP_28_MILS; Manufacturer Part Number NA; not fitted
U36: INA180A2IDBVR; SOT-23-5; Offset Voltage 100uV; Supply Voltage 2.7V ~ 5.5V; Manufacturer Part Number INA180A2IDBVR

Connections:
3V3_CB: C252.2, U36.5 (VS); also elsewhere on the board
12V0_CB: R18.2, R315.4 (I), TP8.1; also elsewhere on the board
/PIC32AK1216/I_12V0_CB: TP14.1, U36.1 (OUT); also elsewhere on the board
/POWER INPUT/P12V_CMC: C219.2, D8.2, F3.2, L6.3
/POWER INPUT/P12V_PSU: F3.1, J15.1 (VIN+)
/POWER INPUT/PGND_CMC: C219.1, D8.1, F4.2, L6.4
/POWER INPUT/PGND_PSU: F4.1, J15.2 (VIN-)
GND: C57.1, C248.1, C252.1, D43.1 (K), L6.1, R229.1, U36.2 (GND); also elsewhere on the board
unnamed: D9.2 (A), Q1.1 (G), R229.2
unnamed: C57.2, C248.2, D9.1 (K), Q1.2 (S), R315.1 (I)
unnamed: D43.2 (A), R18.1
unnamed: L6.2, Q1.3 (D)
unnamed: R315.2 (V), U36.3 (IN+)
unnamed: R315.3 (V), U36.4 (IN-)

Notes on the sheet:
1528-1387-ND Jack to TB Adapter
Resistors are 1% 1/16W 0402 unless otherwise noted Capacitors are 10% 50V X7R 0402 unless otherwise noted

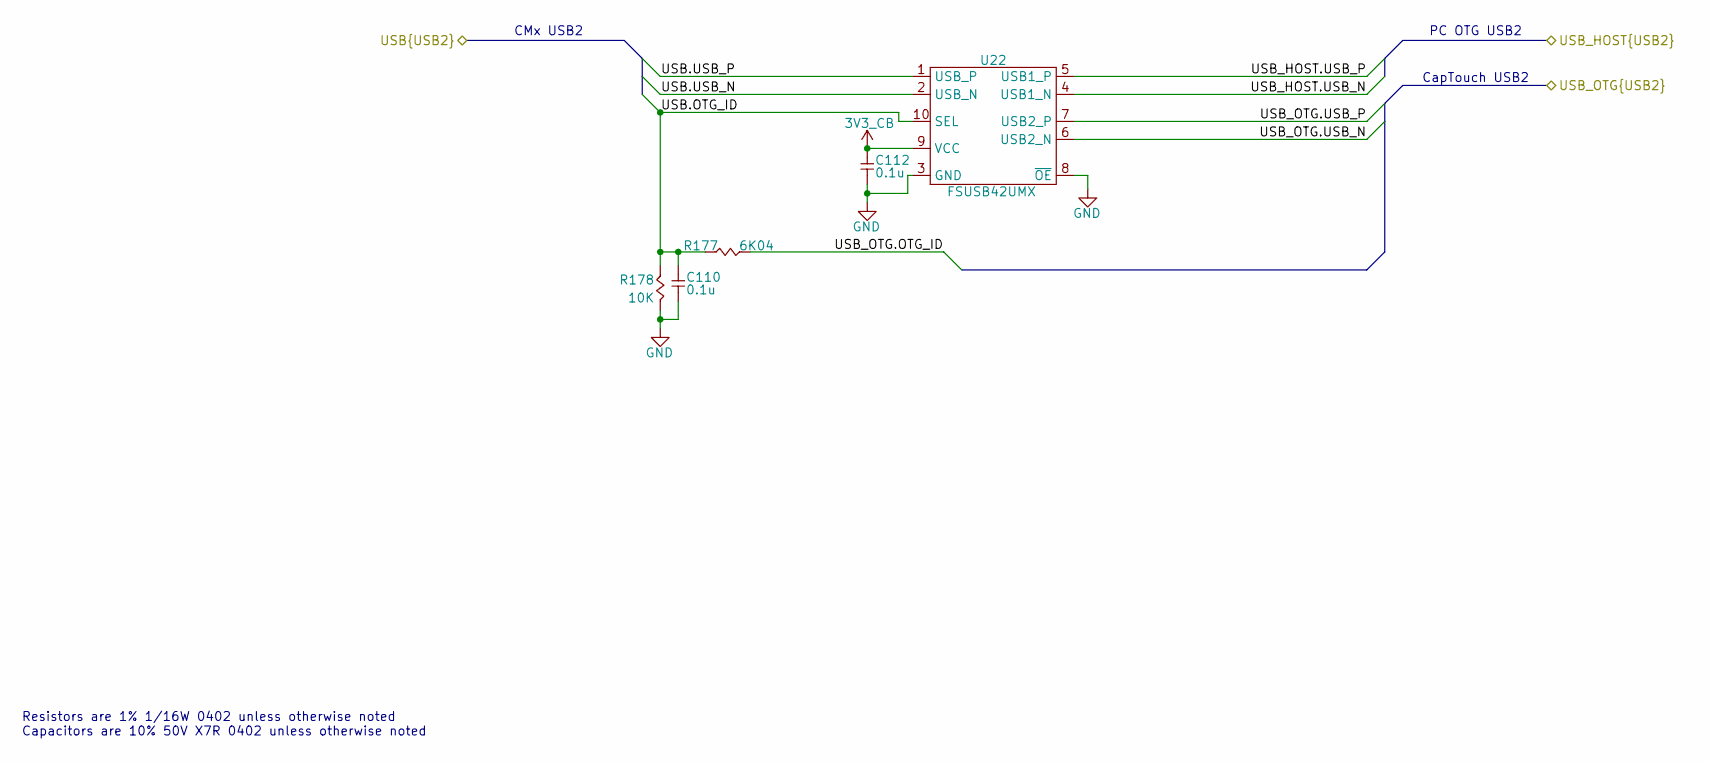
[picture p102: schematic USB_MUX.kicad_sch, RPI CMx Carrier]

Parts:
C110, C112: 0.1u; CAP_NONPOL_0402; Tolerance ±10%; Voltage Rating 50V; Manufacturer Part Number GRM155R71H104KE14D
R177: 6K04; RES_0402; Tolerance 1%; Manufacturer Part Number RC0402FR-076K04P
R178: 10K; RES_0402; Tolerance 1%; Manufacturer Part Number RC0402FR-0710KL
U22: FSUSB42UMX; 10-UMLP; Supply Voltage 2.4V ~ 4.4V; Manufacturer Part Number FSUSB42UMX

Connections:
3V3_CB: C112.2, U22.9 (VCC); also elsewhere on the board
/TFT_CONN/USB_HOST.USB_N: U22.4 (USB1_N); also elsewhere on the board
/TFT_CONN/USB_HOST.USB_P: U22.5 (USB1_P); also elsewhere on the board
/USB.OTG_ID: C110.2, R177.1, R178.2, U22.10 (SEL); also elsewhere on the board
/USB.USB_N: U22.2 (USB_N); also elsewhere on the board
/USB.USB_P: U22.1 (USB_P); also elsewhere on the board
/USB_OTG.OTG_ID: R177.2; also elsewhere on the board
/USB_OTG.USB_N: U22.6 (USB2_N); also elsewhere on the board
/USB_OTG.USB_P: U22.7 (USB2_P); also elsewhere on the board
GND: C110.1, C112.1, R178.1, U22.3 (GND), U22.8 (~OE); also elsewhere on the board

Notes on the sheet:
CapTouch USB2
Resistors are 1% 1/16W 0402 unless otherwise noted Capacitors are 10% 50V X7R 0402 unless otherwise noted
CMx USB2
PC OTG USB2

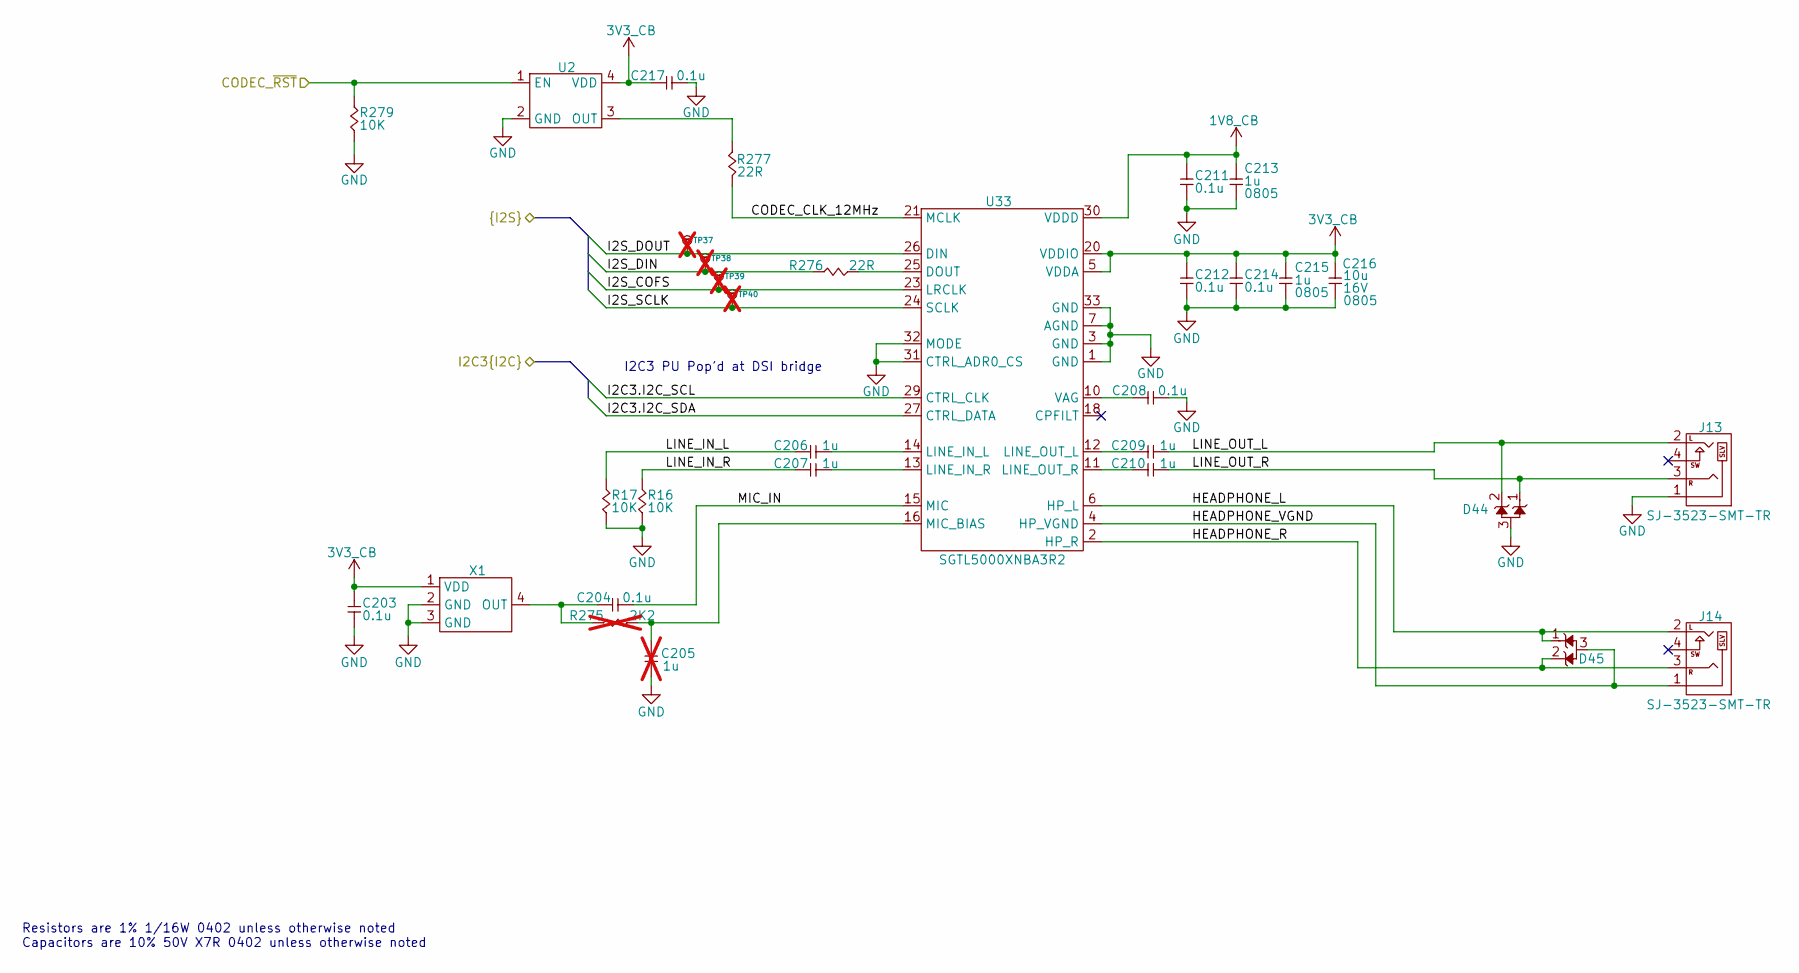
[picture p103: schematic AUDIO_CODEC.kicad_sch, RPI CMx Carrier]

Parts:
C203, C204, C208, C211, C212, C214, C217: 0.1u; CAP_NONPOL_0402; Tolerance ±10%; Voltage Rating 50V; Manufacturer Part Number GRM155R71H104KE14D
C205: 1u; CAP_NONPOL_0805; Tolerance ±10%; Voltage Rating 50V; Manufacturer Part Number CC0805KKX7R9BB105; not fitted
C206, C207, C209, C210, C213, C215: 1u; CAP_NONPOL_0805; Tolerance ±10%; Voltage Rating 50V; Manufacturer Part Number CC0805KKX7R9BB105
C216: 10u; CAP_NONPOL_0805; Tolerance ±10%; Voltage Rating 16V; Manufacturer Part Number CL21A106KOQNNNE
D44, D45: D1213A-02SOL-7; SOT-23-3; Manufacturer Part Number D1213A-02SOL-7
J13, J14: SJ-3523-SMT-TR; SJ-352X-SMT; Current Rating 1A; Voltage Rating 12V; Manufacturer Part Number SJ-3523-SMT-TR
R16, R17, R279: 10K; RES_0402; Tolerance 1%; Manufacturer Part Number RC0402FR-0710KL
R275: 2K2; RES_0402; Tolerance 1%; Manufacturer Part Number RC0402FR-072K2P; not fitted
R276, R277: 22R; RES_0402; Tolerance 1%; Manufacturer Part Number RC0402FR-0722RL
TP37, TP38, TP39, TP40: 28 mils; SMT_TP_28_MILS; Manufacturer Part Number NA; not fitted
U2: ECS-2016MVQ-120-BP-TR; 4-SMD_2mmx1_6mm; Tolerance ±50ppm; Supply Voltage 3.3V; Manufacturer Part Number ECS-2016MVQ-120-BP-TR
U33: SGTL5000XNBA3R2; 32-HPQFN; Supply Voltage 1.1V ~ 3.6V; Manufacturer Part Number SGTL5000XNBA3R2
X1: CMM-3729AT-42308-TR; Manufacturer Part Number CMM-3729AT-42308-TR

Connections:
1V8_CB: C211.2, C213.2, U33.30 (VDDD); also elsewhere on the board
3V3_CB: C203.2, C212.2, C214.2, C215.2, C216.2, C217.2, U2.4 (VDD), U33.5 (VDDA), U33.20 (VDDIO), X1.1 (VDD); also elsewhere on the board
/AUDIO_CODEC/CODEC_CLK_12MHz: R277.2, U33.21 (MCLK)
/AUDIO_CODEC/HEADPHONE_L: D45.1, J14.2 (L), U33.6 (HP_L)
/AUDIO_CODEC/HEADPHONE_R: D45.2 (A), J14.3 (R), U33.2 (HP_R)
/AUDIO_CODEC/HEADPHONE_VGND: D45.3 (GND), J14.1 (SLV), U33.4 (HP_VGND)
/AUDIO_CODEC/LINE_IN_L: C206.2, R17.2
/AUDIO_CODEC/LINE_IN_R: C207.2, R16.2
/AUDIO_CODEC/LINE_OUT_L: C209.1, D44.2 (A), J13.2 (L)
/AUDIO_CODEC/LINE_OUT_R: C210.1, D44.1, J13.3 (R)
/AUDIO_CODEC/MIC_IN: C204.1, U33.15 (MIC)
/CODEC_~RST: R279.2, U2.1 (EN); also elsewhere on the board
/I2C3.I2C_SCL: U33.29 (CTRL_CLK); also elsewhere on the board
/I2C3.I2C_SDA: U33.27 (CTRL_DATA); also elsewhere on the board
/I2S_COFS: TP39.1, U33.23 (LRCLK); also elsewhere on the board
/I2S_DIN: R276.2, TP38.1; also elsewhere on the board
/I2S_DOUT: TP37.1, U33.26 (DIN); also elsewhere on the board
/I2S_SCLK: TP40.1, U33.24 (SCLK); also elsewhere on the board
GND: C203.1, C205.2, C208.1, C211.1, C212.1, C213.1, C214.1, C215.1, C216.1, C217.1, D44.3 (GND), J13.1 (SLV), R16.1, R17.1, R279.1, U2.2 (GND), U33.1 (GND), U33.3 (GND), U33.7 (AGND), U33.31 (CTRL_ADR0_CS), U33.32 (MODE), U33.33 (GND), X1.2 (GND), X1.3 (GND); also elsewhere on the board
unnamed: R277.1, U2.3 (OUT)
unnamed: R276.1, U33.25 (DOUT)
unnamed: C206.1, U33.14 (LINE_IN_L)
unnamed: C207.1, U33.13 (LINE_IN_R)
unnamed: C209.2, U33.12 (LINE_OUT_L)
unnamed: C210.2, U33.11 (LINE_OUT_R)
unnamed: C205.1, R275.2, U33.16 (MIC_BIAS)
unnamed: C208.2, U33.10 (VAG)
unnamed: C204.2, R275.1, X1.4 (OUT)

Notes on the sheet:
Resistors are 1% 1/16W 0402 unless otherwise noted Capacitors are 10% 50V X7R 0402 unless otherwise noted
I2C3 PU Pop'd at DSI bridge
