lecejeff/RPI_CMx_Carrier/hardware/Rev1_00-0a/rpi_cm4_cm5_CarrierBoard/rpi_cm4_cm5_CarrierBoard.kicad_pcb

## KiCad design hardware/Rev1_00-0a/rpi_cm4_cm5_CarrierBoard/rpi_cm4_cm5_CarrierBoard.kicad_pcb (continued)

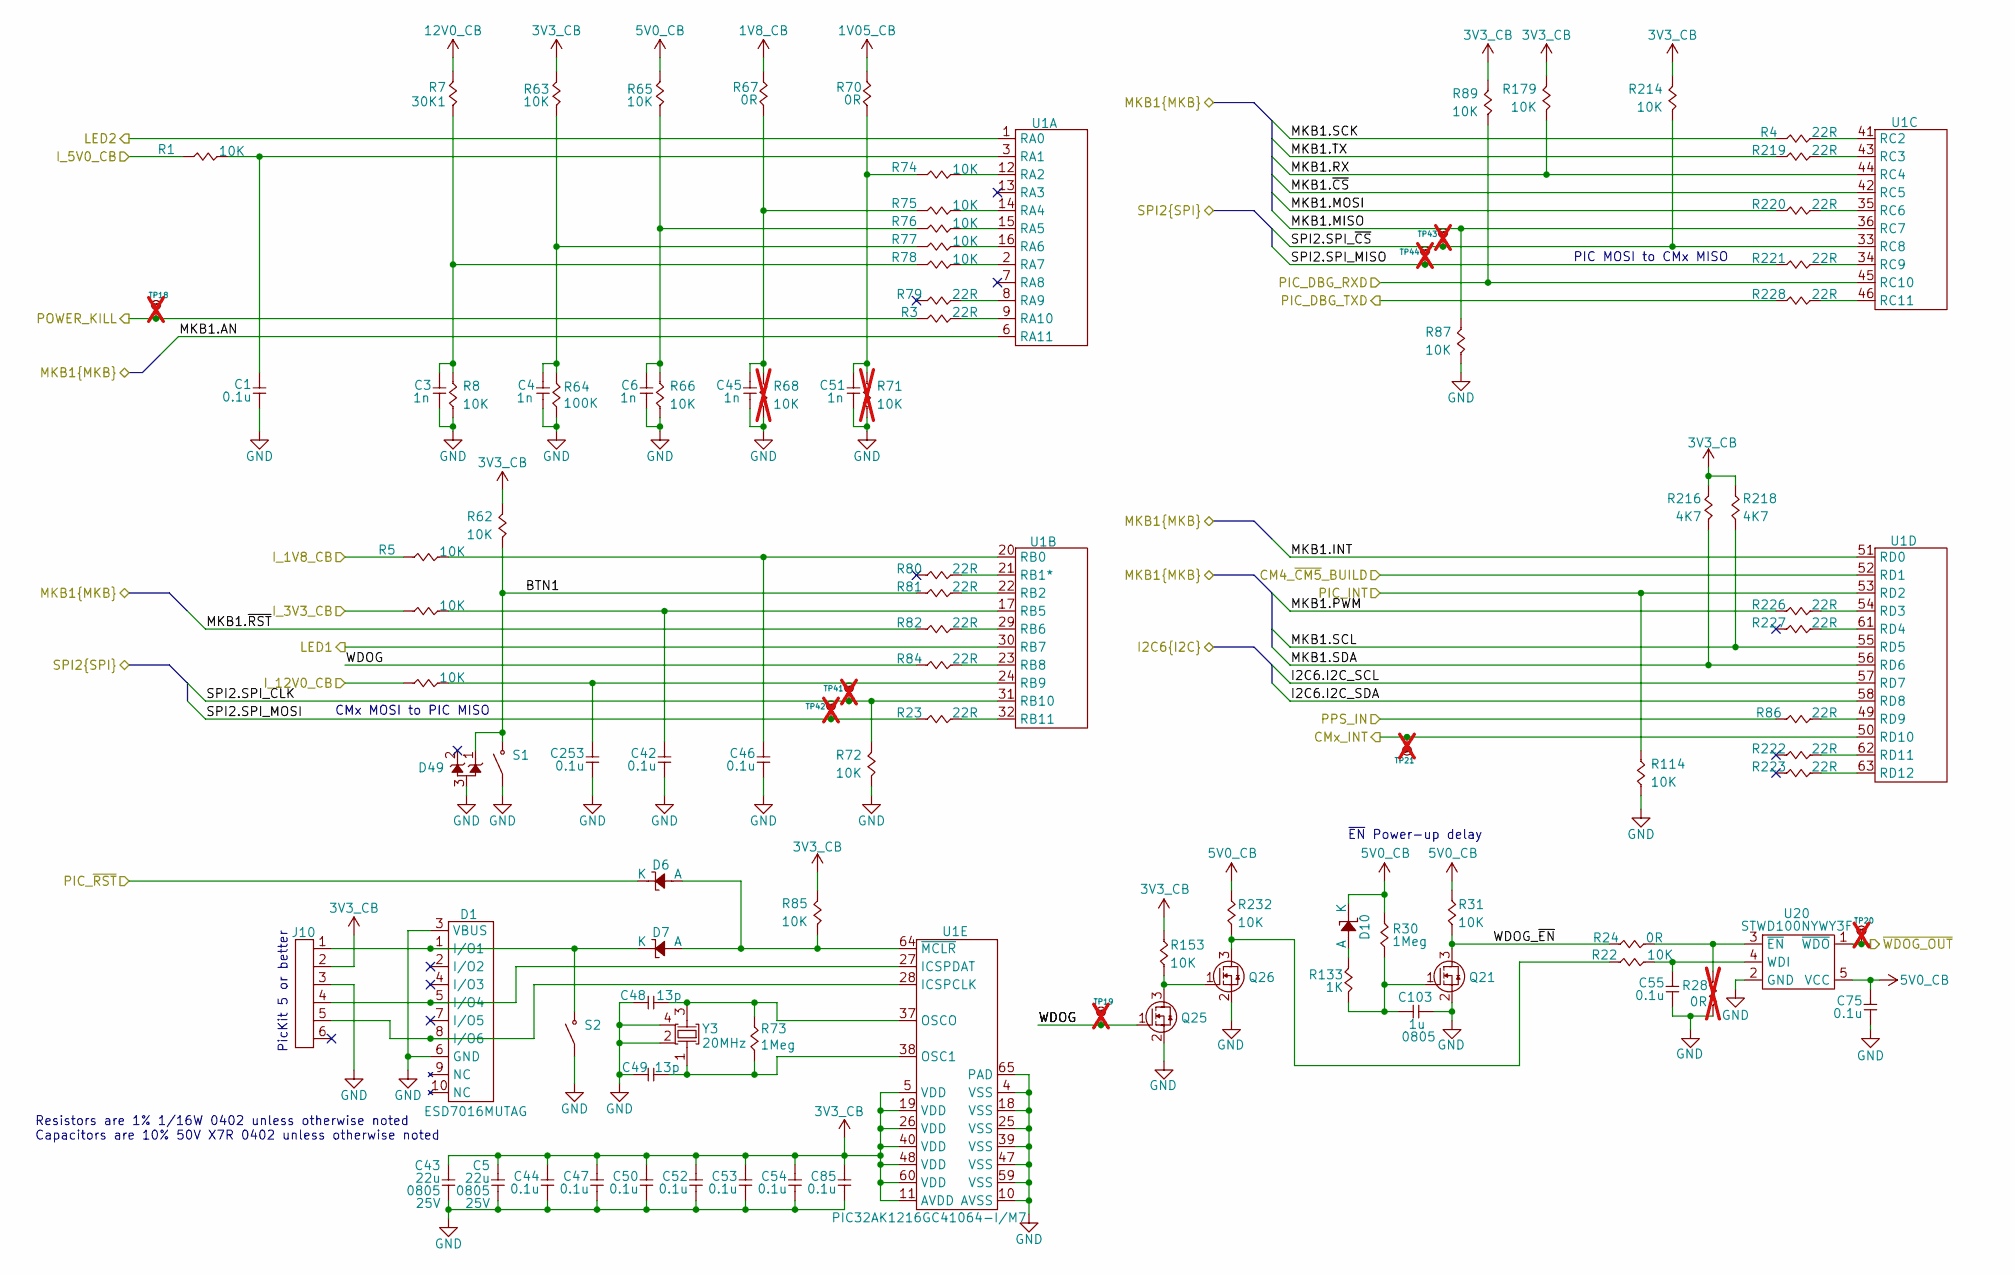
[picture p104: schematic PIC32AK1216.kicad_sch, RPI CMx Carrier]

Parts:
C1, C42, C44, C46, C47, C50, C52, C53, C54, C55, C75, C85, C253: 0.1u; CAP_NONPOL_0402; Tolerance ±10%; Voltage Rating 50V; Manufacturer Part Number GRM155R71H104KE14D
C3, C4, C6, C45, C51: 1n; CAP_NONPOL_0402; Tolerance ±5%; Voltage Rating 50V; Manufacturer Part Number GRM1555C1H102JA01D
C5, C43: 22u; CAP_NONPOL_0805; Tolerance ±20%; Voltage Rating 25V; Manufacturer Part Number CL21A226MAYNNNE
C48, C49: 13p; CAP_NONPOL_0402; Tolerance ±2%; Voltage Rating 50V; Manufacturer Part Number GJM1555C1H130GB01D
C103: 1u; CAP_NONPOL_0805; Tolerance ±10%; Voltage Rating 50V; Manufacturer Part Number CC0805KKX7R9BB105
D1: ESD7016MUTAG; UDFN8; Manufacturer Part Number ESD7016MUTAG
D6, D7, D10: BAT42WS-TP; SOD-323; Tolerance NA; Manufacturer Part Number BAT42WS-TP
D49: D1213A-02SOL-7; SOT-23-3; Manufacturer Part Number D1213A-02SOL-7
J10: PR20206VBNN; HEADER_6P_2_54MM; Current Rating 3A; Voltage Rating 250V; Manufacturer Part Number PR20206VBNN
Q21, Q25, Q26: 2N7002; SOT-23-3; Manufacturer Part Number 2N7002-7-F
R1, R5, R6, R8, R22, R31, R62, R63, R65, R66, R69, R72, R74, R75, R76, R77, R78, R85, R87, R89, R114, R153, R179, R214, R232: 10K; RES_0402; Tolerance 1%; Manufacturer Part Number RC0402FR-0710KL
R3, R4, R23, R79, R80, R81, R82, R84, R86, R219, R220, R221, R222, R223, R226, R227, R228: 22R; RES_0402; Tolerance 1%; Manufacturer Part Number RC0402FR-0722RL
R7: 30K1; RES_0402; Tolerance 1%; Manufacturer Part Number RC0402FR-0730K1L
R24, R67, R70: 0R; RES_0402; Tolerance 1%; Manufacturer Part Number RC0402FR-071KL
R28: 0R; RES_0402; Tolerance 1%; Manufacturer Part Number RC0402FR-071KL; not fitted
R30, R73: 1Meg; RES_0402; Tolerance 1%; Manufacturer Part Number RC0402FR-131ML
R64: 100K; RES_0402; Tolerance 1%; Manufacturer Part Number RC0402FR-07100KL
R68, R71: 10K; RES_0402; Tolerance 1%; Manufacturer Part Number RC0402FR-0710KL; not fitted
R133: 1K; RES_0402; Tolerance 1%; Manufacturer Part Number RC0402FR-071KL
R216, R218: 4K7; RES_0402; Tolerance 1%; Manufacturer Part Number RC0402FR-074K7L
S1, S2: KSR233G LFG; Y35A23310FPLFG; Manufacturer Part Number KSR233G LFG
TP18, TP19, TP20, TP21, TP41, TP42, TP43, TP44: 28 mils; SMT_TP_28_MILS; Manufacturer Part Number NA; not fitted
U1: PIC32AK1216GC41064-I/M7; 64-VQFN-EP(9x9mm); Supply Voltage 3V ~ 3.6V; Manufacturer Part Number PIC32AK1216GC41064-I/M7
U20: STWD100NYWY3F; SOT-23-5; Supply Voltage 2.70V ~ 5.5V; Manufacturer Part Number STWD100NYWY3F
Y3: 20MHz; 4-SMD_2mmx1_6mm; Tolerance ±20ppm; Manufacturer Part Number ABM11-20.000MHZ-D2X-T3

Connections:
1V05_CB: R70.2; also elsewhere on the board
1V8_CB: R67.2; also elsewhere on the board
3V3_CB: C5.2, C43.2, C44.2, C47.2, C50.2, C52.2, C53.2, C54.2, C85.2, J10.2, R62.2, R63.2, R85.2, R89.2, R153.2, R179.2, R214.2, R216.2, R218.2, U1.5 (VDD), U1.11 (AVDD), U1.19 (VDD), U1.26 (VDD), U1.40 (VDD), U1.48 (VDD), U1.60 (VDD); also elsewhere on the board
5V0_CB: C75.2, D10.1 (K), R30.2, R31.2, R65.2, R232.2, U20.5 (VCC); also elsewhere on the board
12V0_CB: R7.2; also elsewhere on the board
/CM4_CM5_CONN_A/CM4_~CM5_BUILD: U1.52 (RD1); also elsewhere on the board
/CM4_CM5_CONN_A/CMx_INT: TP21.1, U1.50 (RD10); also elsewhere on the board
/CM4_CM5_CONN_A/PIC_INT: R114.2, U1.53 (RD2); also elsewhere on the board
/CM4_CM5_CONN_A/PPS_OUT: R86.2; also elsewhere on the board
/CM4_CM5_CONN_A/~WDOG_IN: TP20.1, U20.1 (~WDO); also elsewhere on the board
/I2C6.I2C_SCL: U1.57 (RD7); also elsewhere on the board
/I2C6.I2C_SDA: U1.58 (RD8); also elsewhere on the board
/MKB1.AN: U1.6 (RA11); also elsewhere on the board
/MKB1.INT: U1.51 (RD0); also elsewhere on the board
/MKB1.MISO: R87.2, U1.36 (RC7); also elsewhere on the board
/MKB1.MOSI: R220.2; also elsewhere on the board
/MKB1.PWM: R226.2; also elsewhere on the board
/MKB1.RX: R179.1, U1.44 (RC4); also elsewhere on the board
/MKB1.SCK: R4.2; also elsewhere on the board
/MKB1.SCL: R218.1, U1.55 (RD5); also elsewhere on the board
/MKB1.SDA: R216.1, U1.56 (RD6); also elsewhere on the board
/MKB1.TX: R219.2; also elsewhere on the board
/MKB1.~CS: U1.42 (RC5); also elsewhere on the board
/MKB1.~RST: R82.2; also elsewhere on the board
/PIC32AK1216/BTN1: D49.1, R62.1, R81.2, S1.2
/PIC32AK1216/I_1V8_CB: R5.2; also elsewhere on the board
/PIC32AK1216/I_3V3_CB: R6.2; also elsewhere on the board
/PIC32AK1216/I_5V0_CB: R1.2; also elsewhere on the board
/PIC32AK1216/I_12V0_CB: R69.2; also elsewhere on the board
/PIC32AK1216/LED1: U1.30 (RB7); also elsewhere on the board
/PIC32AK1216/LED2: U1.1 (RA0); also elsewhere on the board
/PIC32AK1216/PIC_DBG_RXD: R89.1, U1.45 (RC10); also elsewhere on the board
/PIC32AK1216/PIC_DBG_TXD: R228.2; also elsewhere on the board
/PIC32AK1216/POWER_KILL: R3.2, TP18.1; also elsewhere on the board
/PIC32AK1216/WDOG: Q25.1 (G), R84.2, TP19.1
/PIC32AK1216/WDOG_~EN: Q21.3 (D), R24.2, R31.1
/PIC_~RST: D6.1 (K); also elsewhere on the board
/SPI2.SPI_CLK: R72.2, TP41.1, U1.31 (RB10); also elsewhere on the board
/SPI2.SPI_MISO: R221.2, TP44.1; also elsewhere on the board
/SPI2.SPI_MOSI: R23.2, TP42.1; also elsewhere on the board
/SPI2.SPI_~CS: R214.1, TP43.1, U1.33 (RC8); also elsewhere on the board
GND: C1.1, C3.1, C4.1, C5.1, C6.1, C42.1, C43.1, C44.1, C45.1, C46.1, C47.1, C48.1, C49.1, C50.1, C51.1, C52.1, C53.1, C54.1, C55.1, C75.1, C85.1, C103.1, C253.1, D1.3 (VBUS), D1.6 (GND), D49.3 (GND), J10.3, Q21.2 (S), Q25.2 (S), Q26.2 (S), R8.1, R28.1, R64.1, R66.1, R68.1, R71.1, R72.1, R87.1, R114.1, S1.1, S2.1, U1.4 (VSS), U1.10 (AVSS), U1.18 (VSS), U1.25 (VSS), U1.39 (VSS), U1.47 (VSS), U1.59 (VSS), U1.65 (PAD), U20.2 (GND), Y3.2 (GND), Y3.4 (GND); also elsewhere on the board
unnamed: C3.2, R7.1, R8.2, R78.2
unnamed: C4.2, R63.1, R64.2, R77.2
unnamed: C6.2, R65.1, R66.2, R76.2
unnamed: C45.2, R67.1, R68.2, R75.2
unnamed: C51.2, R70.1, R71.2, R74.2
unnamed: D1.1 (I/O1), D7.1 (K), J10.1, S2.2
unnamed: D1.5 (I/O4), J10.4, U1.27 (ICSPDAT)
unnamed: D1.8 (I/O6), J10.5, U1.28 (ICSPCLK)
unnamed: D6.2 (A), D7.2 (A), R85.1, U1.64 (~MCLR)
unnamed: D10.2 (A), R133.2
unnamed: C103.2, Q21.1 (G), R30.1, R133.1
unnamed: Q25.3 (D), Q26.1 (G), R153.1
unnamed: Q26.3 (D), R22.2, R232.1
unnamed: C1.2, R1.1, U1.3 (RA1)
unnamed: R74.1, U1.12 (RA2)
unnamed: R75.1, U1.14 (RA4)
unnamed: R76.1, U1.15 (RA5)
unnamed: R77.1, U1.16 (RA6)
unnamed: R78.1, U1.2 (RA7)
unnamed: R79.1, U1.8 (RA9)
unnamed: R3.1, U1.9 (RA10)
unnamed: C46.2, R5.1, U1.20 (RB0)
unnamed: R80.1, U1.21 (RB1*)
unnamed: R81.1, U1.22 (RB2)
unnamed: C42.2, R6.1, U1.17 (RB5)
unnamed: R82.1, U1.29 (RB6)
unnamed: R84.1, U1.23 (RB8)
unnamed: C253.2, R69.1, U1.24 (RB9)
unnamed: R23.1, U1.32 (RB11)
unnamed: R4.1, U1.41 (RC2)
unnamed: R219.1, U1.43 (RC3)
unnamed: R220.1, U1.35 (RC6)
unnamed: R221.1, U1.34 (RC9)
unnamed: R228.1, U1.46 (RC11)
unnamed: R226.1, U1.54 (RD3)
unnamed: R227.1, U1.61 (RD4)
unnamed: R86.1, U1.49 (RD9)
unnamed: R222.1, U1.62 (RD11)
unnamed: R223.1, U1.63 (RD12)
unnamed: C49.2, R73.1, U1.38 (OSC1), Y3.1 (XI)
unnamed: C48.2, R73.2, U1.37 (OSCO), Y3.3 (XO)
unnamed: C55.2, R22.1, U20.4 (WDI)
unnamed: R24.1, R28.2, U20.3 (~EN)

Notes on the sheet:
PIC MOSI to CMx MISO
PicKit 5 or better
CMx MOSI to PIC MISO
Resistors are 1% 1/16W 0402 unless otherwise noted Capacitors are 10% 50V X7R 0402 unless otherwise noted
~{EN} Power-up delay

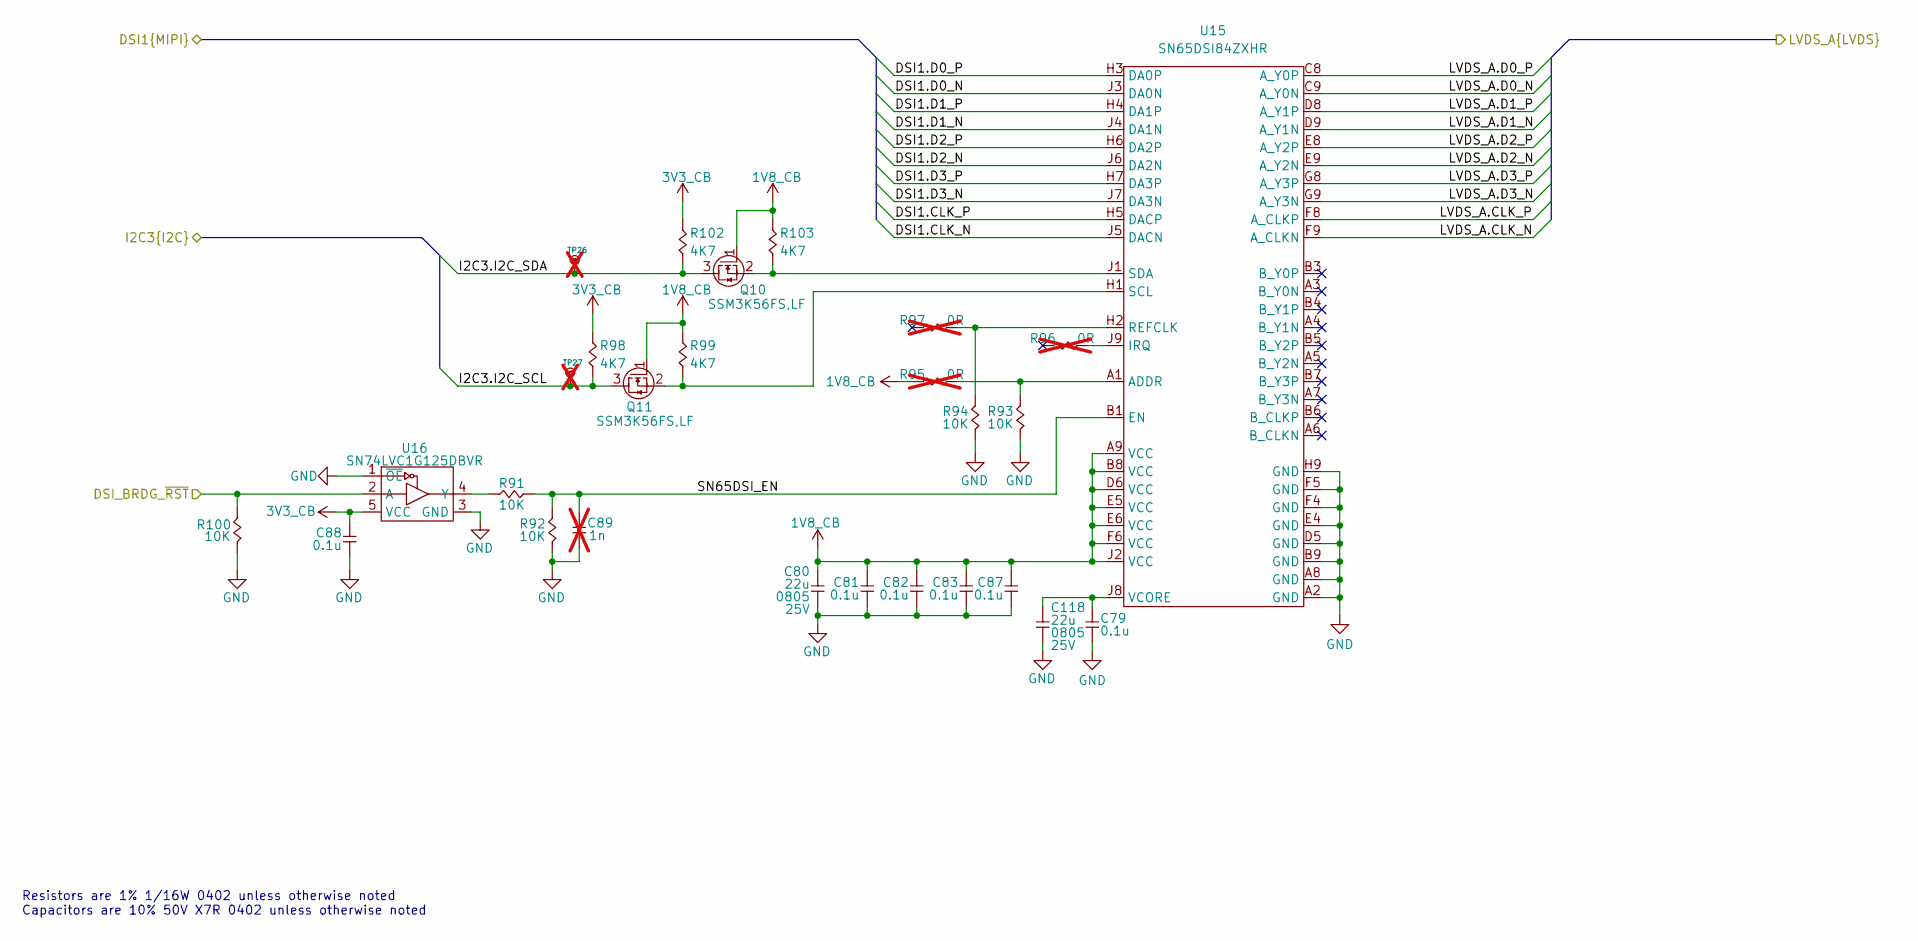
[picture p105: schematic DSI_LVDS_bridge.kicad_sch, RPI CMx Carrier]

Parts:
C79, C81, C82, C83, C87, C88: 0.1u; CAP_NONPOL_0402; Tolerance ±10%; Voltage Rating 50V; Manufacturer Part Number GRM155R71H104KE14D
C80, C118: 22u; CAP_NONPOL_0805; Tolerance ±20%; Voltage Rating 25V; Manufacturer Part Number CL21A226MAYNNNE
C89: 1n; CAP_NONPOL_0402; Tolerance ±5%; Voltage Rating 50V; Manufacturer Part Number GRM1555C1H102JA01D; not fitted
Q10, Q11: SSM3K56FS,LF; SC-75; Manufacturer Part Number SSM3K56FS,LF
R91, R92, R93, R94, R100: 10K; RES_0402; Tolerance 1%; Manufacturer Part Number RC0402FR-0710KL
R95, R96, R97: 0R; RES_0402; Tolerance 1%; Manufacturer Part Number RC0402FR-071KL; not fitted
R98, R99, R102, R103: 4K7; RES_0402; Tolerance 1%; Manufacturer Part Number RC0402FR-074K7L
TP26, TP27: 28 mils; SMT_TP_28_MILS; Manufacturer Part Number NA; not fitted
U15: SN65DSI84ZXHR; NFBGA-64; Supply Voltage 1.65V ~ 1.95V; Manufacturer Part Number SN65DSI84ZXHR
U16: SN74LVC1G125DBVR; SOT-23-5; Supply Voltage 1.65V ~ 5.5V; Manufacturer Part Number SN74LVC1G125DBVR

Connections:
1V8_CB: C80.2, C81.2, C82.2, C83.2, C87.2, Q10.1 (G), Q11.1 (G), R95.1, R99.2, R103.2, U15.A9 (VCC), U15.B8 (VCC), U15.D6 (VCC), U15.E5 (VCC), U15.E6 (VCC), U15.F6 (VCC), U15.J2 (VCC); also elsewhere on the board
3V3_CB: C88.2, R98.2, R102.2, U16.5 (VCC); also elsewhere on the board
/DSI1.CLK_N: U15.J5 (DACN); also elsewhere on the board
/DSI1.CLK_P: U15.H5 (DACP); also elsewhere on the board
/DSI1.D0_N: U15.J3 (DA0N); also elsewhere on the board
/DSI1.D0_P: U15.H3 (DA0P); also elsewhere on the board
/DSI1.D1_N: U15.J4 (DA1N); also elsewhere on the board
/DSI1.D1_P: U15.H4 (DA1P); also elsewhere on the board
/DSI1.D2_N: U15.J6 (DA2N); also elsewhere on the board
/DSI1.D2_P: U15.H6 (DA2P); also elsewhere on the board
/DSI1.D3_N: U15.J7 (DA3N); also elsewhere on the board
/DSI1.D3_P: U15.H7 (DA3P); also elsewhere on the board
/DSI - LVDS bridge/LVDS_A.CLK_N: U15.F9 (A_CLKN); also elsewhere on the board
/DSI - LVDS bridge/LVDS_A.CLK_P: U15.F8 (A_CLKP); also elsewhere on the board
/DSI - LVDS bridge/LVDS_A.D0_N: U15.C9 (A_Y0N); also elsewhere on the board
/DSI - LVDS bridge/LVDS_A.D0_P: U15.C8 (A_Y0P); also elsewhere on the board
/DSI - LVDS bridge/LVDS_A.D1_N: U15.D9 (A_Y1N); also elsewhere on the board
/DSI - LVDS bridge/LVDS_A.D1_P: U15.D8 (A_Y1P); also elsewhere on the board
/DSI - LVDS bridge/LVDS_A.D2_N: U15.E9 (A_Y2N); also elsewhere on the board
/DSI - LVDS bridge/LVDS_A.D2_P: U15.E8 (A_Y2P); also elsewhere on the board
/DSI - LVDS bridge/LVDS_A.D3_N: U15.G9 (A_Y3N); also elsewhere on the board
/DSI - LVDS bridge/LVDS_A.D3_P: U15.G8 (A_Y3P); also elsewhere on the board
/DSI - LVDS bridge/SN65DSI_EN: C89.2, R91.1, R92.2, U15.B1 (EN)
/DSI_BRDG_~RST: R100.2, U16.2 (A); also elsewhere on the board
/I2C3.I2C_SCL: Q11.3 (D), R98.1, TP27.1; also elsewhere on the board
/I2C3.I2C_SDA: Q10.3 (D), R102.1, TP26.1; also elsewhere on the board
GND: C79.1, C80.1, C81.1, C82.1, C83.1, C87.1, C88.1, C89.1, C118.1, R92.1, R93.1, R94.1, R100.1, U15.A2 (GND), U15.A8 (GND), U15.B9 (GND), U15.D5 (GND), U15.E4 (GND), U15.F4 (GND), U15.F5 (GND), U15.H9 (GND), U16.1 (~OE), U16.3 (GND); also elsewhere on the board
unnamed: Q10.2 (S), R103.1, U15.J1 (SDA)
unnamed: Q11.2 (S), R99.1, U15.H1 (SCL)
unnamed: R93.2, R95.2, U15.A1 (ADDR)
unnamed: R96.2, U15.J9 (IRQ)
unnamed: R94.2, R97.2, U15.H2 (REFCLK)
unnamed: C79.2, C118.2, U15.J8 (VCORE)
unnamed: R91.2, U16.4 (Y)

Notes on the sheet:
Resistors are 1% 1/16W 0402 unless otherwise noted Capacitors are 10% 50V X7R 0402 unless otherwise noted

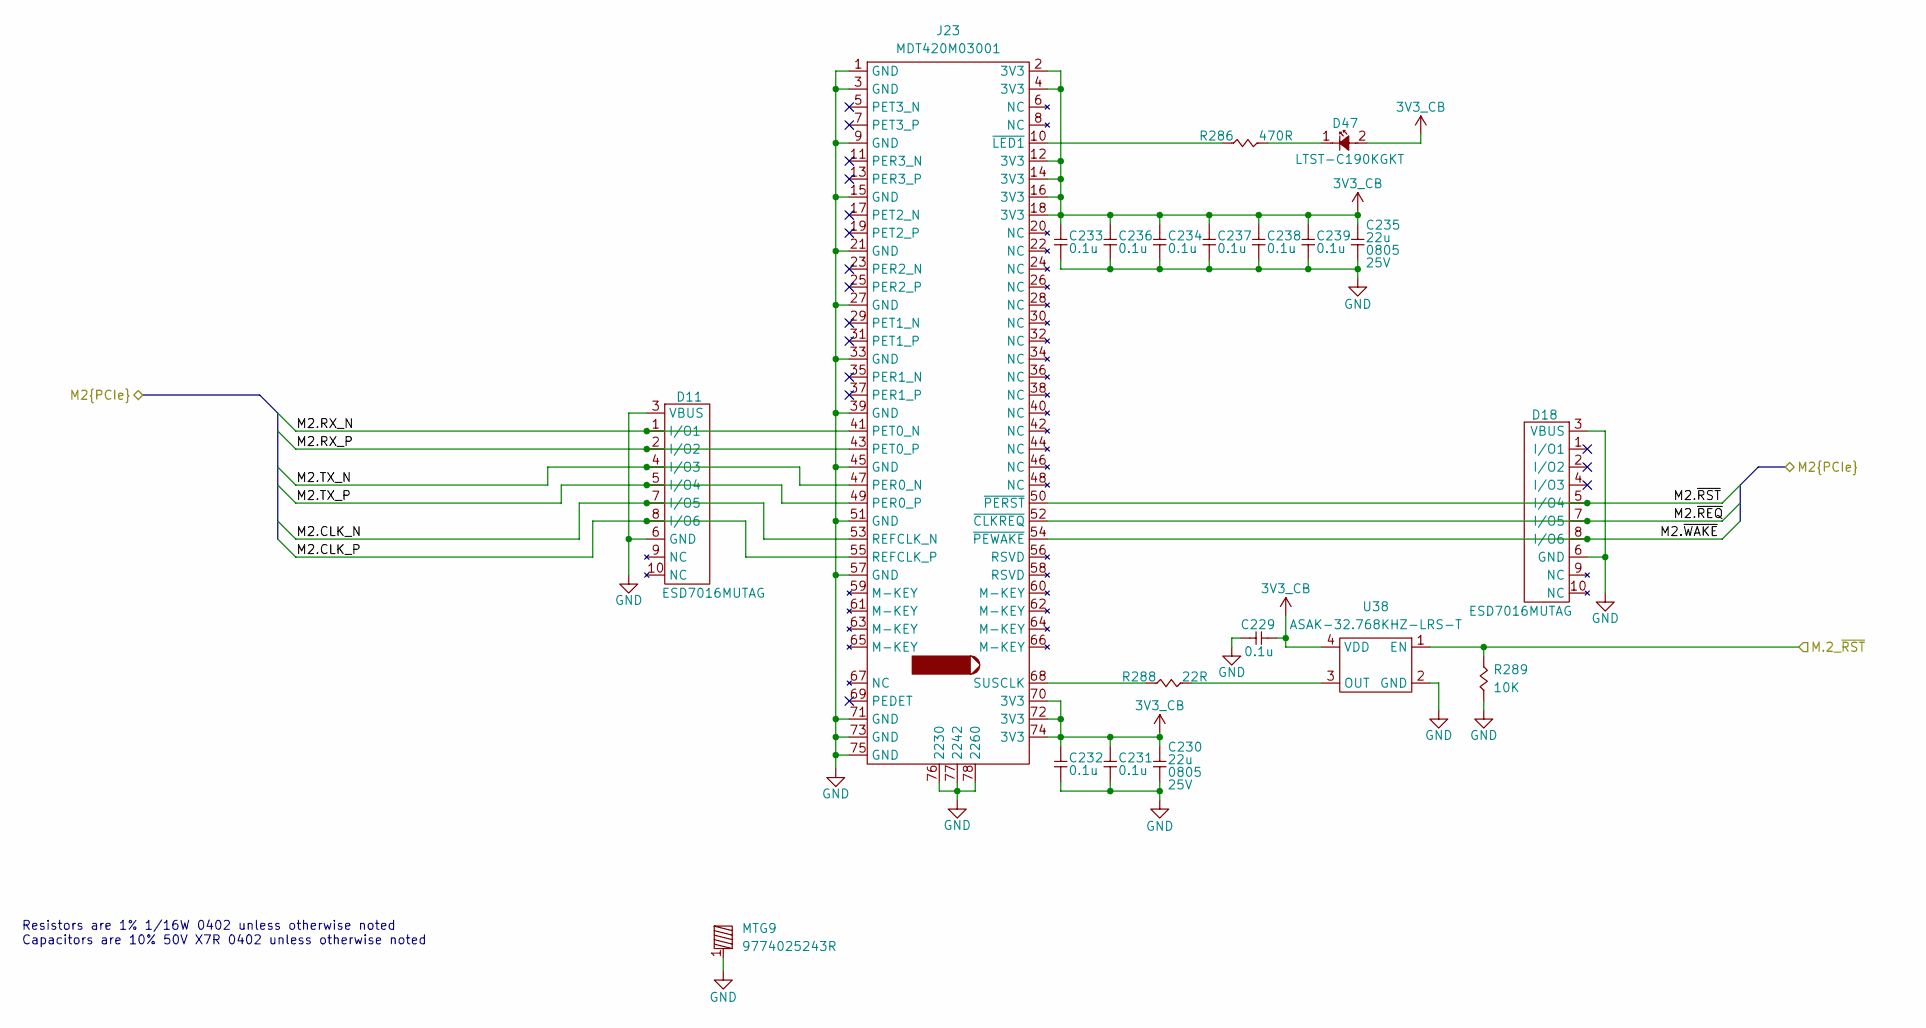
[picture p106: schematic M2_Expansion.kicad_sch, RPI CMx Carrier]

Parts:
C229, C231, C232, C233, C234, C236, C237, C238, C239: 0.1u; CAP_NONPOL_0402; Tolerance ±10%; Voltage Rating 50V; Manufacturer Part Number GRM155R71H104KE14D
C230, C235: 22u; CAP_NONPOL_0805; Tolerance ±20%; Voltage Rating 25V; Manufacturer Part Number CL21A226MAYNNNE
D11, D18: ESD7016MUTAG; UDFN8; Manufacturer Part Number ESD7016MUTAG
D47: LTST-C190KGKT; LED_0603; Tolerance NA; Manufacturer Part Number LTST-C190KGKT
J23: MDT420M03001; Current Rating 0.5A; Voltage Rating 50V; Manufacturer Part Number MDT420M03001
MTG9: 9774025243R; Manufacturer Part Number 9774025243R
R286: 470R; RES_0402; Tolerance 1%; Manufacturer Part Number RC0402FR-07470RL
R288: 22R; RES_0402; Tolerance 1%; Manufacturer Part Number RC0402FR-0722RL
R289: 10K; RES_0402; Tolerance 1%; Manufacturer Part Number RC0402FR-0710KL
U38: ASAK-32.768KHZ-LRS-T; 4-SMD_2mmx1_6mm; Tolerance ±25PPM; Supply Voltage 3.3V; Manufacturer Part Number ASAK-32.768KHZ-LRS-T

Connections:
3V3_CB: C229.1, C230.2, C231.2, C232.2, C233.2, C234.2, C235.2, C236.2, C237.2, C238.2, C239.2, D47.2 (A), J23.2 (3V3), J23.4 (3V3), J23.12 (3V3), J23.14 (3V3), J23.16 (3V3), J23.18 (3V3), J23.70 (3V3), J23.72 (3V3), J23.74 (3V3), U38.4 (VDD); also elsewhere on the board
/M2.CLK_N: D11.7 (I/O5), J23.53 (REFCLK_N); also elsewhere on the board
/M2.CLK_P: D11.8 (I/O6), J23.55 (REFCLK_P); also elsewhere on the board
/M2.RX_N: D11.1 (I/O1), J23.41 (PET0_N); also elsewhere on the board
/M2.RX_P: D11.2 (I/O2), J23.43 (PET0_P); also elsewhere on the board
/M2.TX_N: D11.4 (I/O3), J23.47 (PER0_N); also elsewhere on the board
/M2.TX_P: D11.5 (I/O4), J23.49 (PER0_P); also elsewhere on the board
/M2.~REQ: D18.7 (I/O5), J23.52 (~CLKREQ); also elsewhere on the board
/M2.~RST: D18.5 (I/O4), J23.50 (~PERST); also elsewhere on the board
/M2.~WAKE: D18.8 (I/O6), J23.54 (~PEWAKE); also elsewhere on the board
/M.2_~RST: R289.2, U38.1 (EN); also elsewhere on the board
GND: C229.2, C230.1, C231.1, C232.1, C233.1, C234.1, C235.1, C236.1, C237.1, C238.1, C239.1, D11.3 (VBUS), D11.6 (GND), D18.3 (VBUS), D18.6 (GND), J23.1 (GND), J23.3 (GND), J23.9 (GND), J23.15 (GND), J23.21 (GND), J23.27 (GND), J23.33 (GND), J23.39 (GND), J23.45 (GND), J23.51 (GND), J23.57 (GND), J23.71 (GND), J23.73 (GND), J23.75 (GND), J23.76 (2230), J23.77 (2242), J23.78 (2260), MTG9.1, R289.1, U38.2 (GND); also elsewhere on the board
unnamed: D47.1 (K), R286.2
unnamed: J23.68 (SUSCLK), R288.2
unnamed: J23.10 (~LED1), R286.1
unnamed: R288.1, U38.3 (OUT)

Notes on the sheet:
Resistors are 1% 1/16W 0402 unless otherwise noted Capacitors are 10% 50V X7R 0402 unless otherwise noted

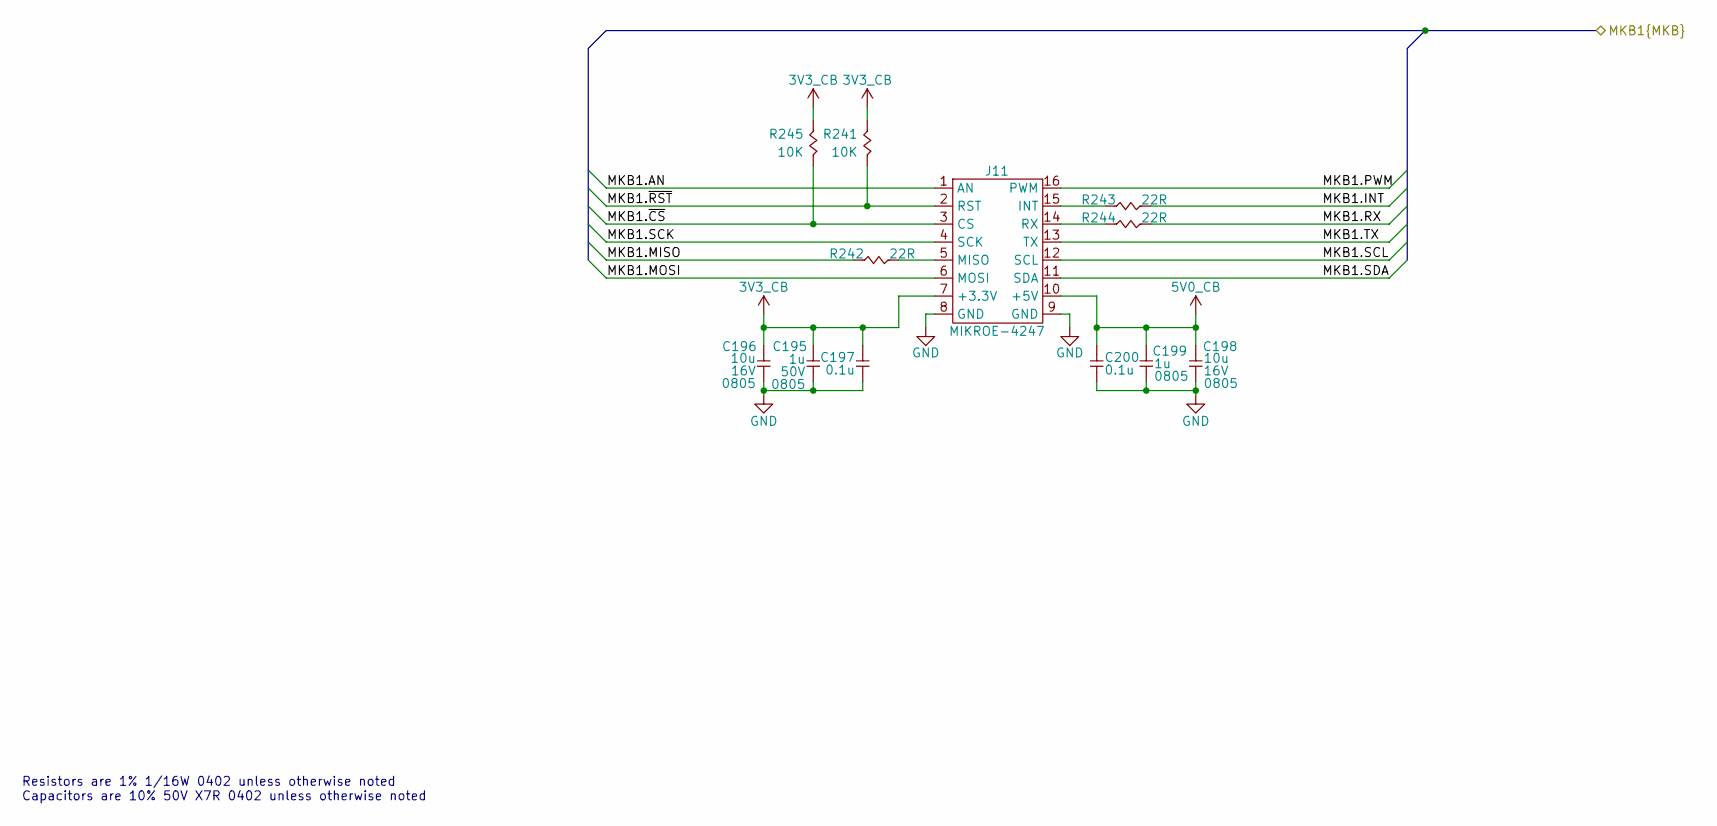
[picture p107: schematic MikroBus.kicad_sch, RPI CMx Carrier]

Parts:
C195, C199: 1u; CAP_NONPOL_0805; Tolerance ±10%; Voltage Rating 50V; Manufacturer Part Number CC0805KKX7R9BB105
C196, C198: 10u; CAP_NONPOL_0805; Tolerance ±10%; Voltage Rating 16V; Manufacturer Part Number CL21A106KOQNNNE
C197, C200: 0.1u; CAP_NONPOL_0402; Tolerance ±10%; Voltage Rating 50V; Manufacturer Part Number GRM155R71H104KE14D
J11: MIKROE-4247; MIKROBUS_SOCKET_TH; Current Rating 3A; Voltage Rating 500V; Manufacturer Part Number MIKROE-4247
R241, R245: 10K; RES_0402; Tolerance 1%; Manufacturer Part Number RC0402FR-0710KL
R242, R243, R244: 22R; RES_0402; Tolerance 1%; Manufacturer Part Number RC0402FR-0722RL

Connections:
3V3_CB: C195.2, C196.2, C197.2, J11.7 (+3.3V), R241.2, R245.2; also elsewhere on the board
5V0_CB: C198.2, C199.2, C200.2, J11.10 (+5V); also elsewhere on the board
/MKB1.AN: J11.1 (AN); also elsewhere on the board
/MKB1.INT: R243.1; also elsewhere on the board
/MKB1.MISO: R242.2; also elsewhere on the board
/MKB1.MOSI: J11.6 (MOSI); also elsewhere on the board
/MKB1.PWM: J11.16 (PWM); also elsewhere on the board
/MKB1.RX: R244.1; also elsewhere on the board
/MKB1.SCK: J11.4 (SCK); also elsewhere on the board
/MKB1.SCL: J11.12 (SCL); also elsewhere on the board
/MKB1.SDA: J11.11 (SDA); also elsewhere on the board
/MKB1.TX: J11.13 (TX); also elsewhere on the board
/MKB1.~CS: J11.3 (CS), R245.1; also elsewhere on the board
/MKB1.~RST: J11.2 (RST), R241.1; also elsewhere on the board
GND: C195.1, C196.1, C197.1, C198.1, C199.1, C200.1, J11.8 (GND), J11.9 (GND); also elsewhere on the board
unnamed: J11.15 (INT), R243.2
unnamed: J11.5 (MISO), R242.1
unnamed: J11.14 (RX), R244.2

Notes on the sheet:
Resistors are 1% 1/16W 0402 unless otherwise noted Capacitors are 10% 50V X7R 0402 unless otherwise noted
