lecejeff/RPI_CMx_Carrier/hardware/Rev1_00-0a/rpi_cm4_cm5_CarrierBoard/rpi_cm4_cm5_CarrierBoard.kicad_pcb

## KiCad design hardware/Rev1_00-0a/rpi_cm4_cm5_CarrierBoard/rpi_cm4_cm5_CarrierBoard.kicad_pcb (continued)

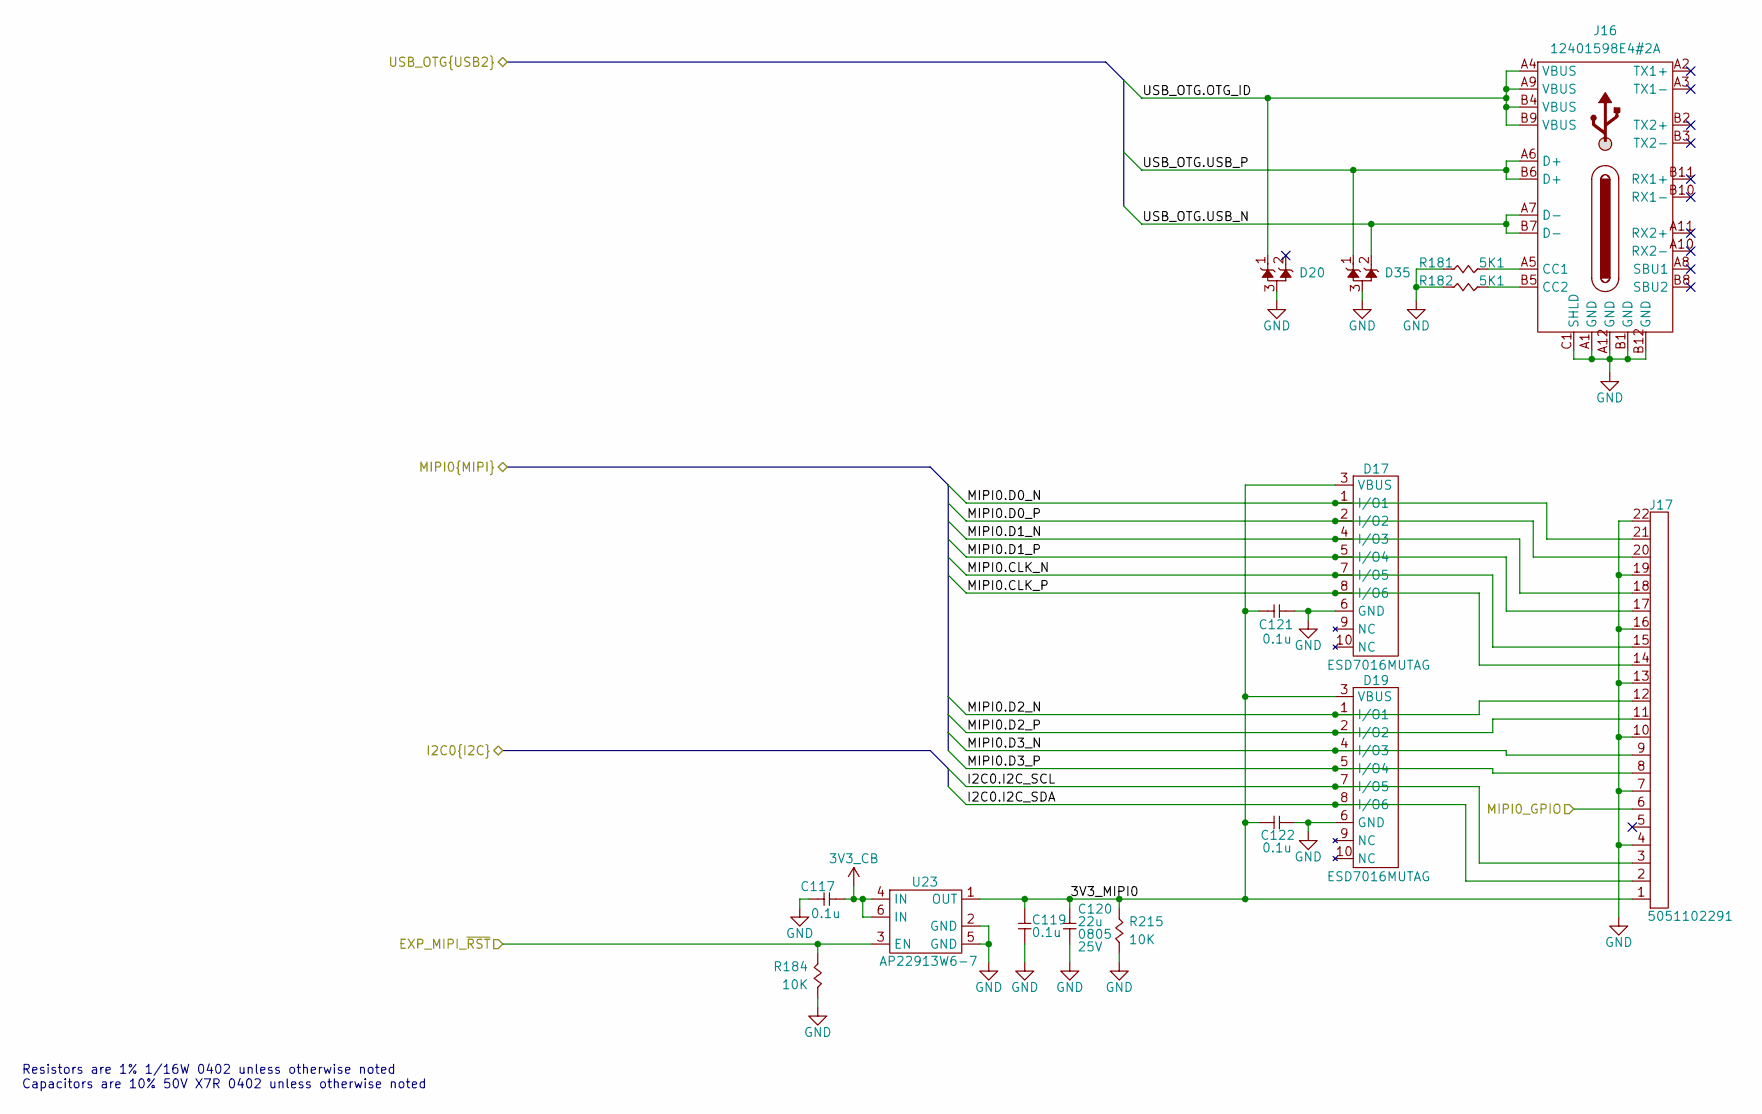
[picture p113: schematic USB-C & EXP MIPI.kicad_sch, RPI CMx Carrier]

Parts:
C117, C119, C121, C122: 0.1u; CAP_NONPOL_0402; Tolerance ±10%; Voltage Rating 50V; Manufacturer Part Number GRM155R71H104KE14D
C120: 22u; CAP_NONPOL_0805; Tolerance ±20%; Voltage Rating 25V; Manufacturer Part Number CL21A226MAYNNNE
D17, D19: ESD7016MUTAG; UDFN8; Manufacturer Part Number ESD7016MUTAG
D20, D35: D1213A-02SOL-7; SOT-23-3; Manufacturer Part Number D1213A-02SOL-7
J16: 12401598E4#2A; Current Rating 5A; Voltage Rating 100V; Manufacturer Part Number 12401598E4#2A
J17: 5051102291; Current Rating 0.5A; Voltage Rating 50V; Manufacturer Part Number 5051102291
R181, R182: 5K1; RES_0402; Tolerance 1%; Manufacturer Part Number RC0402FR-075K1L
R184, R215: 10K; RES_0402; Tolerance 1%; Manufacturer Part Number RC0402FR-0710KL
U23: AP22913W6-7; SOT-23-6; Load Voltage 1.5V ~ 5.5V; Manufacturer Part Number AP22913W6-7

Connections:
3V3_CB: C117.2, U23.4 (IN), U23.6 (IN); also elsewhere on the board
/EXP_MIPI_~RST: R184.2, U23.3 (EN); also elsewhere on the board
/I2C0.I2C_SCL: D19.7 (I/O5), J17.3; also elsewhere on the board
/I2C0.I2C_SDA: D19.8 (I/O6), J17.2; also elsewhere on the board
/MIPI0.CLK_N: D17.7 (I/O5), J17.15; also elsewhere on the board
/MIPI0.CLK_P: D17.8 (I/O6), J17.14; also elsewhere on the board
/MIPI0.D0_N: D17.1 (I/O1), J17.21; also elsewhere on the board
/MIPI0.D0_P: D17.2 (I/O2), J17.20; also elsewhere on the board
/MIPI0.D1_N: D17.4 (I/O3), J17.18; also elsewhere on the board
/MIPI0.D1_P: D17.5 (I/O4), J17.17; also elsewhere on the board
/MIPI0.D2_N: D19.1 (I/O1), J17.12; also elsewhere on the board
/MIPI0.D2_P: D19.2 (I/O2), J17.11; also elsewhere on the board
/MIPI0.D3_N: D19.4 (I/O3), J17.9; also elsewhere on the board
/MIPI0.D3_P: D19.5 (I/O4), J17.8; also elsewhere on the board
/MIPI0_GPIO: J17.6; also elsewhere on the board
/USB-C & EXP MIPI/3V3_MIPI0: C119.2, C120.2, C121.2, C122.2, D17.3 (VBUS), D19.3 (VBUS), J17.1, R215.2, U23.1 (OUT)
/USB_OTG.OTG_ID: D20.1, J16.A4 (VBUS), J16.A9 (VBUS), J16.B4 (VBUS), J16.B9 (VBUS); also elsewhere on the board
/USB_OTG.USB_N: D35.2 (A), J16.A7 (D-), J16.B7 (D-); also elsewhere on the board
/USB_OTG.USB_P: D35.1, J16.A6 (D+), J16.B6 (D+); also elsewhere on the board
GND: C117.1, C119.1, C120.1, C121.1, C122.1, D17.6 (GND), D19.6 (GND), D20.3 (GND), D35.3 (GND), J16.A1 (GND), J16.A12 (GND), J16.B1 (GND), J16.B12 (GND), J16.C1 (SHLD), J17.4, J17.7, J17.10, J17.13, J17.16, J17.19, J17.22, R181.1, R182.1, R184.1, R215.1, U23.2 (GND), U23.5 (GND); also elsewhere on the board
unnamed: J16.A5 (CC1), R181.2
unnamed: J16.B5 (CC2), R182.2

Notes on the sheet:
Resistors are 1% 1/16W 0402 unless otherwise noted Capacitors are 10% 50V X7R 0402 unless otherwise noted

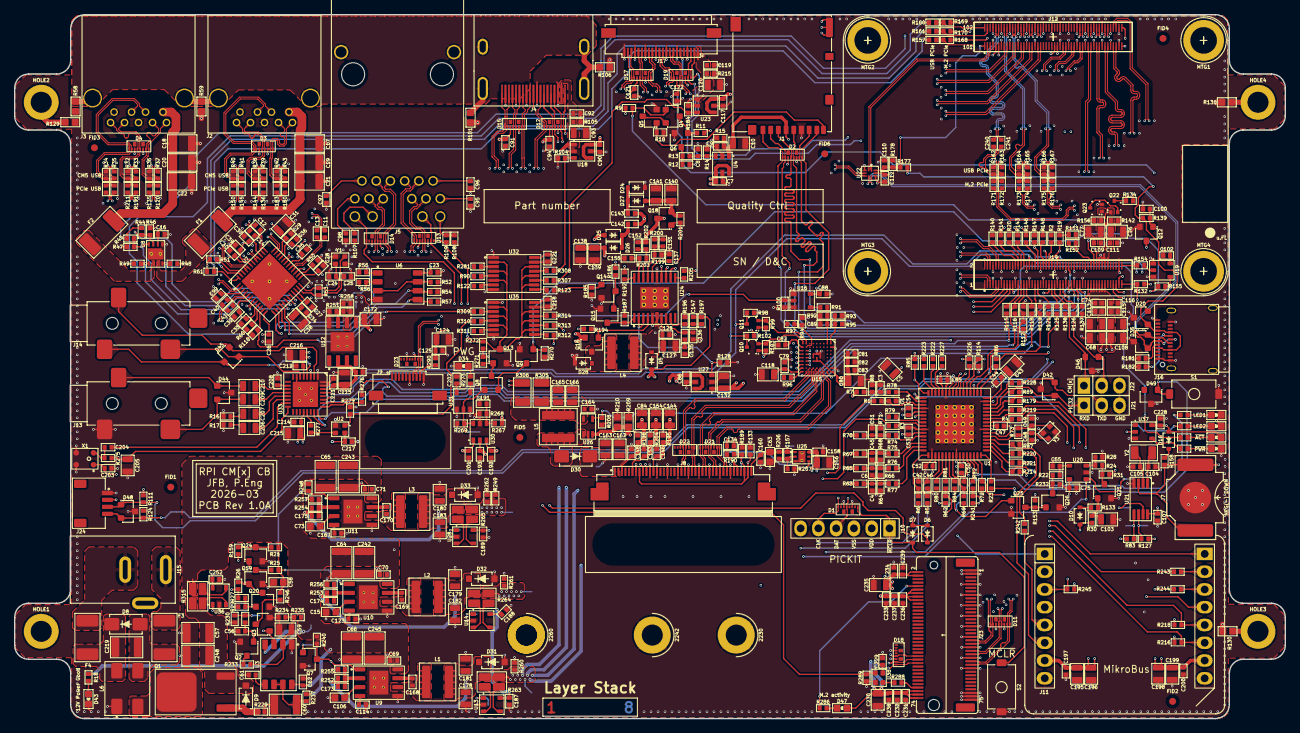
[picture p114: board rpi_cm4_cm5_CarrierBoard.kicad_pcb from above]

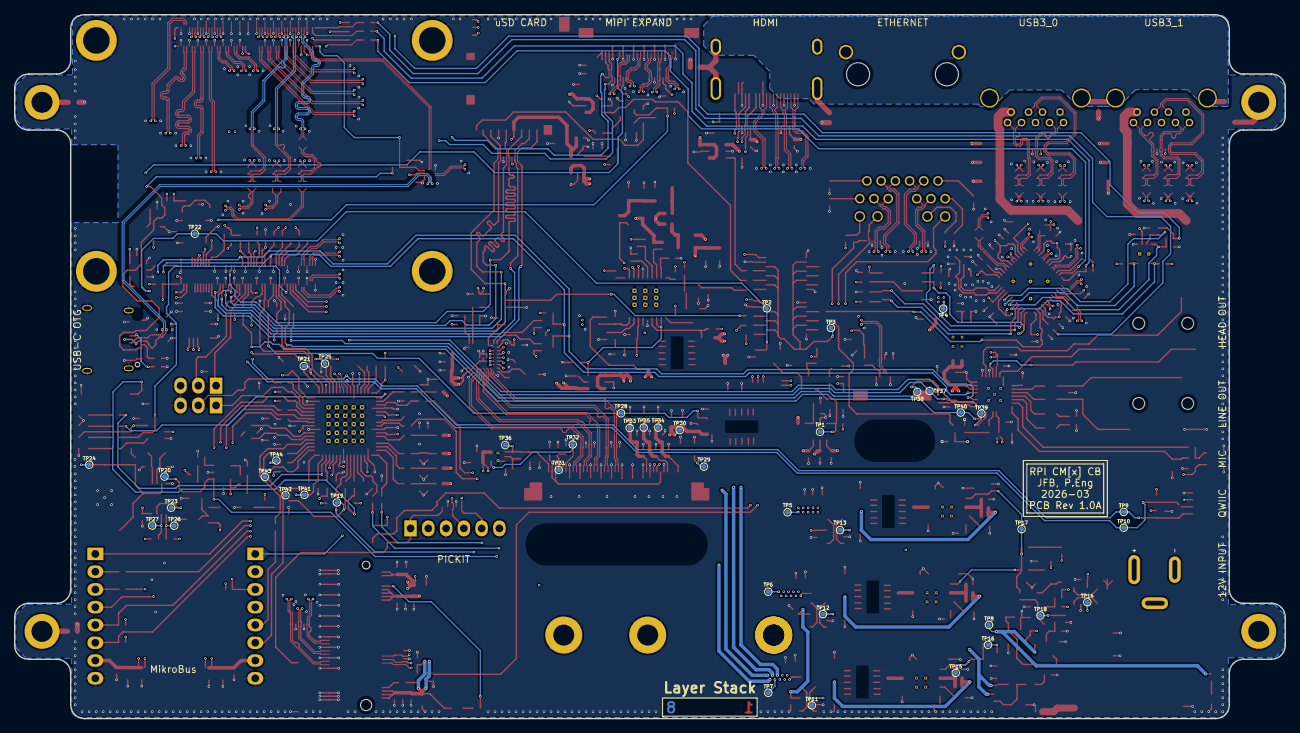
[picture p115: board rpi_cm4_cm5_CarrierBoard.kicad_pcb from below]

Board: 8 copper layers, 181.6 x 100.6 mm, 710 parts (45 on the bottom side), 449 nets.

Other parts of the board:
MTG**: Untitled; SLOT_TH_20_5mm
MTG**#2: Untitled; SLOT_TH_5_5mm
