lecejeff/RPI_CMx_Carrier/(commit log)

2026-01-01 Commit RPI CMx design to Github (initial commit)
    [CM4_CM5_CONN_A.kicad_sch, CM4_CM5_CONN_B.kicad_sch, DSI_LVDS_bridge.kicad_sch, Ethernet.kicad_sch, HDMI.kicad_sch, Power Supply.kicad_sch, Power_Input.kicad_sch, RESET_SUPERVISOR.kicad_sch]
2026-01-01 Add dsPIC sheet
    [dsPIC33EPxxxMU810.kicad_sch, rpi_cm4_cm5_CarrierBoard.kicad_pcb, rpi_cm4_cm5_CarrierBoard.kicad_sch]
2026-01-02 Add power-up and power kill sequences Modify schematics to add net classes for DiffPairs
    [CM4_CM5_CONN_A.kicad_sch, CM4_CM5_CONN_B.kicad_sch, DSI_LVDS_bridge.kicad_sch, Ethernet.kicad_sch, HDMI.kicad_sch, Power Supply.kicad_sch, RESET_SUPERVISOR.kicad_sch, TFT_CONN.kicad_sch]
2026-01-04 Significant update to schematics Add codec, Mikrobus, PIC32A Add power table, design notes for pinmux Add datasheets
    [AUDIO_CODEC.kicad_sch, CM4_CM5_CONN_A.kicad_sch, CM4_CM5_CONN_B.kicad_sch, DSI_LVDS_bridge.kicad_sch, MikroBus.kicad_sch, PIC32AK1216.kicad_sch, Power Supply.kicad_sch, Power_Input.kicad_sch]
2026-01-04 Slight update to hierarchical top sheet
    [rpi_cm4_cm5_CarrierBoard.kicad_pcb, rpi_cm4_cm5_CarrierBoard.kicad_sch]
2026-01-04 Preliminary completion of RPI CMx schematics Cleaned up hierarchical root page
    [AUDIO_CODEC.kicad_sch, CM4_CM5_CONN_A.kicad_sch, CM4_CM5_CONN_B.kicad_sch, Expansion_io.kicad_sch, HDMI.kicad_sch, M2_Expansion.kicad_sch, PIC32AK1216.kicad_sch, Power Supply.kicad_sch]
2026-01-04 Add power estimation for PCIe NVMe M.2 on 3V3_CB
    [RPI_CMx_Carrier - Design Notes - Power Table.ods]
2026-01-07 Modify power supply page (input capacitors to buck regulator), update PCB stackup (6-layer JLC 061611-7628 1oz int, 1oz ext, 1.6mm ±10%)
    [Power Supply.kicad_sch, RPI_CMx_Carrier - Design Notes - Power Table.ods, USB_3.kicad_sch]
2026-01-09 Add preliminary BOM and preliminary .pdf schmematics Add BOM option for I2C control of ILI2132A for CapTouch HMI Add BOM options and DNP / 0R resistors for CM4 - CM5 build options
    [AUDIO_CODEC.kicad_sch, CM4_CM5_CONN_A.kicad_sch, CM4_CM5_CONN_B.kicad_sch, DSI_LVDS_bridge.kicad_sch, Ethernet.kicad_sch, Expansion_io.kicad_sch, HDMI.kicad_sch, M2_Expansion.kicad_sch]
2026-01-10 Added power input protection & filter Added dedicated QWIIC connector on RPI CMx I2C6 bus Adjusted power table and PinMux Updated schematics accordingly
    [AUDIO_CODEC.kicad_sch, CM4_CM5_CONN_A.kicad_sch, CM4_CM5_CONN_B.kicad_sch, DSI_LVDS_bridge.kicad_sch, Expansion_io.kicad_sch, HDMI.kicad_sch, M2_Expansion.kicad_sch, PIC32AK1216.kicad_sch]
2026-01-10 Update watchdog timer circuit to add external watchdog timer IC to be fed by PIC Adjust reset scheme in power supply sheet accordingly Adjust PinMux, regen BOM and PDF schematics (preliminary) Start 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
    [AUDIO_CODEC.kicad_sch, CM4_CM5_CONN_A.kicad_sch, M2_Expansion.kicad_sch, PIC32AK1216.kicad_sch, POWER INPUT.kicad_sch, Power Supply.kicad_sch, RPI_CM4_CM5_CarrierBoard_PinMux.ods, TFT_CONN.kicad_sch]
2026-01-11 Review watchdog timer circuit to prevent race condition during shutdown
    [CM4_CM5_CONN_A.kicad_sch, Power Supply.kicad_sch, RESET_SUPERVISOR.kicad_sch, RPI_CM4_CM5_CarrierBoard_PinMux.ods, rpi_cm4_cm5_CarrierBoard-2.00-0A-BOM.csv, rpi_cm4_cm5_CarrierBoard.kicad_sch]
2026-01-11 Finished implementation of watchdog circuit All possible reset scenarios documented
    [CM4_CM5_CONN_A.kicad_sch, PIC32AK1216.kicad_sch, Power Supply.kicad_sch, rpi_cm4_cm5_CarrierBoard.kicad_sch]
2026-01-11 Update BOM + SCH pdf
    [rpi_cm4_cm5_CarrierBoard-2.00-0A-BOM.csv]
2026-01-12 Update schematics based on PCB preliminary placement Add preliminary design rules to PCB
    [DSI_LVDS_bridge.kicad_sch, M2_Expansion.kicad_sch, TFT_CONN.kicad_sch, USB-C & EXP MIPI.kicad_sch, rpi_cm4_cm5_CarrierBoard.kicad_sch]
2026-01-12 Update BOM, schematic and preliminary placement
    [rpi_cm4_cm5_CarrierBoard-2.00-0A-BOM.csv]
2026-01-13 Update preliminary placement, update DNP, regen BOM + Preliminary schematics
    [AUDIO_CODEC.kicad_sch, CM4_CM5_CONN_A.kicad_sch, Expansion_io.kicad_sch, MikroBus.kicad_sch, PIC32AK1216.kicad_sch, RESET_SUPERVISOR.kicad_sch, TFT_CONN.kicad_sch, TFT_POWER.kicad_sch]
2026-01-18 Update PCB design rules for outer layers differential pairs Update preliminary component placement Update schematics based on PCB placement & remove duplicata / unnecessary components Update design n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
    [AUDIO_CODEC.kicad_sch, CM4_CM5_CONN_A.kicad_sch, CM4_CM5_CONN_B.kicad_sch, DSI_LVDS_bridge.kicad_sch, Expansion_io.kicad_sch, M2_Expansion.kicad_sch, MikroBus.kicad_sch, PIC32AK1216.kicad_sch]
2026-01-23 Document stackup Few changes to schematic based on preliminary PCB placement Update PinMux based on preliminary PCB placement and component positions
    [AUDIO_CODEC.kicad_sch, CM4_CM5_CONN_A.kicad_sch, CM4_CM5_CONN_B.kicad_sch, DSI_LVDS_bridge.kicad_sch, Ethernet.kicad_sch, HDMI.kicad_sch, M2_Expansion.kicad_sch, MikroBus.kicad_sch]
2026-01-24 Cosmetic adjustments to schematics
    [PIC32AK1216.kicad_sch, RPI_CM4_CM5_CarrierBoard_PinMux.ods, RPI_CM4_CM5_CarrierBoard_Stackup.ods, RPI_CMx_Carrier - Design Notes - Power Table.ods, rpi_cm4_cm5_CarrierBoard-2.00-0A-BOM.csv, rpi_cm4_cm5_CarrierBoard.kicad_sch]
2026-01-25 Significant update in PCB layout; Completed preliminary high speed rules definition and fanout of differential pairs + GND vias. Started routing high speed signals Slight changes to Pinout based on c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
    [CM4_CM5_CONN_A.kicad_sch, Ethernet.kicad_sch, HDMI.kicad_sch, PIC32AK1216.kicad_sch, RPI_CM4_CM5_CarrierBoard_PinMux.ods, RPI_CM4_CM5_CarrierBoard_Stackup.ods, USB_3.kicad_sch, rpi_cm4_cm5_CarrierBoard-2.00-0A-BOM.csv]
2026-01-31 All differential pairs fanned out, length matched and skew matched, with exception of USB 3.0 (conf. resistors to physical port). Progress on design rules setup.
    [USB-C & EXP MIPI.kicad_sch, rpi_cm4_cm5_CarrierBoard.kicad_pcb]
2026-01-31 Adjust length matching (transmitter vx receiver matching)
    [CM4_CM5_CONN_B.kicad_sch, M2_Expansion.kicad_sch, USB_3.kicad_sch, rpi_cm4_cm5_CarrierBoard.kicad_pcb]
2026-02-08 Continue working on the layout. Completed most of power planes planning and pouring Completed all DiffPairs routing and length matching (preliminary)
    [CM4_CM5_CONN_A.kicad_sch, PIC32AK1216.kicad_sch, Power Supply.kicad_sch, RESET_SUPERVISOR.kicad_sch, RPI_CM4_CM5_CarrierBoard_PinMux.ods, SD_CARD.kicad_sch, TFT_CONN.kicad_sch, TFT_POWER.kicad_sch]
2026-02-14 Significant update Stackup changed from 6 to 8 layers Changed design notes accordingly Re-routed all differential pairs and length match / skew match Fanout critical signals away from dense areas 95%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
    [AUDIO_CODEC.kicad_sch, CM4_CM5_CONN_A.kicad_sch, CM4_CM5_CONN_B.kicad_sch, DSI_LVDS_bridge.kicad_sch, Ethernet.kicad_sch, HDMI.kicad_sch, M2_Expansion.kicad_sch, MikroBus.kicad_sch]
2026-02-15 Add preliminary output files (PCB PDF, Gerbers, IPC-D-356, IPC-2581, Pick_N_Place, etc) Update BOM, SCH PDF Commit PCB design and set to "Review" state
    [AUDIO_CODEC.kicad_sch, CM4_CM5_CONN_A.kicad_sch, CM4_CM5_CONN_B.kicad_sch, DSI_LVDS_bridge.kicad_sch, Ethernet.kicad_sch, HDMI.kicad_sch, M2_Expansion.kicad_sch, MikroBus.kicad_sch]
2026-02-15 Cleanup schematic
    [AUDIO_CODEC.kicad_sch, DSI_LVDS_bridge.kicad_sch, PIC32AK1216.kicad_sch, POWER INPUT.kicad_sch, Power Supply.kicad_sch, SD_CARD.kicad_sch, TFT_POWER.kicad_sch, USB-C & EXP MIPI.kicad_sch]
2026-02-15 Update output files (remove previous rev)
    [rpi_cm4_cm5_CarrierBoard-B_Cu.gbr, rpi_cm4_cm5_CarrierBoard-B_Mask.gbr, rpi_cm4_cm5_CarrierBoard-B_Paste.gbr, rpi_cm4_cm5_CarrierBoard-B_Silkscreen.gbr, rpi_cm4_cm5_CarrierBoard-Edge_Cuts.gbr, rpi_cm4_cm5_CarrierBoard-F_Cu.gbr, rpi_cm4_cm5_CarrierBoard-F_Mask.gbr, rpi_cm4_cm5_CarrierBoard-F_Paste.gbr]
2026-02-15 design review add new rev of output job files
    [rpi_cm4_cm5_CarrierBoard.kicad_pcb]
2026-02-16 Modify BOM with DNP for few items
    [RPI_CMx_Carrier_2.00-0A_PICKnPLACE.csv, rpi_cm4_cm5_CarrierBoard-2.00-0A-BOM.csv]
2026-02-16 Update stackup tab with actual layer stack from kicad
    [RPI_CM4_CM5_CarrierBoard_Stackup.ods]
2026-02-16 Removed I_1V05; current drawn from 1V05 rail will be reflected through 1V8 rail, as they're connected in cascade
    [RPI_CM4_CM5_CarrierBoard_PinMux.ods]
2026-02-17 Update BOM build options (DNP, Exclude from board, etc) Export new BOM and new schematic
    [TFT_CONN.kicad_sch, rpi_cm4_cm5_CarrierBoard-2.00-0A-BOM.csv, rpi_cm4_cm5_CarrierBoard.kicad_pcb, rpi_cm4_cm5_CarrierBoard.kicad_sch]
2026-02-17 Add test points on relevant signals Re-generate SCH_PDF Re-generate BOM Re-generate all gerbers and relevant PCB output files (still in review phase)
    [AUDIO_CODEC.kicad_sch, CM4_CM5_CONN_A.kicad_sch, CM4_CM5_CONN_B.kicad_sch, DSI_LVDS_bridge.kicad_sch, Ethernet.kicad_sch, HDMI.kicad_sch, M2_Expansion.kicad_sch, MikroBus.kicad_sch]
2026-02-17 Push gerbers to repository (review state)
    [rpi_cm4_cm5_CarrierBoard-B_Cu.gbr, rpi_cm4_cm5_CarrierBoard-B_Mask.gbr, rpi_cm4_cm5_CarrierBoard-B_Paste.gbr, rpi_cm4_cm5_CarrierBoard-B_Silkscreen.gbr, rpi_cm4_cm5_CarrierBoard-Edge_Cuts.gbr, rpi_cm4_cm5_CarrierBoard-F_Cu.gbr, rpi_cm4_cm5_CarrierBoard-F_Mask.gbr, rpi_cm4_cm5_CarrierBoard-F_Paste.gbr]
2026-02-18 Correct 3d model for DF40HC connector Correct NPTH hole clearance to zone rule
    [RPI_CMx_Carrier_2.00-0A_PICKnPLACE.csv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]
2026-02-20 Schematic - Add component class for fiducials
    PCB
    - Modify outline to remove 90 degrees angle in board cutout
    - Adjust polygon pour on power plane (add no fill zone under CGND)
    - Adjust soldermask opening for SMT spacers (no soldermask on bottom layer)
    - Adjust rule for fiducial soldermask clearance
    - Adjust polygon rule (remove default clearance, manage by custom rule)
    Re-generate all gerber and output files
    [M2_Expansion.kicad_sch, RPI_CMx_Carrier_2.00-0A_PICKnPLACE.csv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]
2026-02-20 Schematic review: - Add PD resistor on MAX16928 TFT driver to park TFT_VDD to OFF by default - Adjust DNP fields for PNP and standard BOM PCB review: - Add PD resistor - Adjust few traces, add missin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
    [AUDIO_CODEC.kicad_sch, CM4_CM5_CONN_A.kicad_sch, CM4_CM5_CONN_B.kicad_sch, DSI_LVDS_bridge.kicad_sch, Ethernet.kicad_sch, HDMI.kicad_sch, M2_Expansion.kicad_sch, MikroBus.kicad_sch]
2026-02-20 Update BOM and pick N place file following DFM review
    [RPI_CMx_Carrier_2.00-0A_PICKnPLACE.csv, rpi_cm4_cm5_CarrierBoard-2.00-0A-BOM.csv, rpi_cm4_cm5_CarrierBoard.kicad_pcb]
2026-02-21 Update PCB based on DFM review - Reduce via size to 0.35 / 0.15mm all around board - Reduce trace width around SN65DSI84
    Continue DFM review and corrections
    Re-generate all output files
    [rpi_cm4_cm5_CarrierBoard-B_Cu.gbr, rpi_cm4_cm5_CarrierBoard-B_Mask.gbr, rpi_cm4_cm5_CarrierBoard-B_Paste.gbr, rpi_cm4_cm5_CarrierBoard-B_Silkscreen.gbr, rpi_cm4_cm5_CarrierBoard-Edge_Cuts.gbr, rpi_cm4_cm5_CarrierBoard-F_Cu.gbr, rpi_cm4_cm5_CarrierBoard-F_Mask.gbr, rpi_cm4_cm5_CarrierBoard-F_Paste.gbr]
2026-02-21 PCB update based on DFM review - Start decreasing trace width to 4mils for DiffPairs routing within ESD protection diodes
    [rpi_cm4_cm5_CarrierBoard-B_Cu.gbr, rpi_cm4_cm5_CarrierBoard-B_Mask.gbr, rpi_cm4_cm5_CarrierBoard-B_Paste.gbr, rpi_cm4_cm5_CarrierBoard-B_Silkscreen.gbr, rpi_cm4_cm5_CarrierBoard-Edge_Cuts.gbr, rpi_cm4_cm5_CarrierBoard-F_Cu.gbr, rpi_cm4_cm5_CarrierBoard-F_Mask.gbr, rpi_cm4_cm5_CarrierBoard-F_Paste.gbr]
2026-02-22 Continue design adjustment following DFM - Adjust all trace width to 4mils next to esd diodes with tight pad to trace spacing - Adjust all vias to 0.2mm drill / 0.35mm pad - Adjust silkscreen - Adjus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
    Still in review
    Regenerate all output files
    [RPI_CMx_Carrier_2.00-0A_PICKnPLACE.csv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]
2026-02-22 Completed preliminary DFM using NextPCB DFM tool Re-generate all output files dated on 2026-02-22 Add 3d step model to output files
    [rpi_cm4_cm5_CarrierBoard-B_Cu.gbr, rpi_cm4_cm5_CarrierBoard-B_Mask.gbr, rpi_cm4_cm5_CarrierBoard-B_Paste.gbr, rpi_cm4_cm5_CarrierBoard-B_Silkscreen.gbr, rpi_cm4_cm5_CarrierBoard-Edge_Cuts.gbr, rpi_cm4_cm5_CarrierBoard-F_Cu.gbr, rpi_cm4_cm5_CarrierBoard-F_Mask.gbr, rpi_cm4_cm5_CarrierBoard-F_Paste.gbr]
2026-02-22 Update to KiCad project (step file output options)
2026-02-22 Update SCH_PDF output (add few assembly variant notes, harmonize default cap / res comment on all schematic sheets)
2026-02-22 Update schematic sheets (assembly variants, default cap / res notes)
    [AUDIO_CODEC.kicad_sch, CM4_CM5_CONN_A.kicad_sch, CM4_CM5_CONN_B.kicad_sch, DSI_LVDS_bridge.kicad_sch, Ethernet.kicad_sch, HDMI.kicad_sch, M2_Expansion.kicad_sch, MikroBus.kicad_sch]
2026-02-22 Pust update to kicad project file
2026-02-23 Adjust soldermask clearance for slot holes and non-plated through holes Adjust few traces to increase GND planes exposure on all layers
    [RPI_CMx_Carrier_2.00-0A_PICKnPLACE.csv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]
2026-02-25 Update 12MHz oscillator on Audio Codec schematic sheet to solve single source issue and uncommon packaging. Re-generate all output files including schematics and BOM, as well as all PCB output files
    [AUDIO_CODEC.kicad_sch, CM4_CM5_CONN_A.kicad_sch, CM4_CM5_CONN_B.kicad_sch, DSI_LVDS_bridge.kicad_sch, Ethernet.kicad_sch, HDMI.kicad_sch, M2_Expansion.kicad_sch, MikroBus.kicad_sch]
2026-02-27 Final commit prior to formal DFM by PCB manufacturer & PCBA Several iterations of DRC checks and validation with CAM software completed Ready for quotation
    [AUDIO_CODEC.kicad_sch, CM4_CM5_CONN_A.kicad_sch, CM4_CM5_CONN_B.kicad_sch, DSI_LVDS_bridge.kicad_sch, Ethernet.kicad_sch, HDMI.kicad_sch, M2_Expansion.kicad_sch, MikroBus.kicad_sch]
2026-02-28 Clear ERC markers and cleaned unconnected nets Design freeze
    [AUDIO_CODEC.kicad_sch, CM4_CM5_CONN_A.kicad_sch, CM4_CM5_CONN_B.kicad_sch, DSI_LVDS_bridge.kicad_sch, Ethernet.kicad_sch, HDMI.kicad_sch, M2_Expansion.kicad_sch, MikroBus.kicad_sch]
2026-02-28 Re-upload schematic pdf format, unhighlight USB_OTG net
2026-03-01 Add schematicc netlist to git repository
2026-03-01 Adjust pdf schematic output to use "Export --> Plot" function instead of print to pdf. This way, the schematic can be textually parsed and hierarchical structure is maintained and can be easily navig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
2026-03-02 Correct footprint for ENET transceiver (enlarge few holes) Correct SD card (missing 1 retaining pad) Adjust 0402 component
    [AUDIO_CODEC.kicad_sch, CM4_CM5_CONN_A.kicad_sch, CM4_CM5_CONN_B.kicad_sch, DSI_LVDS_bridge.kicad_sch, Ethernet.kicad_sch, HDMI.kicad_sch, M2_Expansion.kicad_sch, MikroBus.kicad_sch]
2026-03-02 Kicad prl file update
2026-03-05 Add NextPCB working gerbers
    [37666-3475236.drl, 37666-3475236.gbl, 37666-3475236.gbo, 37666-3475236.gbs, 37666-3475236.gko, 37666-3475236.gtl, 37666-3475236.gto, 37666-3475236.gtp]
2026-03-07 Add device tree overlays (work in progress) for CM4 and CM5 platforms
2026-03-08 Add config.txt files for RPI CM4 and CM5 variant. Subject to frequent change moving forward with bringup
    [config.txt]
2026-03-08 Remove overlays for common folder, move then to CM4 and CM5 folders (device dependent overlays)
2026-03-08 Add overlays in device specific folder
2026-03-08 Adjust device tree overlays based on hardware-dependent interfaces which varies between CM4 and CM5
2026-03-15 Kicked off DVT test report writing Reviewed power supply design notes & completed data for 3V3 and 5V0 rails Reviewed power-up sequence & adjusted timing based on design freeze data
    [RPI_CMx_Carrier - Design Notes - Power Table.ods]
2026-03-15 forgot to save :(
    [RPI_CMx_Carrier - Design Notes - Power Table.ods]
2026-03-17 Update POWER-ON reset test Add datasheets
2026-03-18 Update DVT report with power kill sequence Update power kill sequence diagram and simulation file
2026-03-28 Prepare DVT design notes
    [RPI_CM4_CM5_CarrierBoard_PinMux.ods]
2026-04-04 Update device tree overlays based on actual hardware SGTL5000 I2C mapping based on CM4 and CM5 SGTL5000 I2S mapping based on CM4 and CM5
    Tentative overlay for SN65DSI84
    Update DVT bring-up notes
    [config.txt]
2026-04-04 Add working device tree overlay for SN65DSI84 bridge on CM4
2026-04-05 Add firmware_PIC32 project Add prototype tracker Add upd720202 user manual
    [Prototype Tracker.ods]
2026-04-11 Move Rev1_00-0a project + output files to seperate folder
    [37666-3475236.drl, 37666-3475236.gbl, 37666-3475236.gbo, 37666-3475236.gbs, 37666-3475236.gko, 37666-3475236.gtl, 37666-3475236.gto, 37666-3475236.gtp]
2026-04-11 Add gpio overlay for backlight controller (GPIO 12) prior to completing PWM overlay
    [config.txt]
2026-05-03 Update DVT for power-up sequence Update prototype tracker with bugs and resolutions found
    [Prototype Tracker.ods, RPI_CMx_Carrier - Design Notes - Power Table.ods]
2026-06-19 Progress in DVT, HW bugs and applicable work item tracker Progress in FW driver development Slight adjustment to config.txt and device tree overlays for CM4 and CM5
    [Prototype Tracker.ods, config.txt]
2026-06-22 Update power kill and power up sequence following DVT Add PIC32 powerkill validation with pushbutton
    [Prototype Tracker.ods]
2026-06-23 Start power kill sequence qualification
    [Prototype Tracker.ods]
2026-10-12 Update to DVT & prototype tracker
